embeddedprojects/gnublin-schematics/README.md

gnublin-schematics
==================

GNUBLIN Schematic and Board Files
