embeddedprojects/gnublin-schematics/Board-RAIL/700926_GNUBLIN_DINRAIL_DATENBLATT.pdf

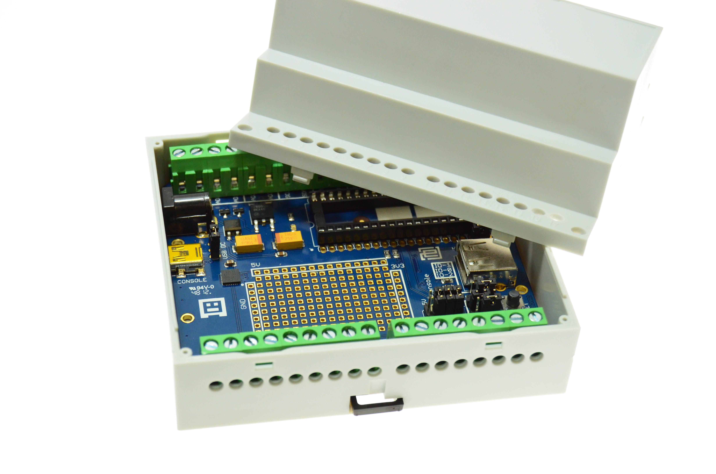
[picture p9: figure]

Software
- keine

## GNUBLIN – DIN RAIL (Hutschienensystem)

Eigenschaften

- Basis für GNUBLIN-DIP
- Hutschienenmontage möglich
- sämtliche Leitungen vom GNUBLIN-DIP herausgeführt
- Optional Stromversorgung per Steckernetzteil (Integrierter 5V Regler)

Technische Details
- 15 x GPIO, 4 x ADW, RESET, UART, PWM, SPI, I2C, 5V, 3V3, GND auf Schraubklemmen
- 1 x LED
- 1 x Power-LED
- Externe 7-12V Stromversorgung über Hohlbuchse möglich
- USB-OTG (Host oder Device)
1/2 | Version: 100 Stand: | 25.07.12

Holzbachstraße 4, D-86152 Augsburg Tel +49 (0) 821 279599-0
Fax +49 (0) 821 279599-20
shop.embedded-projects.net

# embedded projects GmbH

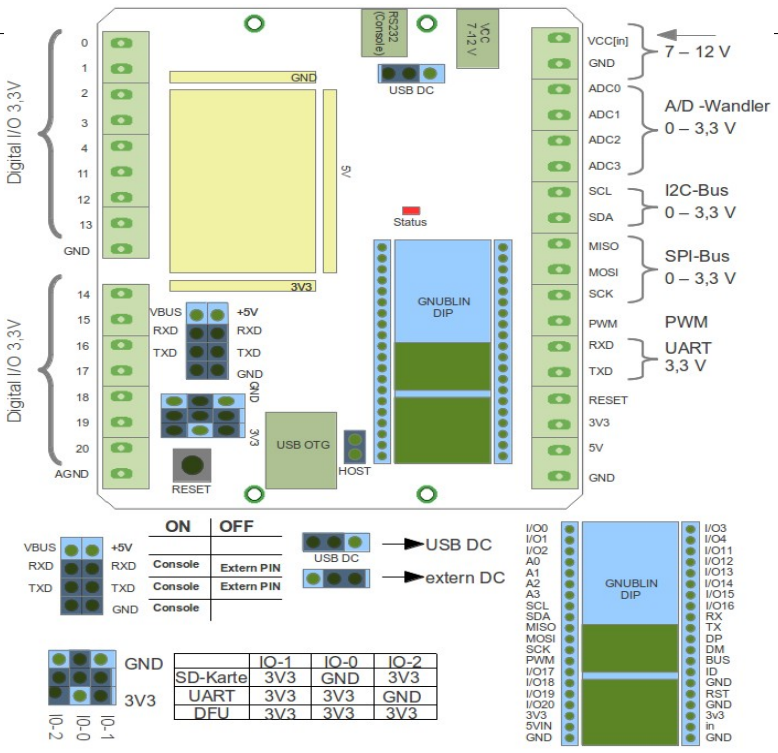
[picture p10: figure]

2/2 | Version: 100 Stand: | 25.07.12

Holzbachstraße 4, D-86152 Augsburg Tel +49 (0) 821 279599-0
Fax +49 (0) 821 279599-20
shop.embedded-projects.net

Abbildung 1: Übersicht Unterbauboard

Mechanische Daten
- Abmessung Platine 84.00 x 98,50 mm
- Gewicht ca. 50 g
Lieferumfang Artikel Nr. 700xx
- Platine vormontiert und getestet
- Alle Anschlussklemmen
- 1 x Mini-USB-Kabel
Optional Zubehör
- Hutschienengehäuse 6-C und Zubehör wie bei Artikel Nr. 700505

Anfrage / Kontakt
embedded projects GmbH
Holzbachstraße 4
86152 Augsburg

Tel: 0821 / 27 95 99-0
Fax: 0821 / 27 95 99-20
E-Mail: info@embedded-projects.net Internet: http://www.embedded-projects.net

Irrtümer, Verfügbarkeit des beschriebenen Artikels und technische Änderungen/Anpassungen vorbehalten.
