embeddedprojects/gnublin-schematics/Module-Bridge/MODUL_BRIDGE_V100.pdf

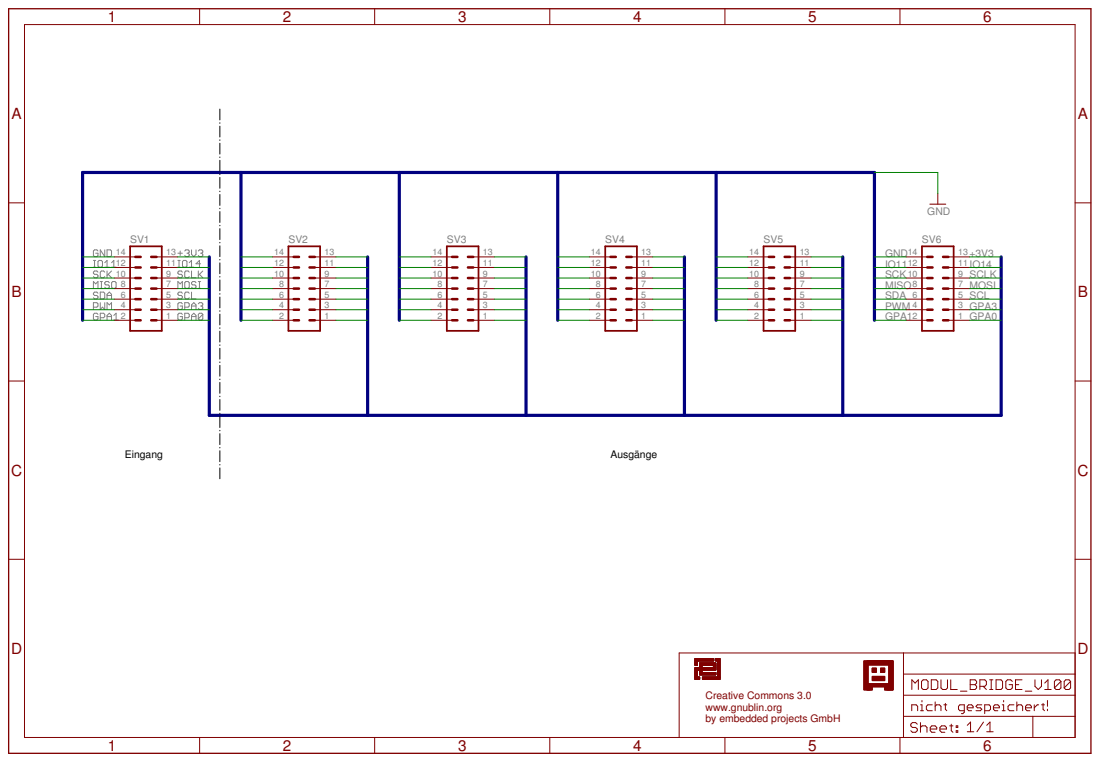
[picture p20: page 1]

IO11 12 | 11
SCK | 9 SCLK

10 MISO 8 | GPA0 7 MOSI

SDA 6 | 5 SCL
PWM 4 | 3 GPA3
GPA1 2 | 1

Creative Commons 3.0 www.gnublin.org
by embedded projects GmbH
