embeddedprojects/gnublin-schematics/Module-Relay/MODUL_RELAIS_8_V101.pdf

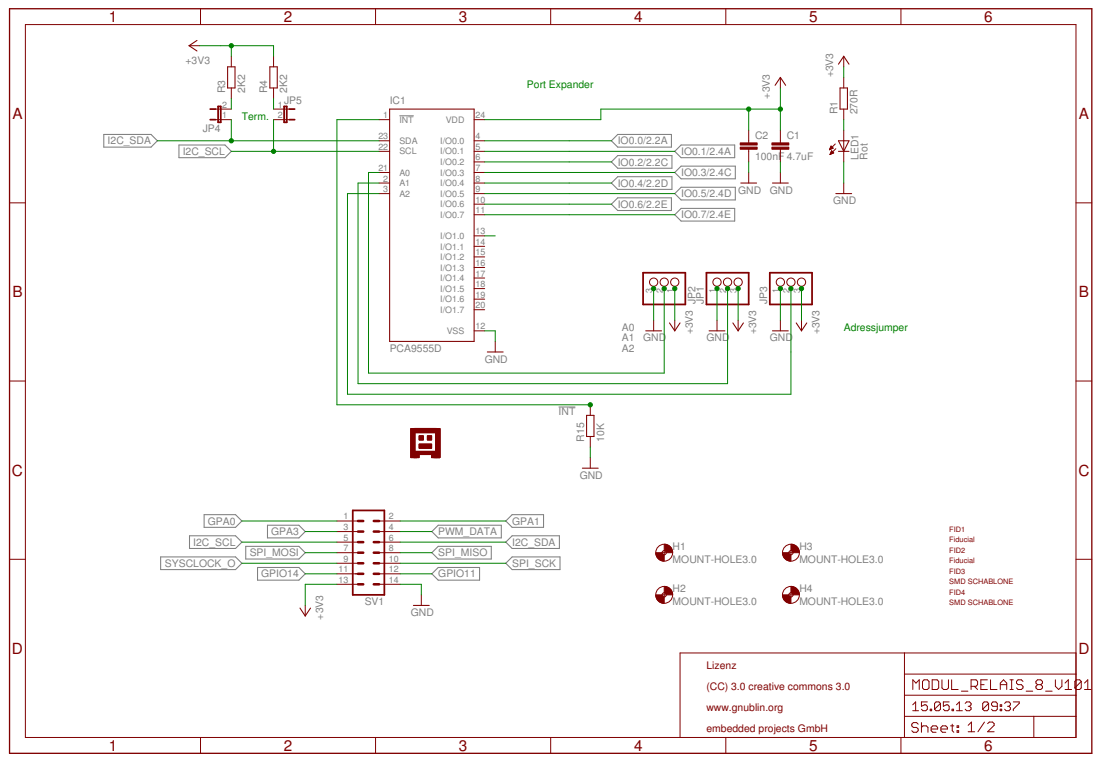
[picture p21: page 1]

Fiducial FID1 Fiducial FID2 SMD SCHABLONE

Lizenz www.gnublin.org
(CC) 3.0 creative commons 3.0

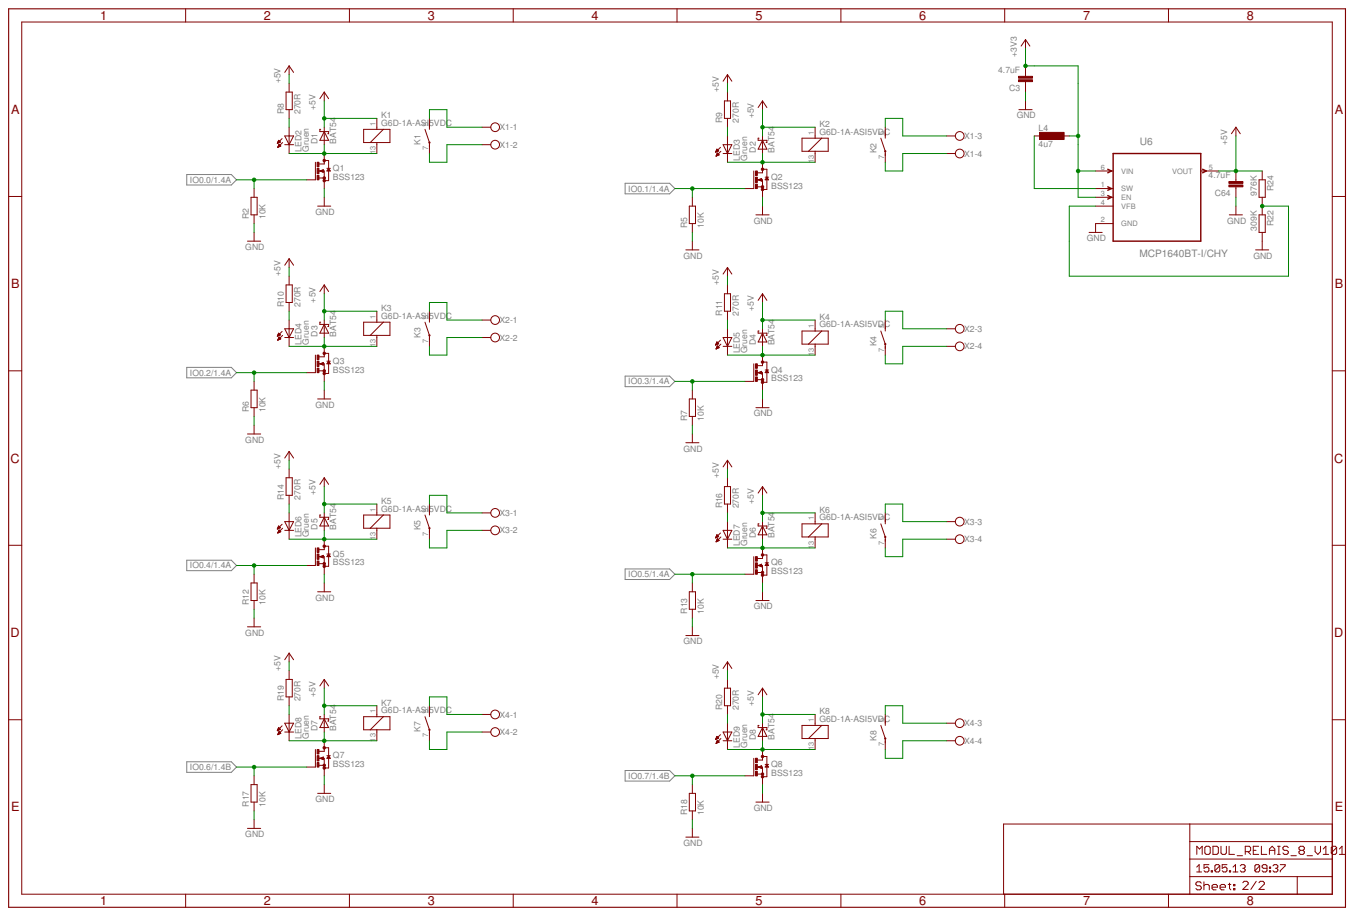
[picture p22: page 2]

BAT54 BSS123 BAT54 BSS123 G6D-1A-ASI5VDC G6D-1A-ASI5VDC 10K 10K Gruen Gruen 270R 270R GND GND GND GND BAT54 BSS123 BAT54 BSS123 G6D-1A-ASI5VDC G6D-1A-ASI5VDC 10K 10K Gruen Gruen 270R 270R GND GND GND GND BAT54 BSS123 BAT54 BSS123 G6D-1A-ASI5VDC G6D-1A-ASI5VDC 10K 10K Gruen Gruen 270R 270R GND GND GND GND BAT54 BSS123 BAT54 BSS123 G6D-1A-ASI5VDC G6D-1A-ASI5VDC 10K 10K Gruen Gruen 270R 270R GND GND GND GND MCP1640BT-I/CHY 4u7 976K 309K GND GND 4.7uFGND GND +3V3 +5V +5V +5V +5V +5V +5V +5V +5V +5V +5V +5V +5V +5V +5V +5V +5V +5V 4.7uF D2 Q2 D1 Q1 K1 1 13K1 7 5K2 1 13K2 7 5 R2 R5 LED2 LED3 R8 R9 X1-1 X1-2 X1-3 X1-4 D4 Q4 D3 Q3 K3 1 13K3 7 5K4 1 13K4 7 5 R6 R7 LED4 LED5 R10 R11 X2-1 X2-2 X2-3 X2-4 D6 Q6 D5 Q5 K5 1 13K5 7 5K6 1 13K6 7 5 R12 R13 LED6 LED7 R14 R16 X3-1 X3-2 X3-3 X3-4 D8 Q8 D7 Q7 K7 1 13K7 7 5K8 1 13K8 7 5 R17 R18 LED8 LED9 R19 R20 X4-1 X4-2 X4-3 X4-4 U6 VIN 6 SW 1 EN 3 VFB 4 GND 2 VOUT 5 L4 R24 R22 C64 C3 IO0.6/1.4B IO0.7/1.4B IO0.0/1.4A IO0.1/1.4A IO0.2/1.4A IO0.3/1.4A IO0.4/1.4A IO0.5/1.4A ABCDE 1 2 3 4 5 6 7 8 ABCDE 1 2 3 4 5 6 7 8
