embeddedprojects/gnublin-schematics/Module_RAIL_INPUT_24V/MODUL_RAIL_IN_V100.pdf

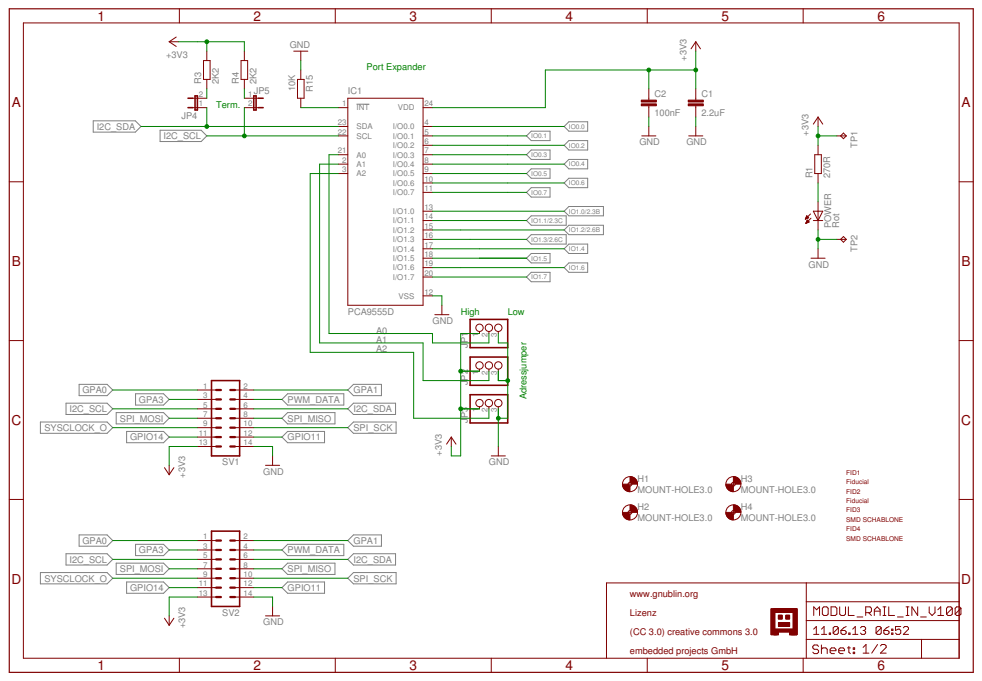
[picture p23: page 1]

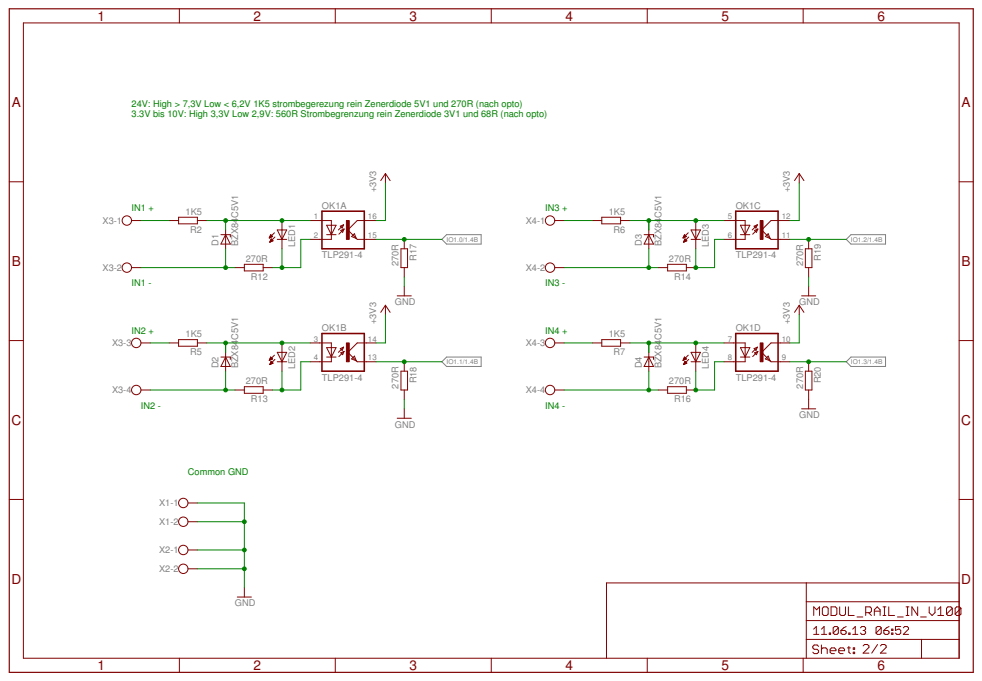
[picture p24: page 2]

24V: High > 7,3V Low < 6,2V 1K5 strombegerezung rein Zenerdiode 5V1 und 270R (nach opto)
3.3V bis 10V: High 3,3V Low 2,9V: 560R Strombegrenzung rein Zenerdiode 3V1 und 68R (nach opto)
