embeddedprojects/gnublin-schematics/Module-Display_2x16/700899_GNUBLIN_DISPLAY_SCHEMATIC_V100.pdf

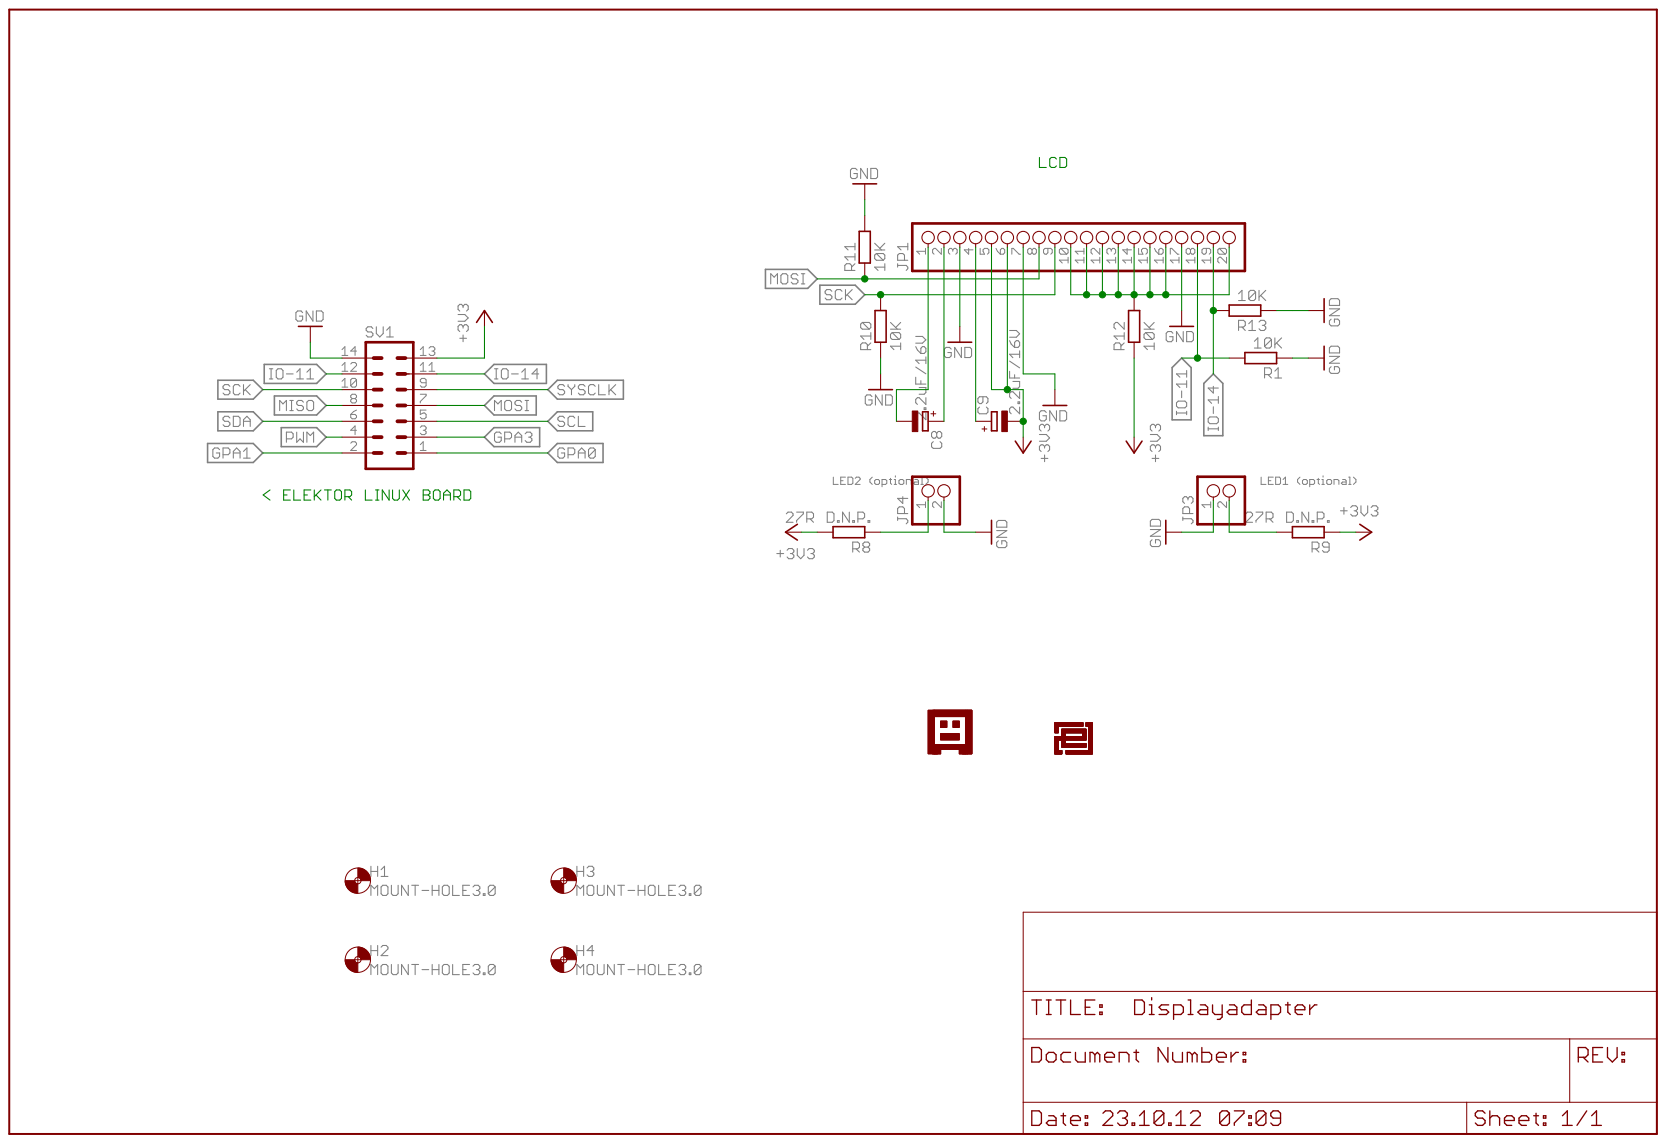
[picture p25: page 1]
