embeddedprojects/gnublin-schematics/Module-Step/MODUL_STEP_V100.pdf

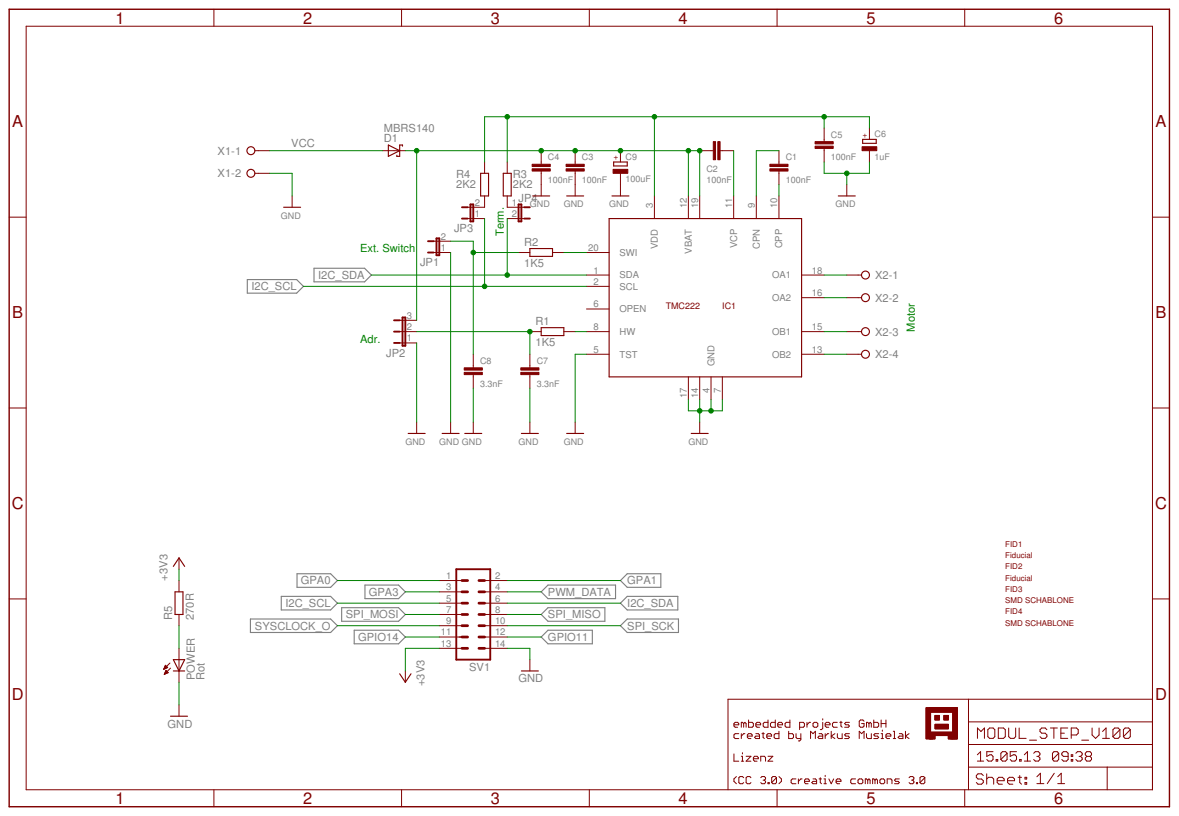
[picture p26: page 1]

Fiducial FID1 Fiducial FID2 SMD SCHABLONE
