embeddedprojects/gnublin-schematics/Board-Easy-DIP/GNUBLIN-DIP-EASY_V100.pdf

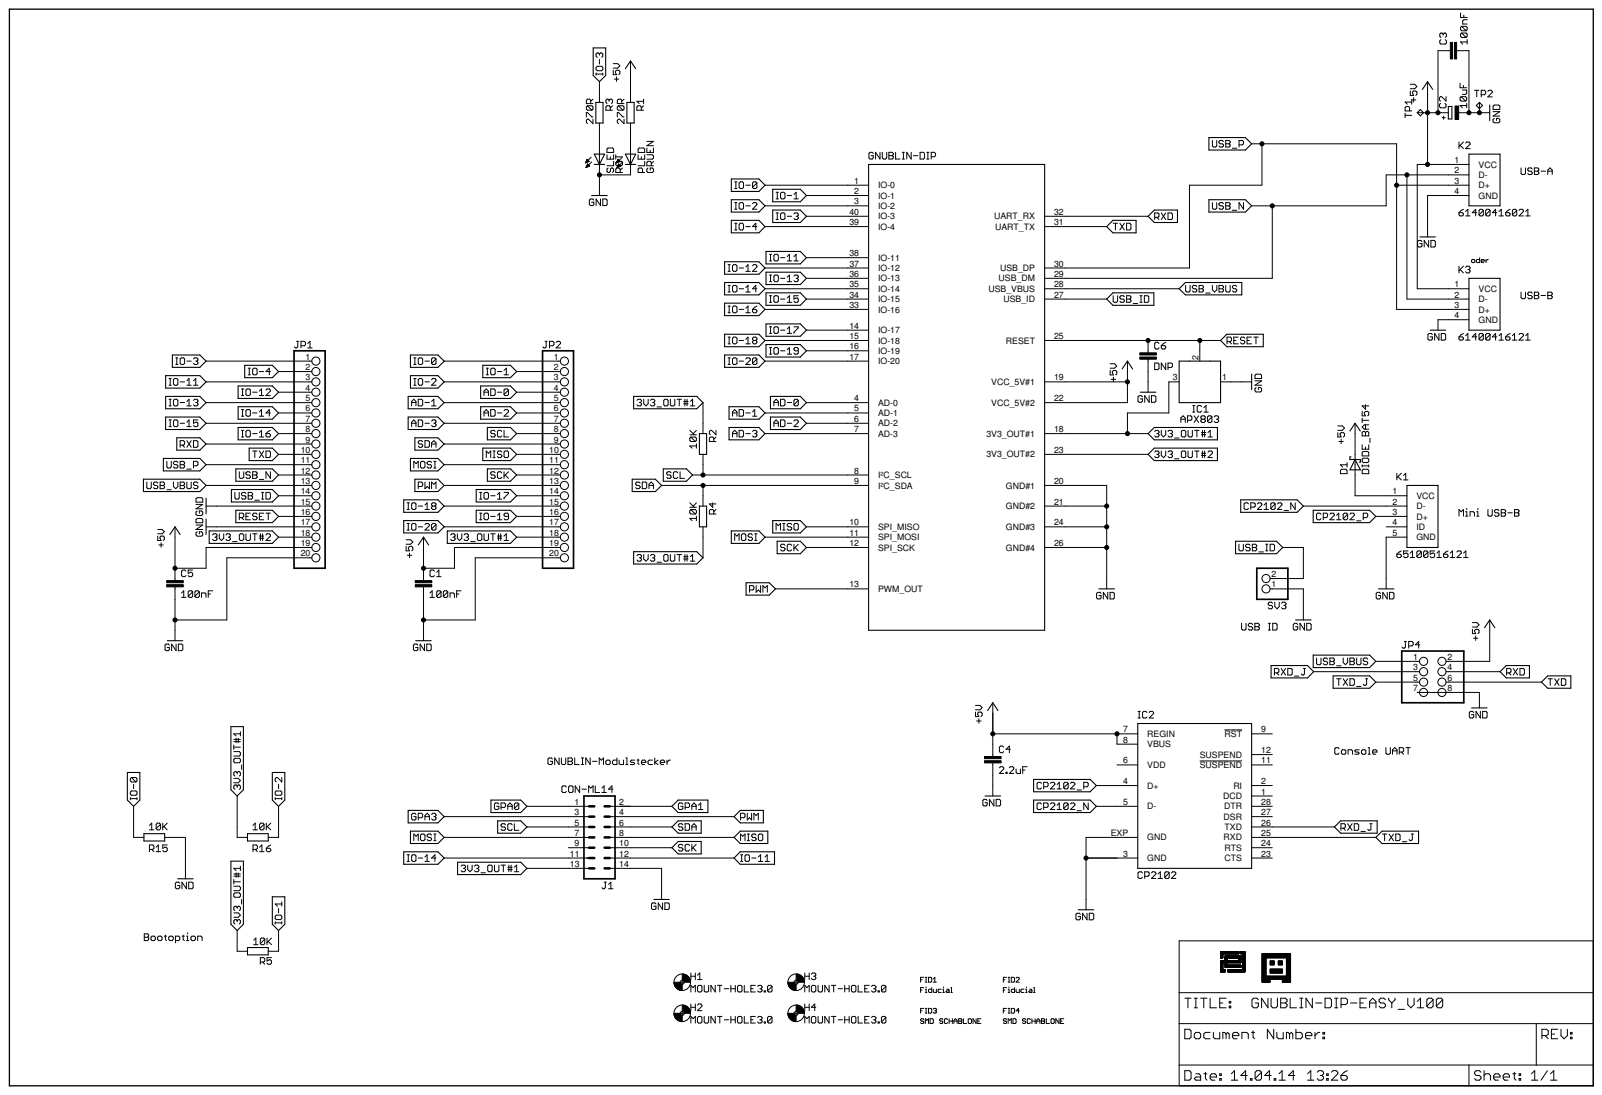
[picture p27: page 1]
