embeddedprojects/gnublin-schematics/DIN-Rail-In/DIN-Rail-In_V103.pdf

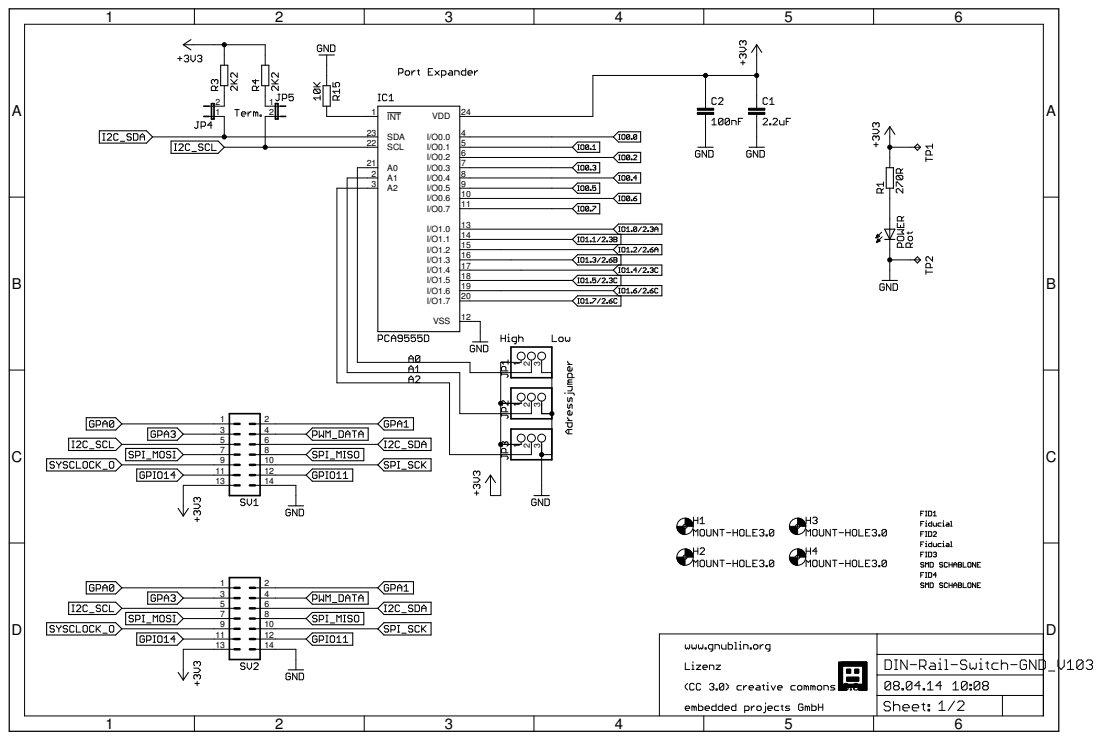
[picture p28: page 1]

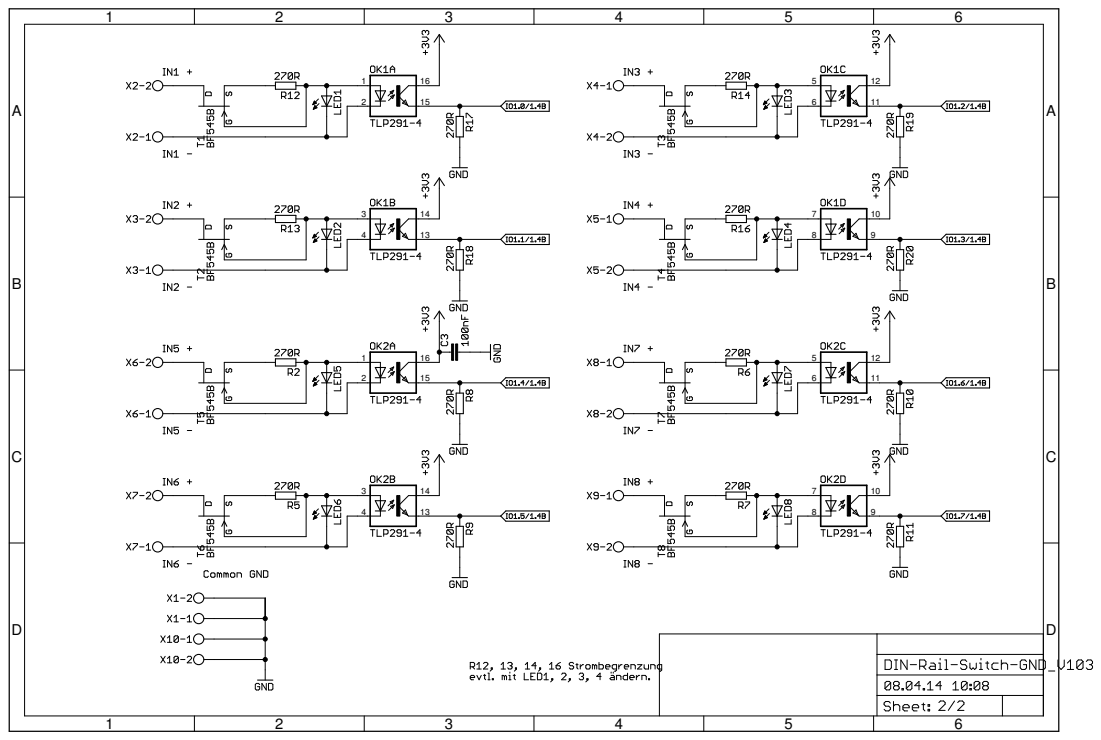
[picture p29: page 2]
