embeddedprojects/gnublin-schematics/Board-DEFAULT/700641_GNUBLIN_ABMESSUNGEN.pdf

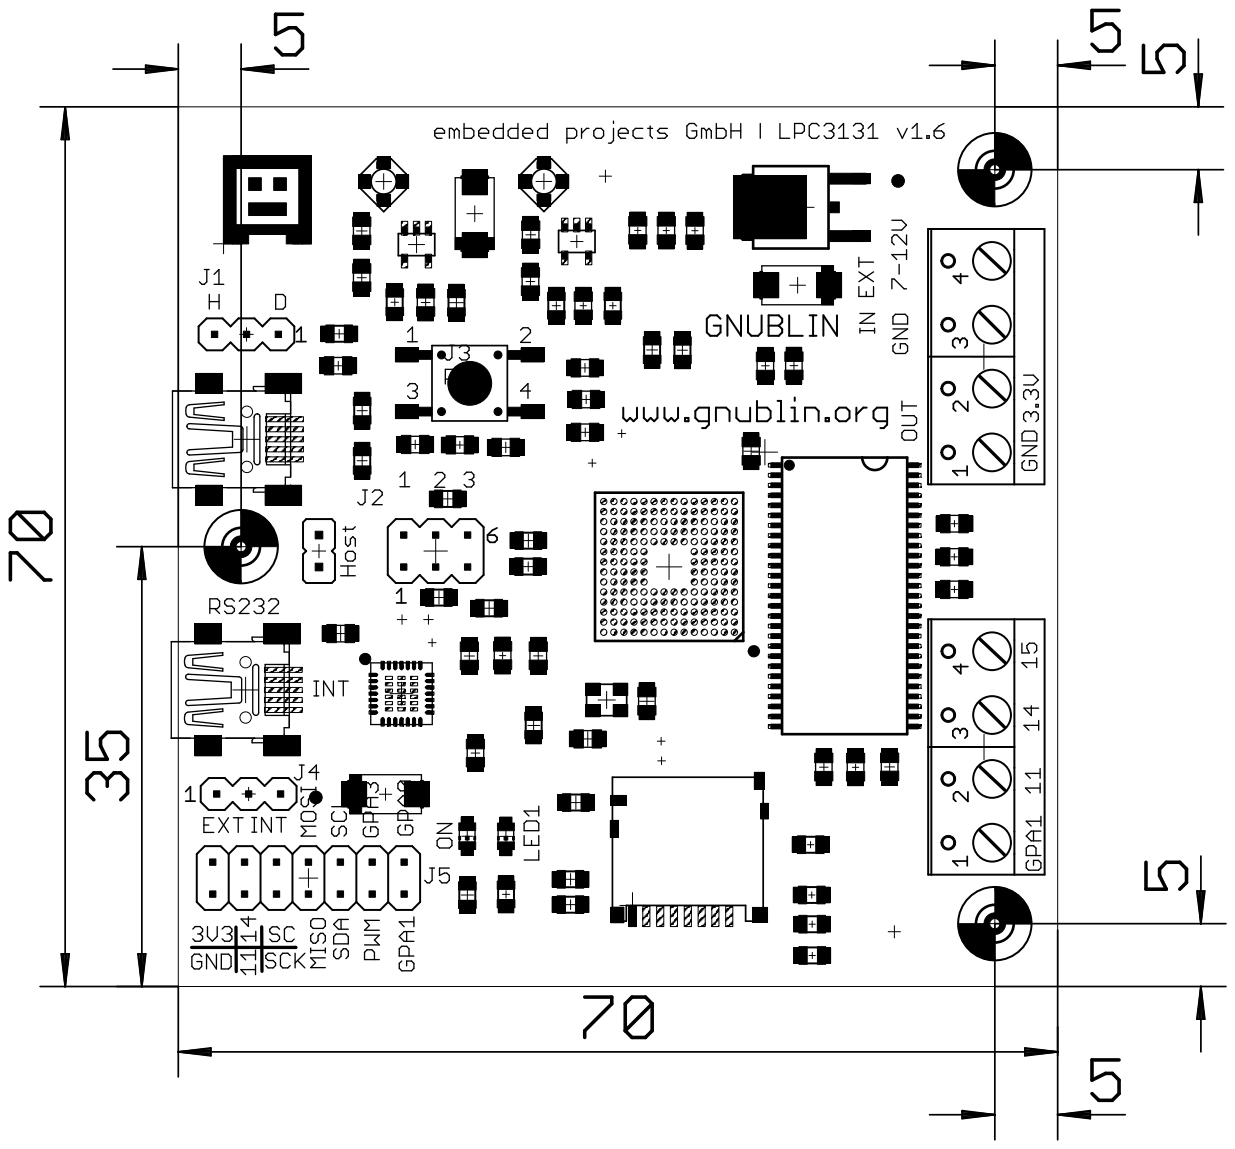
[picture p30: page 1]
