embeddedprojects/gnublin-schematics/Board-DEFAULT/700641_GNUBLIN_SCHALTPLAN.pdf

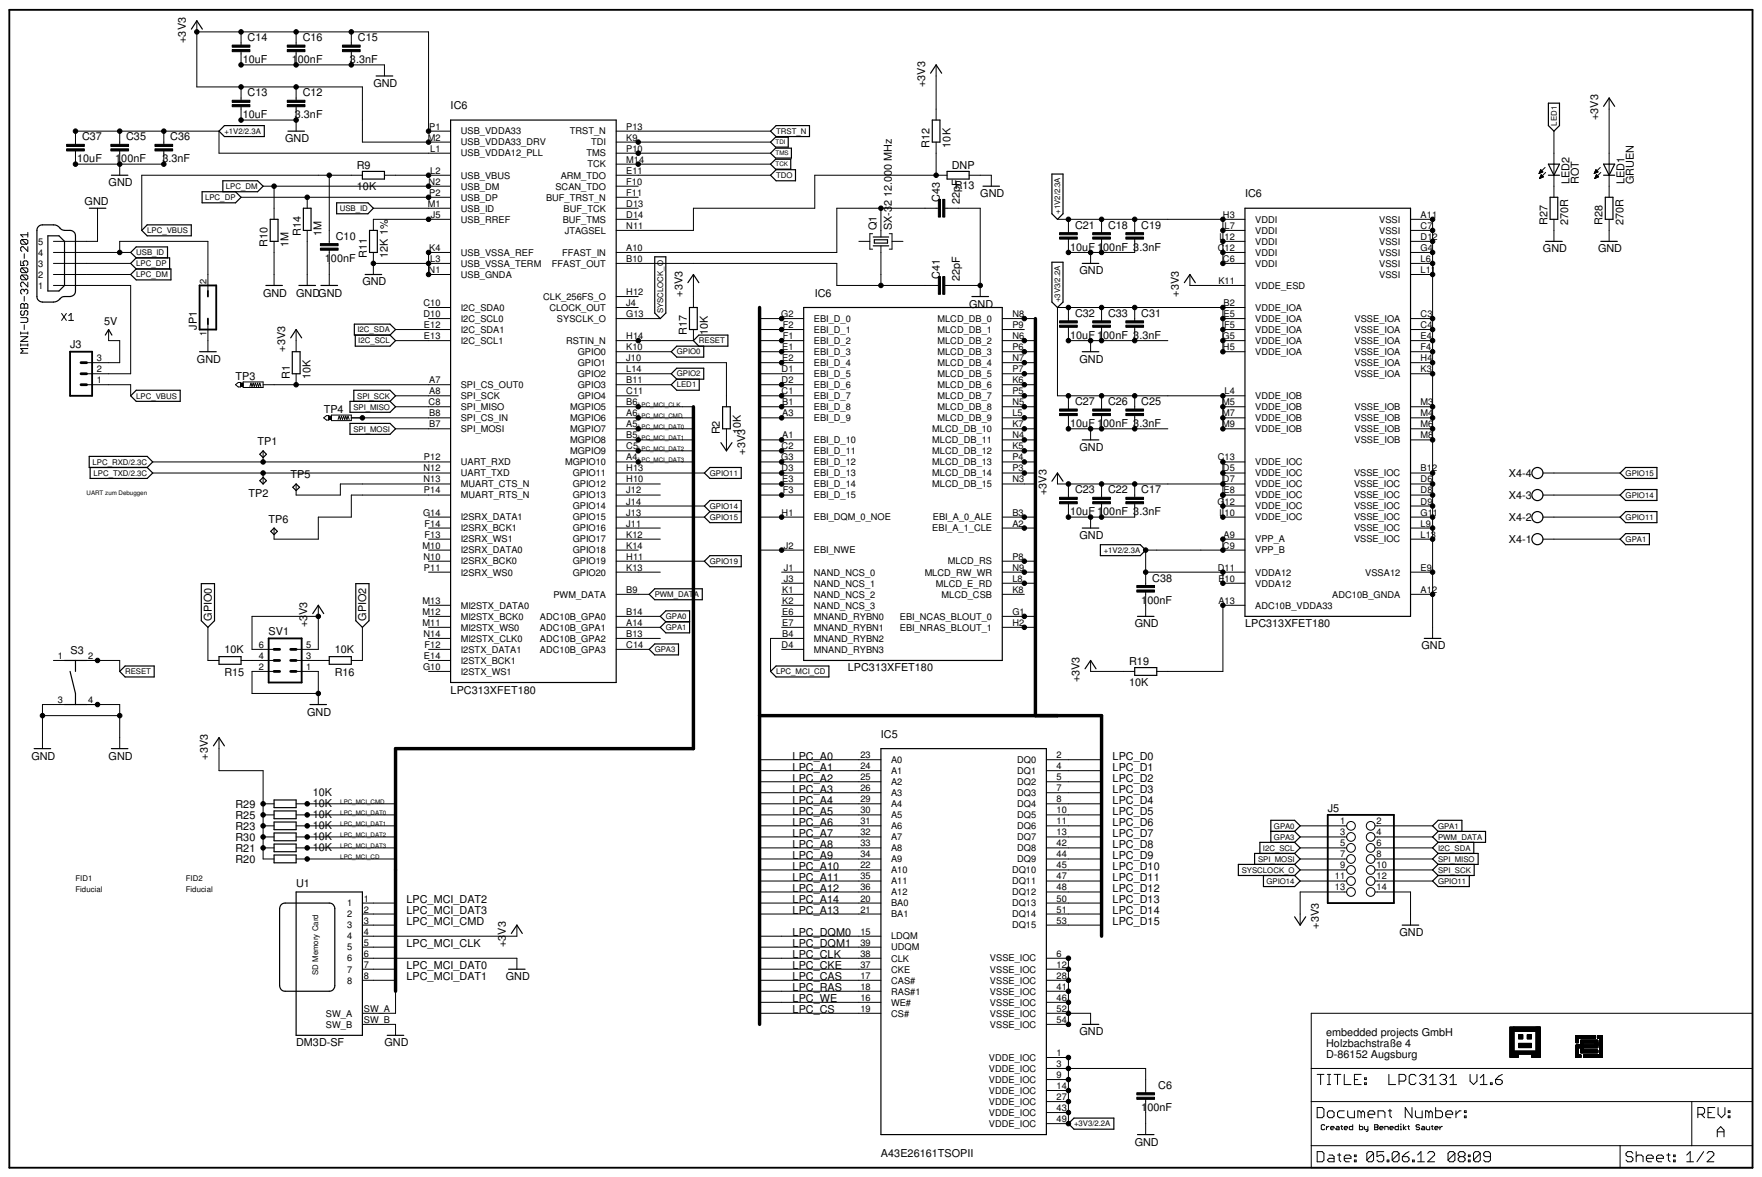
[picture p31: page 1]

SPI_MISO | L14 GPIO3 B11 GPIO4 C11 GPIO11 H13 GPIO12 H10 GPIO13 LPC_MCI_CMD

I2STX_DATA1 F12 | GPA3

SW_A | LPC_RAS | 41 VSSE_IOC

LPC_WE 16 | 46 VSSE_IOC
LPC_CS 19 | 52 VSSE_IOC

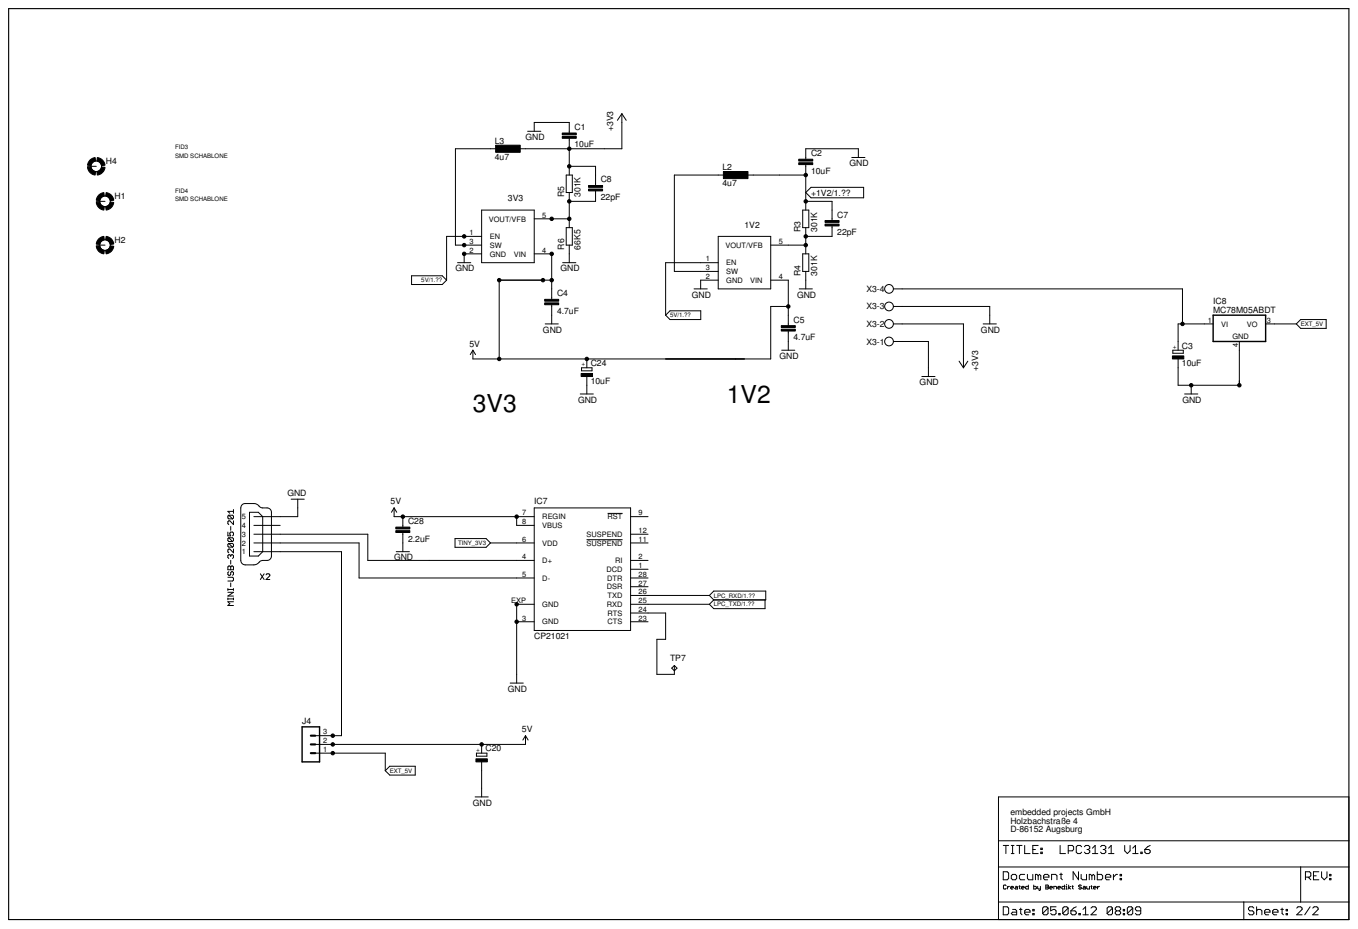
[picture p32: page 2]
