embeddedprojects/gnublin-schematics/Board-DIP/700725_GNUBLIN_DIP_Schaltplan.pdf

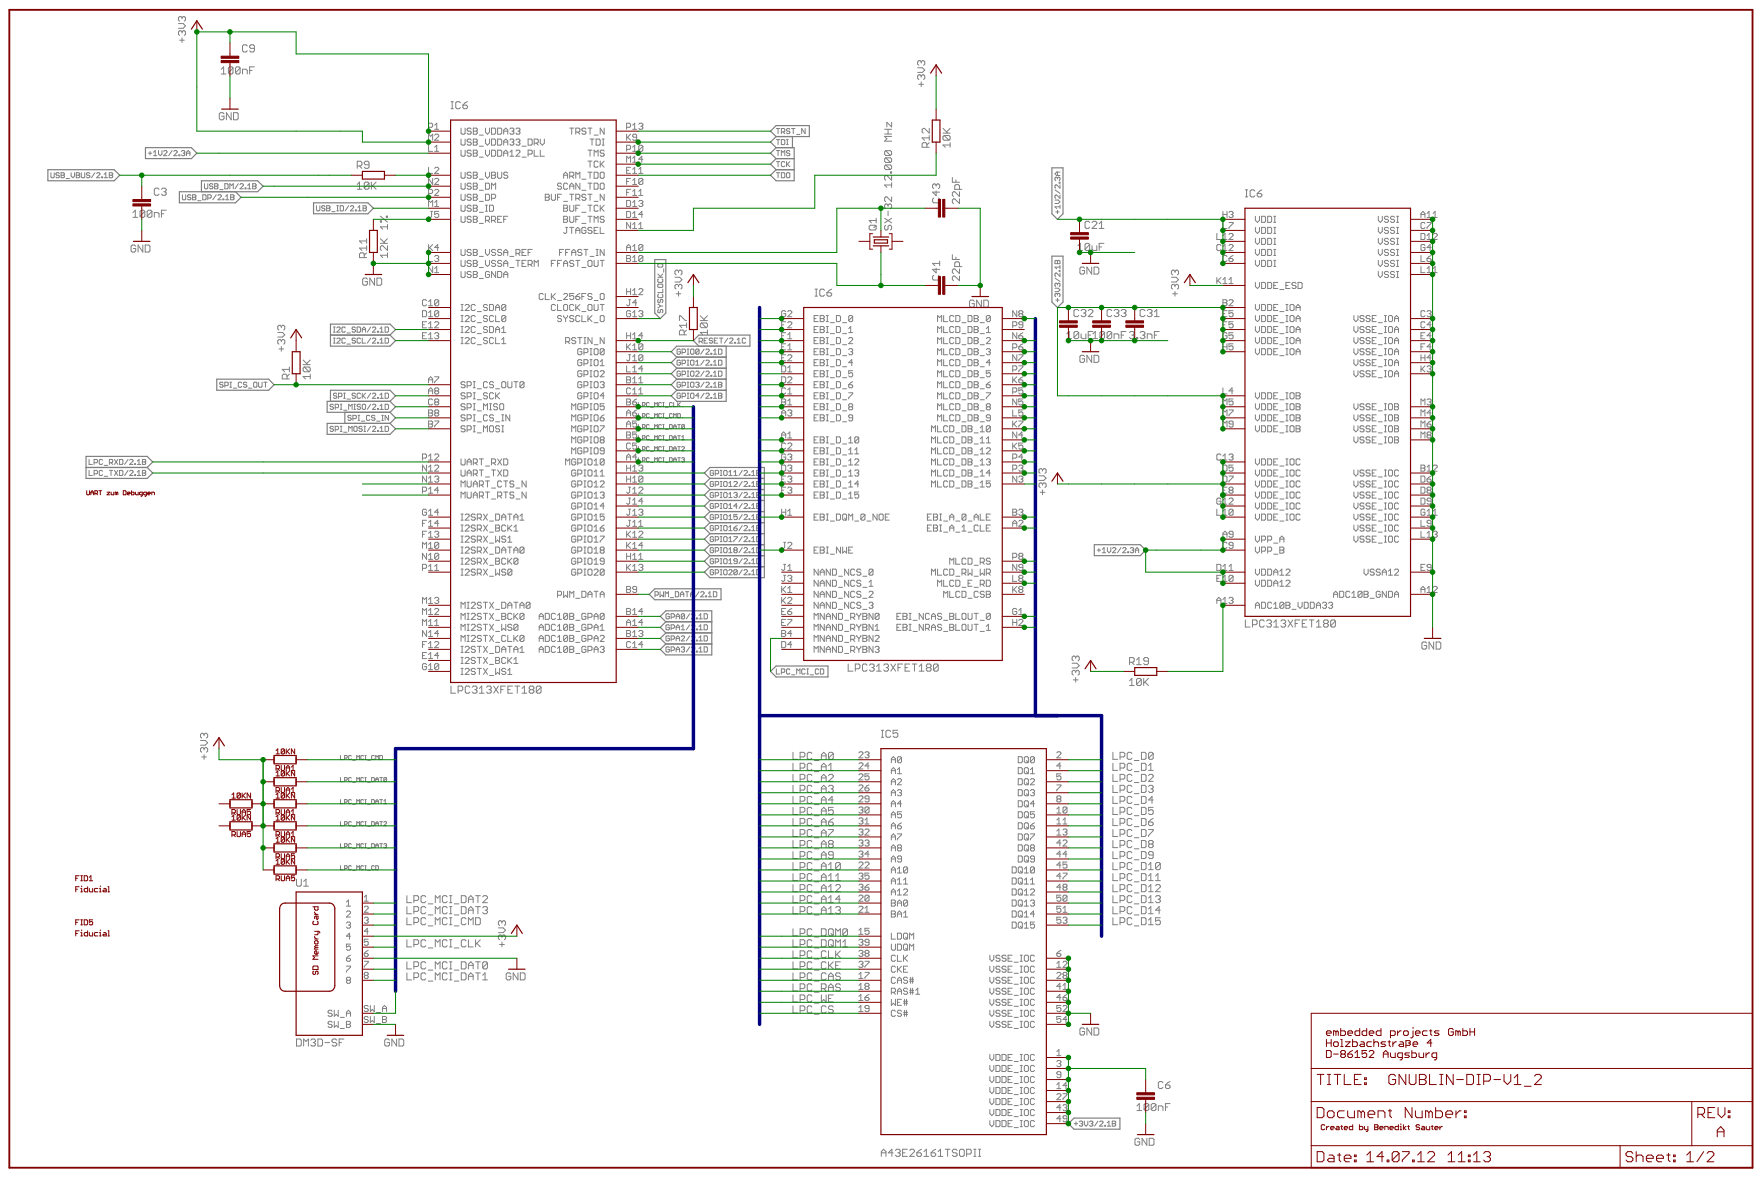
[picture p35: page 1]

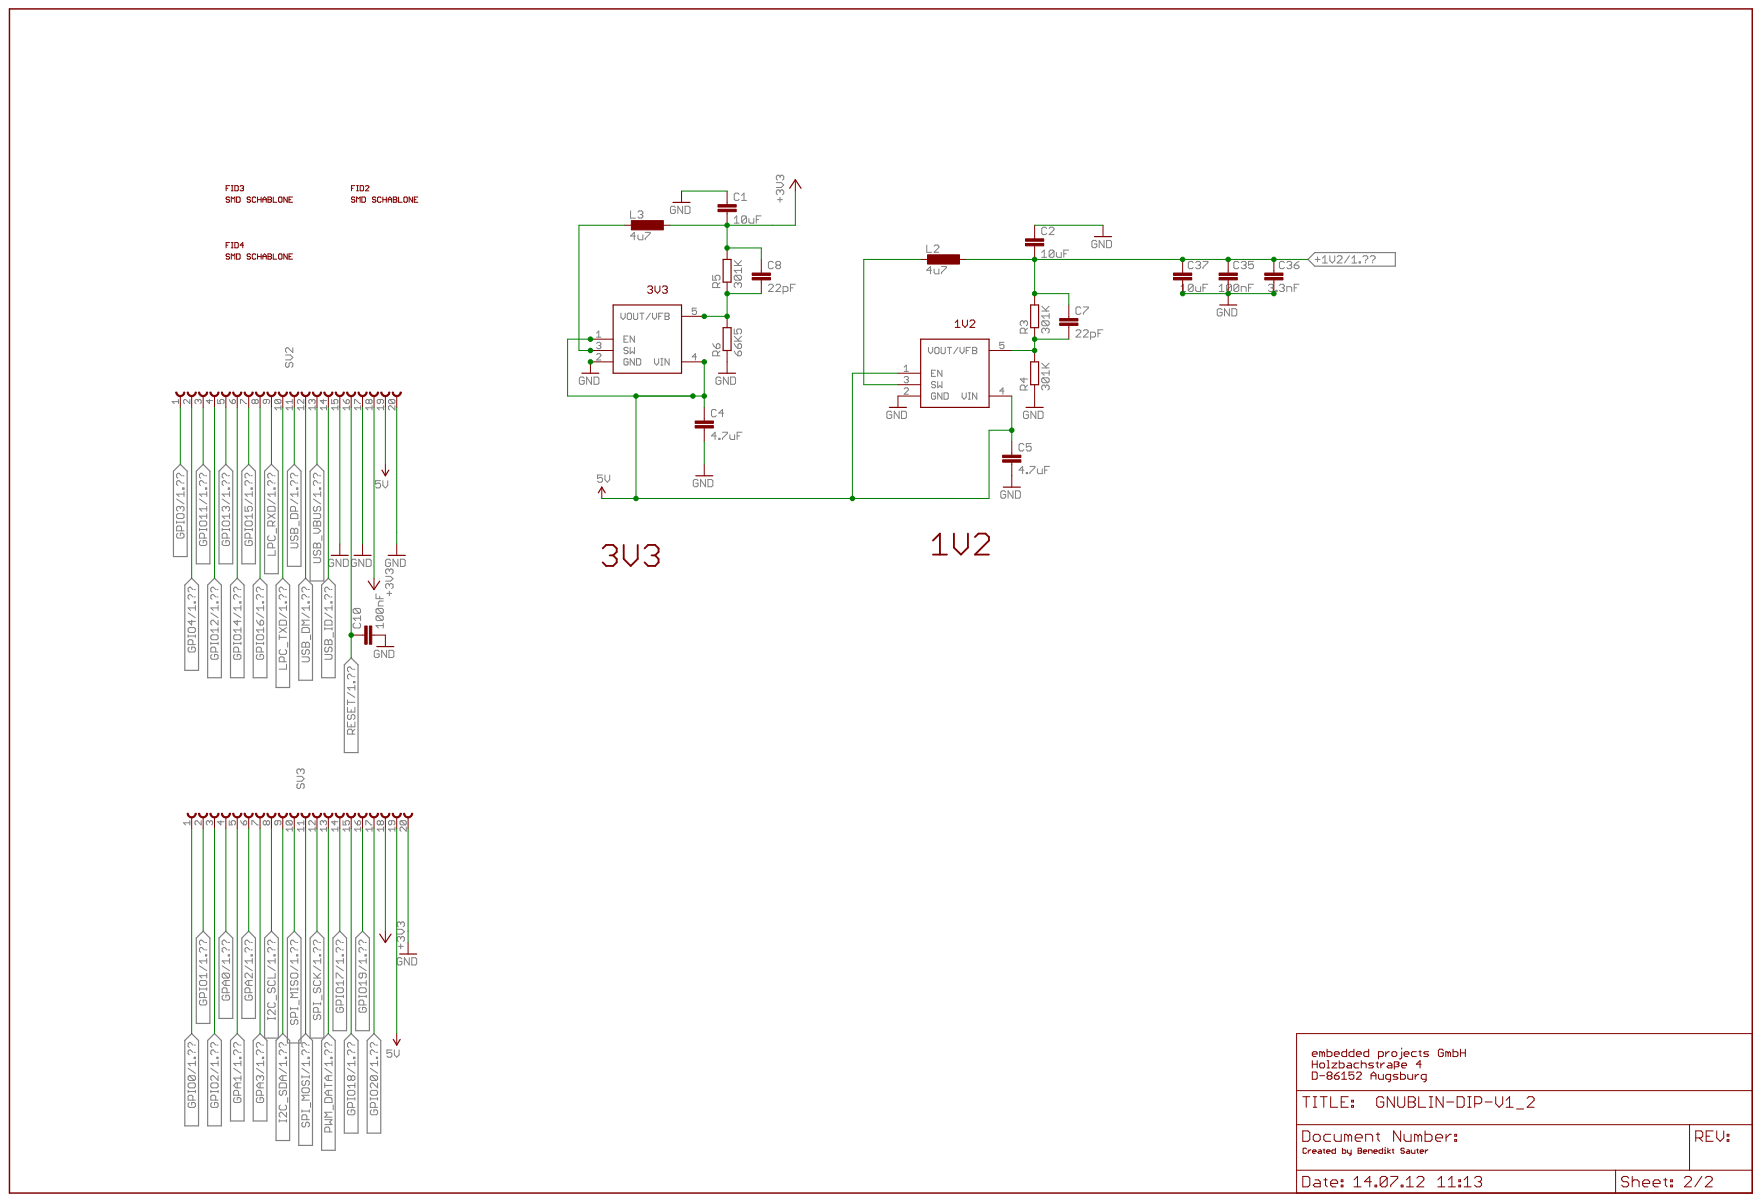
[picture p36: page 2]
