embeddedprojects/gnublin-schematics/Board-Elektor/ElektorLinuxBoard_V3.01.pdf

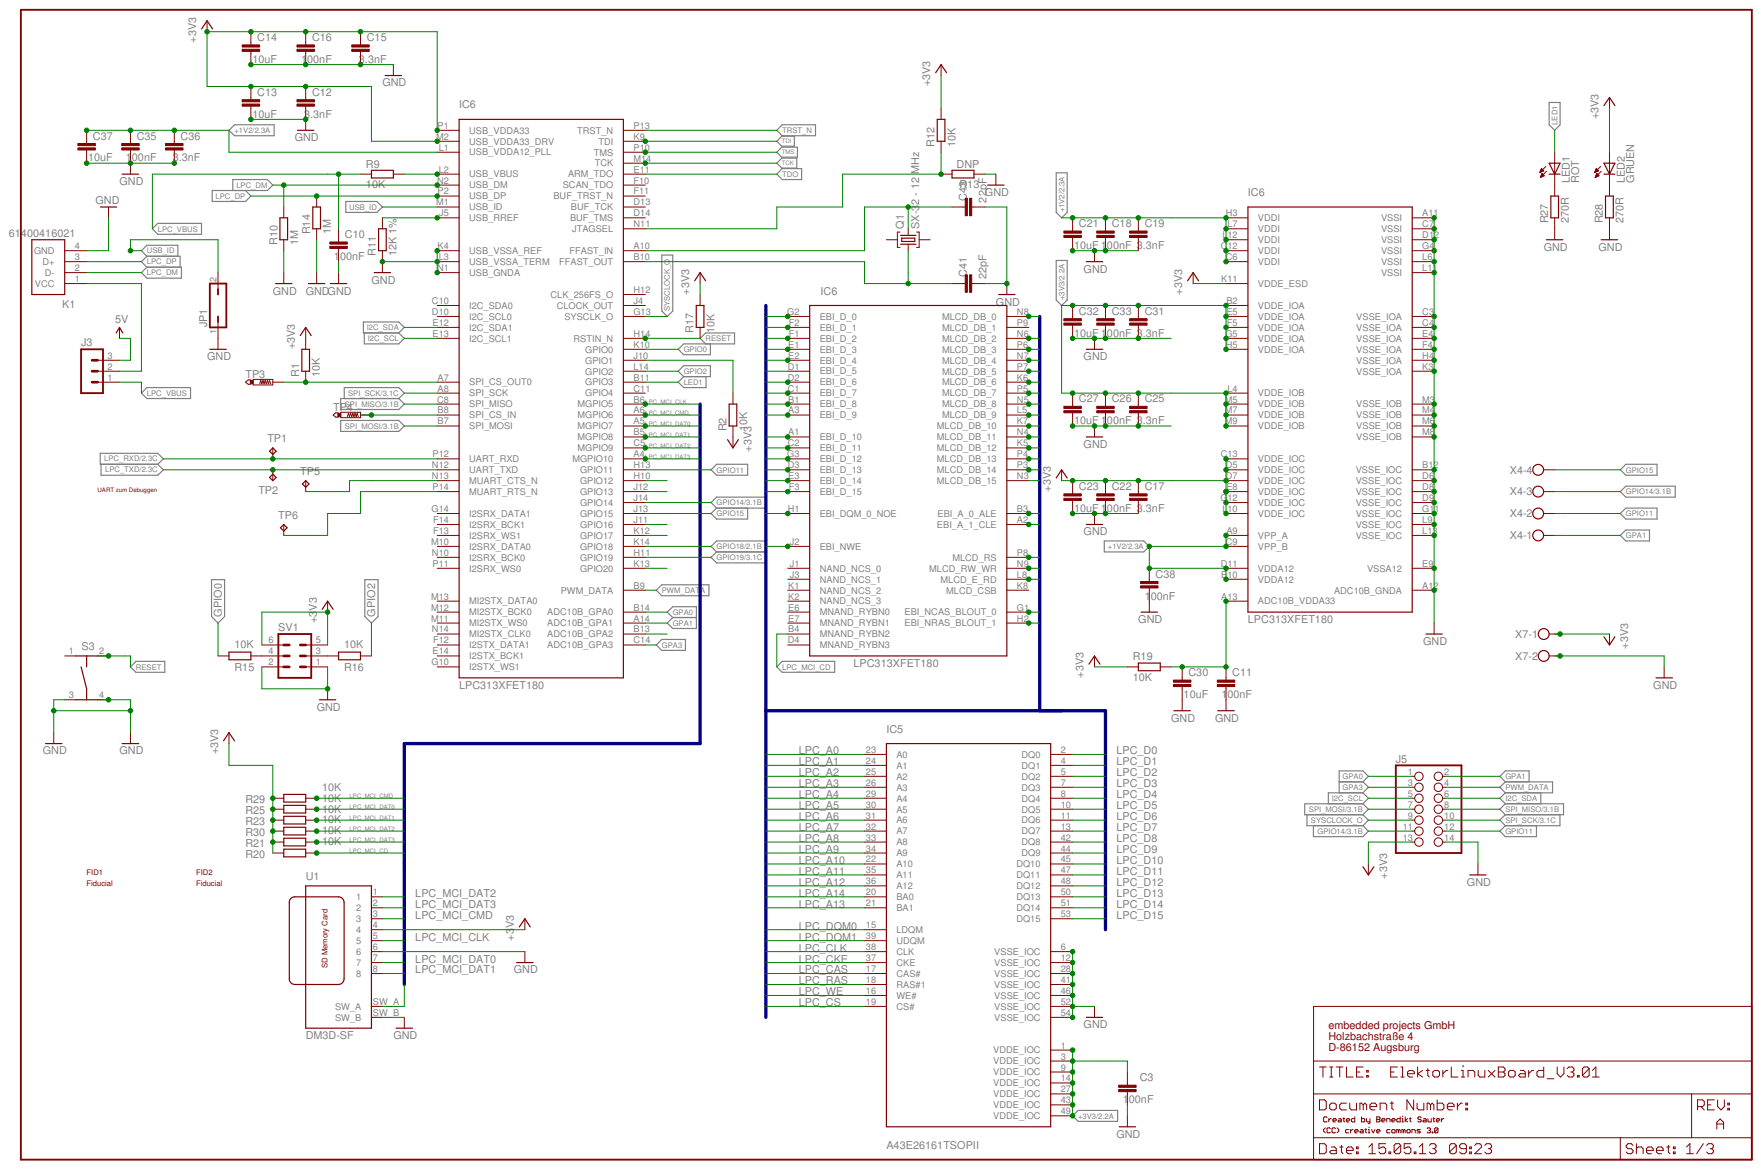
[picture p37: page 1]

I2STX_DATA1 F12 | GPA3

SW_A | LPC_RAS | 41 VSSE_IOC

LPC_WE 16 | 46 VSSE_IOC
LPC_CS 19 | 52 VSSE_IOC

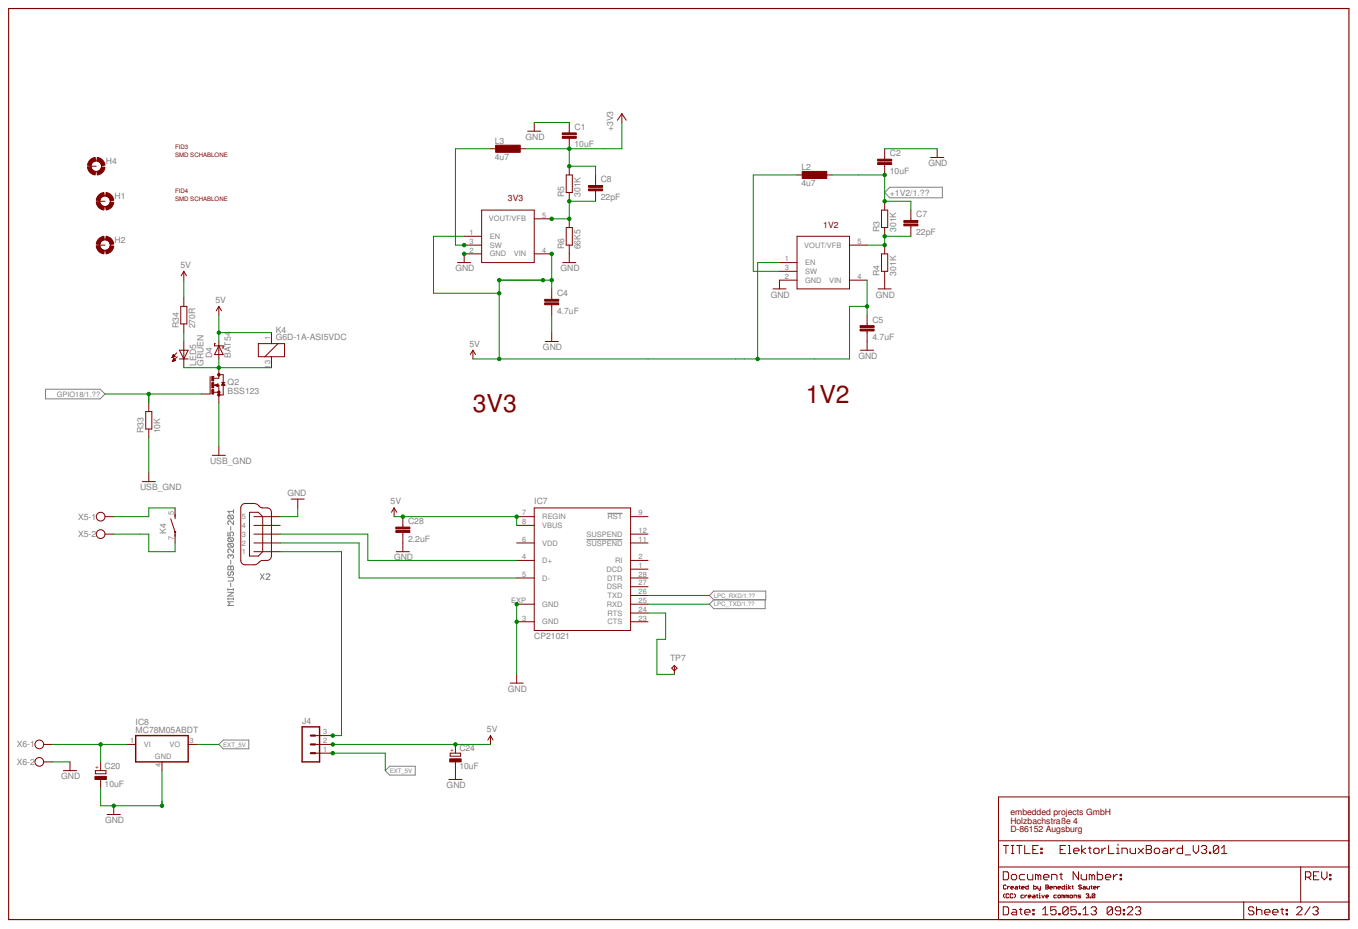
[picture p38: page 2]

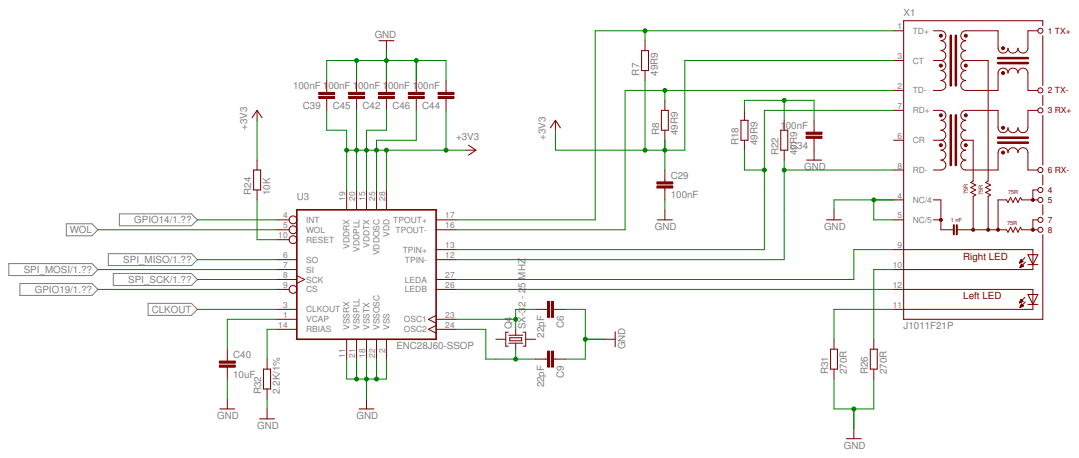
[picture p39: page 3]
