embeddedprojects/gnublin-schematics/Board-LAN/GNUBLIN_LAN_V2.3.pdf

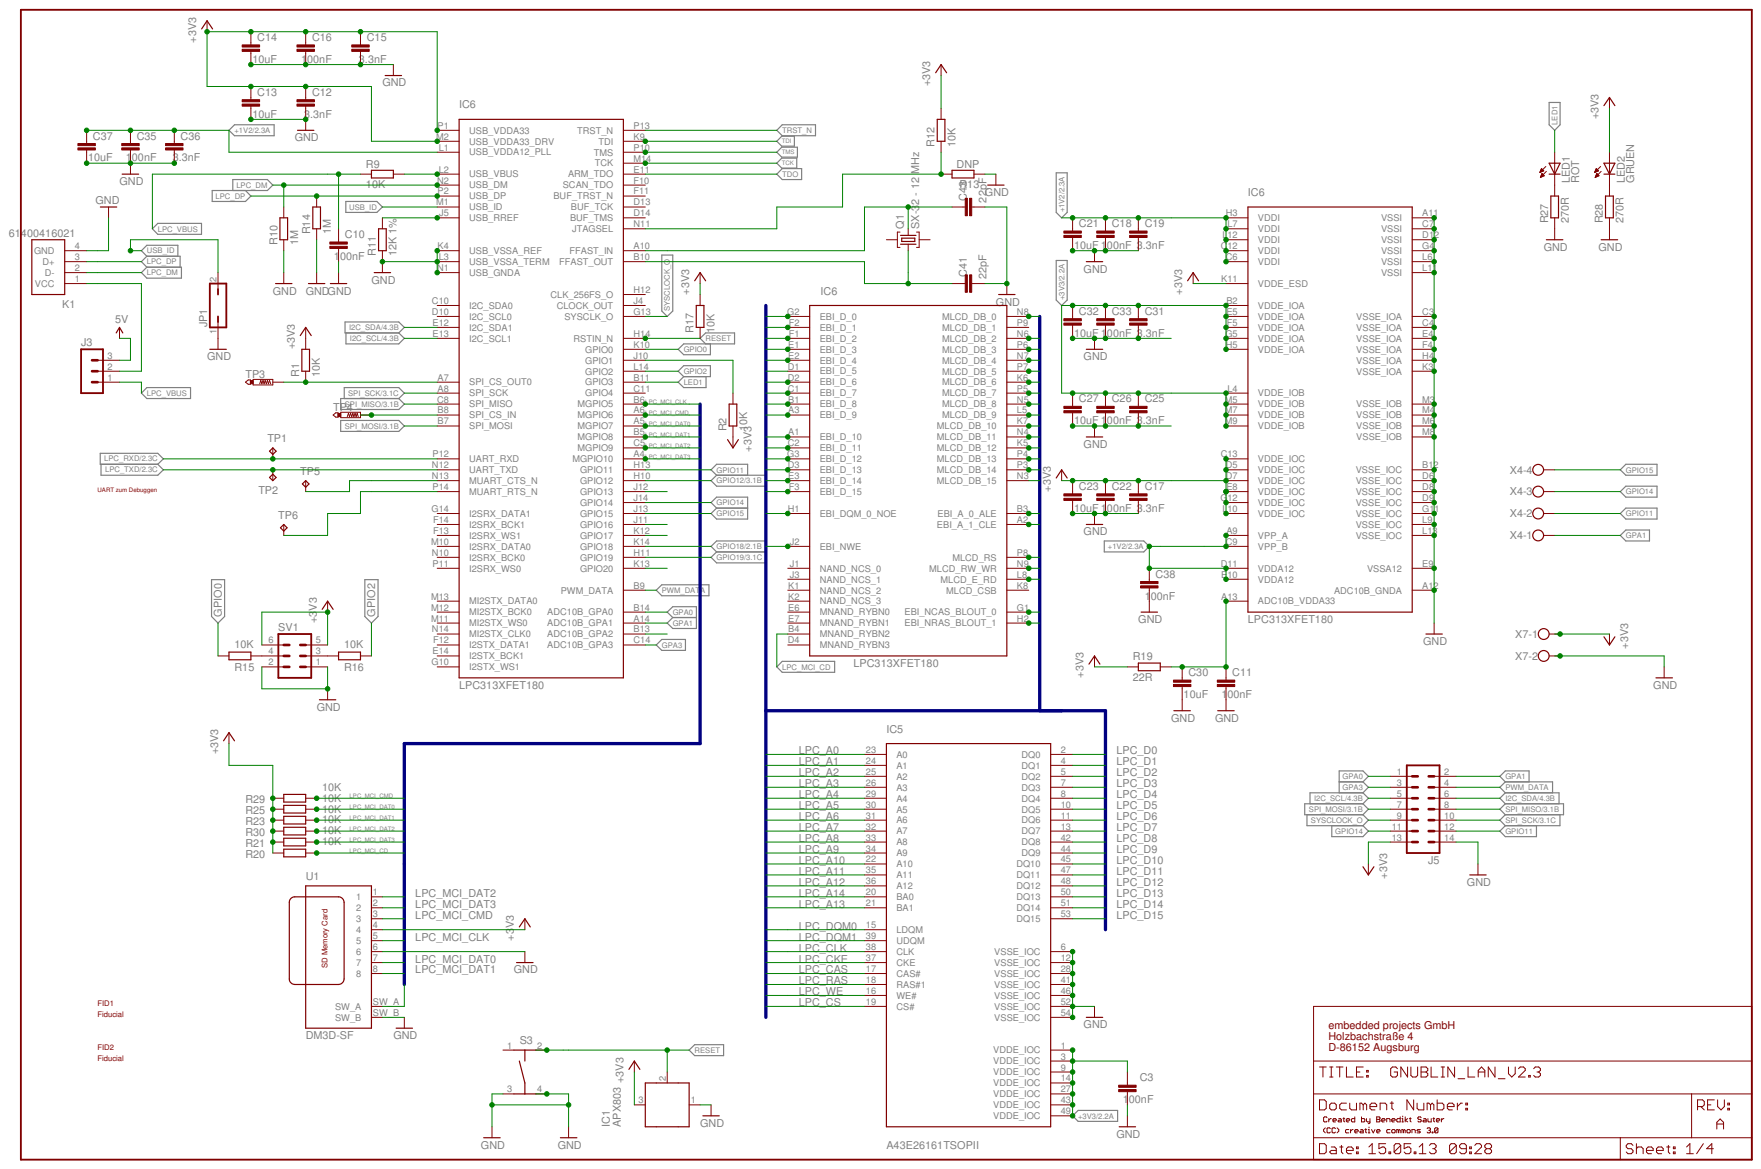
[picture p40: page 1]

I2STX_DATA1 F12 | GPA3

SW_A | LPC_RAS | 41 VSSE_IOC

LPC_WE 16 | 46 VSSE_IOC
LPC_CS 19 | 52 VSSE_IOC

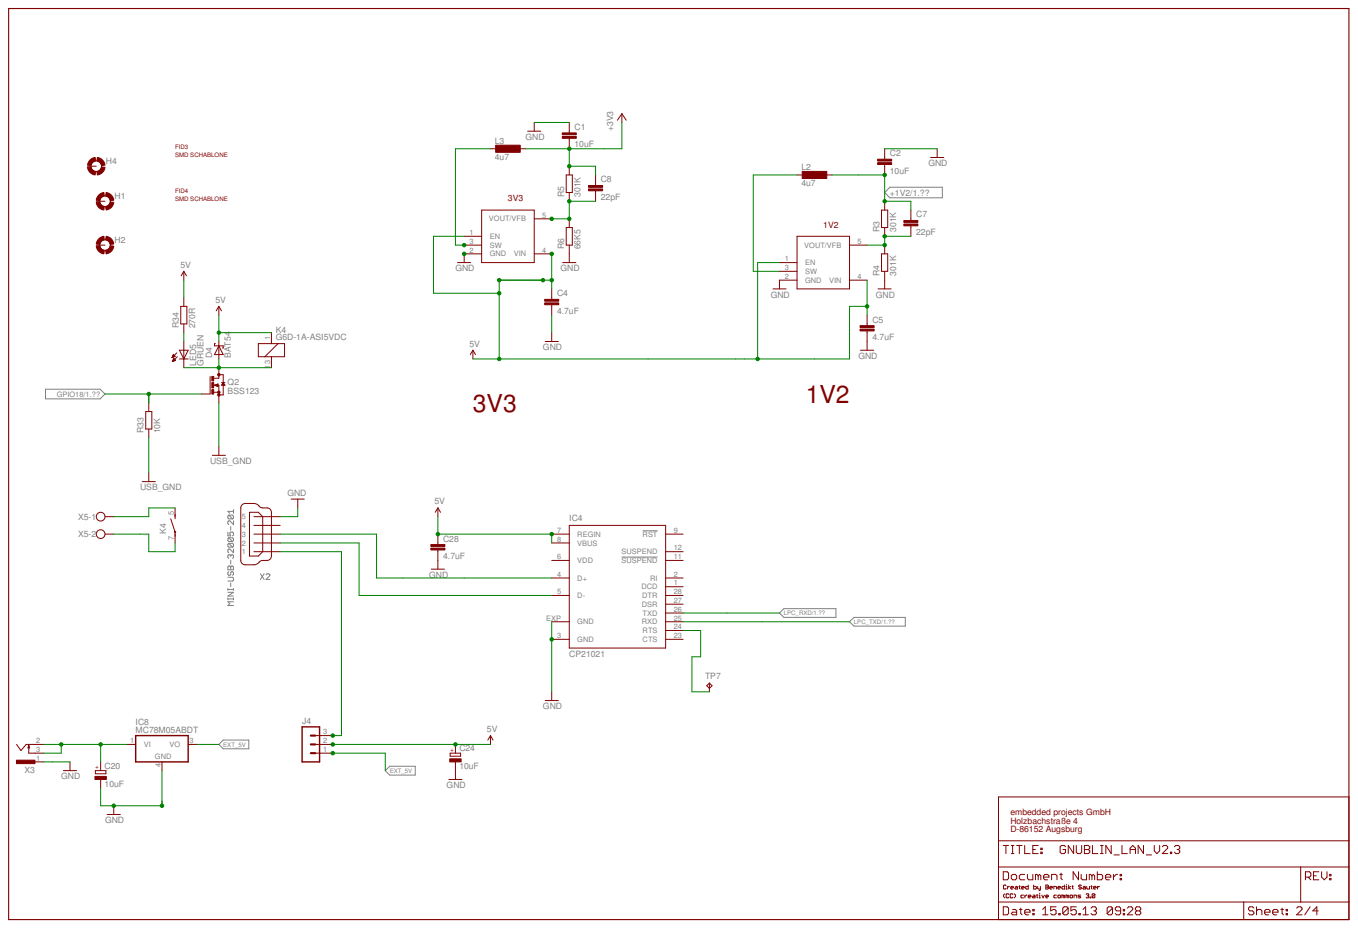
[picture p41: page 2]

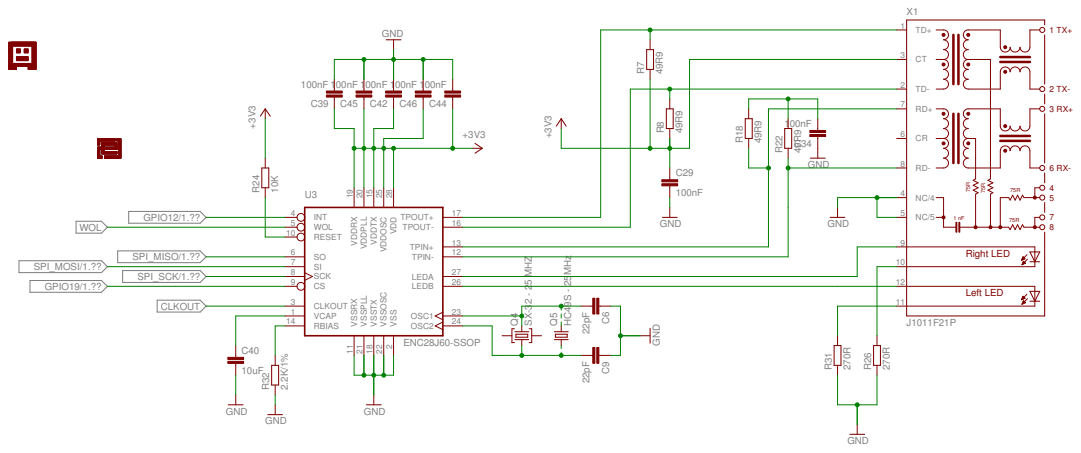
[picture p42: page 3]

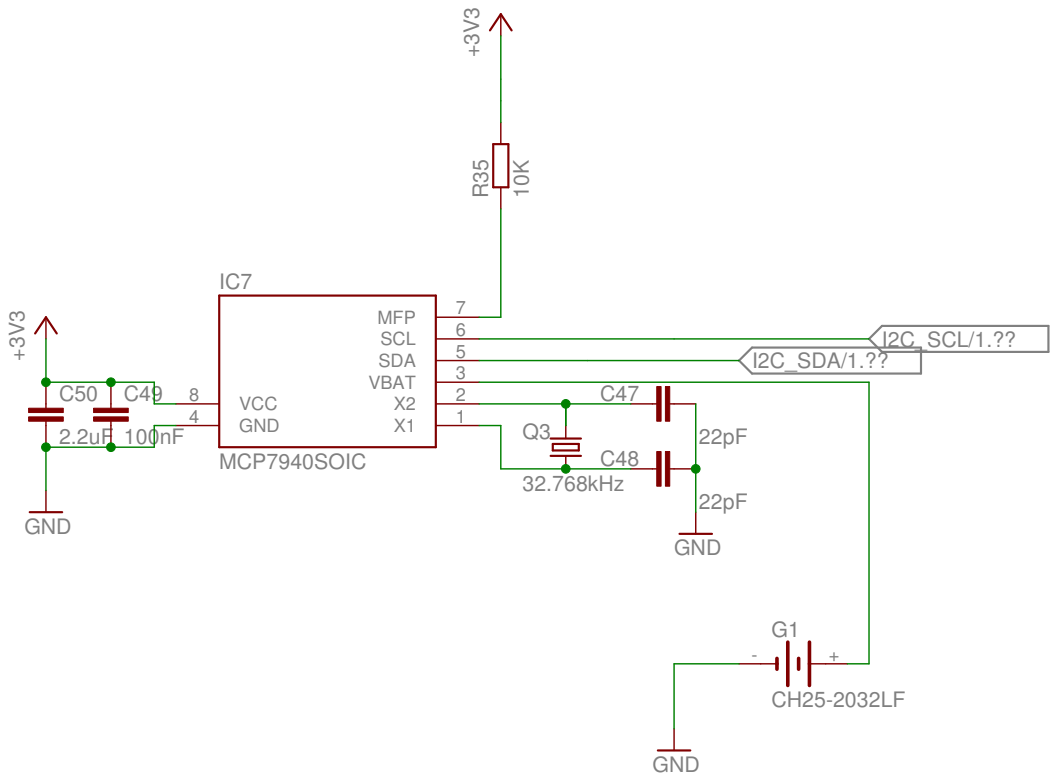
[picture p43: page 4]
