embeddedprojects/gnublin-schematics/Board-RAIL/700926_GNUBLIN_DINRAIL_Schaltplan.pdf

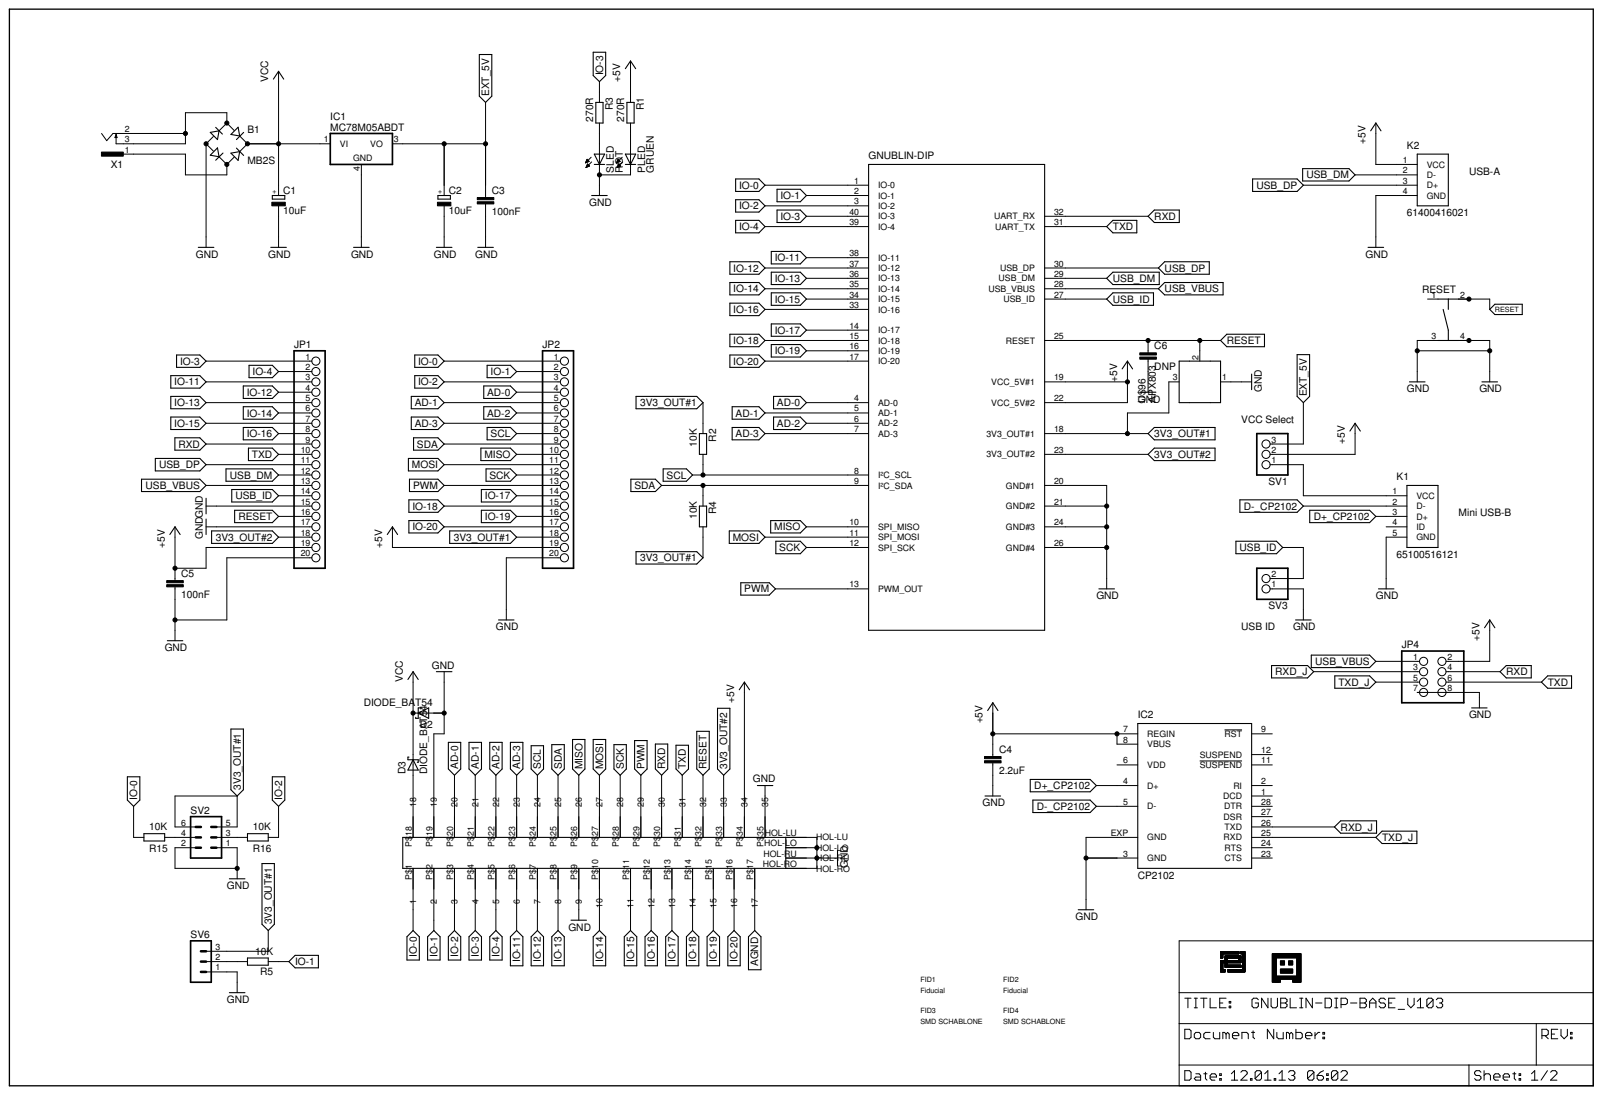
[picture p44: page 1]

IO-13 36 35 | 29 USB_VBUS
34 IO-15 33 | USB_ID

USB_VBUS | 1 2
