embeddedprojects/gnublin-schematics/Module-ADC/MODUL_ADC_V101.pdf

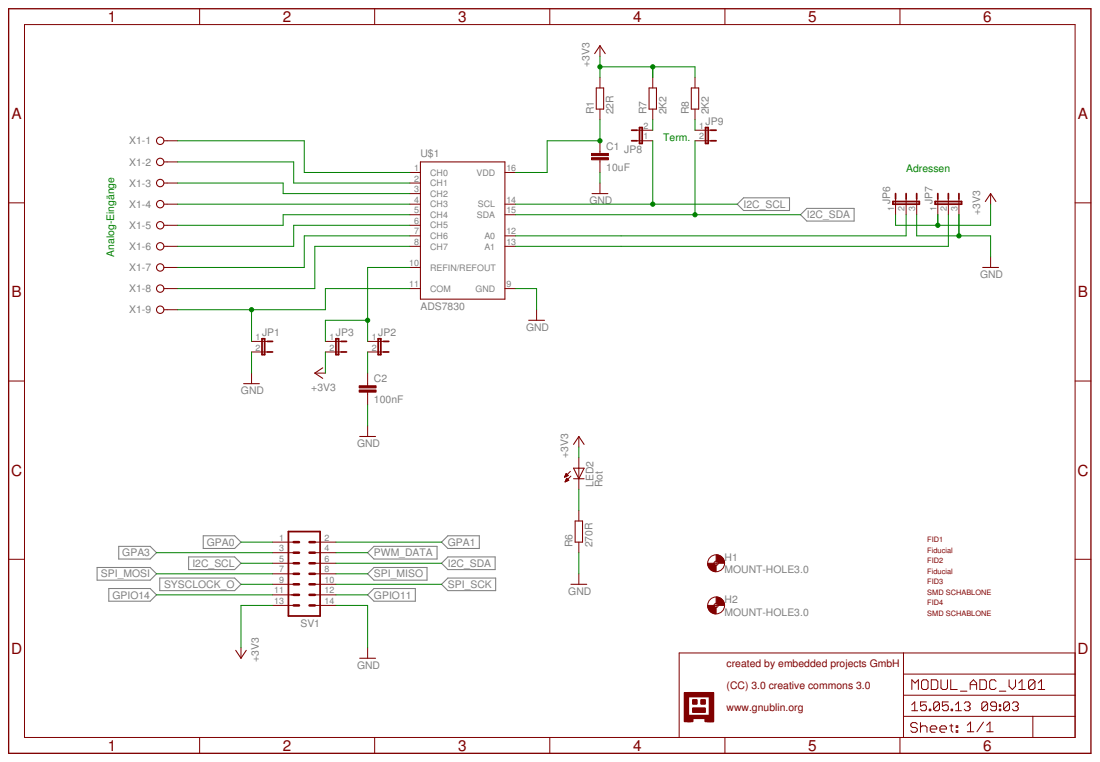
[picture p45: page 1]

Fiducial FID1 Fiducial FID2 SMD SCHABLONE

created by embedded projects GmbH
(CC) 3.0 creative commons 3.0 www.gnublin.org
