embeddedprojects/gnublin-schematics/Module-CAN/MODUL_CAN_V100.pdf

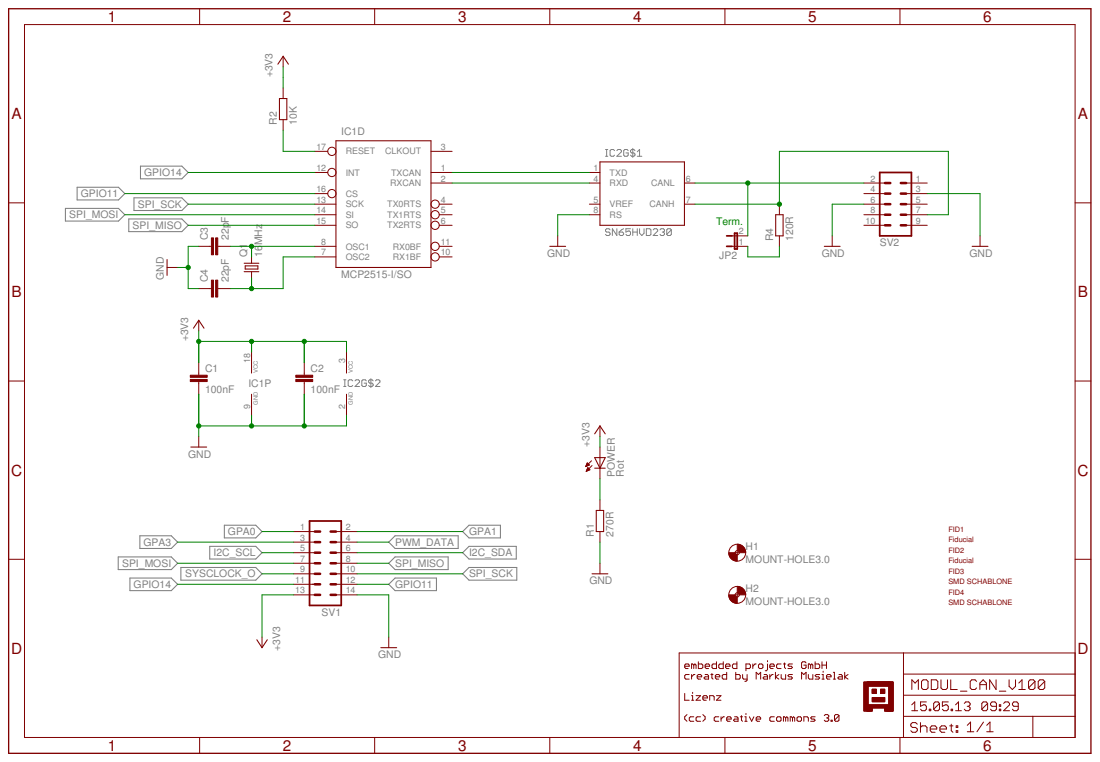
[picture p46: page 1]

Fiducial FID1 Fiducial FID2 SMD SCHABLONE
