embeddedprojects/gnublin-schematics/Module-Extension/Module-Extension_V101.pdf

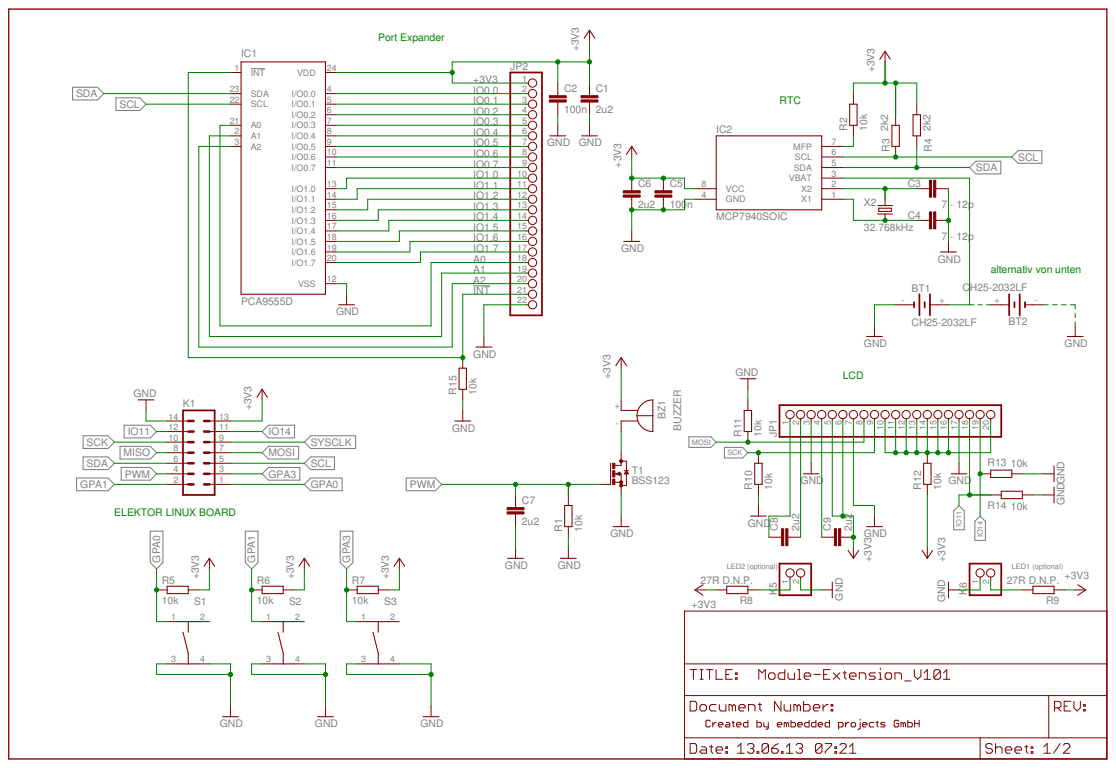
[picture p47: page 1]
