embeddedprojects/gnublin-schematics/Module-GnuBo/MODUL_GNU-BO_BRIDGE_V101.pdf

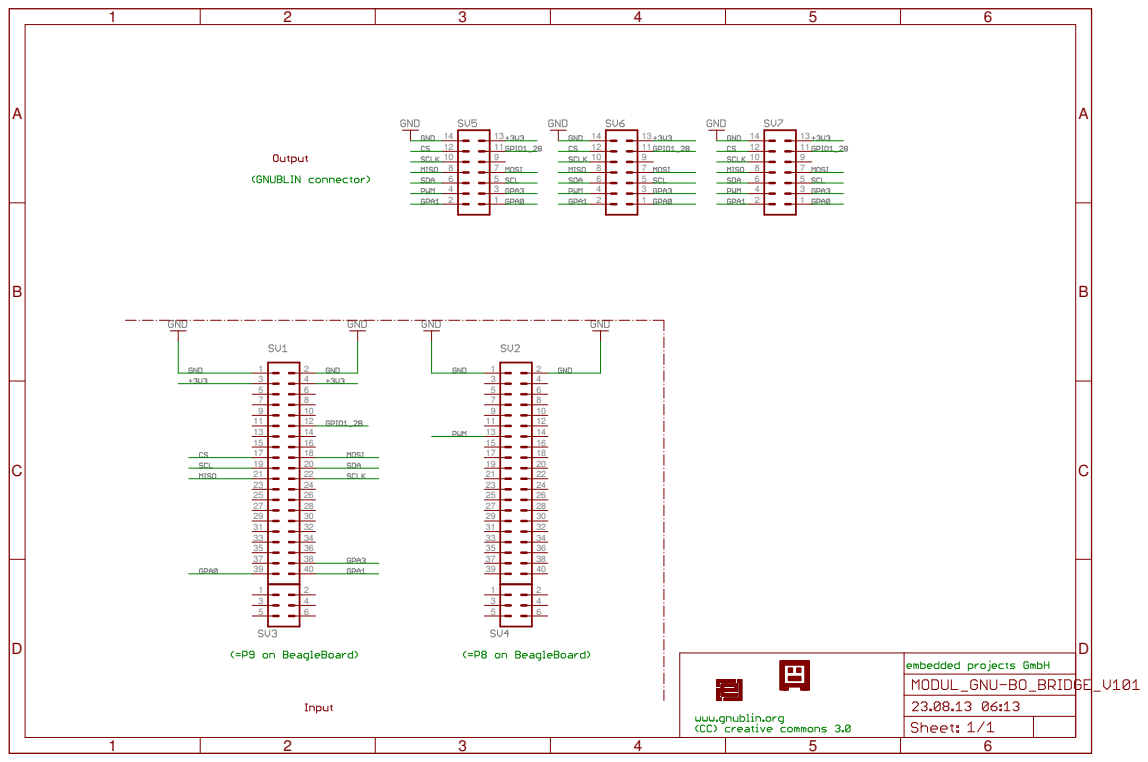
[picture p48: page 1]
