embeddedprojects/gnublin-schematics/Module-GnuPi/MODUL_GNU-PI_BRIDGE_V100.pdf

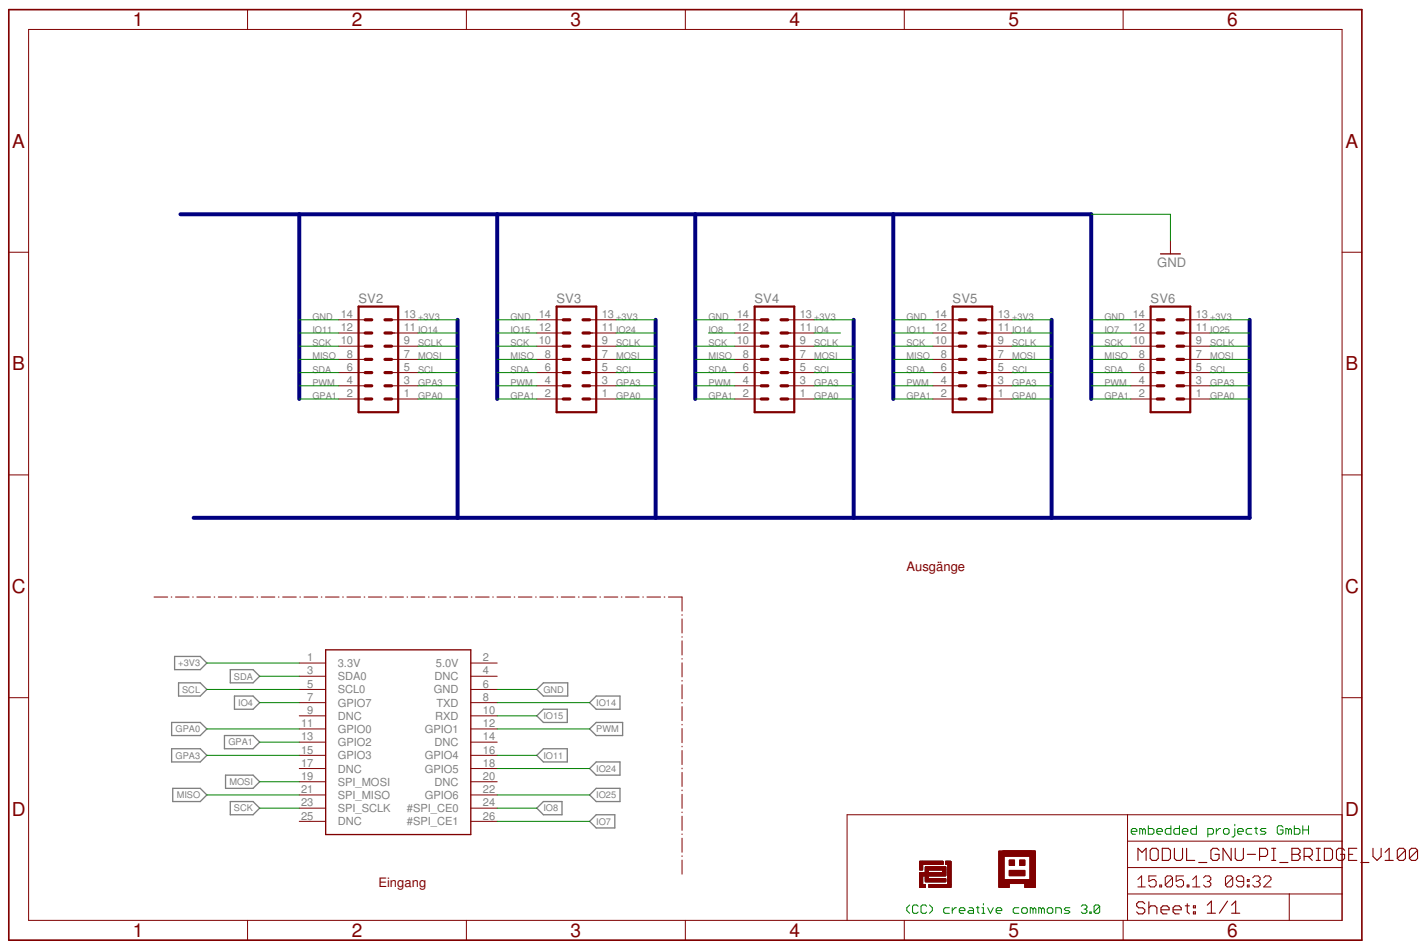
[picture p49: page 1]
