embeddedprojects/gnublin-schematics/Module-GnuPi/MODUL_GNU-PI_BRIDGE_V1001.pdf

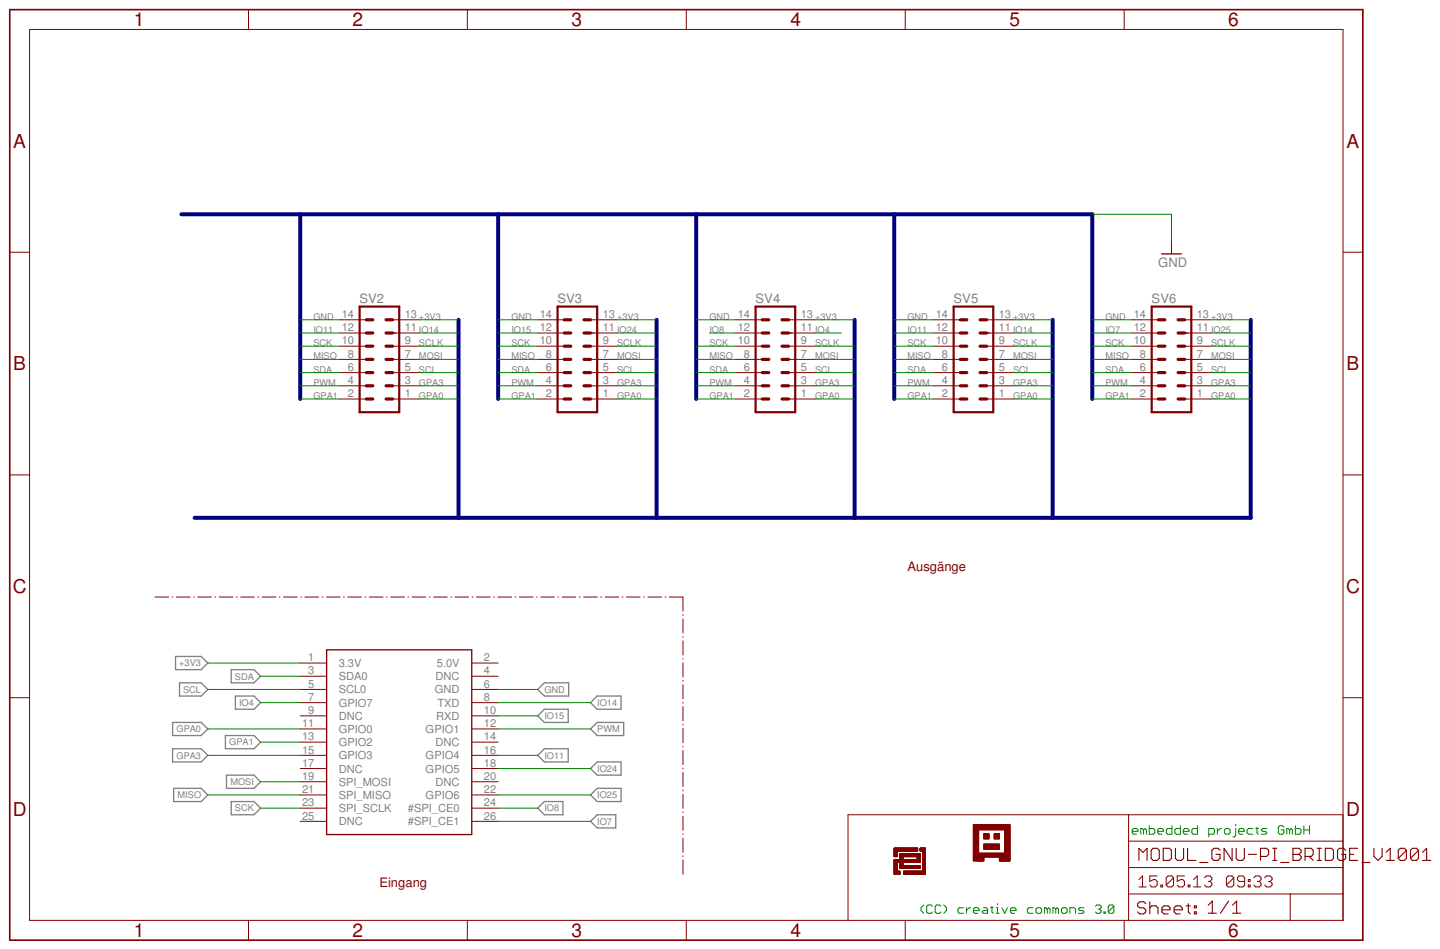
[picture p50: page 1]
