embeddedprojects/gnublin-schematics/Module-IOExpander/MODUL_PORTEXP_V101.pdf

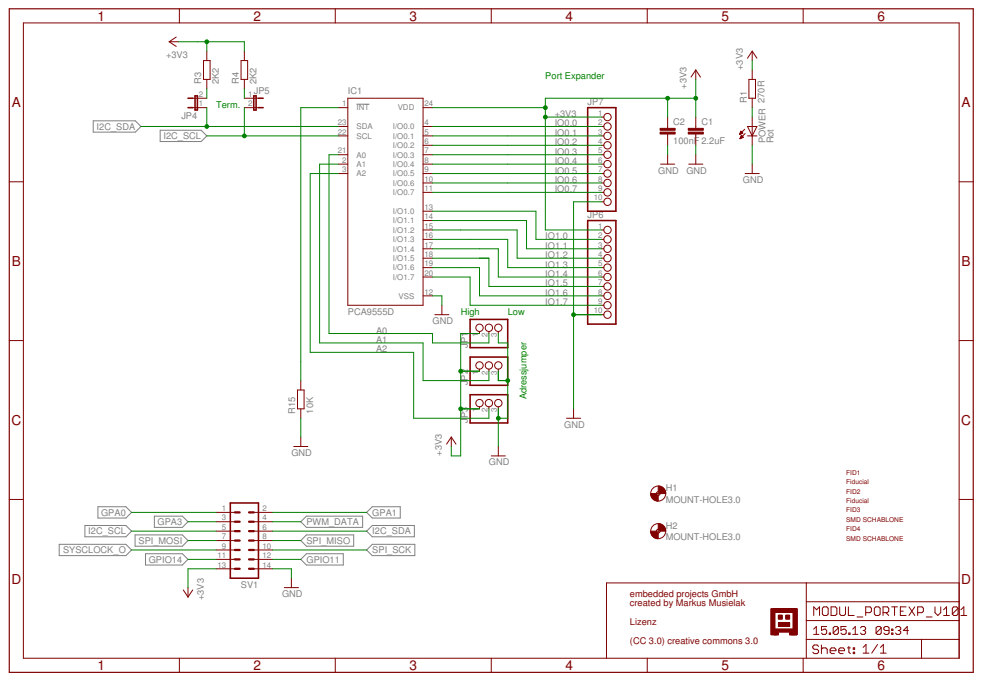
[picture p51: page 1]
