embeddedprojects/gnublin-schematics/Module-LAN/MODUL_LAN_V102.pdf

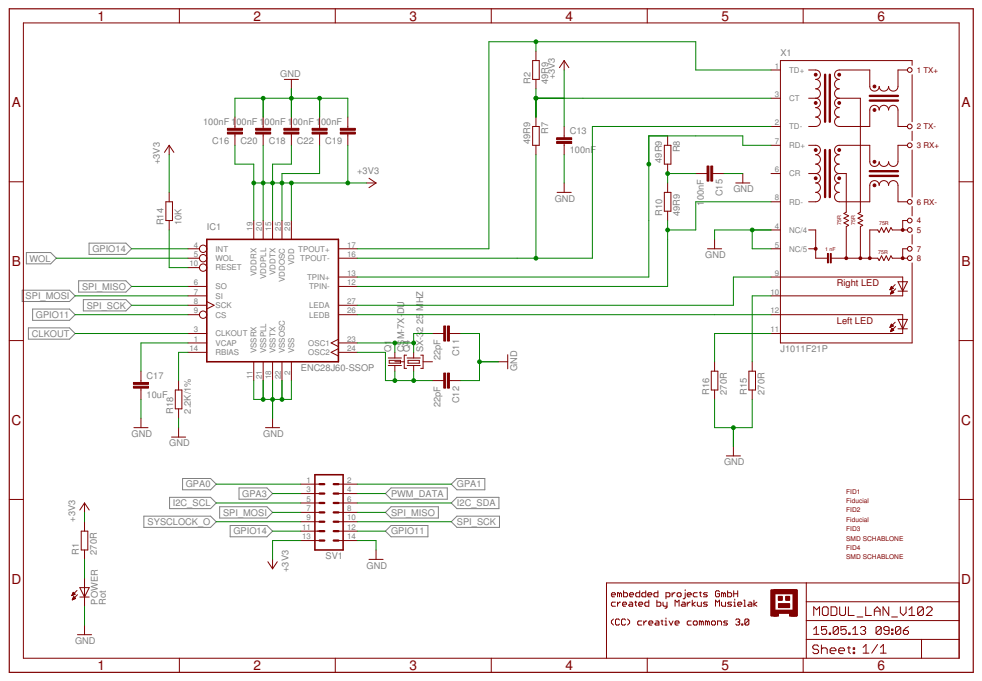
[picture p52: page 1]
