embeddedprojects/gnublin-schematics/Module-LCD/MODUL_LCD_V100.pdf

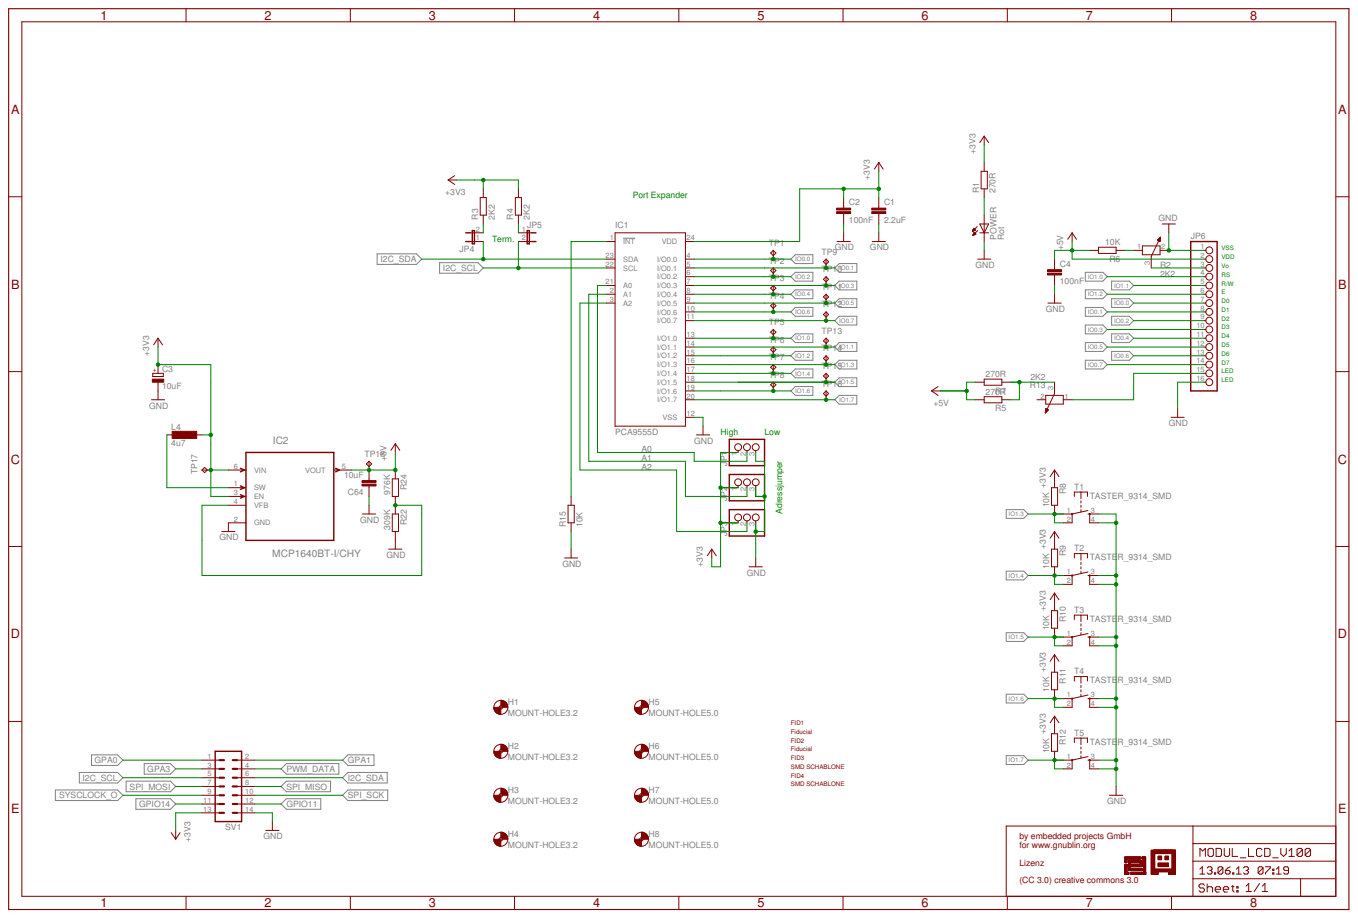
[picture p53: page 1]
