embeddedprojects/gnublin-schematics/Module-LM75/MODUL_TEMPERATURE_V100.pdf

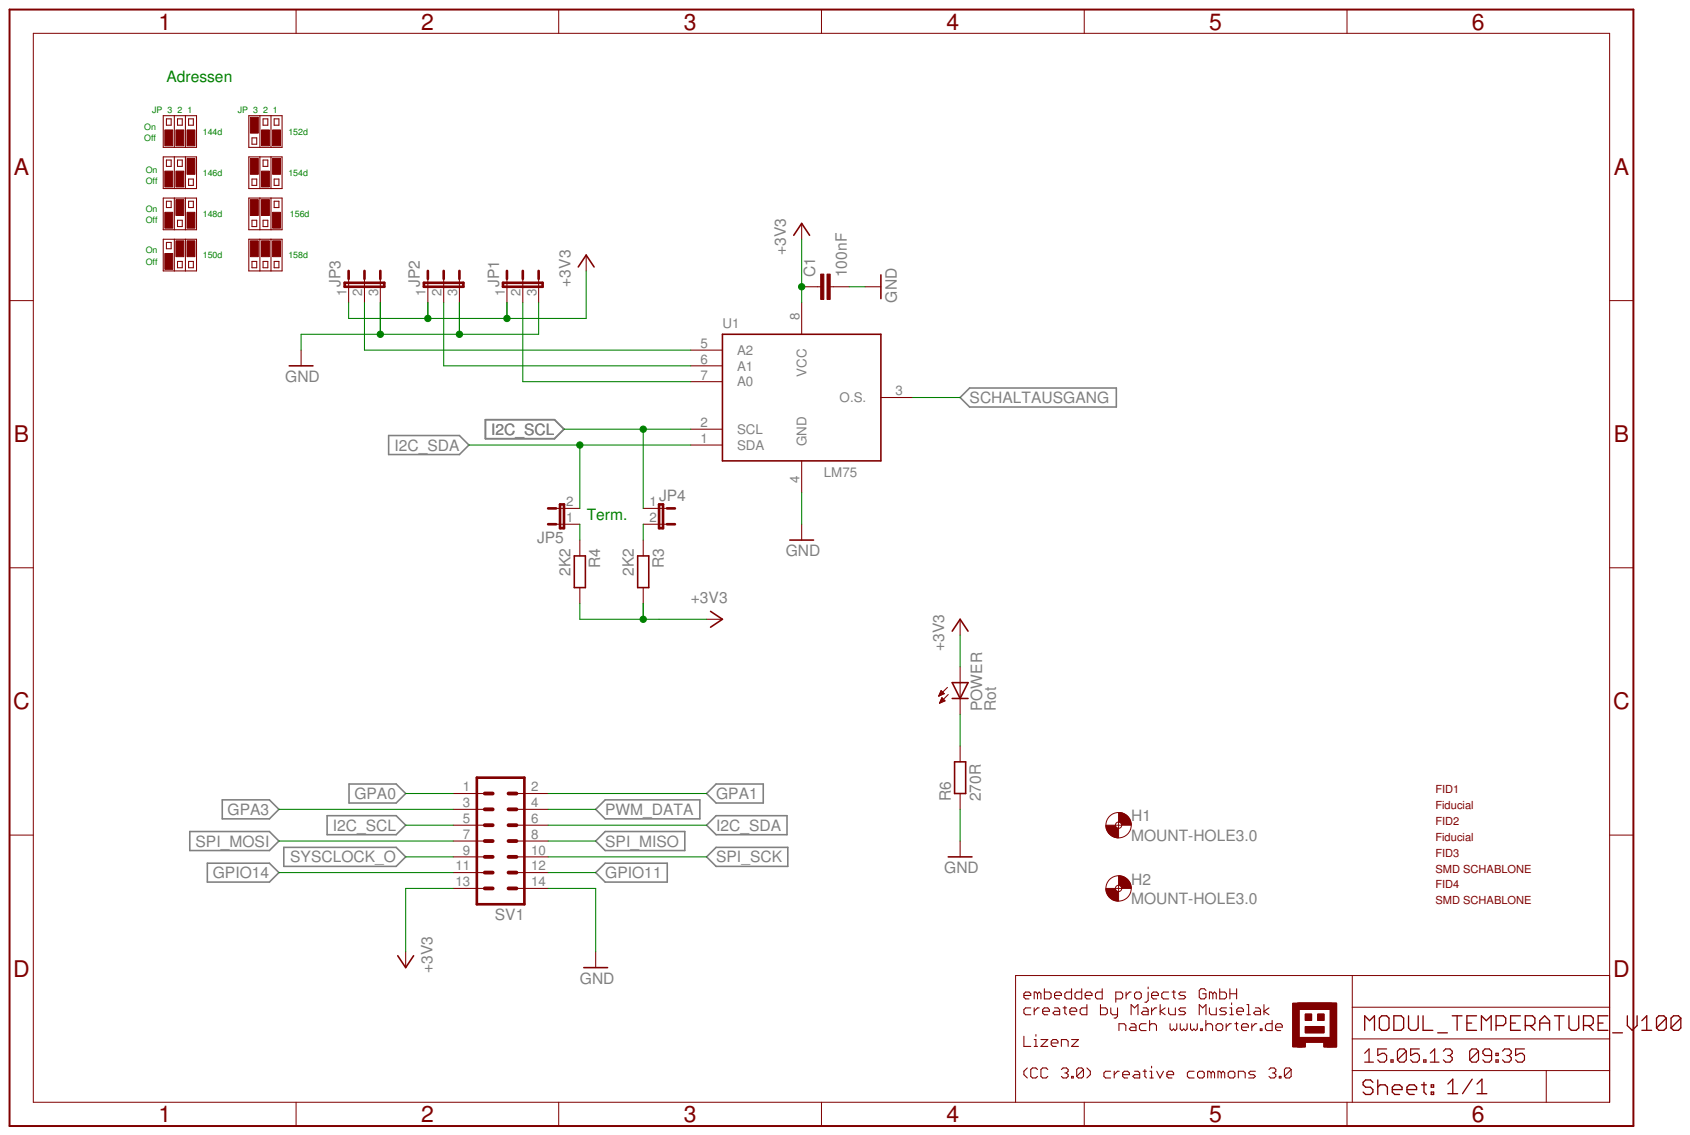
[picture p54: page 1]

Off Off

Fiducial FID1 Fiducial FID2 SMD SCHABLONE
