embeddedprojects/gnublin-schematics/Module-RTC/GNUBLIN_MODULE-RTC.pdf

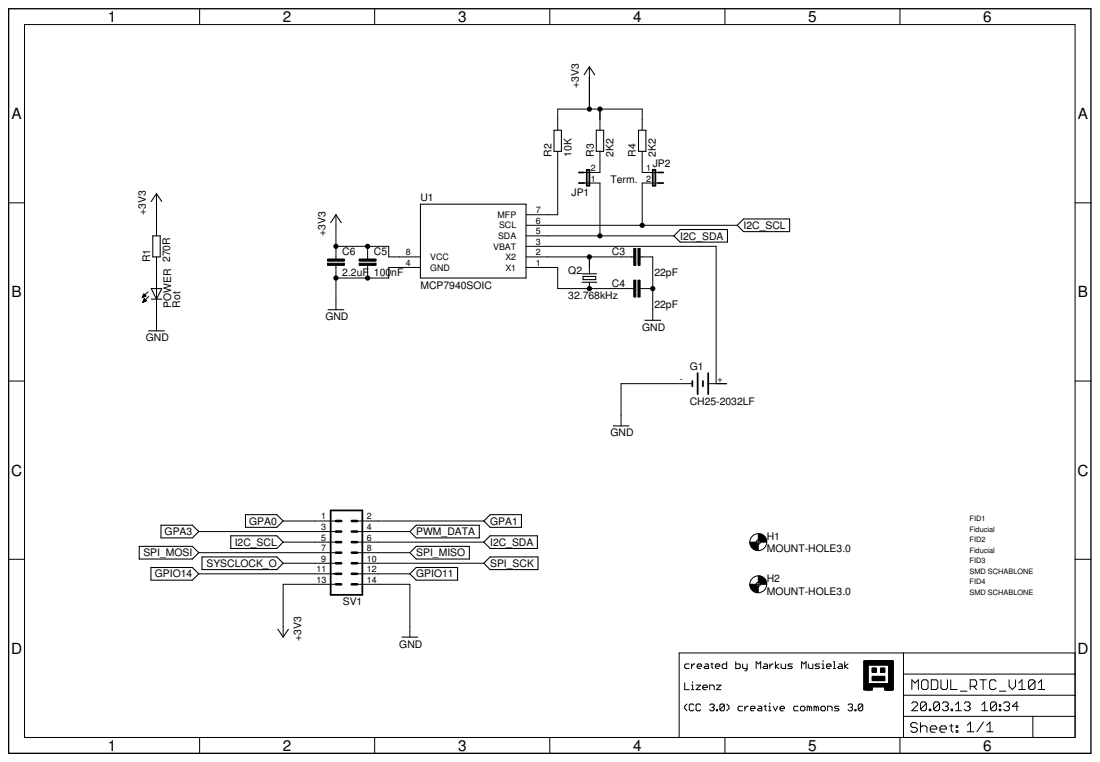
[picture p55: page 1]

Fiducial FID1 Fiducial FID2 SMD SCHABLONE
