embeddedprojects/gnublin-schematics/Module-RS232/MODUL_RS232_V101.pdf

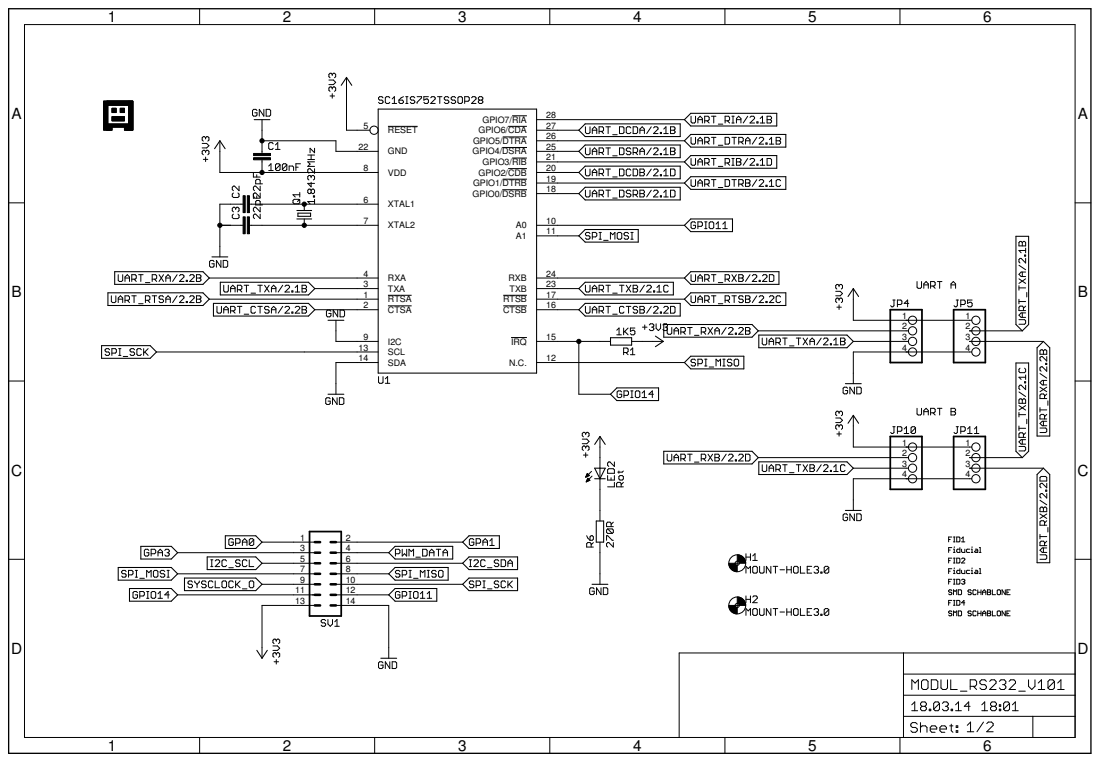
[picture p56: page 1]

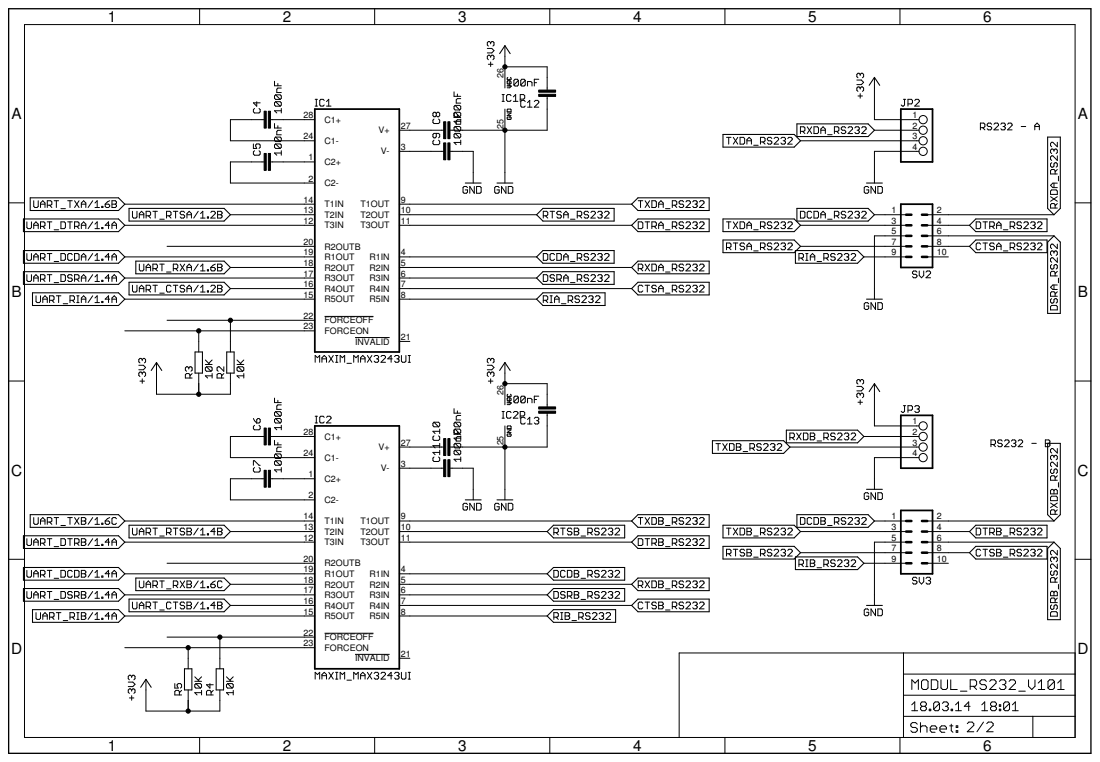
[picture p57: page 2]
