embeddedprojects/gnublin-schematics/Board-Easy-DIP/GNUBLIN-DIP-EASY_V100.brd

## EAGLE design Board-Easy-DIP/GNUBLIN-DIP-EASY_V100.brd (2014-04-14)

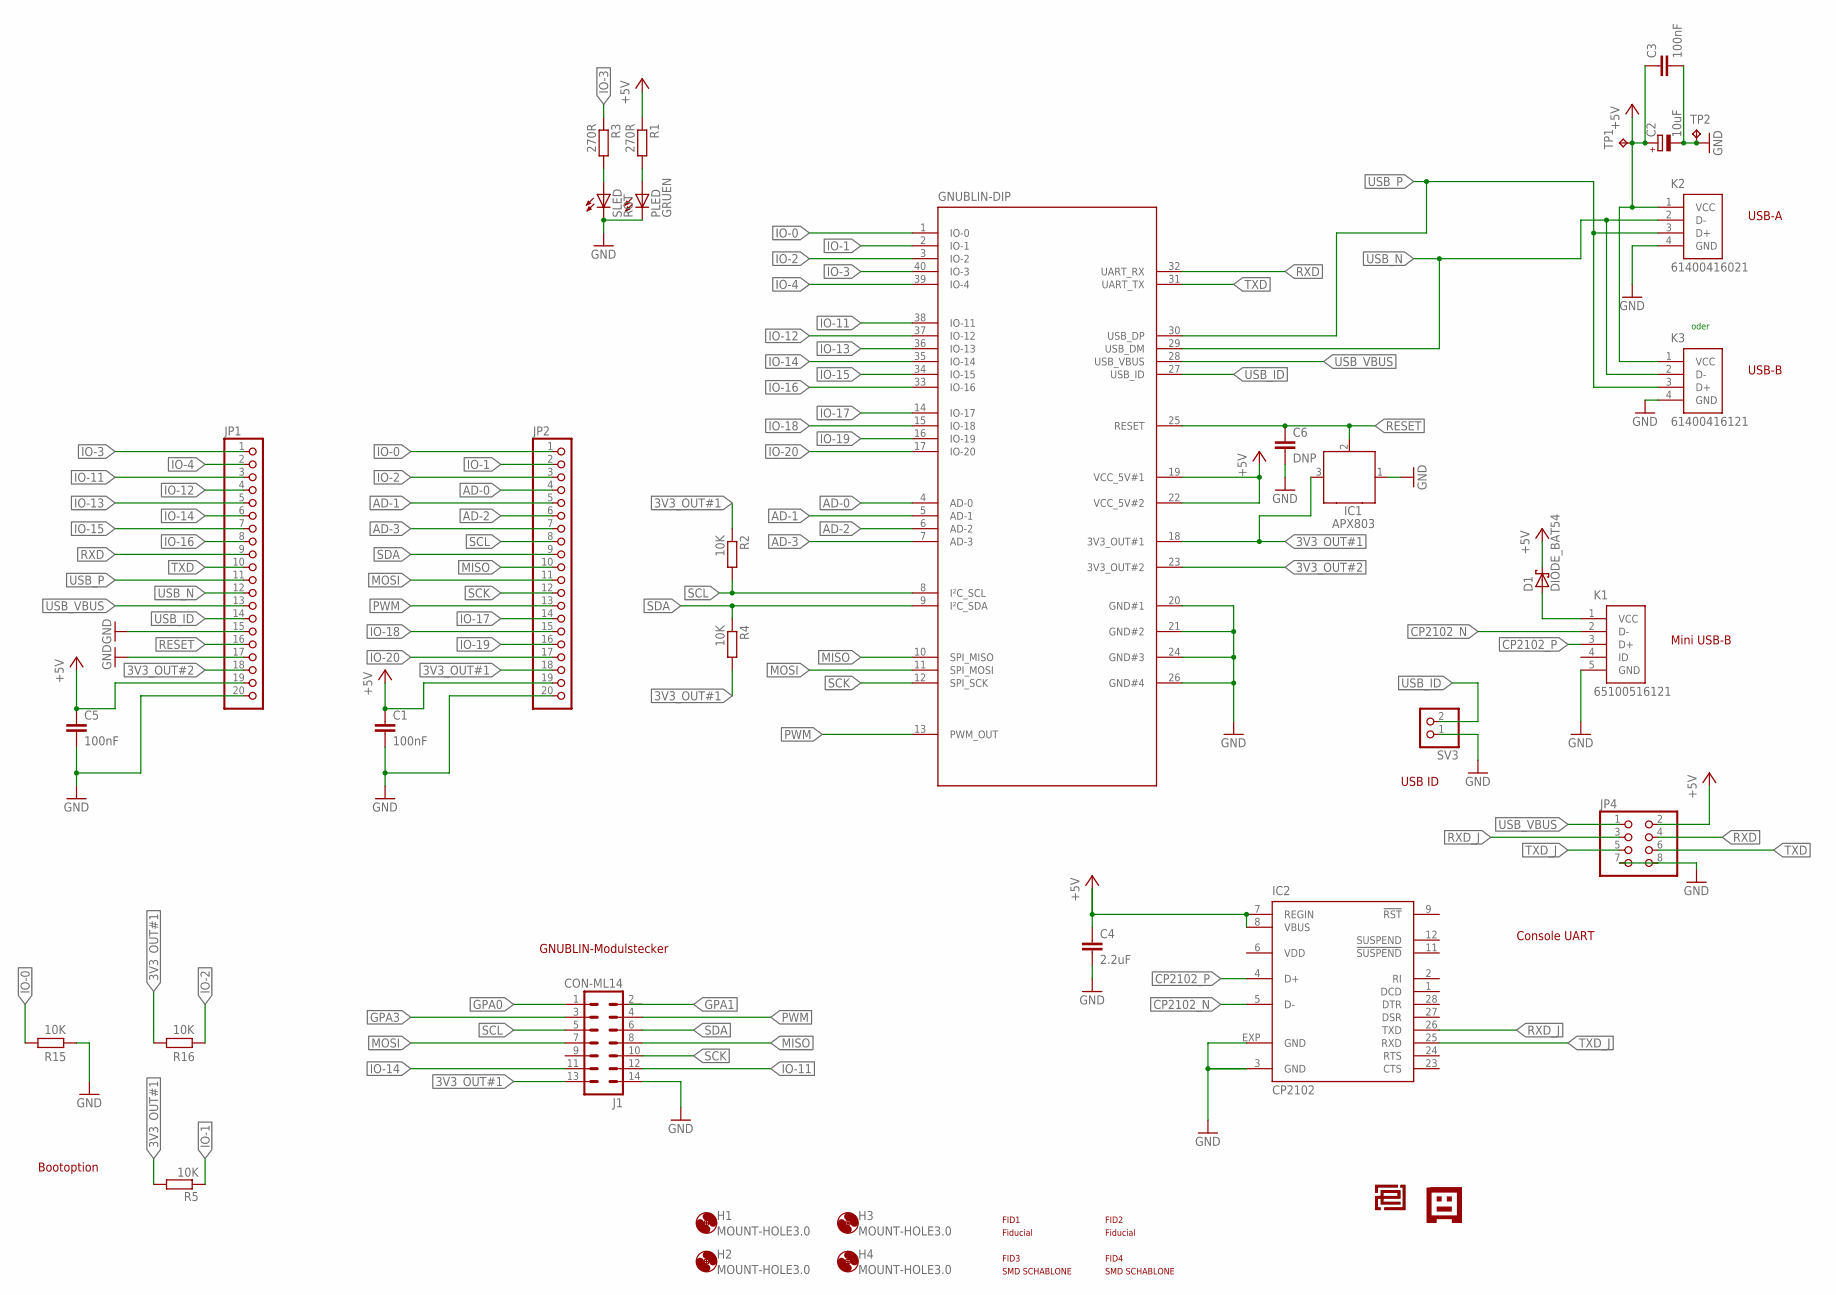
[picture p58: schematic GNUBLIN-DIP-EASY_V100.sch]

Parts:
C1, C3, C5: 100nF; C0805
C2: 10uF; D/7343-31R
C4: 2.2uF; C0805
C6: DNP; C0805
D1: DIODE_BAT54; SOT-23
FID1, FID2, FID3, FID4: PASSERMARKEN_FIDUCIAL
H1, H2, H3, H4: MOUNT-HOLE3.0; 3,0
IC1: APX803; SOT23
IC2: CP2102; MLP28
J1: CON-ML14; ML-14
JP1, JP2: PINHD-1X20; 1X20
JP4: PINHD-2X4; 2X04
K1: 65100516121
K2: 61400416021
K3: 61400416121
PLED: GRUEN; CHIPLED_0805
R1, R3: 270R; R0805
R2, R4, R5, R15, R16: 10K; R0805
SLED: ROT; CHIPLED_0805
SV3: PINHD-1X2; 1X02
TP1, TP2: TPB1,27; B1,27
U4: GNUBLIN-DIP; DIL40
U$1: GNUBLIN-LOGODRUCK; GNUBLINSIEBDRUCK
U$2: EPLOGOSIEB; EPLOGOSIEBDRUCK

Connections:
3V3_OUT#1: IC1.3 (VCC), J1.13, JP2.18, R2.1, R4.2, R5.2, R16.1, U4.18 (3V3_OUT#1)
3V3_OUT#2: JP1.18, U4.23 (3V3_OUT#2)
+5V: C1.1, C2.+, C3.1, C4.1, C5.1, D1.3 (C), IC2.7 (REGIN), IC2.8 (VBUS), JP1.19, JP2.19, JP4.2, K2.1 (VCC), K3.1 (VCC), R1.1, TP1.TP, U4.19 (VCC_5V#1), U4.22 (VCC_5V#2)
AD-0: JP2.4, U4.4 (AD-0)
AD-1: JP2.5, U4.5 (AD-1)
AD-2: JP2.6, U4.6 (AD-2)
AD-3: JP2.7, U4.7 (AD-3)
CP2102_N: IC2.5 (D-), K1.2 (D-)
CP2102_P: IC2.4 (D+), K1.3 (D+)
GND: C1.2, C2.-, C3.2, C4.2, C5.2, C6.2, IC1.1 (GND), IC2.3 (GND), IC2.EXP (GND), J1.14, JP1.15, JP1.17, JP1.20, JP2.20, JP4.7, JP4.8, K1.5 (GND), K2.4 (GND), K3.4 (GND), PLED.C, R15.2, SLED.C, SV3.1, TP2.TP, U4.20 (GND#1), U4.21 (GND#2), U4.24 (GND#3), U4.26 (GND#4)
GPA0: J1.1
GPA3: J1.3
IO-0: JP2.1, R15.1, U4.1 (IO-0)
IO-1: JP2.2, R5.1, U4.2 (IO-1)
IO-2: JP2.3, R16.2, U4.3 (IO-2)
IO-3: JP1.1, R3.1, U4.40 (IO-3)
IO-4: JP1.2, U4.39 (IO-4)
IO-11: J1.12, JP1.3, U4.38 (IO-11)
IO-12: JP1.4, U4.37 (IO-12)
IO-13: JP1.5, U4.36 (IO-13)
IO-14: J1.11, JP1.6, U4.35 (IO-14)
IO-15: JP1.7, U4.34 (IO-15)
IO-16: JP1.8, U4.33 (IO-16)
IO-17: JP2.14, U4.14 (IO-17)
IO-18: JP2.15, U4.15 (IO-18)
IO-19: JP2.16, U4.16 (IO-19)
IO-20: JP2.17, U4.17 (IO-20)
MISO: J1.8, JP2.10, U4.10 (SPI_MISO)
MOSI: J1.7, JP2.11, U4.11 (SPI_MOSI)
unnamed: R3.2, SLED.A
unnamed: D1.1 (A), K1.1 (VCC)
unnamed: PLED.A, R1.2
PWM: J1.4, JP2.13, U4.13 (PWM_OUT)
RESET: C6.1, IC1.2 (!RESET), JP1.16, U4.25 (RESET)
RXD: JP1.9, JP4.4, U4.32 (UART_RX)
RXD_J: IC2.26 (TXD), JP4.3
SCK: J1.10, JP2.12, U4.12 (SPI_SCK)
SCL: J1.5, JP2.8, R2.2, U4.8 (I²C_SCL)
SDA: J1.6, JP2.9, R4.1, U4.9 (I²C_SDA)
TXD: JP1.10, JP4.6, U4.31 (UART_TX)
TXD_J: IC2.25 (RXD), JP4.5
USB_ID: JP1.14, SV3.2, U4.27 (USB_ID)
USB_N: JP1.12, K2.2 (D-), K3.2 (D-), U4.29 (USB_DM)
USB_P: JP1.11, K2.3 (D+), K3.3 (D+), U4.30 (USB_DP)
USB_VBUS: JP1.13, JP4.1, U4.28 (USB_VBUS)
VDD: IC2.6 (VDD)

Notes on the sheet:
USB ID
Mini USB-B
USB-A
Bootoption
GNUBLIN-Modulstecker
Console UART
oder
USB-B

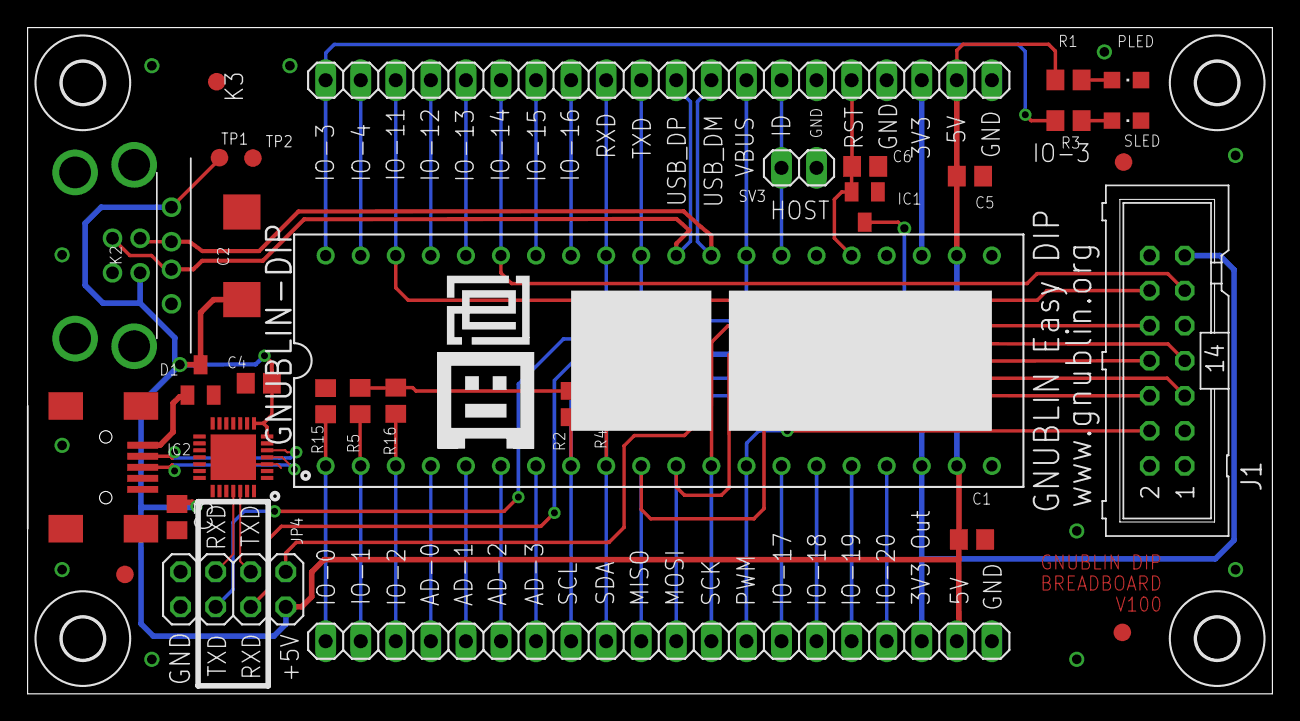
[picture p59: board GNUBLIN-DIP-EASY_V100.brd from above]

Board: 2 copper layers, 90.2 x 48.3 mm, 39 parts (0 on the bottom side), 43 nets.
