embeddedprojects/gnublin-schematics/DIN-Rail-In/DIN-Rail-In_V103.brd

## EAGLE design DIN-Rail-In/DIN-Rail-In_V103.brd (2014-04-08)

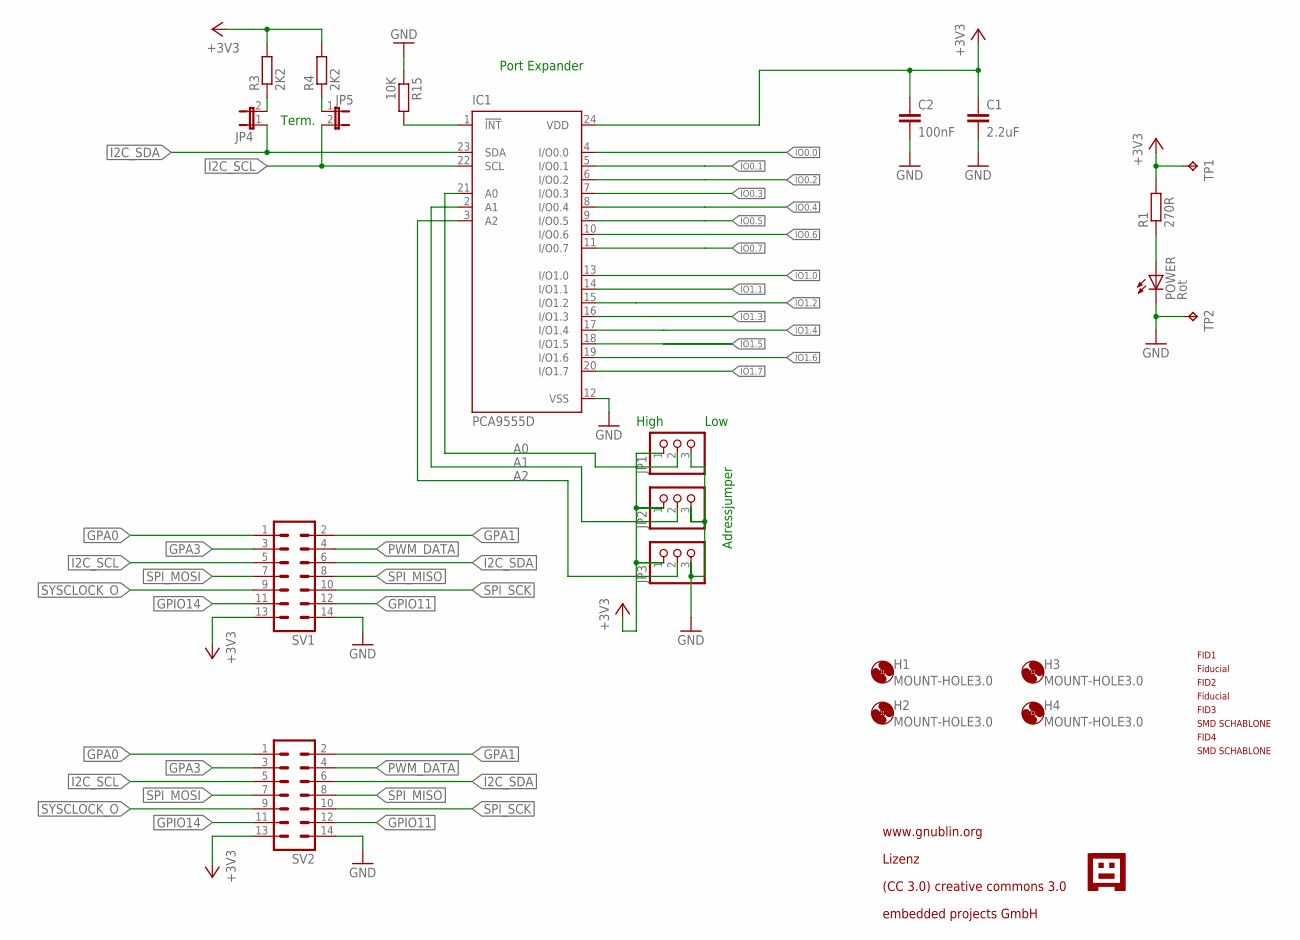
[picture p60: schematic DIN-Rail-In_V103.sch, sheet 1]

Parts:
C1: 2.2uF; C0805
C2: 100nF; C0805
FID1, FID2, FID3, FID4: PASSERMARKEN_FIDUCIAL
H1, H2, H3, H4: MOUNT-HOLE3.0; 3,0
IC1: PCA9555D; SO24
JP1, JP2, JP3: PINHD-1X3; 1X03
JP4, JP5: JP1E; JP1
POWER: Rot; CHIP-LED0805
R1: 270R; R0805
R3, R4: 2K2; R0805
R15: 10K; R0805
SV1, SV2: ML14
TP1, TP2: TPB1,27; B1,27
U$2: GNUBLINLOGOSIEB; GNUSIEBDRUCK

Connections:
!INT: IC1.1 (!INT), R15.2
+3V3: C1.1, C2.1, IC1.24 (VDD), JP1.1, JP2.1, JP3.1, R1.2, R3.2, R4.2, SV1.13, SV2.13, TP1.TP; also elsewhere on the board
A0: IC1.21 (A0), JP1.2
A1: IC1.2 (A1), JP2.2
A2: IC1.3 (A2), JP3.2
GND: C1.2, C2.2, IC1.12 (VSS), JP1.3, JP2.3, JP3.3, POWER.C, R15.1, SV1.14, SV2.14, TP2.TP; also elsewhere on the board
GPA0: SV1.1, SV2.1
GPA1: SV1.2, SV2.2
GPA3: SV1.3, SV2.3
GPIO11: SV1.12, SV2.12
GPIO14: SV1.11, SV2.11
I2C_SCL: IC1.22 (SCL), JP5.2, SV1.5, SV2.5
I2C_SDA: IC1.23 (SDA), JP4.1, SV1.6, SV2.6
IO0.0: IC1.4 (I/O0.0)
IO0.1: IC1.5 (I/O0.1)
IO0.2: IC1.6 (I/O0.2)
IO0.3: IC1.7 (I/O0.3)
IO0.4: IC1.8 (I/O0.4)
IO0.5: IC1.9 (I/O0.5)
IO0.6: IC1.10 (I/O0.6)
IO0.7: IC1.11 (I/O0.7)
IO1.0: IC1.13 (I/O1.0); also elsewhere on the board
IO1.1: IC1.14 (I/O1.1); also elsewhere on the board
IO1.2: IC1.15 (I/O1.2); also elsewhere on the board
IO1.3: IC1.16 (I/O1.3); also elsewhere on the board
IO1.4: IC1.17 (I/O1.4); also elsewhere on the board
IO1.5: IC1.18 (I/O1.5); also elsewhere on the board
IO1.6: IC1.19 (I/O1.6); also elsewhere on the board
IO1.7: IC1.20 (I/O1.7); also elsewhere on the board
unnamed: JP4.2, R3.1
unnamed: POWER.A, R1.1
unnamed: JP5.1, R4.1
PWM_DATA: SV1.4, SV2.4
SPI_MISO: SV1.8, SV2.8
SPI_MOSI: SV1.7, SV2.7
SPI_SCK: SV1.10, SV2.10
SYSCLOCK_O: SV1.9, SV2.9

Notes on the sheet:
Port Expander
Adressjumper
Term.
High
Low
www.gnublin.org
Lizenz
(CC 3.0) creative commons 3.0
embedded projects GmbH

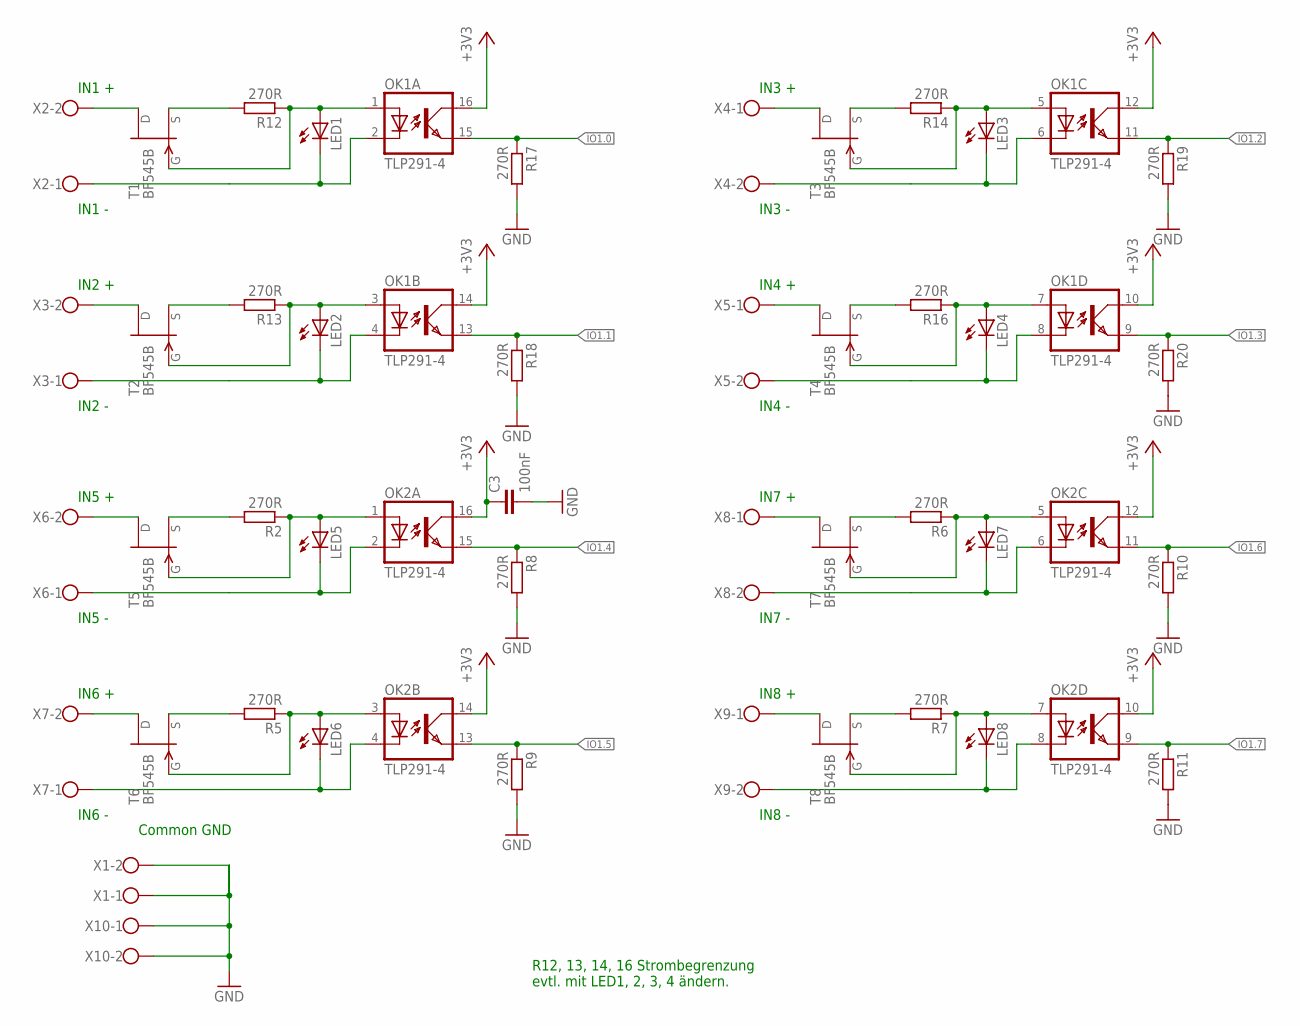
[picture p61: schematic DIN-Rail-In_V103.sch, sheet 2]

Parts:
C3: 100nF; C0805
LED1, LED2, LED3, LED4, LED5, LED6, LED7, LED8: LEDCHIPLED_0805; CHIPLED_0805
OK1, OK2: TLP291-4; MINI-FLAT-16
R2, R5, R6, R7, R8, R9, R10, R11, R12, R13, R14, R16, R17, R18, R19, R20: 270R; R0805
T1, T2, T3, T4, T5, T6, T7, T8: BF545B; SOT-23
X1, X2, X3, X4, X5, X6, X7, X8, X9, X10: W237-02P; W237-132

Connections:
+3V3: C3.1, OK1.10 (COL), OK1.12 (COL), OK1.14 (COL), OK1.16 (COL), OK2.10 (COL), OK2.12 (COL), OK2.14 (COL), OK2.16 (COL); also elsewhere on the board
GND: C3.2, R8.2, R9.2, R10.2, R11.2, R17.2, R18.2, R19.2, R20.2, X1.1, X1.2, X10.1, X10.2; also elsewhere on the board
IO1.0: OK1.15 (EMIT), R17.1; also elsewhere on the board
IO1.1: OK1.13 (EMIT), R18.1; also elsewhere on the board
IO1.2: OK1.11 (EMIT), R19.1; also elsewhere on the board
IO1.3: OK1.9 (EMIT), R20.1; also elsewhere on the board
IO1.4: OK2.15 (EMIT), R8.1; also elsewhere on the board
IO1.5: OK2.13 (EMIT), R9.1; also elsewhere on the board
IO1.6: OK2.11 (EMIT), R10.1; also elsewhere on the board
IO1.7: OK2.9 (EMIT), R11.1; also elsewhere on the board
unnamed: T1.2 (D), X2.2
unnamed: LED1.A, OK1.1 (A), R12.1, T1.3 (G)
unnamed: T5.2 (D), X6.2
unnamed: T2.2 (D), X3.2
unnamed: LED2.A, OK1.3 (A), R13.1, T2.3 (G)
unnamed: LED5.A, OK2.1 (A), R2.1, T5.3 (G)
unnamed: LED1.C, OK1.2 (C), X2.1
unnamed: T3.2 (D), X4.1
unnamed: LED3.A, OK1.5 (A), R14.1, T3.3 (G)
unnamed: T4.2 (D), X5.1
unnamed: LED4.A, OK1.7 (A), R16.1, T4.3 (G)
unnamed: T6.2 (D), X7.2
unnamed: LED2.C, OK1.4 (C), X3.1
unnamed: LED6.A, OK2.3 (A), R5.1, T6.3 (G)
unnamed: LED3.C, OK1.6 (C), X4.2
unnamed: LED4.C, OK1.8 (C), X5.2
unnamed: R12.2, T1.1 (S)
unnamed: T7.2 (D), X8.1
unnamed: R13.2, T2.1 (S)
unnamed: LED7.A, OK2.5 (A), R6.1, T7.3 (G)
unnamed: R14.2, T3.1 (S)
unnamed: T8.2 (D), X9.1
unnamed: R16.2, T4.1 (S)
unnamed: LED8.A, OK2.7 (A), R7.1, T8.3 (G)
unnamed: LED5.C, OK2.2 (C), X6.1
unnamed: LED6.C, OK2.4 (C), X7.1
unnamed: LED7.C, OK2.6 (C), X8.2
unnamed: LED8.C, OK2.8 (C), X9.2
unnamed: R2.2, T5.1 (S)
unnamed: R5.2, T6.1 (S)
unnamed: R6.2, T7.1 (S)
unnamed: R7.2, T8.1 (S)

Notes on the sheet:
IN1 +
IN1 -
IN2 +
IN2 -
IN3 +
IN3 -
IN4 +
IN4 -
Common GND
R12, 13, 14, 16 Strombegrenzung evtl. mit LED1, 2, 3, 4 ändern.
IN5 +
IN5 -
IN6 +
IN6 -
IN7 +
IN7 -
IN8 +
IN8 -

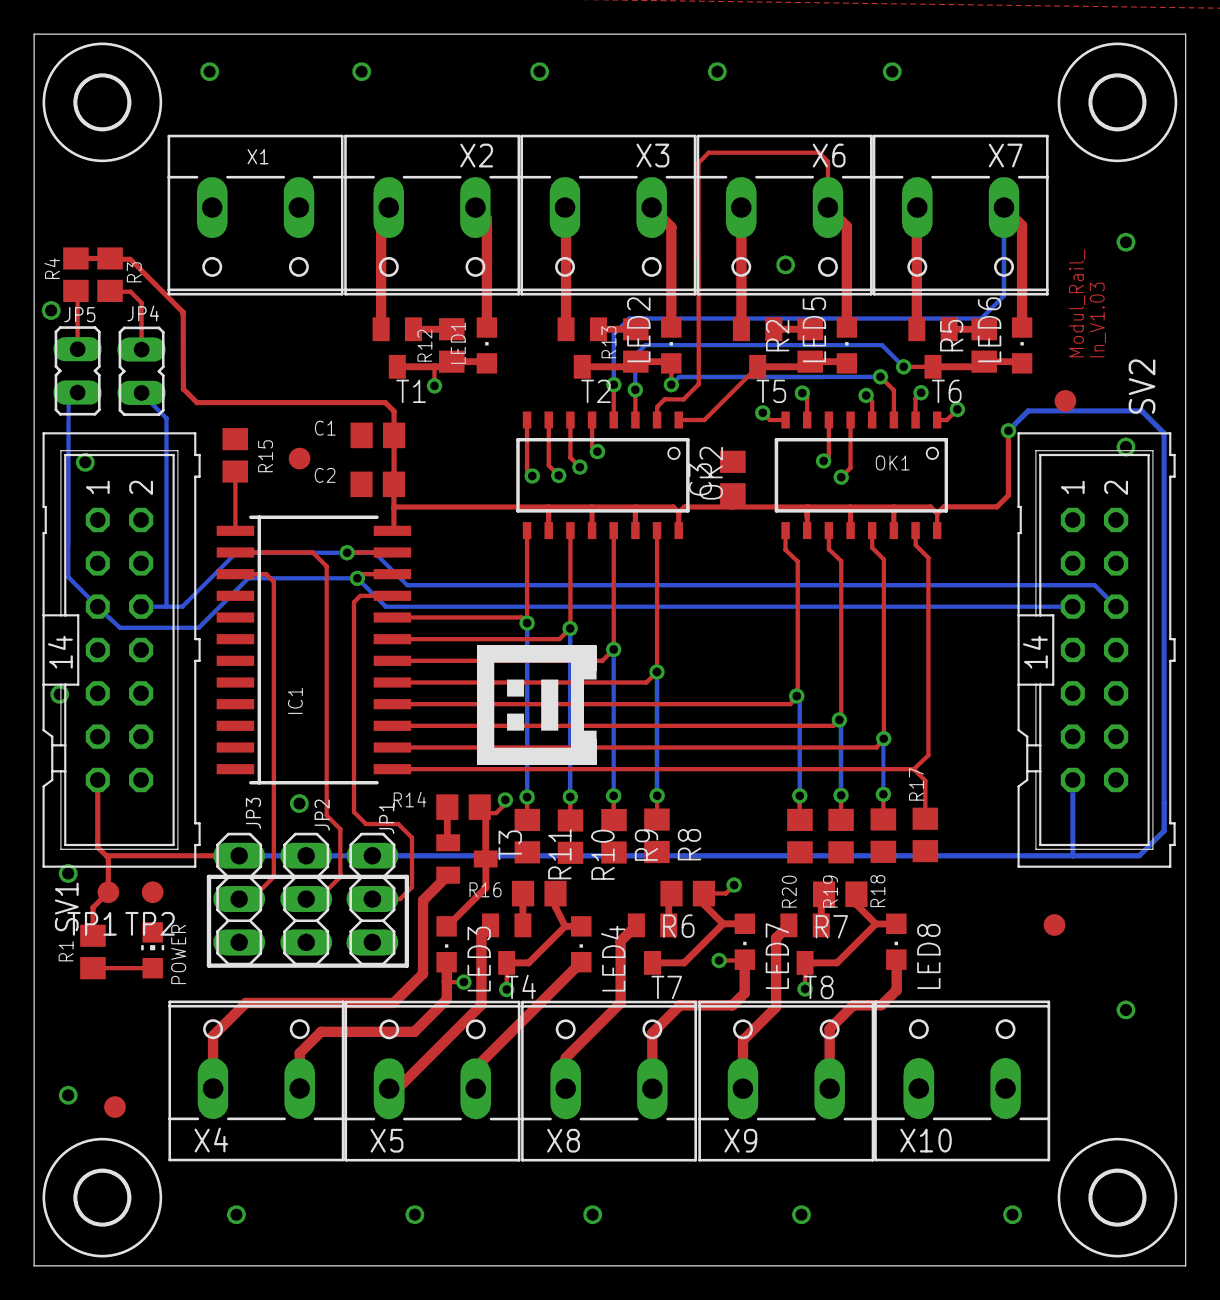
[picture p62: board DIN-Rail-In_V103.brd from above]

Board: 4 copper layers, 67.5 x 72.2 mm, 71 parts (0 on the bottom side), 61 nets.
