embeddedprojects/gnublin-schematics/Module-GnuBo/MODUL_GNU-BO_BRIDGE_V101.brd

## EAGLE design Module-GnuBo/MODUL_GNU-BO_BRIDGE_V101.brd (2014-03-18)

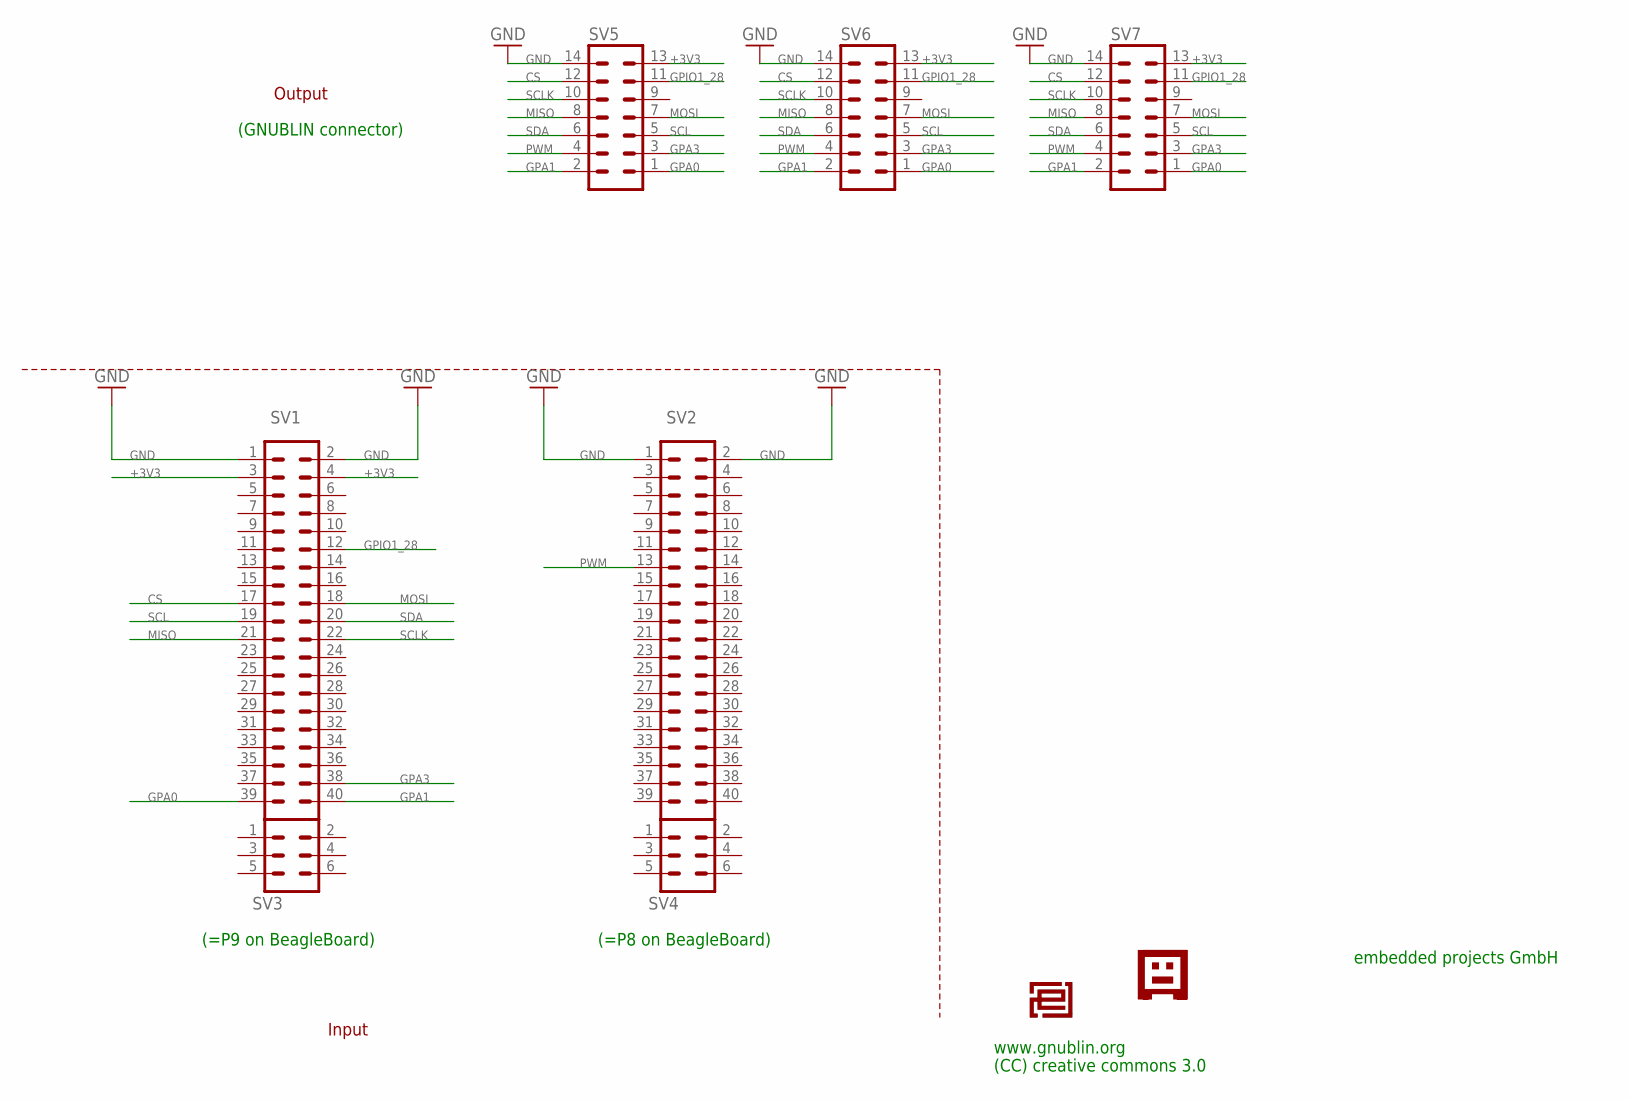
[picture p63: schematic MODUL_GNU-BO_BRIDGE_V101.sch]

Parts:
SV1, SV2: MA20-2
SV3, SV4: MA03-2
SV5, SV6, SV7: ML14
U$2: EPLOGOSIEB; EPLOGOSIEBDRUCK
U$3: GNUBLINLOGOSIEB; GNUSIEBDRUCK

Connections:
+3V3: SV1.3, SV1.4, SV5.13, SV6.13, SV7.13
CS: SV1.17, SV5.12, SV6.12, SV7.12
GND: SV1.1, SV1.2, SV2.1, SV2.2, SV5.14, SV6.14, SV7.14
GPA0: SV1.39, SV5.1, SV6.1, SV7.1
GPA1: SV1.40, SV5.2, SV6.2, SV7.2
GPA3: SV1.38, SV5.3, SV6.3, SV7.3
GPIO1_28: SV1.12, SV5.11, SV6.11, SV7.11
MISO: SV1.21, SV5.8, SV6.8, SV7.8
MOSI: SV1.18, SV5.7, SV6.7, SV7.7
PWM: SV2.13, SV5.4, SV6.4, SV7.4
SCL: SV1.19, SV5.5, SV6.5, SV7.5
SCLK: SV1.22, SV5.10, SV6.10, SV7.10
SDA: SV1.20, SV5.6, SV6.6, SV7.6

Notes on the sheet:
embedded projects GmbH
Input
Output
(=P9 on BeagleBoard)
(=P8 on BeagleBoard)
(GNUBLIN connector)
(CC) creative commons 3.0
www.gnublin.org

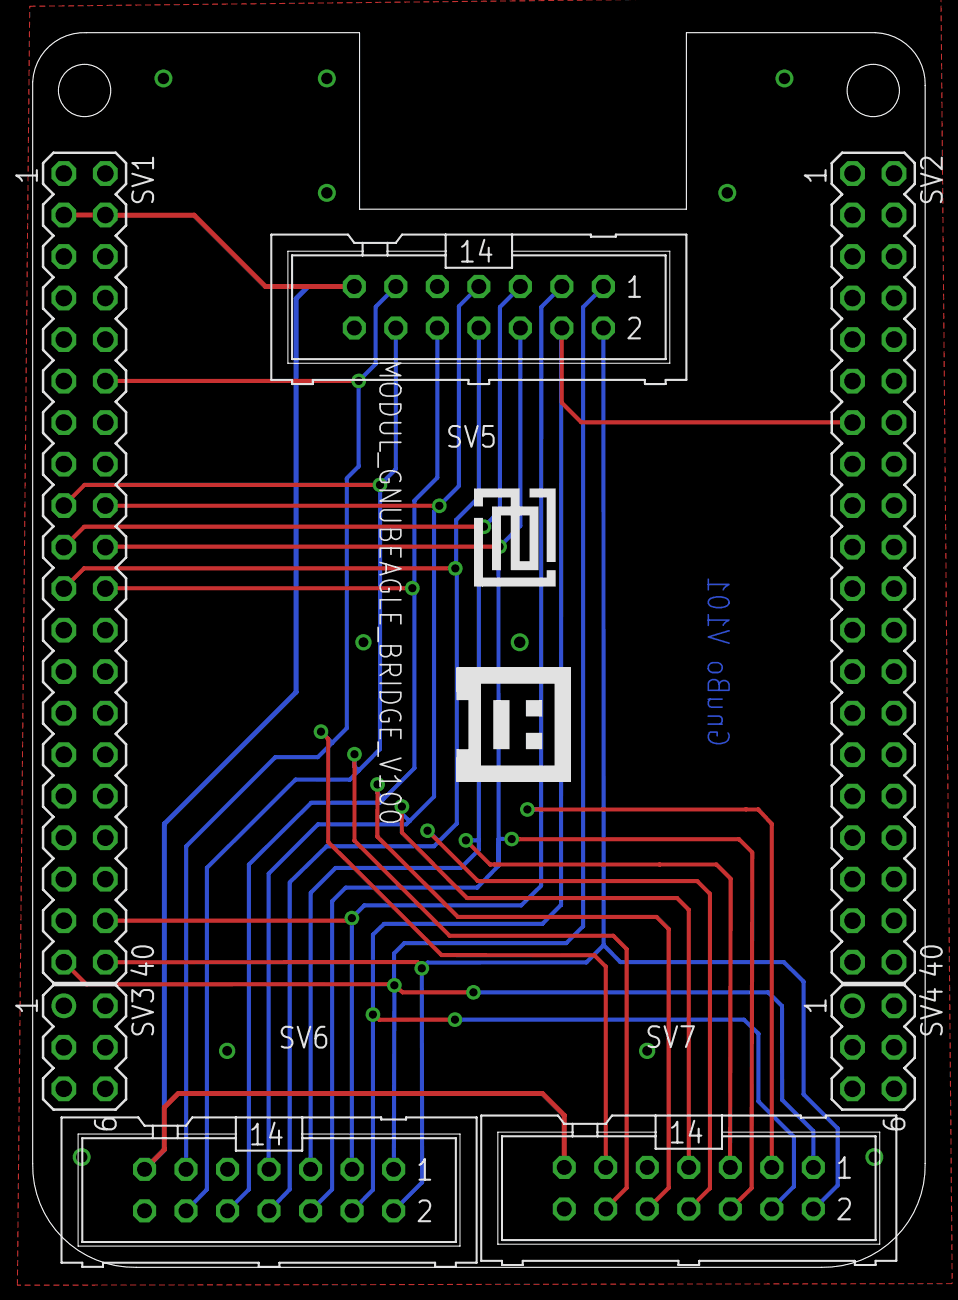
[picture p64: board MODUL_GNU-BO_BRIDGE_V101.brd from above]

Board: 2 copper layers, 54.6 x 75.5 mm, 9 parts (0 on the bottom side), 13 nets.
