embeddedprojects/gnublin-schematics/Module-Extension/Module-Extension_V101.brd

## EAGLE design Module-Extension/Module-Extension_V101.brd (2014-03-18)

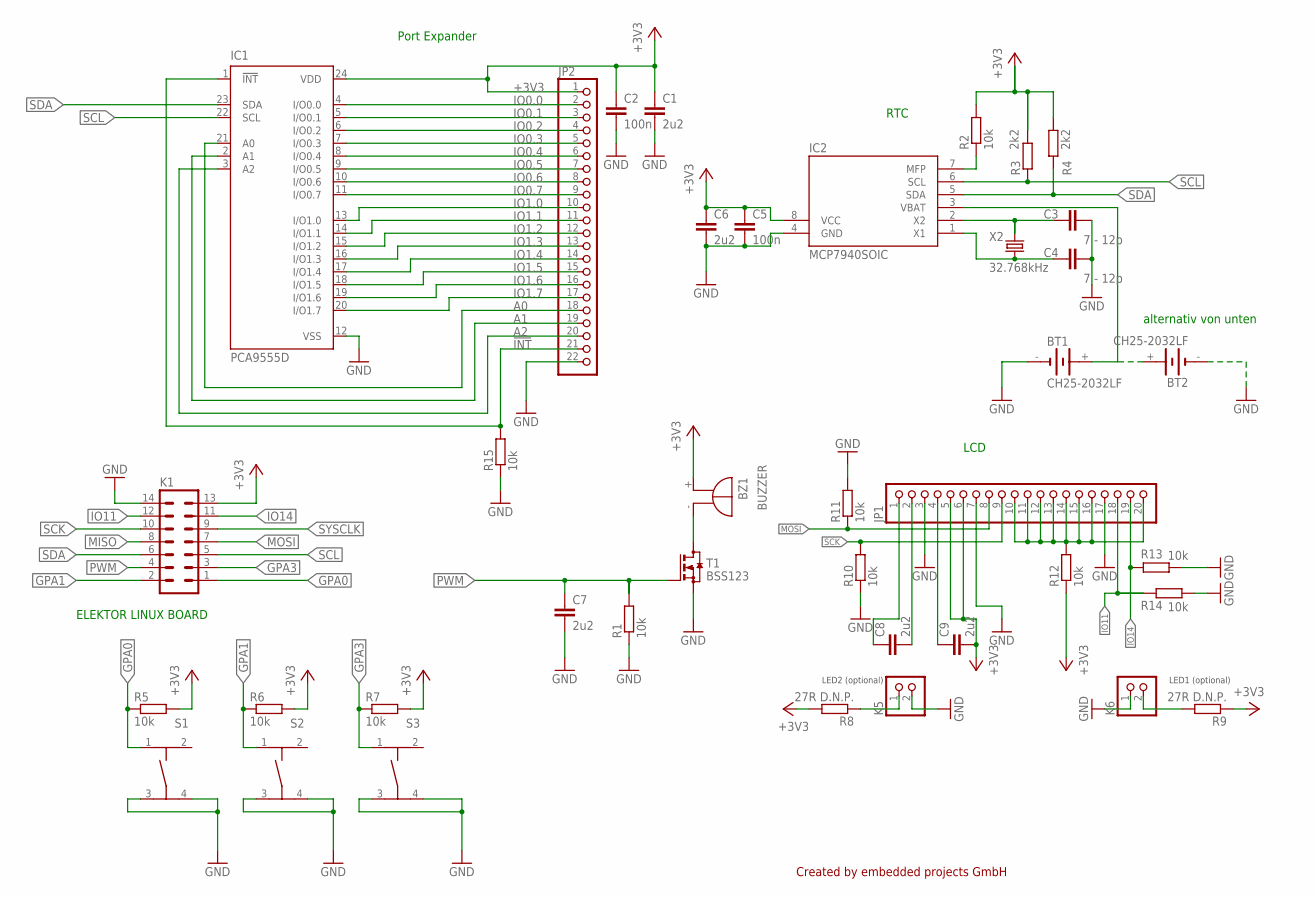
[picture p65: schematic Module-Extension_V101.sch, sheet 1]

Parts:
BT1, BT2: CH25-2032LF; CH25; FARNELL 2064715
BZ1: BUZZER; F/TMB
C1, C6, C7, C8, C9: 2u2; C0805
C2, C5: 100n; C0805
C3, C4: 7 - 12p; C0805
IC1: PCA9555D; SO24
IC2: MCP7940SOIC; SOIC-8
JP1: PINHD-1X20; 1X20
JP2: PINHD-1X22; 1X22
K1: ML14
K5, K6: PINHD-1X2; 1X02
R1, R2, R5, R6, R7, R10, R11, R12, R13, R14, R15: 10k; R0805
R3, R4: 2k2; R0805
R8, R9: 27R D.N.P.; R0805
S1, S2, S3: ERGAENZUNG_TASTER-9314_SMD
T1: BSS123; SOT23
X2: 32.768kHz; TC26H

Connections:
!INT: IC1.1 (!INT), JP2.21, R15.2
+3V3: BZ1.+, C1.1, C2.1, C5.1, C6.1, C9.2, IC1.24 (VDD), IC2.8 (VCC), JP1.5, JP1.6, JP2.1, K1.13, R2.2, R3.2, R4.2, R5.2, R6.2, R7.2, R8.2, R9.1, R12.1; also elsewhere on the board
A0: IC1.21 (A0), JP2.18
A1: IC1.2 (A1), JP2.19
A2: IC1.3 (A2), JP2.20
GND: BT1.-, BT2.-, C1.2, C2.2, C3.2, C4.2, C5.2, C6.2, C7.2, IC1.12 (VSS), IC2.4 (GND), JP1.3, JP1.7, JP1.17, JP2.22, K1.14, K5.2, K6.1, R1.1, R10.1, R11.2, R13.1, R14.1, R15.1, S1.3, S1.4, S2.3, S2.4, S3.3, S3.4, T1.2 (S); also elsewhere on the board
GPA0: K1.1, R5.1, S1.1
GPA1: K1.2, R6.1, S2.1
GPA3: K1.3, R7.1, S3.1
IO0.0: IC1.4 (I/O0.0), JP2.2
IO0.1: IC1.5 (I/O0.1), JP2.3
IO0.2: IC1.6 (I/O0.2), JP2.4
IO0.3: IC1.7 (I/O0.3), JP2.5
IO0.4: IC1.8 (I/O0.4), JP2.6
IO0.5: IC1.9 (I/O0.5), JP2.7
IO0.6: IC1.10 (I/O0.6), JP2.8
IO0.7: IC1.11 (I/O0.7), JP2.9
IO1.0: IC1.13 (I/O1.0), JP2.10
IO1.1: IC1.14 (I/O1.1), JP2.11
IO1.2: IC1.15 (I/O1.2), JP2.12
IO1.3: IC1.16 (I/O1.3), JP2.13
IO1.4: IC1.17 (I/O1.4), JP2.14
IO1.5: IC1.18 (I/O1.5), JP2.15
IO1.6: IC1.19 (I/O1.6), JP2.16
IO1.7: IC1.20 (I/O1.7), JP2.17
IO11: JP1.18, K1.12, R14.2
IO14: JP1.19, K1.11, R13.2
MISO: K1.8
MOSI: JP1.8, K1.7, R11.1
unnamed: C8.1, JP1.1
unnamed: BZ1.-, T1.3 (D)
unnamed: IC2.7 (MFP), R2.1
unnamed: C3.1, IC2.2 (X2), X2.1
unnamed: C8.2, JP1.2
unnamed: C9.1, JP1.4
unnamed: K5.1, R8.1
unnamed: K6.2, R9.2
unnamed: JP1.10, JP1.11, JP1.12, JP1.13, JP1.14, JP1.15, JP1.16, JP1.20, R12.2
unnamed: C4.1, IC2.1 (X1), X2.2
PWM: C7.1, K1.4, R1.2, T1.1 (G)
SCK: JP1.9, K1.10, R10.2
SCL: IC1.22 (SCL), IC2.6 (SCL), K1.5, R3.1
SDA: IC1.23 (SDA), IC2.5 (SDA), K1.6, R4.1
SYSCLK: K1.9
VBAT: BT1.+, BT2.+, IC2.3 (VBAT)

Notes on the sheet:
LCD
Port Expander
RTC
ELEKTOR LINUX BOARD
LED1 (optional)
LED2 (optional)
Created by embedded projects GmbH
alternativ von unten

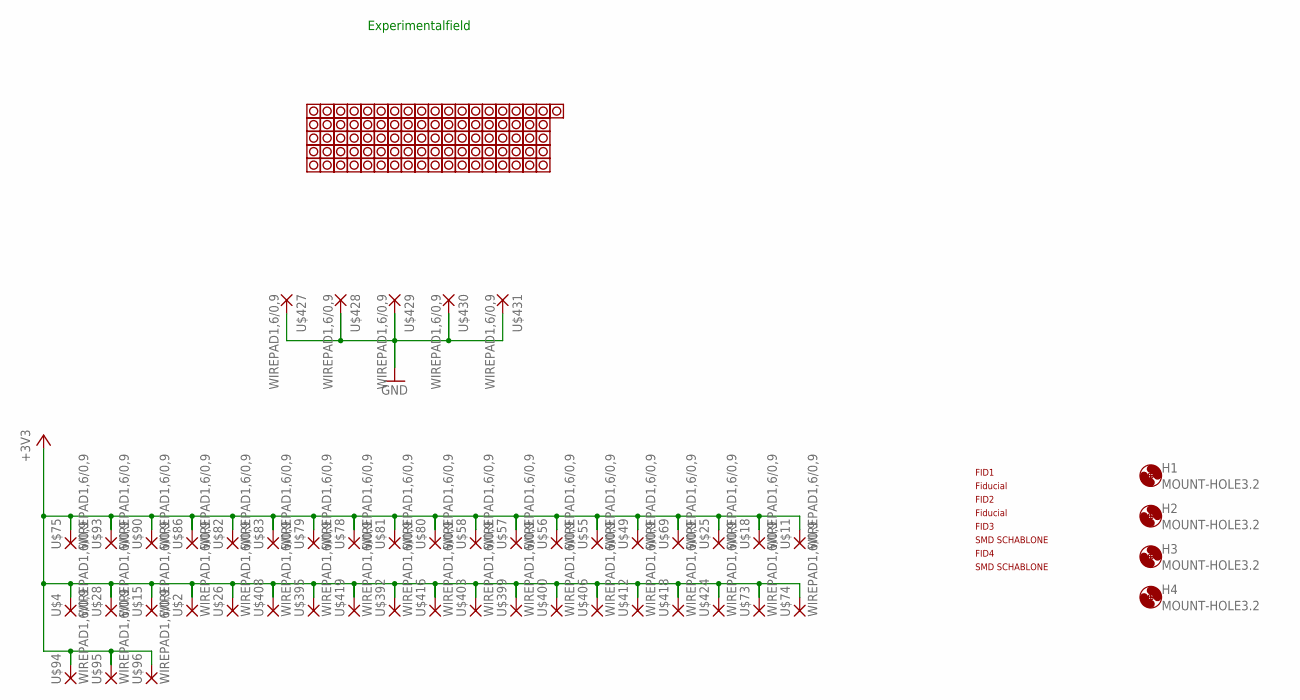
[picture p66: schematic Module-Extension_V101.sch, sheet 2]

Parts:
FID1, FID2, FID3, FID4: PASSERMARKEN_FIDUCIAL
H1, H2, H3, H4: MOUNT-HOLE3.2; 3,2
U$2, U$4, U$11, U$15, U$18, U$25, U$26, U$28, U$49, U$55, U$56, U$57, U$58, U$69, U$73, U$74, U$75, U$78, U$79, U$80, U$81, U$82, U$83, U$86, U$90, U$93, U$94, U$95, U$96, U$392, U$395, U$399, U$400, U$403, U$406, U$408, U$412, U$416, U$418, U$419, U$424, U$427, U$428, U$429, U$430, U$431: WIREPAD1,6/0,9; 1,6/0,9
U$3, U$5, U$6, U$7, U$8, U$9, U$10, U$12, U$13, U$14, U$16, U$17, U$19, U$20, U$21, U$22, U$23, U$24, U$27, U$29, U$30, U$31, U$32, U$33, U$34, U$35, U$36, U$37, U$38, U$39, U$40, U$41, U$42, U$43, U$44, U$45, U$46, U$47, U$48, U$50, U$51, U$52, U$53, U$54, U$59, U$60, U$61, U$62, U$63, U$64, U$65, U$66, U$67, U$68, U$70, U$71, U$72, U$76, U$77, U$84, U$85, U$87, U$88, U$89, U$91, U$92, U$391, U$393, U$394, U$396, U$397, U$398, U$401, U$402, U$404, U$405, U$407, U$409, U$410, U$411, U$413, U$414, U$415, U$417, U$420, U$421, U$422, U$423, U$425, U$426, U$432: VIAS

Connections:
+3V3: U$2.1, U$4.1, U$11.1, U$15.1, U$18.1, U$25.1, U$26.1, U$28.1, U$49.1, U$55.1, U$56.1, U$57.1, U$58.1, U$69.1, U$73.1, U$74.1, U$75.1, U$78.1, U$79.1, U$80.1, U$81.1, U$82.1, U$83.1, U$86.1, U$90.1, U$93.1, U$94.1, U$95.1, U$96.1, U$392.1, U$395.1, U$399.1, U$400.1, U$403.1, U$406.1, U$408.1, U$412.1, U$416.1, U$418.1, U$419.1, U$424.1; also elsewhere on the board
GND: U$427.1, U$428.1, U$429.1, U$430.1, U$431.1; also elsewhere on the board

Notes on the sheet:
Experimentalfield

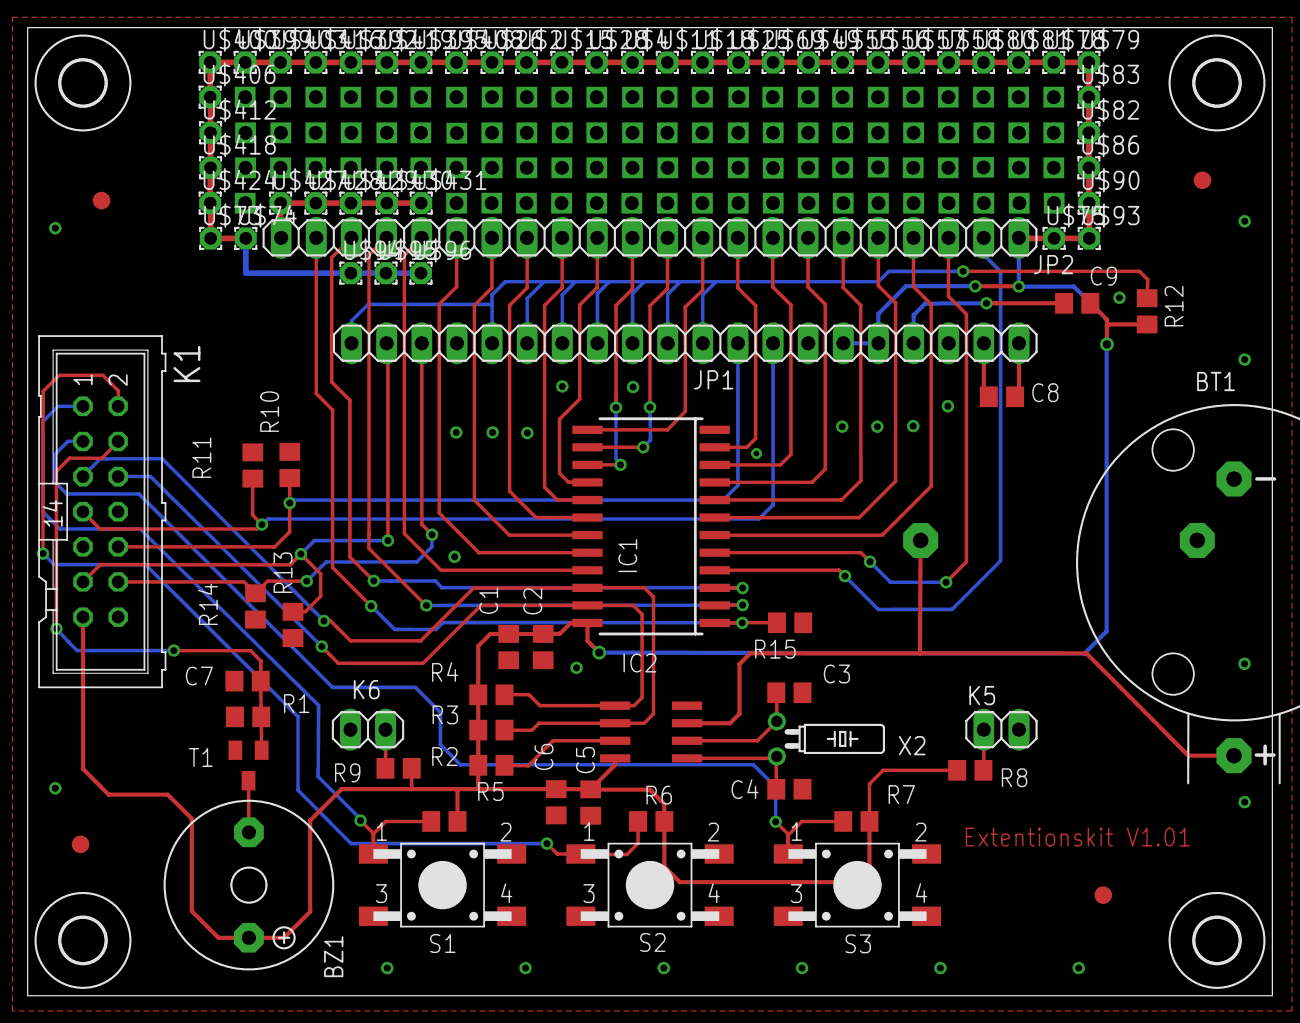
[picture p67: board Module-Extension_V101.brd from above]

Board: 2 copper layers, 90.0 x 70.0 mm, 184 parts (1 on the bottom side), 43 nets.
