embeddedprojects/gnublin-schematics/Module-Bridge/MODUL_BRIDGE_V100.brd

## EAGLE design Module-Bridge/MODUL_BRIDGE_V100.brd (2014-03-18)

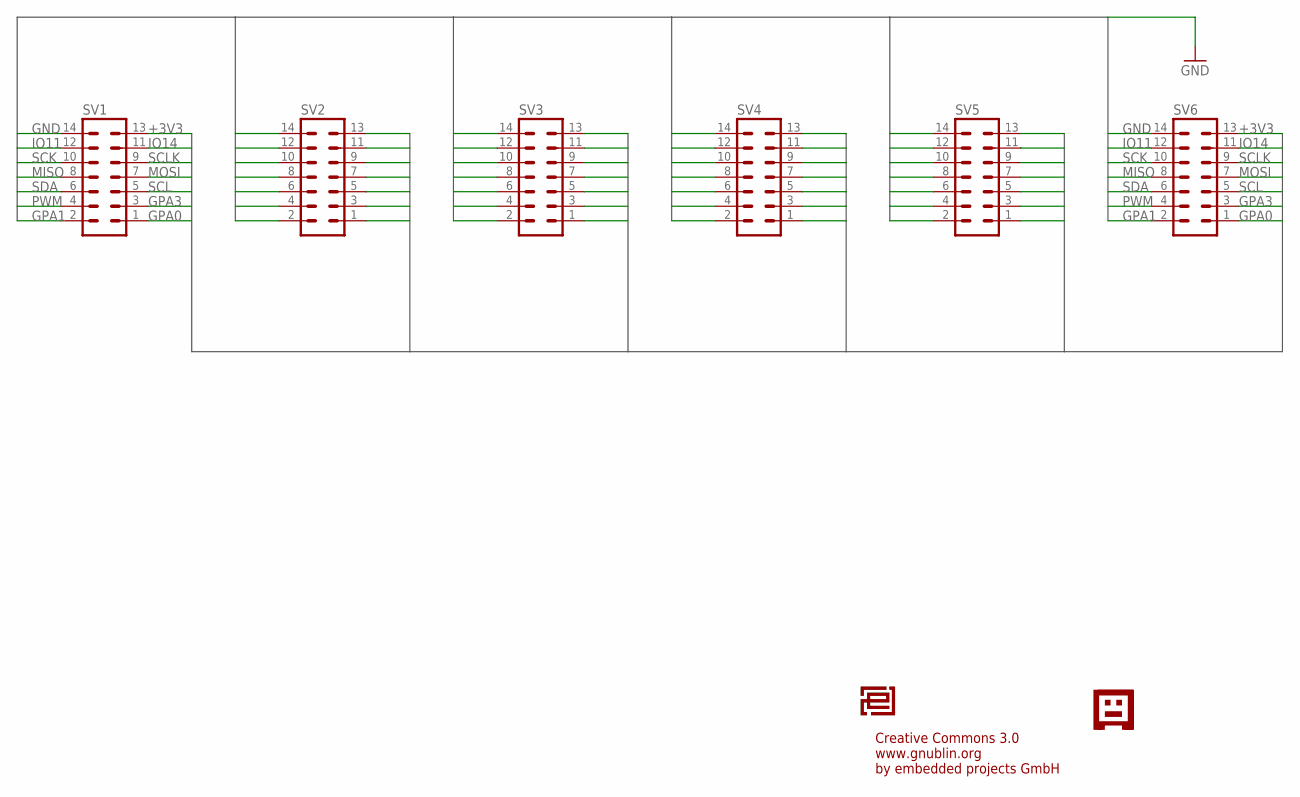
[picture p68: schematic MODUL_BRIDGE_V100.sch]

Parts:
SV1, SV2, SV3, SV4, SV5, SV6: ML14
U$1: EPLOGOSIEB; EPLOGOSIEBDRUCK
U$2: GNUBLINLOGOSIEB; GNUSIEBDRUCK

Connections:
+3V3: SV1.13, SV2.13, SV3.13, SV4.13, SV5.13, SV6.13
GND: SV1.14, SV2.14, SV3.14, SV4.14, SV5.14, SV6.14
GPA0: SV1.1, SV2.1, SV3.1, SV4.1, SV5.1, SV6.1
GPA1: SV1.2, SV2.2, SV3.2, SV4.2, SV5.2, SV6.2
GPA3: SV1.3, SV2.3, SV3.3, SV4.3, SV5.3, SV6.3
IO11: SV1.12, SV2.12, SV3.12, SV4.12, SV5.12, SV6.12
IO14: SV1.11, SV2.11, SV3.11, SV4.11, SV5.11, SV6.11
MISO: SV1.8, SV2.8, SV3.8, SV4.8, SV5.8, SV6.8
MOSI: SV1.7, SV2.7, SV3.7, SV4.7, SV5.7, SV6.7
PWM: SV1.4, SV2.4, SV3.4, SV4.4, SV5.4, SV6.4
SCK: SV1.10, SV2.10, SV3.10, SV4.10, SV5.10, SV6.10
SCL: SV1.5, SV2.5, SV3.5, SV4.5, SV5.5, SV6.5
SCLK: SV1.9, SV2.9, SV3.9, SV4.9, SV5.9, SV6.9
SDA: SV1.6, SV2.6, SV3.6, SV4.6, SV5.6, SV6.6

Notes on the sheet:
Creative Commons 3.0 www.gnublin.org by embedded projects GmbH
