embeddedprojects/gnublin-schematics/Module-Bridge/MODUL_BRIDGE_V100.brd

## EAGLE design Module-Bridge/MODUL_BRIDGE_V100.brd (continued)

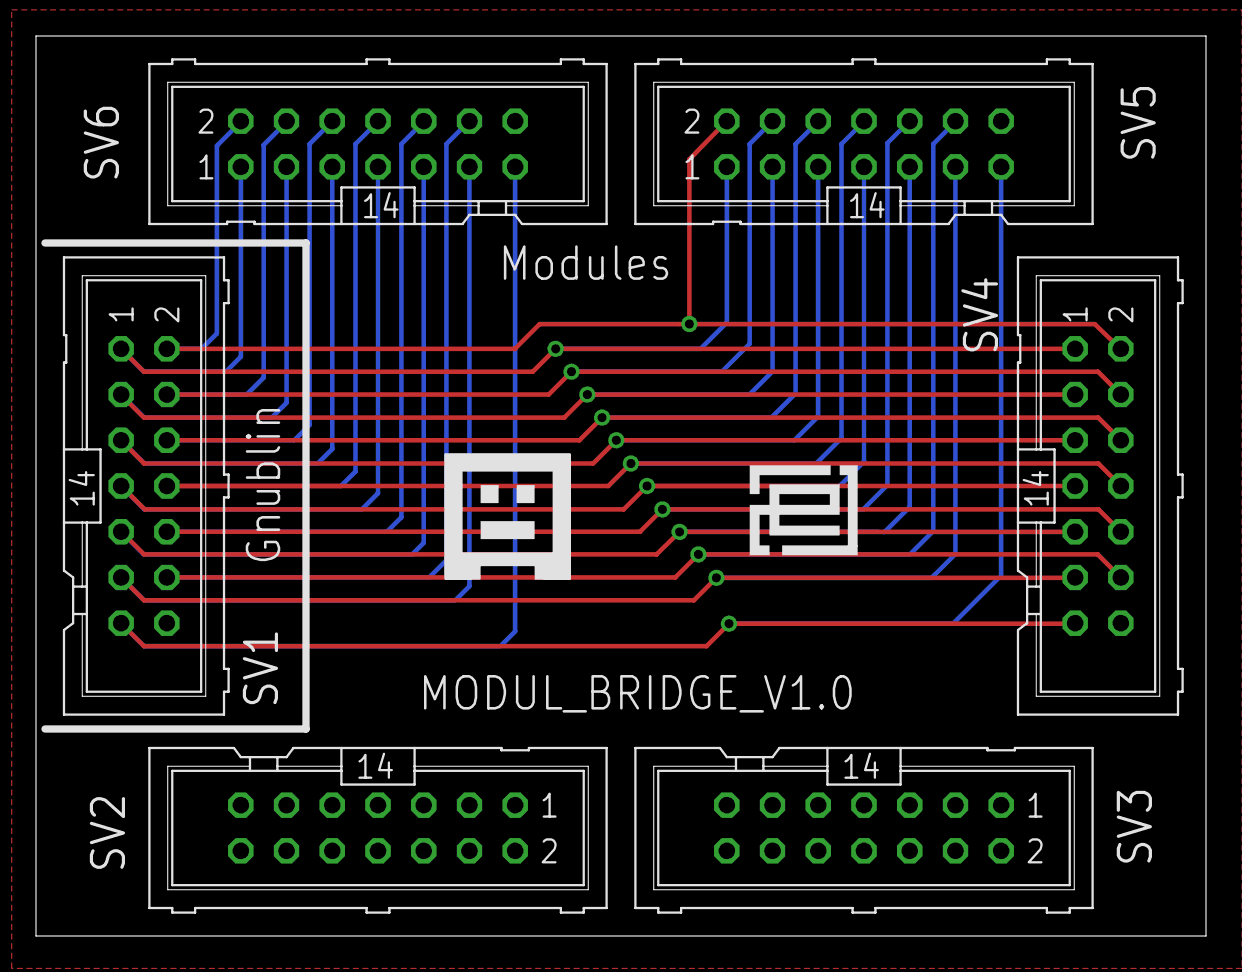
[picture p69: board MODUL_BRIDGE_V100.brd from above]

Board: 4 copper layers, 65.0 x 50.0 mm, 8 parts (0 on the bottom side), 14 nets.
