embeddedprojects/gnublin-schematics/Module-LCD/MODUL_LCD_V100.brd

## EAGLE design Module-LCD/MODUL_LCD_V100.brd (2014-03-18)

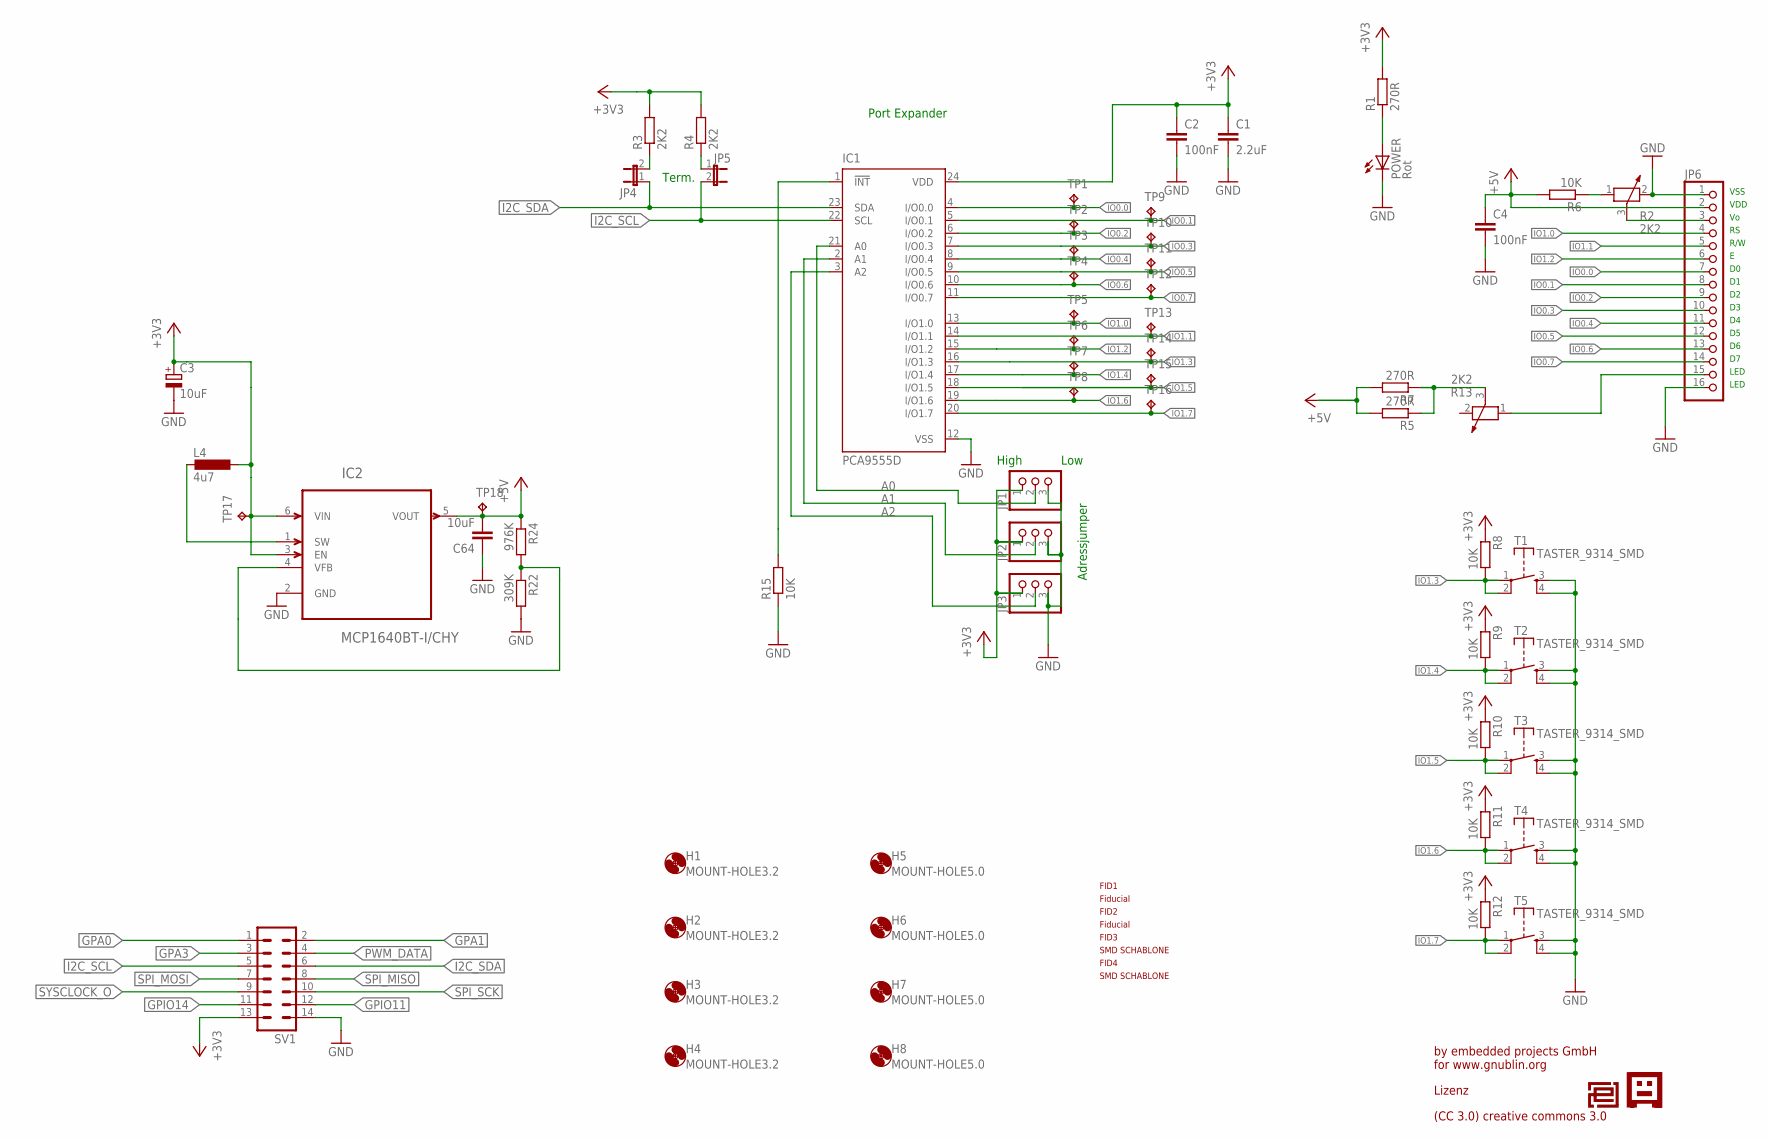
[picture p70: schematic MODUL_LCD_V100.sch]

Parts:
C1: 2.2uF; C0805
C2, C4: 100nF; C0805
C3: 10uF; SMC_D
C64: 10uF; C0805
FID1, FID2, FID3, FID4: PASSERMARKEN_FIDUCIAL
H1, H2, H3, H4: MOUNT-HOLE3.2; 3,2
H5, H6, H7, H8: MOUNT-HOLE5.0; 5,0
IC1: PCA9555D; SO24
IC2: MCP1640BT-I/CHY; SOT95P270X145-6N
JP1, JP2, JP3: PINHD-1X3; 1X03
JP4, JP5: JP1E; JP1
JP6: PINHD-1X16; 1X16
L4: 4u7; PSU3014
POWER: Rot; CHIP-LED0805
R1, R5, R7: 270R; R0805
R2, R13: 2K2; PT-10
R3, R4: 2K2; R0805
R6, R8, R9, R10, R11, R12, R15: 10K; R0805
R22: 309K; R0805
R24: 976K; R0805
SV1: ML14
T1, T2, T3, T4, T5: TASTER_9314_SMD; TASTER-9314_SMD
TP1, TP2, TP3, TP4, TP5, TP6, TP7, TP8, TP9, TP10, TP11, TP12, TP13, TP14, TP15, TP16, TP17, TP18: TPB1,27; B1,27
U$1: EPLOGOSIEB; EPLOGOSIEBDRUCK
U$2: GNUBLINLOGOSIEB; GNUSIEBDRUCK

Connections:
!INT: IC1.1 (!INT), R15.2
+3V3: C1.1, C2.1, C3.+, IC1.24 (VDD), IC2.3 (EN), IC2.6 (VIN), JP1.1, JP2.1, JP3.1, L4.2, R1.2, R3.2, R4.2, R8.1, R9.1, R10.1, R11.1, R12.1, SV1.13, TP17.TP
+5V: C4.1, C64.2, IC2.5 (VOUT), JP6.2, R5.2, R6.2, R7.2, R24.1, TP18.TP
A0: IC1.21 (A0), JP1.2
A1: IC1.2 (A1), JP2.2
A2: IC1.3 (A2), JP3.2
ENABLE_5V: IC2.1 (SW), L4.1
GND: C1.2, C2.2, C3.-, C4.2, C64.1, IC1.12 (VSS), IC2.2 (GND), JP1.3, JP2.3, JP3.3, JP6.1, JP6.16, POWER.C, R2.2, R15.1, R22.2, SV1.14, T1.3 (S), T1.4 (S), T2.3 (S), T2.4 (S), T3.3 (S), T3.4 (S), T4.3 (S), T4.4 (S), T5.3 (S), T5.4 (S)
GPA0: SV1.1
GPA1: SV1.2
GPA3: SV1.3
GPIO11: SV1.12
GPIO14: SV1.11
I2C_SCL: IC1.22 (SCL), JP5.2, SV1.5
I2C_SDA: IC1.23 (SDA), JP4.1, SV1.6
IO0.0: IC1.4 (I/O0.0), JP6.7, TP1.TP
IO0.1: IC1.5 (I/O0.1), JP6.8, TP9.TP
IO0.2: IC1.6 (I/O0.2), JP6.9, TP2.TP
IO0.3: IC1.7 (I/O0.3), JP6.10, TP10.TP
IO0.4: IC1.8 (I/O0.4), JP6.11, TP3.TP
IO0.5: IC1.9 (I/O0.5), JP6.12, TP11.TP
IO0.6: IC1.10 (I/O0.6), JP6.13, TP4.TP
IO0.7: IC1.11 (I/O0.7), JP6.14, TP12.TP
IO1.0: IC1.13 (I/O1.0), JP6.4, TP5.TP
IO1.1: IC1.14 (I/O1.1), JP6.5, TP13.TP
IO1.2: IC1.15 (I/O1.2), JP6.6, TP6.TP
IO1.3: IC1.16 (I/O1.3), R8.2, T1.1, T1.2, TP14.TP
IO1.4: IC1.17 (I/O1.4), R9.2, T2.1, T2.2, TP7.TP
IO1.5: IC1.18 (I/O1.5), R10.2, T3.1, T3.2, TP15.TP
IO1.6: IC1.19 (I/O1.6), R11.2, T4.1, T4.2, TP8.TP
IO1.7: IC1.20 (I/O1.7), R12.2, T5.1, T5.2, TP16.TP
unnamed: JP4.2, R3.1
unnamed: POWER.A, R1.1
unnamed: R2.1, R6.1
unnamed: JP6.15, R13.1
unnamed: JP5.1, R4.1
unnamed: R5.1, R7.1, R13.3
unnamed: IC2.4 (VFB), R22.1, R24.2
PWM_DATA: SV1.4
SPI_MISO: SV1.8
SPI_MOSI: SV1.7
SPI_SCK: SV1.10
SYSCLOCK_O: SV1.9
VO: JP6.3, R2.3

Notes on the sheet:
Port Expander
Adressjumper
Term.
High
Low
by embedded projects GmbH for www.gnublin.org
Lizenz
(CC 3.0) creative commons 3.0
VSS
VDD
R/W
LED

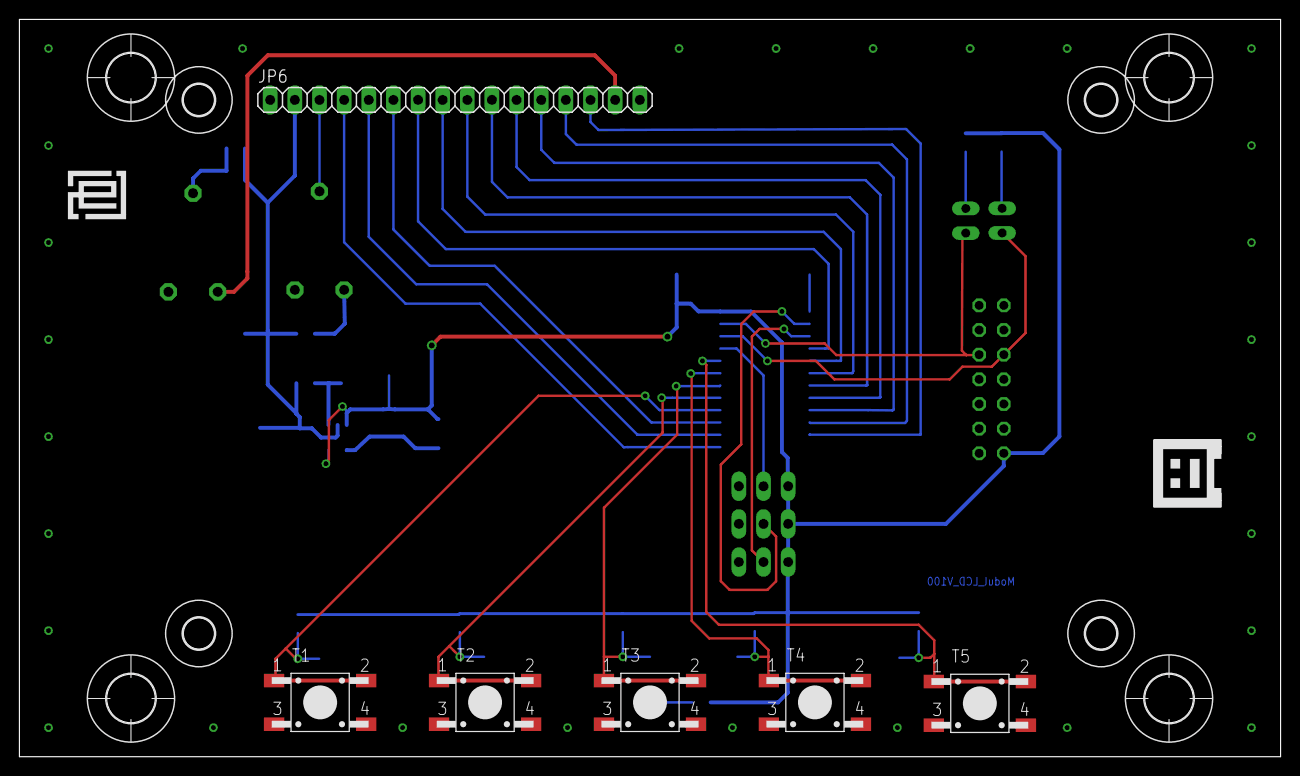
[picture p71: board MODUL_LCD_V100.brd from above]

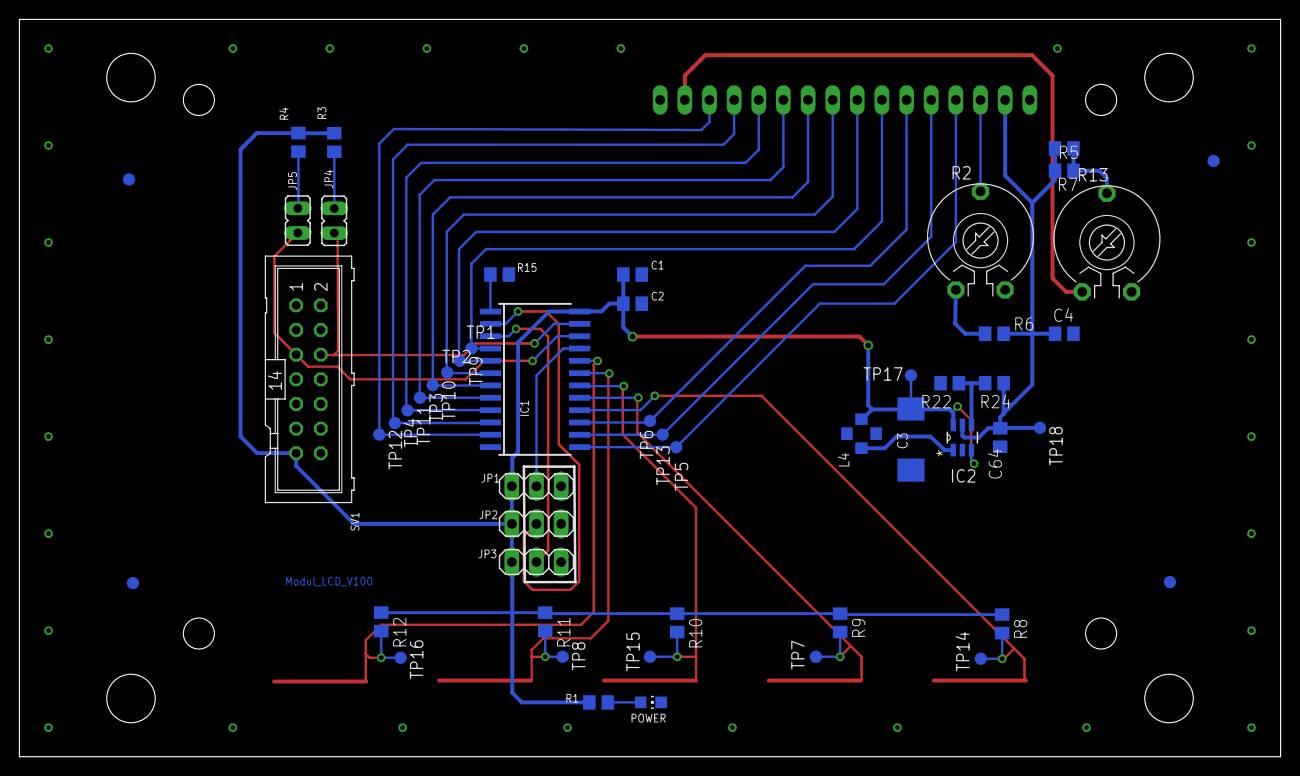
[picture p72: board MODUL_LCD_V100.brd from below]

Board: 2 copper layers, 130.0 x 76.0 mm, 69 parts (53 on the bottom side), 34 nets.
