embeddedprojects/gnublin-schematics/Module-RS232/MODUL_RS232_V101.brd

## EAGLE design Module-RS232/MODUL_RS232_V101.brd (2014-03-18)

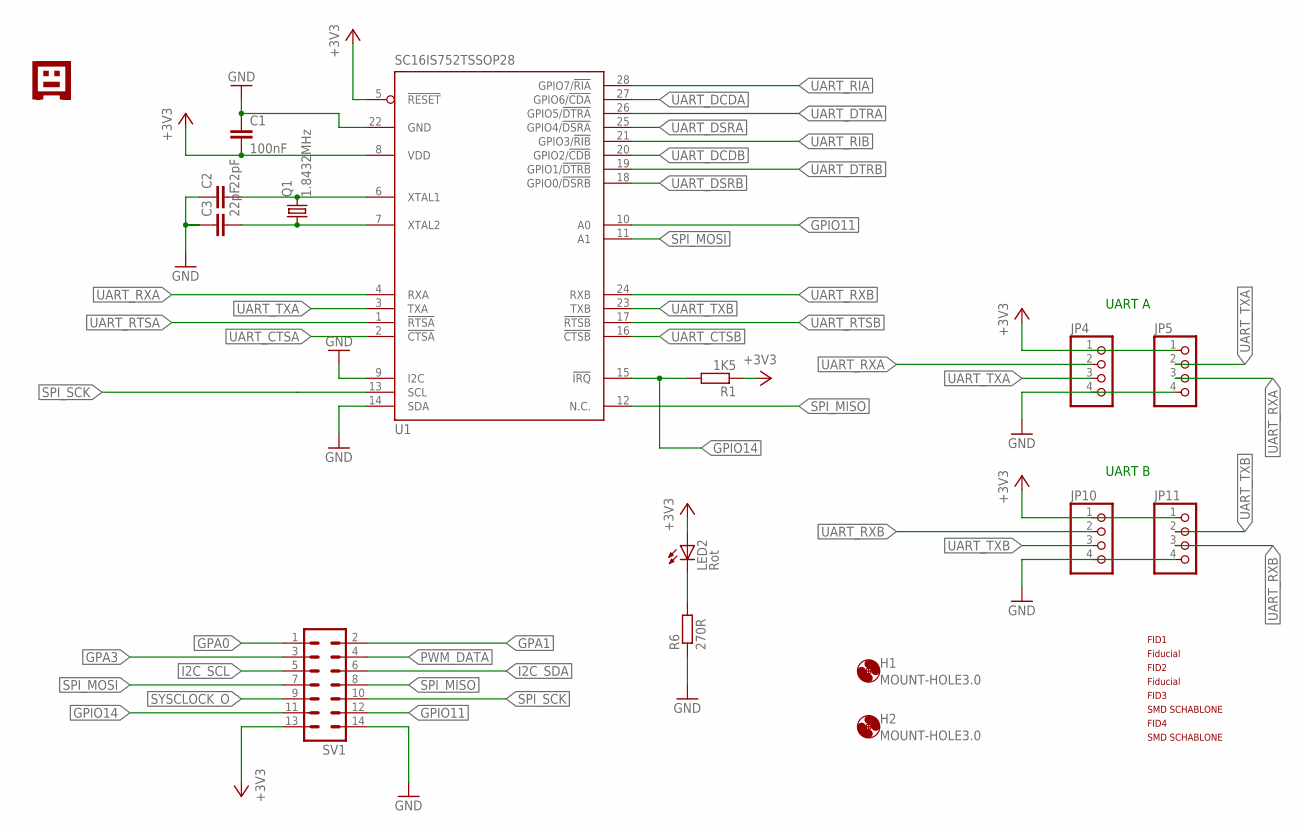
[picture p73: schematic MODUL_RS232_V101.sch, sheet 1]

Parts:
C1: 100nF; C0805
C2, C3: 22pF; C0805
FID1, FID2, FID3, FID4: PASSERMARKEN_FIDUCIAL
H1, H2: MOUNT-HOLE3.0; 3,0
JP4, JP5, JP10, JP11: PINHD-1X4; 1X04
LED2: Rot; CHIP-LED0805
Q1: 1.8432MHz; HC49UP
R1: 1K5; R0805
R6: 270R; R0805
SV1: ML14
U1: SC16IS752TSSOP28; TSSOP28; FARNELL 2101309
U$2: GNUBLINLOGOSIEB; GNUSIEBDRUCK

Connections:
+3V3: C1.2, JP4.1, JP5.1, JP10.1, JP11.1, LED2.A, R1.1, SV1.13, U1.5 (!RESET), U1.8 (VDD); also elsewhere on the board
GND: C1.1, C2.1, C3.1, JP4.4, JP5.4, JP10.4, JP11.4, R6.1, SV1.14, U1.9 (I2C), U1.14 (SDA), U1.22 (GND); also elsewhere on the board
GPA0: SV1.1
GPA1: SV1.2
GPA3: SV1.3
GPIO11: SV1.12, U1.10 (A0)
GPIO14: R1.2, SV1.11, U1.15 (!IRQ)
I2C_SCL: SV1.5
I2C_SDA: SV1.6
unnamed: C2.2, Q1.2, U1.6 (XTAL1)
unnamed: C3.2, Q1.1, U1.7 (XTAL2)
unnamed: LED2.C, R6.2
PWM_DATA: SV1.4
SPI_MISO: SV1.8, U1.12 (N.C.)
SPI_MOSI: SV1.7, U1.11 (A1)
SPI_SCK: SV1.10, U1.13 (SCL)
SYSCLOCK_O: SV1.9
UART_CTSA: U1.2 (!CTSA); also elsewhere on the board
UART_CTSB: U1.16 (!CTSB); also elsewhere on the board
UART_DCDA: U1.27 (GPIO6/!CDA); also elsewhere on the board
UART_DCDB: U1.20 (GPIO2/!CDB); also elsewhere on the board
UART_DSRA: U1.25 (GPIO4/!DSRA); also elsewhere on the board
UART_DSRB: U1.18 (GPIO0/!DSRB); also elsewhere on the board
UART_DTRA: U1.26 (GPIO5/!DTRA); also elsewhere on the board
UART_DTRB: U1.19 (GPIO1/!DTRB); also elsewhere on the board
UART_RIA: U1.28 (GPIO7/!RIA); also elsewhere on the board
UART_RIB: U1.21 (GPIO3/!RIB); also elsewhere on the board
UART_RTSA: U1.1 (!RTSA); also elsewhere on the board
UART_RTSB: U1.17 (!RTSB); also elsewhere on the board
UART_RXA: JP4.2, JP5.3, U1.4 (RXA); also elsewhere on the board
UART_RXB: JP10.2, JP11.3, U1.24 (RXB); also elsewhere on the board
UART_TXA: JP4.3, JP5.2, U1.3 (TXA); also elsewhere on the board
UART_TXB: JP10.3, JP11.2, U1.23 (TXB); also elsewhere on the board

Notes on the sheet:
UART A
UART B

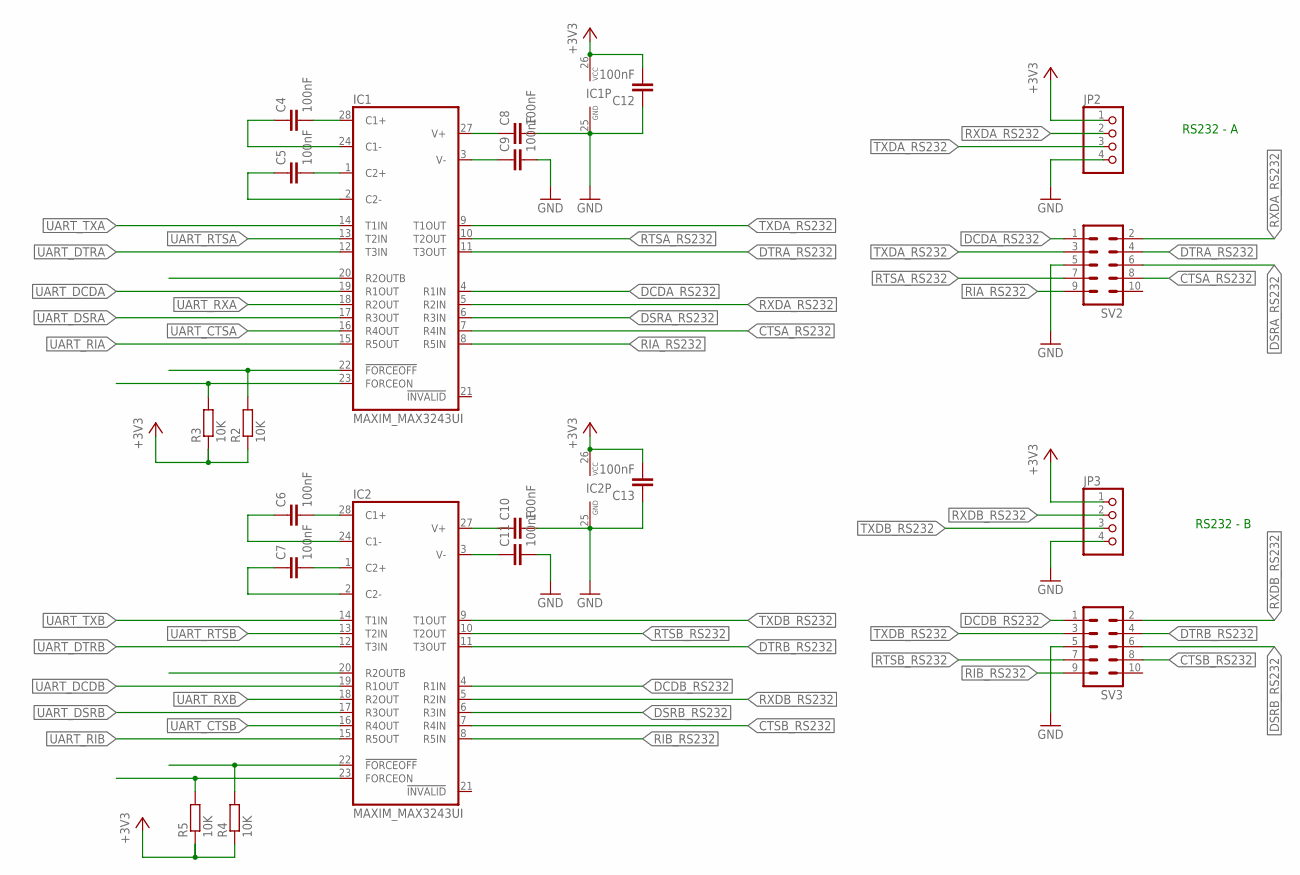
[picture p74: schematic MODUL_RS232_V101.sch, sheet 2]

Parts:
C4, C5, C6, C7, C8, C9, C10, C11, C12, C13: 100nF; C0805
IC1, IC2: MAXIM_MAX3243UI; MAXIM_TSSOP28
JP2, JP3: PINHD-1X4; 1X04
R2, R3, R4, R5: 10K; R0805
SV2, SV3: ML10

Connections:
+3V3: C12.2, C13.2, IC1.26 (VCC), IC2.26 (VCC), JP2.1, JP3.1, R2.1, R3.1, R4.1, R5.1; also elsewhere on the board
CTSA_RS232: IC1.7 (R4IN), SV2.8
CTSB_RS232: IC2.7 (R4IN), SV3.8
DCDA_RS232: IC1.4 (R1IN), SV2.1
DCDB_RS232: IC2.4 (R1IN), SV3.1
DSRA_RS232: IC1.6 (R3IN), SV2.6
DSRB_RS232: IC2.6 (R3IN), SV3.6
DTRA_RS232: IC1.11 (T3OUT), SV2.4
DTRB_RS232: IC2.11 (T3OUT), SV3.4
GND: C8.2, C9.2, C10.2, C11.2, C12.1, C13.1, IC1.25 (GND), IC2.25 (GND), JP2.4, JP3.4, SV2.5, SV3.5; also elsewhere on the board
unnamed: C4.2, IC1.28 (C1+)
unnamed: C5.2, IC1.1 (C2+)
unnamed: C4.1, IC1.24 (C1-)
unnamed: C5.1, IC1.2 (C2-)
unnamed: C6.2, IC2.28 (C1+)
unnamed: C7.2, IC2.1 (C2+)
unnamed: C6.1, IC2.24 (C1-)
unnamed: C7.1, IC2.2 (C2-)
unnamed: C8.1, IC1.27 (V+)
unnamed: C9.1, IC1.3 (V-)
unnamed: C10.1, IC2.27 (V+)
unnamed: C11.1, IC2.3 (V-)
unnamed: IC1.22 (!FORCEOFF), R2.2
unnamed: IC1.23 (FORCEON), R3.2
unnamed: IC2.22 (!FORCEOFF), R4.2
unnamed: IC2.23 (FORCEON), R5.2
RIA_RS232: IC1.8 (R5IN), SV2.9
RIB_RS232: IC2.8 (R5IN), SV3.9
RTSA_RS232: IC1.10 (T2OUT), SV2.7
RTSB_RS232: IC2.10 (T2OUT), SV3.7
RXDA_RS232: IC1.5 (R2IN), JP2.2, SV2.2
RXDB_RS232: IC2.5 (R2IN), JP3.2, SV3.2
TXDA_RS232: IC1.9 (T1OUT), JP2.3, SV2.3
TXDB_RS232: IC2.9 (T1OUT), JP3.3, SV3.3
UART_CTSA: IC1.16 (R4OUT); also elsewhere on the board
UART_CTSB: IC2.16 (R4OUT); also elsewhere on the board
UART_DCDA: IC1.19 (R1OUT); also elsewhere on the board
UART_DCDB: IC2.19 (R1OUT); also elsewhere on the board
UART_DSRA: IC1.17 (R3OUT); also elsewhere on the board
UART_DSRB: IC2.17 (R3OUT); also elsewhere on the board
UART_DTRA: IC1.12 (T3IN); also elsewhere on the board
UART_DTRB: IC2.12 (T3IN); also elsewhere on the board
UART_RIA: IC1.15 (R5OUT); also elsewhere on the board
UART_RIB: IC2.15 (R5OUT); also elsewhere on the board
UART_RTSA: IC1.13 (T2IN); also elsewhere on the board
UART_RTSB: IC2.13 (T2IN); also elsewhere on the board
UART_RXA: IC1.18 (R2OUT); also elsewhere on the board
UART_RXB: IC2.18 (R2OUT); also elsewhere on the board
UART_TXA: IC1.14 (T1IN); also elsewhere on the board
UART_TXB: IC2.14 (T1IN); also elsewhere on the board

Notes on the sheet:
RS232 - A
RS232 - B

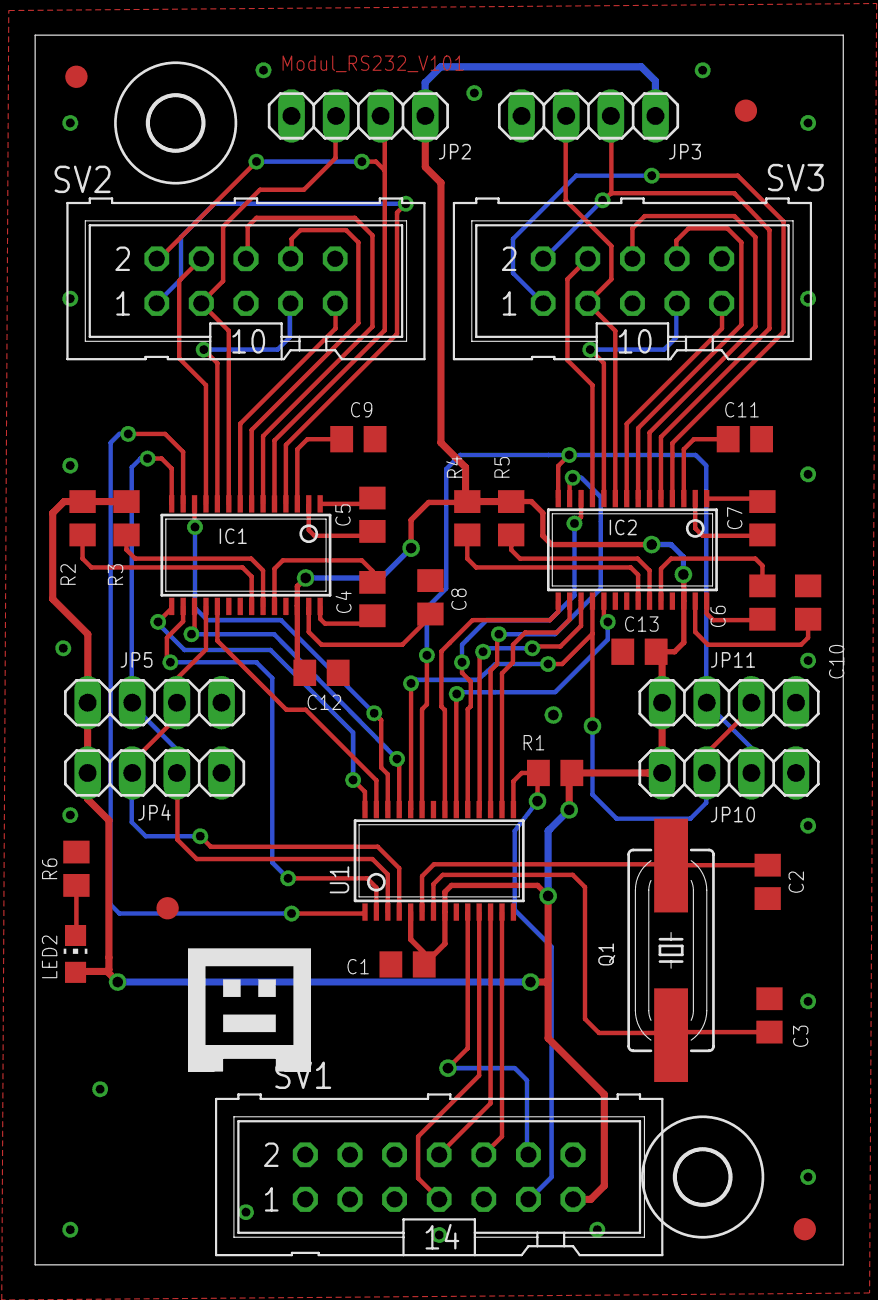
[picture p75: board MODUL_RS232_V101.brd from above]

Board: 2 copper layers, 46.0 x 70.0 mm, 40 parts (0 on the bottom side), 58 nets.
