embeddedprojects/gnublin-schematics/Board-EXTENDED/GNUBLIN_EXTENDED_V1_7.brd

## EAGLE design Board-EXTENDED/GNUBLIN_EXTENDED_V1_7.brd (2013-05-15)

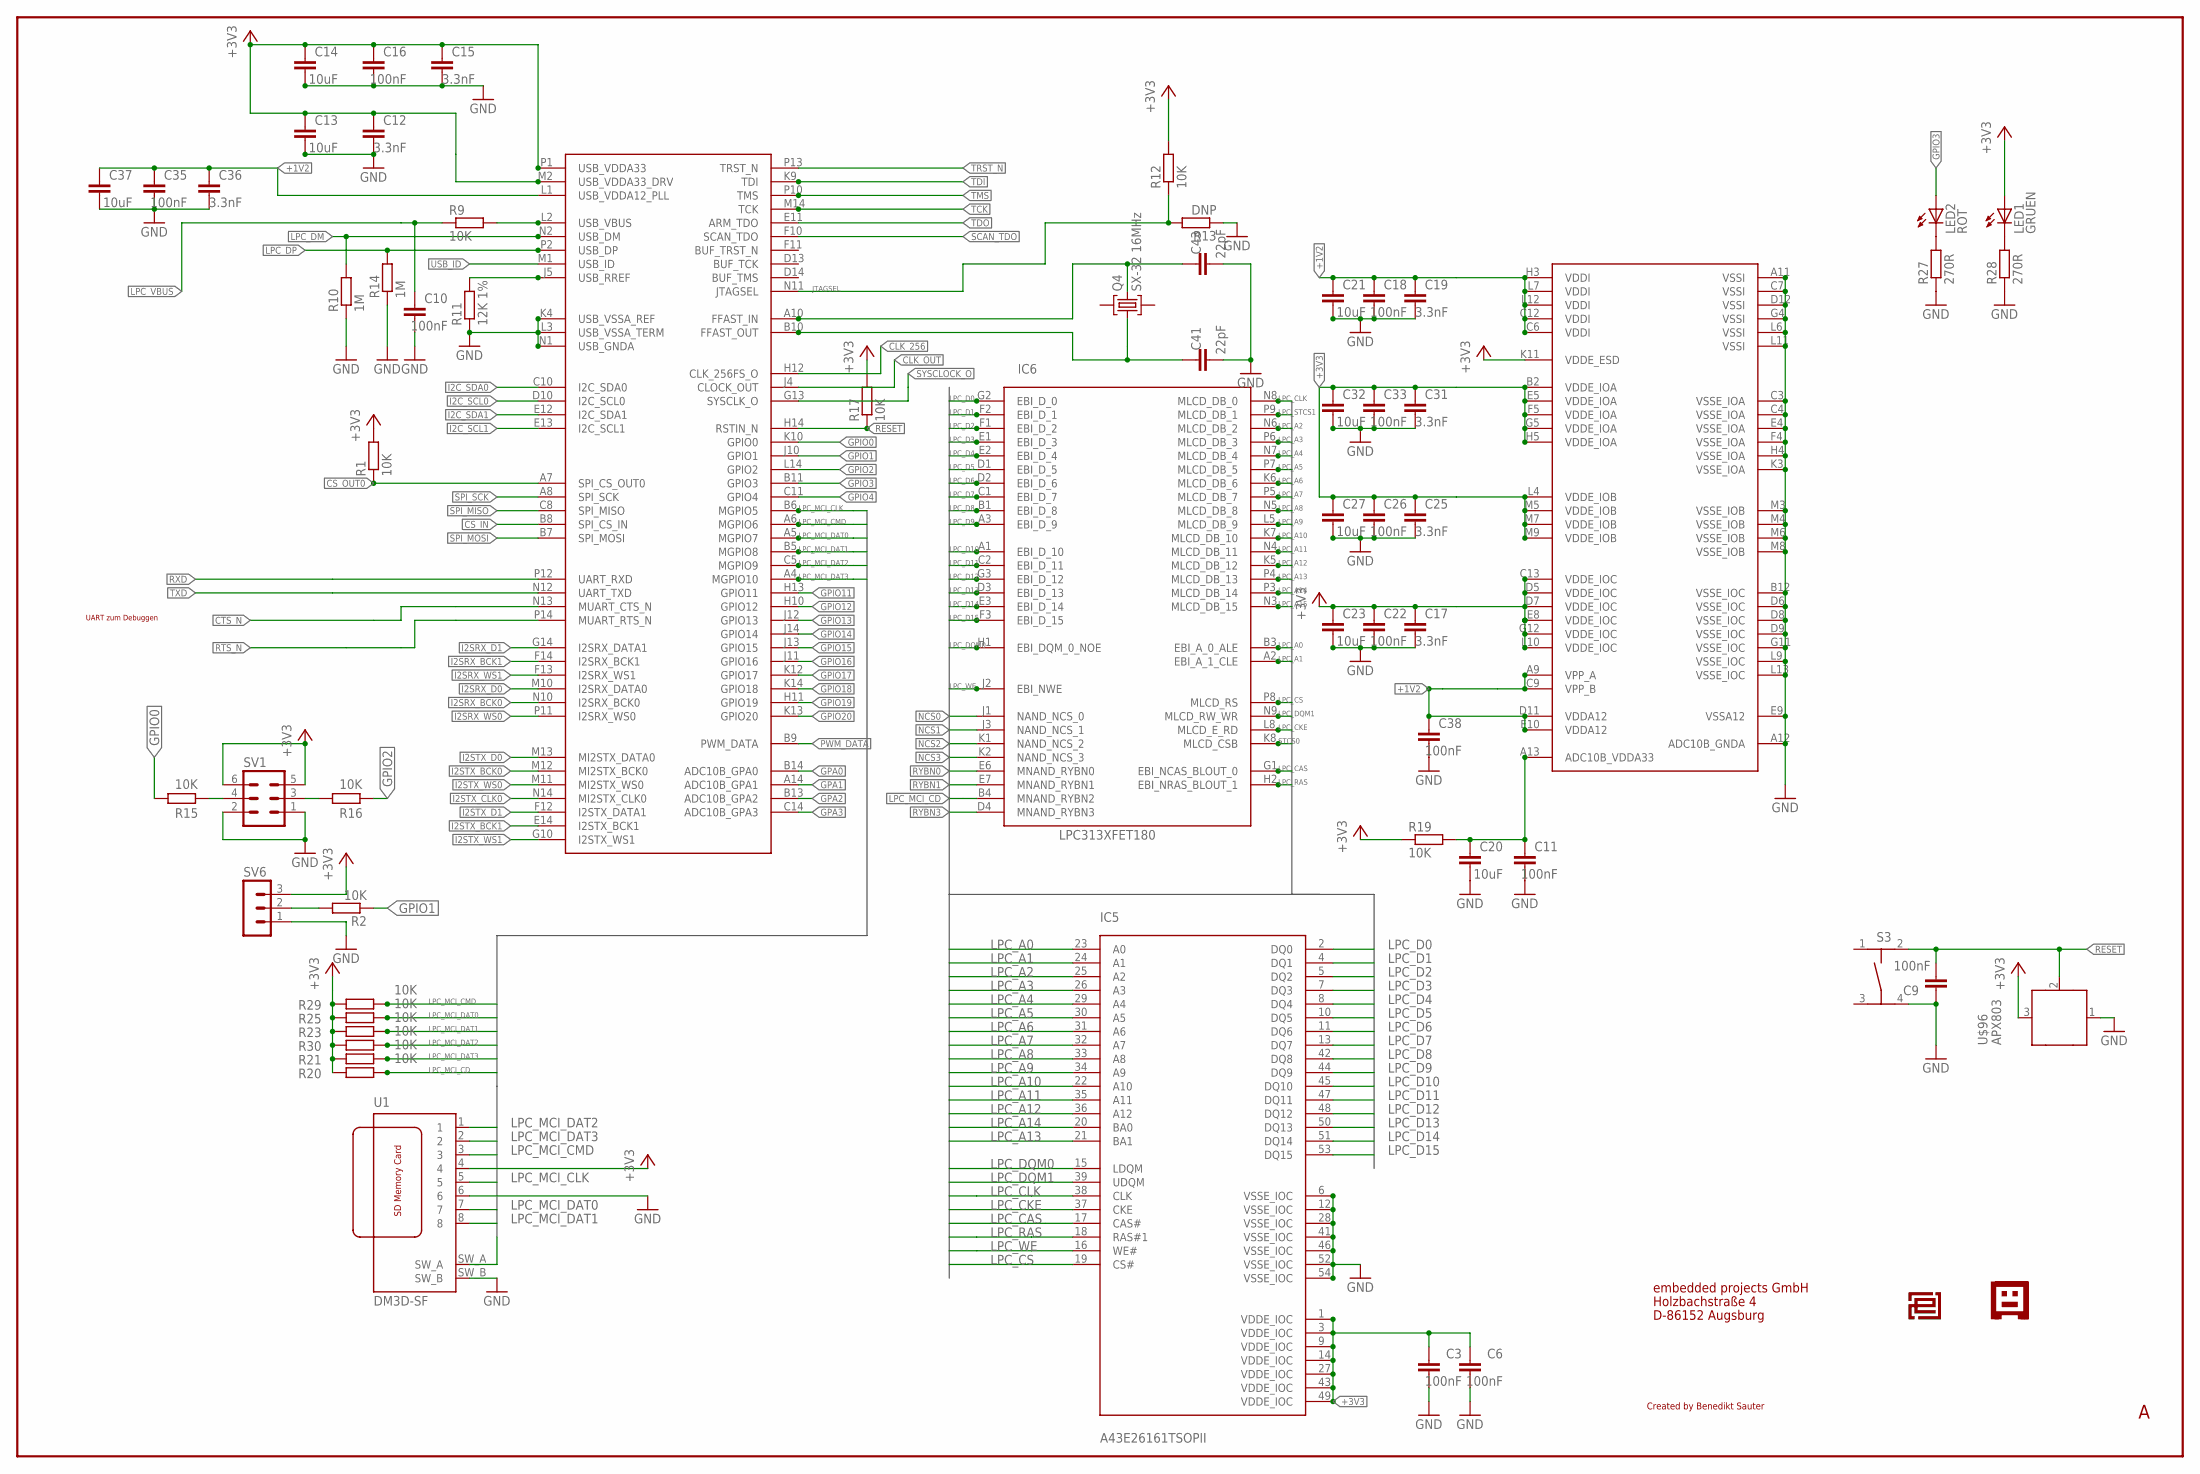
[picture p76: schematic GNUBLIN_EXTENDED_V1_7.sch, sheet 1]

Parts:
C3, C6, C9, C10, C11, C16, C18, C22, C26, C33, C35, C38: 100nF; C0805
C12, C15, C17, C19, C25, C31, C36: 3.3nF; C0805
C13, C14, C20, C21, C23, C27, C32, C37: 10uF; C0805
C41, C43: 22pF; C0805
IC5: A43E26161TSOPII; TSOPII
IC6: LPC313XFET180; TFBGA180
LED1: GRUEN; CHIP-LED0805
LED2: ROT; CHIP-LED0805
Q4: SX-32 16MHz; SX-32; FARNELL 1712841
R1, R2, R9, R12, R15, R16, R17, R19, R20, R21, R23, R25, R29, R30: 10K; R0805
R10, R14: 1M; R0805
R11: 12K 1%; R0805
R13: DNP; R0805
R27, R28: 270R; R0805
S3: TASTER-9314_SMD
SV1: MA03-2
SV6: MA03-1
U1: DM3D-SF
U$1: EPLOGOSIEB; EPLOGOSIEBDRUCK
U$2: GNUBLINLOGOSIEB; GNUSIEBDRUCK
U$96: APX803; SOT23

Connections:
+1V2: C18.2, C19.2, C21.2, C35.2, C36.2, C37.2, C38.2, IC6.A9 (VPP_A), IC6.C6 (VDDI), IC6.C9 (VPP_B), IC6.C12 (VDDI), IC6.D11 (VDDA12), IC6.E10 (VDDA12), IC6.H3 (VDDI), IC6.L1 (USB_VDDA12_PLL), IC6.L7 (VDDI), IC6.L12 (VDDI); also elsewhere on the board
+3V3: C3.2, C6.2, C12.2, C13.2, C14.2, C15.2, C16.2, C17.2, C22.2, C23.2, C25.2, C26.2, C27.2, C31.2, C32.2, C33.2, IC5.1 (VDDE_IOC), IC5.3 (VDDE_IOC), IC5.9 (VDDE_IOC), IC5.14 (VDDE_IOC), IC5.27 (VDDE_IOC), IC5.43 (VDDE_IOC), IC5.49 (VDDE_IOC), IC6.B2 (VDDE_IOA), IC6.C13 (VDDE_IOC), IC6.D5 (VDDE_IOC), IC6.D7 (VDDE_IOC), IC6.E5 (VDDE_IOA), IC6.E8 (VDDE_IOC), IC6.F5 (VDDE_IOA), IC6.G5 (VDDE_IOA), IC6.G12 (VDDE_IOC), IC6.H5 (VDDE_IOA), IC6.K11 (VDDE_ESD), IC6.L4 (VDDE_IOB), IC6.L10 (VDDE_IOC), IC6.M2 (USB_VDDA33_DRV), IC6.M5 (VDDE_IOB), IC6.M7 (VDDE_IOB), IC6.M9 (VDDE_IOB), IC6.P1 (USB_VDDA33), LED1.A, R1.2, R12.2, R17.2, R19.1, R20.1, R21.1, R23.1, R25.1, R29.1, R30.1, SV1.5, SV1.6, SV6.3, U1.4, U$96.3 (VCC); also elsewhere on the board
CLK_256: IC6.H12 (CLK_256FS_O); also elsewhere on the board
CLK_OUT: IC6.J4 (CLOCK_OUT); also elsewhere on the board
CS_IN: IC6.B8 (SPI_CS_IN); also elsewhere on the board
CS_OUT0: IC6.A7 (SPI_CS_OUT0), R1.1; also elsewhere on the board
CTS_N: IC6.N13 (MUART_CTS_N); also elsewhere on the board
GND: C3.1, C6.1, C9.2, C10.1, C11.1, C12.1, C13.1, C14.1, C15.1, C16.1, C17.1, C18.1, C19.1, C20.1, C21.1, C22.1, C23.1, C25.1, C26.1, C27.1, C31.1, C32.1, C33.1, C35.1, C36.1, C37.1, C38.1, C41.1, C43.1, IC5.6 (VSSE_IOC), IC5.12 (VSSE_IOC), IC5.28 (VSSE_IOC), IC5.41 (VSSE_IOC), IC5.46 (VSSE_IOC), IC5.52 (VSSE_IOC), IC5.54 (VSSE_IOC), IC6.A11 (VSSI), IC6.A12 (ADC10B_GNDA), IC6.B12 (VSSE_IOC), IC6.C3 (VSSE_IOA), IC6.C4 (VSSE_IOA), IC6.C7 (VSSI), IC6.D6 (VSSE_IOC), IC6.D8 (VSSE_IOC), IC6.D9 (VSSE_IOC), IC6.D12 (VSSI), IC6.E4 (VSSE_IOA), IC6.E9 (VSSA12), IC6.F4 (VSSE_IOA), IC6.G4 (VSSI), IC6.G11 (VSSE_IOC), IC6.H4 (VSSE_IOA), IC6.K3 (VSSE_IOA), IC6.K4 (USB_VSSA_REF), IC6.L3 (USB_VSSA_TERM), IC6.L6 (VSSI), IC6.L9 (VSSE_IOC), IC6.L11 (VSSI), IC6.L13 (VSSE_IOC), IC6.M3 (VSSE_IOB), IC6.M4 (VSSE_IOB), IC6.M6 (VSSE_IOB), IC6.M8 (VSSE_IOB), IC6.N1 (USB_GNDA), R10.1, R11.1, R13.1, R14.1, R27.1, R28.1, S3.4, SV1.1, SV1.2, SV6.1, U1.6, U1.SW_B, U$96.1 (GND); also elsewhere on the board
GPA0: IC6.B14 (ADC10B_GPA0); also elsewhere on the board
GPA1: IC6.A14 (ADC10B_GPA1); also elsewhere on the board
GPA2: IC6.B13 (ADC10B_GPA2); also elsewhere on the board
GPA3: IC6.C14 (ADC10B_GPA3); also elsewhere on the board
GPIO0: IC6.K10 (GPIO0), R15.1; also elsewhere on the board
GPIO1: IC6.J10 (GPIO1), R2.1; also elsewhere on the board
GPIO2: IC6.L14 (GPIO2), R16.2; also elsewhere on the board
GPIO3: IC6.B11 (GPIO3), LED2.A; also elsewhere on the board
GPIO4: IC6.C11 (GPIO4); also elsewhere on the board
GPIO11: IC6.H13 (GPIO11); also elsewhere on the board
GPIO12: IC6.H10 (GPIO12); also elsewhere on the board
GPIO13: IC6.J12 (GPIO13); also elsewhere on the board
GPIO14: IC6.J14 (GPIO14); also elsewhere on the board
GPIO15: IC6.J13 (GPIO15); also elsewhere on the board
GPIO16: IC6.J11 (GPIO16); also elsewhere on the board
GPIO17: IC6.K12 (GPIO17); also elsewhere on the board
GPIO18: IC6.K14 (GPIO18); also elsewhere on the board
GPIO19: IC6.H11 (GPIO19); also elsewhere on the board
GPIO20: IC6.K13 (GPIO20); also elsewhere on the board
I2C_SCL0: IC6.D10 (I2C_SCL0); also elsewhere on the board
I2C_SCL1: IC6.E13 (I2C_SCL1); also elsewhere on the board
I2C_SDA0: IC6.C10 (I2C_SDA0); also elsewhere on the board
I2C_SDA1: IC6.E12 (I2C_SDA1); also elsewhere on the board
I2SRX_BCK0: IC6.N10 (I2SRX_BCK0); also elsewhere on the board
I2SRX_BCK1: IC6.F14 (I2SRX_BCK1); also elsewhere on the board
I2SRX_D0: IC6.M10 (I2SRX_DATA0); also elsewhere on the board
I2SRX_D1: IC6.G14 (I2SRX_DATA1); also elsewhere on the board
I2SRX_WS0: IC6.P11 (I2SRX_WS0); also elsewhere on the board
I2SRX_WS1: IC6.F13 (I2SRX_WS1); also elsewhere on the board
I2STX_BCK0: IC6.M12 (MI2STX_BCK0); also elsewhere on the board
I2STX_BCK1: IC6.E14 (I2STX_BCK1); also elsewhere on the board
I2STX_CLK0: IC6.N14 (MI2STX_CLK0); also elsewhere on the board
I2STX_D0: IC6.M13 (MI2STX_DATA0); also elsewhere on the board
I2STX_D1: IC6.F12 (I2STX_DATA1); also elsewhere on the board
I2STX_WS0: IC6.M11 (MI2STX_WS0); also elsewhere on the board
I2STX_WS1: IC6.G10 (I2STX_WS1); also elsewhere on the board
IO0: R15.2, SV1.4
IO2: R16.1, SV1.3
JTAGSEL: IC6.N11 (JTAGSEL), R12.1, R13.2
LPC_A0: IC5.23 (A0), IC6.B3 (EBI_A_0_ALE); also elsewhere on the board
LPC_A1: IC5.24 (A1), IC6.A2 (EBI_A_1_CLE); also elsewhere on the board
LPC_A2: IC5.25 (A2), IC6.N6 (MLCD_DB_2); also elsewhere on the board
LPC_A3: IC5.26 (A3), IC6.P6 (MLCD_DB_3); also elsewhere on the board
LPC_A4: IC5.29 (A4), IC6.N7 (MLCD_DB_4); also elsewhere on the board
LPC_A5: IC5.30 (A5), IC6.P7 (MLCD_DB_5); also elsewhere on the board
LPC_A6: IC5.31 (A6), IC6.K6 (MLCD_DB_6); also elsewhere on the board
LPC_A7: IC5.32 (A7), IC6.P5 (MLCD_DB_7); also elsewhere on the board
LPC_A8: IC5.33 (A8), IC6.N5 (MLCD_DB_8); also elsewhere on the board
LPC_A9: IC5.34 (A9), IC6.L5 (MLCD_DB_9); also elsewhere on the board
LPC_A10: IC5.22 (A10), IC6.K7 (MLCD_DB_10); also elsewhere on the board
LPC_A11: IC5.35 (A11), IC6.N4 (MLCD_DB_11); also elsewhere on the board
LPC_A12: IC5.36 (A12), IC6.K5 (MLCD_DB_12); also elsewhere on the board
LPC_A13: IC5.21 (BA1), IC6.P4 (MLCD_DB_13); also elsewhere on the board
LPC_A14: IC5.20 (BA0), IC6.P3 (MLCD_DB_14); also elsewhere on the board
LPC_A15: IC6.N3 (MLCD_DB_15); also elsewhere on the board
LPC_CAS: IC5.17 (CAS#), IC6.G1 (EBI_NCAS_BLOUT_0)
LPC_CKE: IC5.37 (CKE), IC6.L8 (MLCD_E_RD); also elsewhere on the board
LPC_CLK: IC5.38 (CLK), IC6.N8 (MLCD_DB_0)
LPC_CS: IC5.19 (CS#), IC6.P8 (MLCD_RS); also elsewhere on the board
LPC_D0: IC5.2 (DQ0), IC6.G2 (EBI_D_0); also elsewhere on the board
LPC_D1: IC5.4 (DQ1), IC6.F2 (EBI_D_1); also elsewhere on the board
LPC_D2: IC5.5 (DQ2), IC6.F1 (EBI_D_2); also elsewhere on the board
LPC_D3: IC5.7 (DQ3), IC6.E1 (EBI_D_3); also elsewhere on the board
LPC_D4: IC5.8 (DQ4), IC6.E2 (EBI_D_4); also elsewhere on the board
LPC_D5: IC5.10 (DQ5), IC6.D1 (EBI_D_5); also elsewhere on the board
LPC_D6: IC5.11 (DQ6), IC6.D2 (EBI_D_6); also elsewhere on the board
LPC_D7: IC5.13 (DQ7), IC6.C1 (EBI_D_7); also elsewhere on the board
LPC_D8: IC5.42 (DQ8), IC6.B1 (EBI_D_8); also elsewhere on the board
LPC_D9: IC5.44 (DQ9), IC6.A3 (EBI_D_9); also elsewhere on the board
LPC_D10: IC5.45 (DQ10), IC6.A1 (EBI_D_10); also elsewhere on the board
LPC_D11: IC5.47 (DQ11), IC6.C2 (EBI_D_11); also elsewhere on the board
LPC_D12: IC5.48 (DQ12), IC6.G3 (EBI_D_12); also elsewhere on the board
LPC_D13: IC5.50 (DQ13), IC6.D3 (EBI_D_13); also elsewhere on the board
LPC_D14: IC5.51 (DQ14), IC6.E3 (EBI_D_14); also elsewhere on the board
LPC_D15: IC5.53 (DQ15), IC6.F3 (EBI_D_15); also elsewhere on the board
LPC_DM: IC6.N2 (USB_DM), R10.2; also elsewhere on the board
LPC_DP: IC6.P2 (USB_DP), R14.2; also elsewhere on the board
LPC_DQM0: IC5.15 (LDQM), IC6.H1 (EBI_DQM_0_NOE); also elsewhere on the board
LPC_DQM1: IC5.39 (UDQM), IC6.N9 (MLCD_RW_WR); also elsewhere on the board
LPC_MCI_CD: IC6.B4 (MNAND_RYBN2), R20.2, U1.SW_A; also elsewhere on the board
LPC_MCI_CLK: IC6.B6 (MGPIO5), U1.5; also elsewhere on the board
LPC_MCI_CMD: IC6.A6 (MGPIO6), R29.2, U1.3; also elsewhere on the board
LPC_MCI_DAT0: IC6.A5 (MGPIO7), R25.2, U1.7; also elsewhere on the board
LPC_MCI_DAT1: IC6.B5 (MGPIO8), R23.2, U1.8; also elsewhere on the board
LPC_MCI_DAT2: IC6.C5 (MGPIO9), R30.2, U1.1; also elsewhere on the board
LPC_MCI_DAT3: IC6.A4 (MGPIO10), R21.2, U1.2; also elsewhere on the board
LPC_RAS: IC5.18 (RAS#1), IC6.H2 (EBI_NRAS_BLOUT_1)
LPC_STCS1: IC6.P9 (MLCD_DB_1)
LPC_VBUS: C10.2, R9.1; also elsewhere on the board
LPC_WE: IC5.16 (WE#), IC6.J2 (EBI_NWE); also elsewhere on the board
unnamed: LED2.C, R27.2
unnamed: R2.2, SV6.2
unnamed: LED1.C, R28.2
unnamed: C11.2, C20.2, IC6.A13 (ADC10B_VDDA33), R19.2
unnamed: IC6.J5 (USB_RREF), R11.2
unnamed: IC6.L2 (USB_VBUS), R9.2
NCS0: IC6.J1 (NAND_NCS_0); also elsewhere on the board
NCS1: IC6.J3 (NAND_NCS_1); also elsewhere on the board
NCS2: IC6.K1 (NAND_NCS_2); also elsewhere on the board
NCS3: IC6.K2 (NAND_NCS_3); also elsewhere on the board
PWM_DATA: IC6.B9 (PWM_DATA); also elsewhere on the board
RESET: C9.1, IC6.H14 (RSTIN_N), R17.1, S3.2, U$96.2 (!RESET)
RTS_N: IC6.P14 (MUART_RTS_N); also elsewhere on the board
RXD: IC6.P12 (UART_RXD); also elsewhere on the board
RYBN0: IC6.E6 (MNAND_RYBN0); also elsewhere on the board
RYBN1: IC6.E7 (MNAND_RYBN1); also elsewhere on the board
RYBN3: IC6.D4 (MNAND_RYBN3); also elsewhere on the board
SCAN_TDO: IC6.F10 (SCAN_TDO); also elsewhere on the board
SPI_MISO: IC6.C8 (SPI_MISO); also elsewhere on the board
SPI_MOSI: IC6.B7 (SPI_MOSI); also elsewhere on the board
SPI_SCK: IC6.A8 (SPI_SCK); also elsewhere on the board
STCS0: IC6.K8 (MLCD_CSB); also elsewhere on the board
SYSCLOCK_O: IC6.G13 (SYSCLK_O); also elsewhere on the board
TCK: IC6.M14 (TCK); also elsewhere on the board
TDI: IC6.K9 (TDI); also elsewhere on the board
TDO: IC6.E11 (ARM_TDO); also elsewhere on the board
TMS: IC6.P10 (TMS); also elsewhere on the board
TRST_N: IC6.P13 (TRST_N); also elsewhere on the board
TXD: IC6.N12 (UART_TXD); also elsewhere on the board
USB_ID: IC6.M1 (USB_ID); also elsewhere on the board
XTAL1: C43.2, IC6.A10 (FFAST_IN), Q4.3 (2)
XTAL2: C41.2, IC6.B10 (FFAST_OUT), Q4.1

Notes on the sheet:
embedded projects GmbH
Holzbachstraße 4
D-86152 Augsburg
Created by Benedikt Sauter
UART zum Debuggen
