embeddedprojects/gnublin-schematics/Board-EXTENDED/GNUBLIN_EXTENDED_V1_7.brd

## EAGLE design Board-EXTENDED/GNUBLIN_EXTENDED_V1_7.brd (continued)

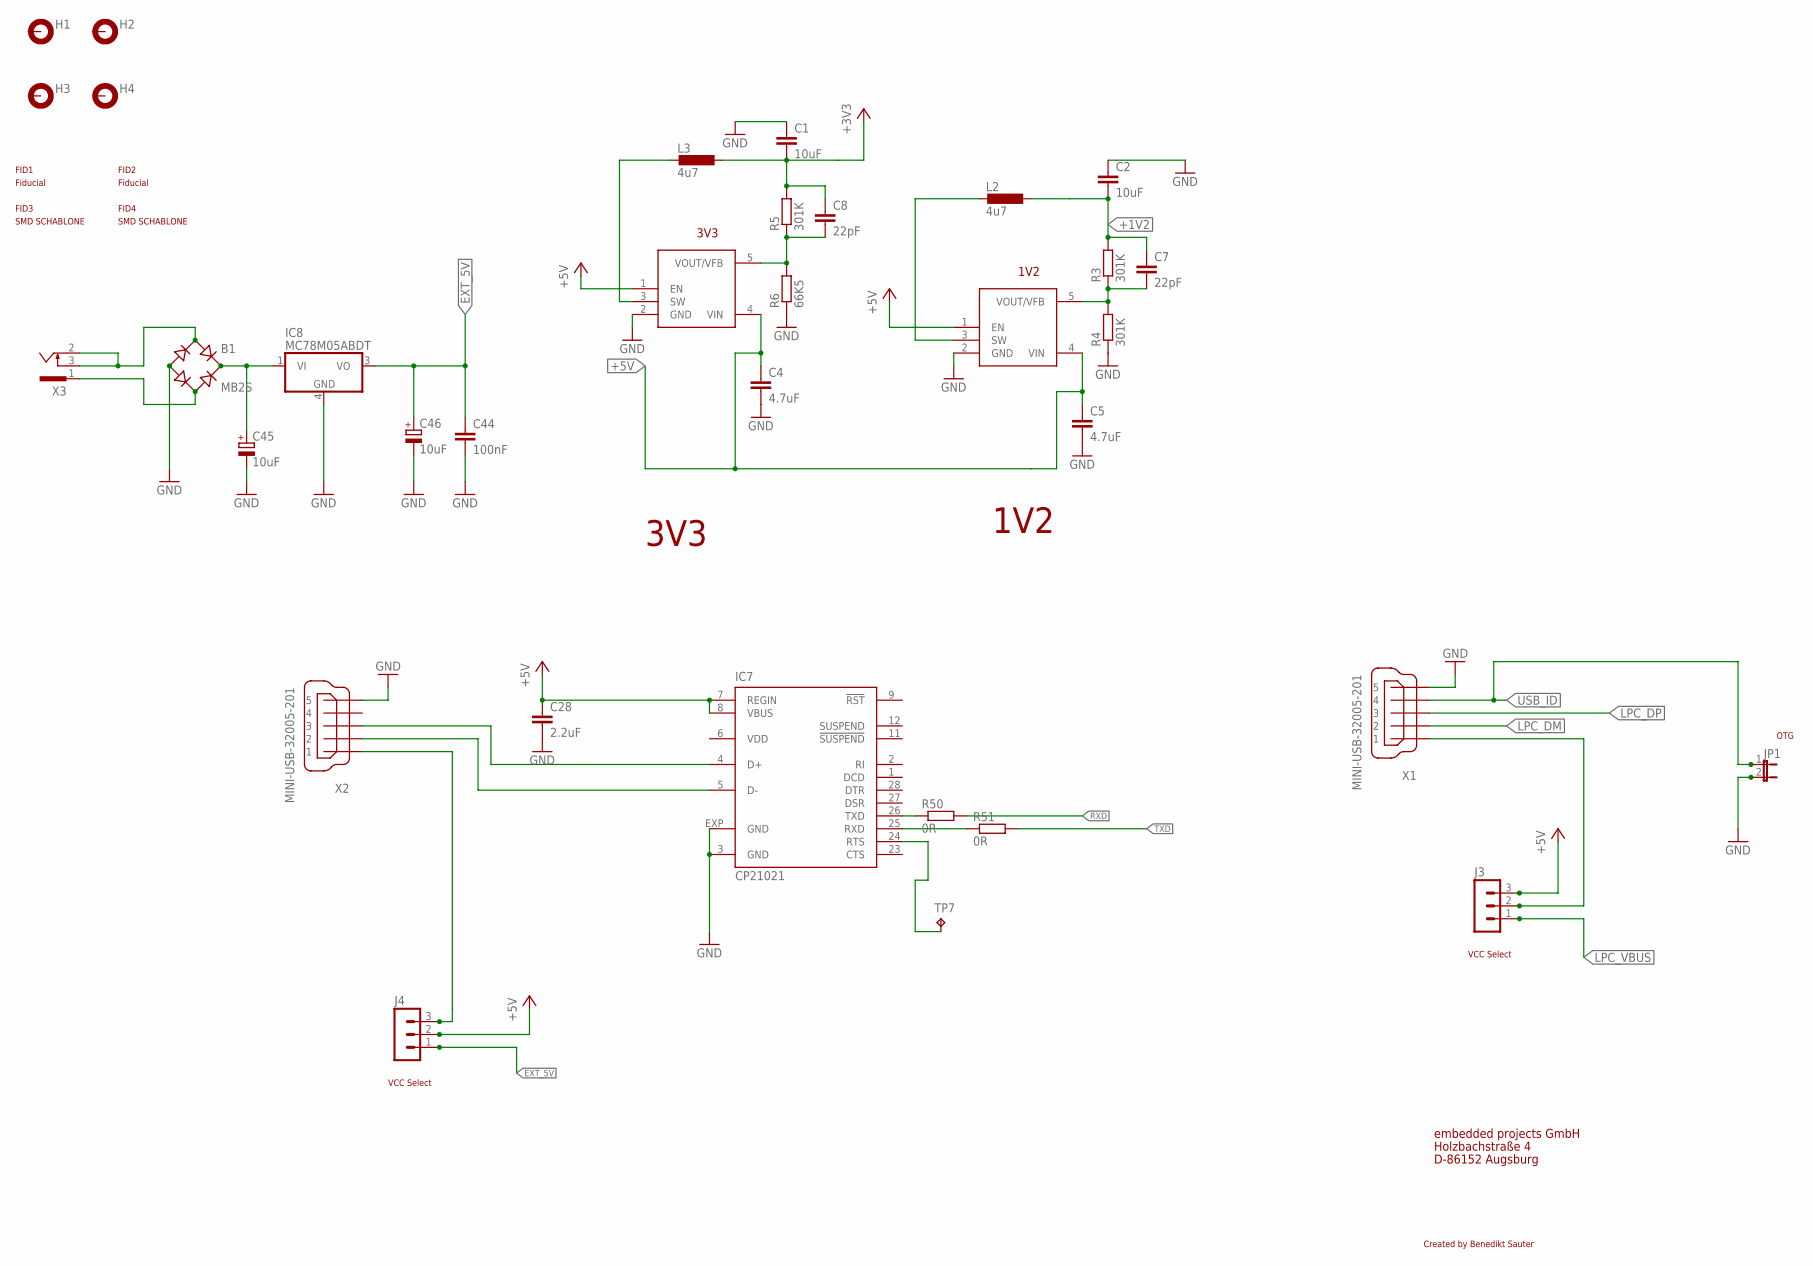
[picture p77: schematic GNUBLIN_EXTENDED_V1_7.sch, sheet 2]

Parts:
B1: MB2S; SOIC-4
C1, C2: 10uF; C0805
C4, C5: 4.7uF; C0805
C7, C8: 22pF; C0805
C28: 2.2uF; C0805
C44: 100nF; C0805
C45, C46: 10uF; D/7343-31R
FID1, FID2, FID3, FID4: PASSERMARKEN_FIDUCIAL
H1, H2, H3, H4: MOUNT-PAD-ROUND2.8; 2,8-PAD
IC2, IC3: AS1324; TSOT23
IC7: CP21021; MLP28
IC8: MC78M05ABDT; DPACK_3
J3, J4: MA03-1
JP1: JP1E; JP1
L2, L3: 4u7; PSU3014
R3, R4, R5: 301K; R0805
R6: 66K5; R0805
R50, R51: 0R; R0805
TP7: TPTP08R; TP08R
X1, X2: MINI-USB-32005-201; 32005-201
X3: 733980-62

Connections:
5V_USB: J4.3, X2.1
+1V2: C2.2, C7.1, L2.2, R3.2; also elsewhere on the board
+3V3: C1.2, C8.1, L3.2, R5.2; also elsewhere on the board
+5V: C4.1, C5.1, C28.1, IC2.1 (EN), IC2.4 (VIN), IC3.1 (EN), IC3.4 (VIN), IC7.7 (REGIN), IC7.8 (VBUS), J3.3, J4.2; also elsewhere on the board
EXT_5V: C44.1, C46.+, IC8.3 (VO), J4.1
GND: B1.-, C1.1, C2.1, C4.2, C5.2, C28.2, C44.2, C45.-, C46.-, IC2.2 (GND), IC3.2 (GND), IC7.3 (GND), IC7.EXP (GND), IC8.4 (GND), JP1.2, R4.1, R6.1, X1.5, X2.5; also elsewhere on the board
LPC_DM: X1.2; also elsewhere on the board
LPC_DP: X1.3; also elsewhere on the board
LPC_VBUS: J3.1; also elsewhere on the board
unnamed: IC7.26 (TXD), R50.1
unnamed: J3.2, X1.1
unnamed: IC7.4 (D+), X2.3
unnamed: IC7.5 (D-), X2.2
unnamed: IC2.3 (SW), L2.1
unnamed: IC7.25 (RXD), R51.1
unnamed: IC7.24 (RTS), TP7.TP
unnamed: C7.2, IC2.5 (VOUT/VFB), R3.1, R4.2
unnamed: B1.+, C45.+, IC8.1 (VI)
unnamed: B1.~2 (AC2), X3.1
unnamed: B1.~1 (AC1), X3.2, X3.3
unnamed: IC3.3 (SW), L3.1
unnamed: C8.2, IC3.5 (VOUT/VFB), R5.1, R6.2
RXD: R50.2; also elsewhere on the board
TXD: R51.2; also elsewhere on the board
USB_ID: JP1.1, X1.4; also elsewhere on the board
VDD: IC7.6 (VDD)

Notes on the sheet:
Created by Benedikt Sauter
3V3
1V2
embedded projects GmbH
Holzbachstraße 4
D-86152 Augsburg
VCC Select
OTG

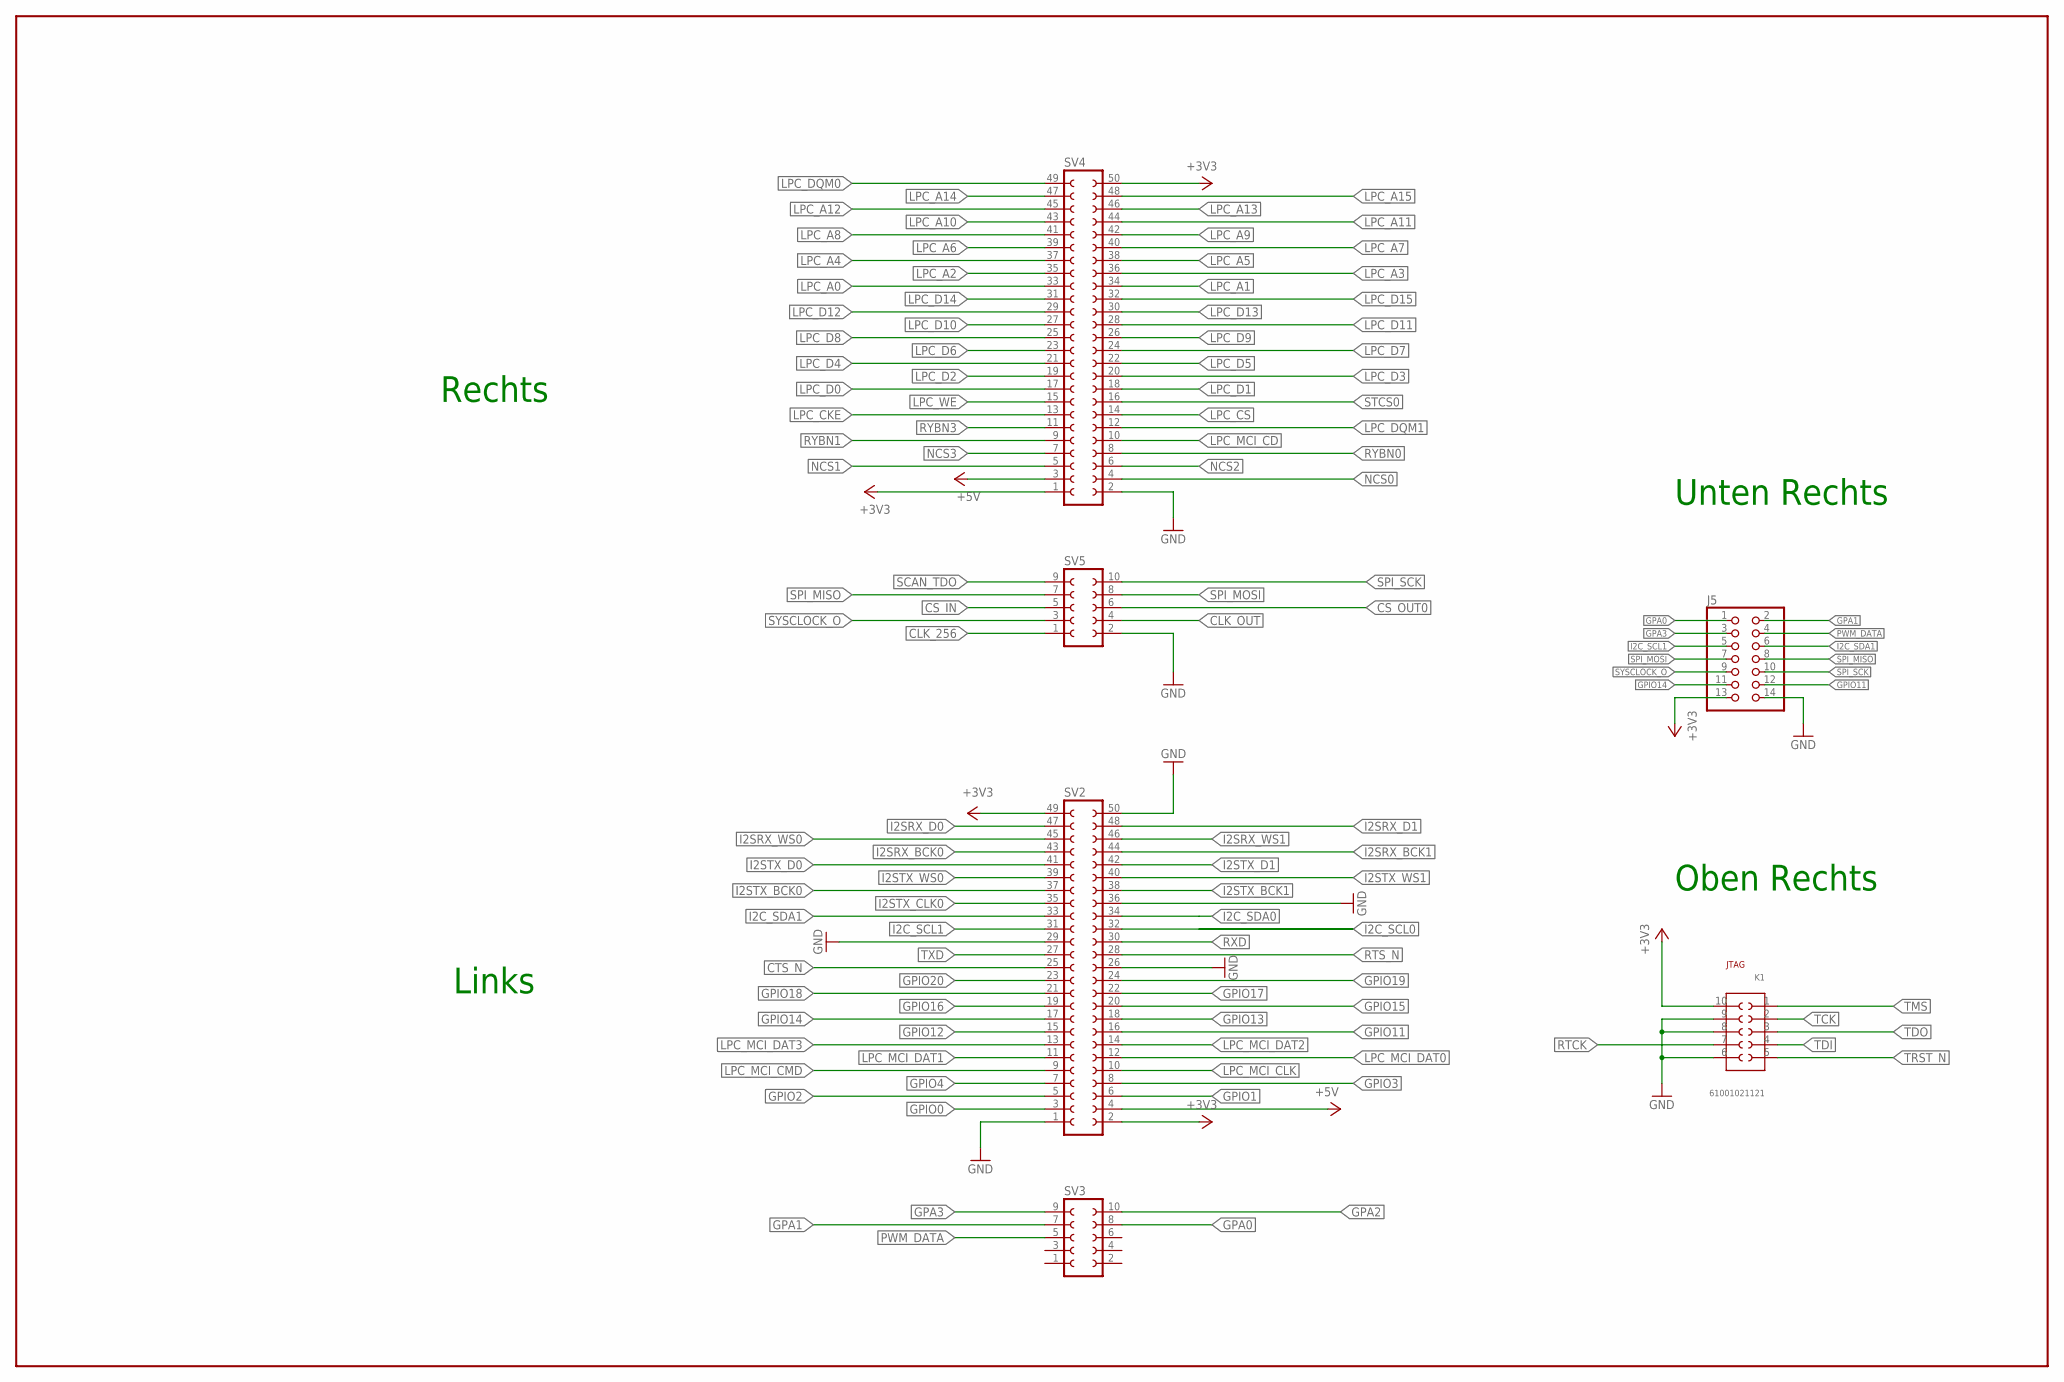
[picture p78: schematic GNUBLIN_EXTENDED_V1_7.sch, sheet 3]

Parts:
J5: PINHD-2X7; 2X07
K1: 61001021121
SV2, SV4: FE25-2
SV3, SV5: FE05-2

Connections:
+3V3: J5.13, K1.10, SV2.2, SV2.49, SV4.1, SV4.50; also elsewhere on the board
+5V: SV2.4, SV4.3; also elsewhere on the board
CLK_256: SV5.1; also elsewhere on the board
CLK_OUT: SV5.4; also elsewhere on the board
CS_IN: SV5.5; also elsewhere on the board
CS_OUT0: SV5.6; also elsewhere on the board
CTS_N: SV2.25; also elsewhere on the board
GND: J5.14, K1.6, K1.8, K1.9, SV2.1, SV2.26, SV2.29, SV2.36, SV2.50, SV4.2, SV5.2; also elsewhere on the board
GPA0: J5.1, SV3.8; also elsewhere on the board
GPA1: J5.2, SV3.7; also elsewhere on the board
GPA2: SV3.10; also elsewhere on the board
GPA3: J5.3, SV3.9; also elsewhere on the board
GPIO0: SV2.3; also elsewhere on the board
GPIO1: SV2.6; also elsewhere on the board
GPIO2: SV2.5; also elsewhere on the board
GPIO3: SV2.8; also elsewhere on the board
GPIO4: SV2.7; also elsewhere on the board
GPIO11: J5.12, SV2.16; also elsewhere on the board
GPIO12: SV2.15; also elsewhere on the board
GPIO13: SV2.18; also elsewhere on the board
GPIO14: J5.11, SV2.17; also elsewhere on the board
GPIO15: SV2.20; also elsewhere on the board
GPIO16: SV2.19; also elsewhere on the board
GPIO17: SV2.22; also elsewhere on the board
GPIO18: SV2.21; also elsewhere on the board
GPIO19: SV2.24; also elsewhere on the board
GPIO20: SV2.23; also elsewhere on the board
I2C_SCL0: SV2.32; also elsewhere on the board
I2C_SCL1: J5.5, SV2.31; also elsewhere on the board
I2C_SDA0: SV2.34; also elsewhere on the board
I2C_SDA1: J5.6, SV2.33; also elsewhere on the board
I2SRX_BCK0: SV2.43; also elsewhere on the board
I2SRX_BCK1: SV2.44; also elsewhere on the board
I2SRX_D0: SV2.47; also elsewhere on the board
I2SRX_D1: SV2.48; also elsewhere on the board
I2SRX_WS0: SV2.45; also elsewhere on the board
I2SRX_WS1: SV2.46; also elsewhere on the board
I2STX_BCK0: SV2.37; also elsewhere on the board
I2STX_BCK1: SV2.38; also elsewhere on the board
I2STX_CLK0: SV2.35; also elsewhere on the board
I2STX_D0: SV2.41; also elsewhere on the board
I2STX_D1: SV2.42; also elsewhere on the board
I2STX_WS0: SV2.39; also elsewhere on the board
I2STX_WS1: SV2.40; also elsewhere on the board
LPC_A0: SV4.33; also elsewhere on the board
LPC_A1: SV4.34; also elsewhere on the board
LPC_A2: SV4.35; also elsewhere on the board
LPC_A3: SV4.36; also elsewhere on the board
LPC_A4: SV4.37; also elsewhere on the board
LPC_A5: SV4.38; also elsewhere on the board
LPC_A6: SV4.39; also elsewhere on the board
LPC_A7: SV4.40; also elsewhere on the board
LPC_A8: SV4.41; also elsewhere on the board
LPC_A9: SV4.42; also elsewhere on the board
LPC_A10: SV4.43; also elsewhere on the board
LPC_A11: SV4.44; also elsewhere on the board
LPC_A12: SV4.45; also elsewhere on the board
LPC_A13: SV4.46; also elsewhere on the board
LPC_A14: SV4.47; also elsewhere on the board
LPC_A15: SV4.48; also elsewhere on the board
LPC_CKE: SV4.13; also elsewhere on the board
LPC_CS: SV4.14; also elsewhere on the board
LPC_D0: SV4.17; also elsewhere on the board
LPC_D1: SV4.18; also elsewhere on the board
LPC_D2: SV4.19; also elsewhere on the board
LPC_D3: SV4.20; also elsewhere on the board
LPC_D4: SV4.21; also elsewhere on the board
LPC_D5: SV4.22; also elsewhere on the board
LPC_D6: SV4.23; also elsewhere on the board
LPC_D7: SV4.24; also elsewhere on the board
LPC_D8: SV4.25; also elsewhere on the board
LPC_D9: SV4.26; also elsewhere on the board
LPC_D10: SV4.27; also elsewhere on the board
LPC_D11: SV4.28; also elsewhere on the board
LPC_D12: SV4.29; also elsewhere on the board
LPC_D13: SV4.30; also elsewhere on the board
LPC_D14: SV4.31; also elsewhere on the board
LPC_D15: SV4.32; also elsewhere on the board
LPC_DQM0: SV4.49; also elsewhere on the board
LPC_DQM1: SV4.12; also elsewhere on the board
LPC_MCI_CD: SV4.10; also elsewhere on the board
LPC_MCI_CLK: SV2.10; also elsewhere on the board
LPC_MCI_CMD: SV2.9; also elsewhere on the board
LPC_MCI_DAT0: SV2.12; also elsewhere on the board
LPC_MCI_DAT1: SV2.11; also elsewhere on the board
LPC_MCI_DAT2: SV2.14; also elsewhere on the board
LPC_MCI_DAT3: SV2.13; also elsewhere on the board
LPC_WE: SV4.15; also elsewhere on the board
NCS0: SV4.4; also elsewhere on the board
NCS1: SV4.5; also elsewhere on the board
NCS2: SV4.6; also elsewhere on the board
NCS3: SV4.7; also elsewhere on the board
PWM_DATA: J5.4, SV3.5; also elsewhere on the board
RTCK: K1.7
RTS_N: SV2.28; also elsewhere on the board
RXD: SV2.30; also elsewhere on the board
RYBN0: SV4.8; also elsewhere on the board
RYBN1: SV4.9; also elsewhere on the board
RYBN3: SV4.11; also elsewhere on the board
SCAN_TDO: SV5.9; also elsewhere on the board
SPI_MISO: J5.8, SV5.7; also elsewhere on the board
SPI_MOSI: J5.7, SV5.8; also elsewhere on the board
SPI_SCK: J5.10, SV5.10; also elsewhere on the board
STCS0: SV4.16; also elsewhere on the board
SYSCLOCK_O: J5.9, SV5.3; also elsewhere on the board
TCK: K1.2; also elsewhere on the board
TDI: K1.4; also elsewhere on the board
TDO: K1.3; also elsewhere on the board
TMS: K1.1; also elsewhere on the board
TRST_N: K1.5; also elsewhere on the board
TXD: SV2.27; also elsewhere on the board

Notes on the sheet:
Links
Rechts
Unten Rechts
Oben Rechts
JTAG

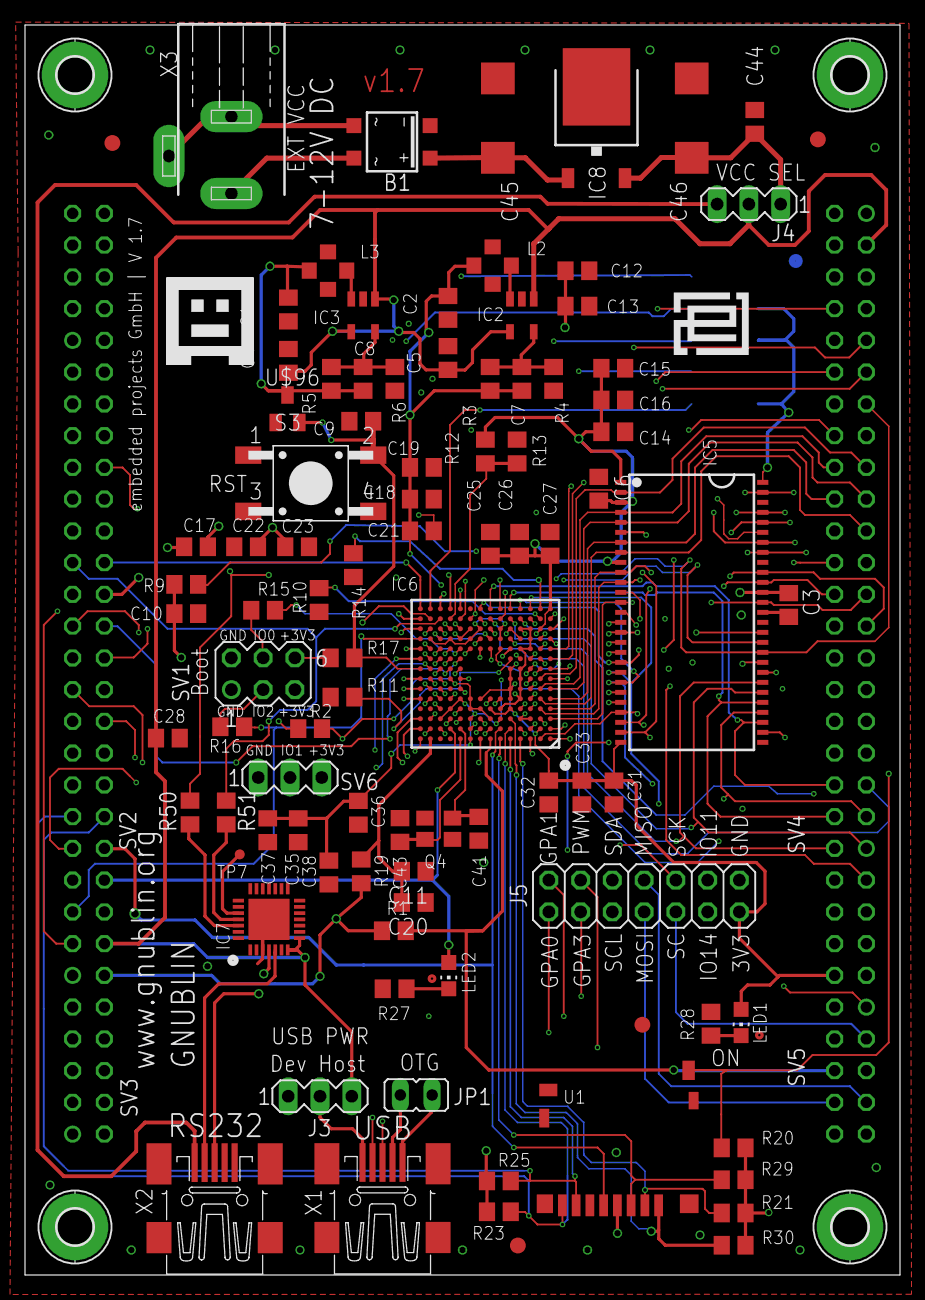
[picture p79: board GNUBLIN_EXTENDED_V1_7.brd from above]

Board: 6 copper layers, 70.0 x 100.0 mm, 105 parts (1 on the bottom side), 145 nets.
