embeddedprojects/gnublin-schematics/Board-LAN/GNUBLIN_LAN_V2.3.brd

## EAGLE design Board-LAN/GNUBLIN_LAN_V2.3.brd (2013-05-15)

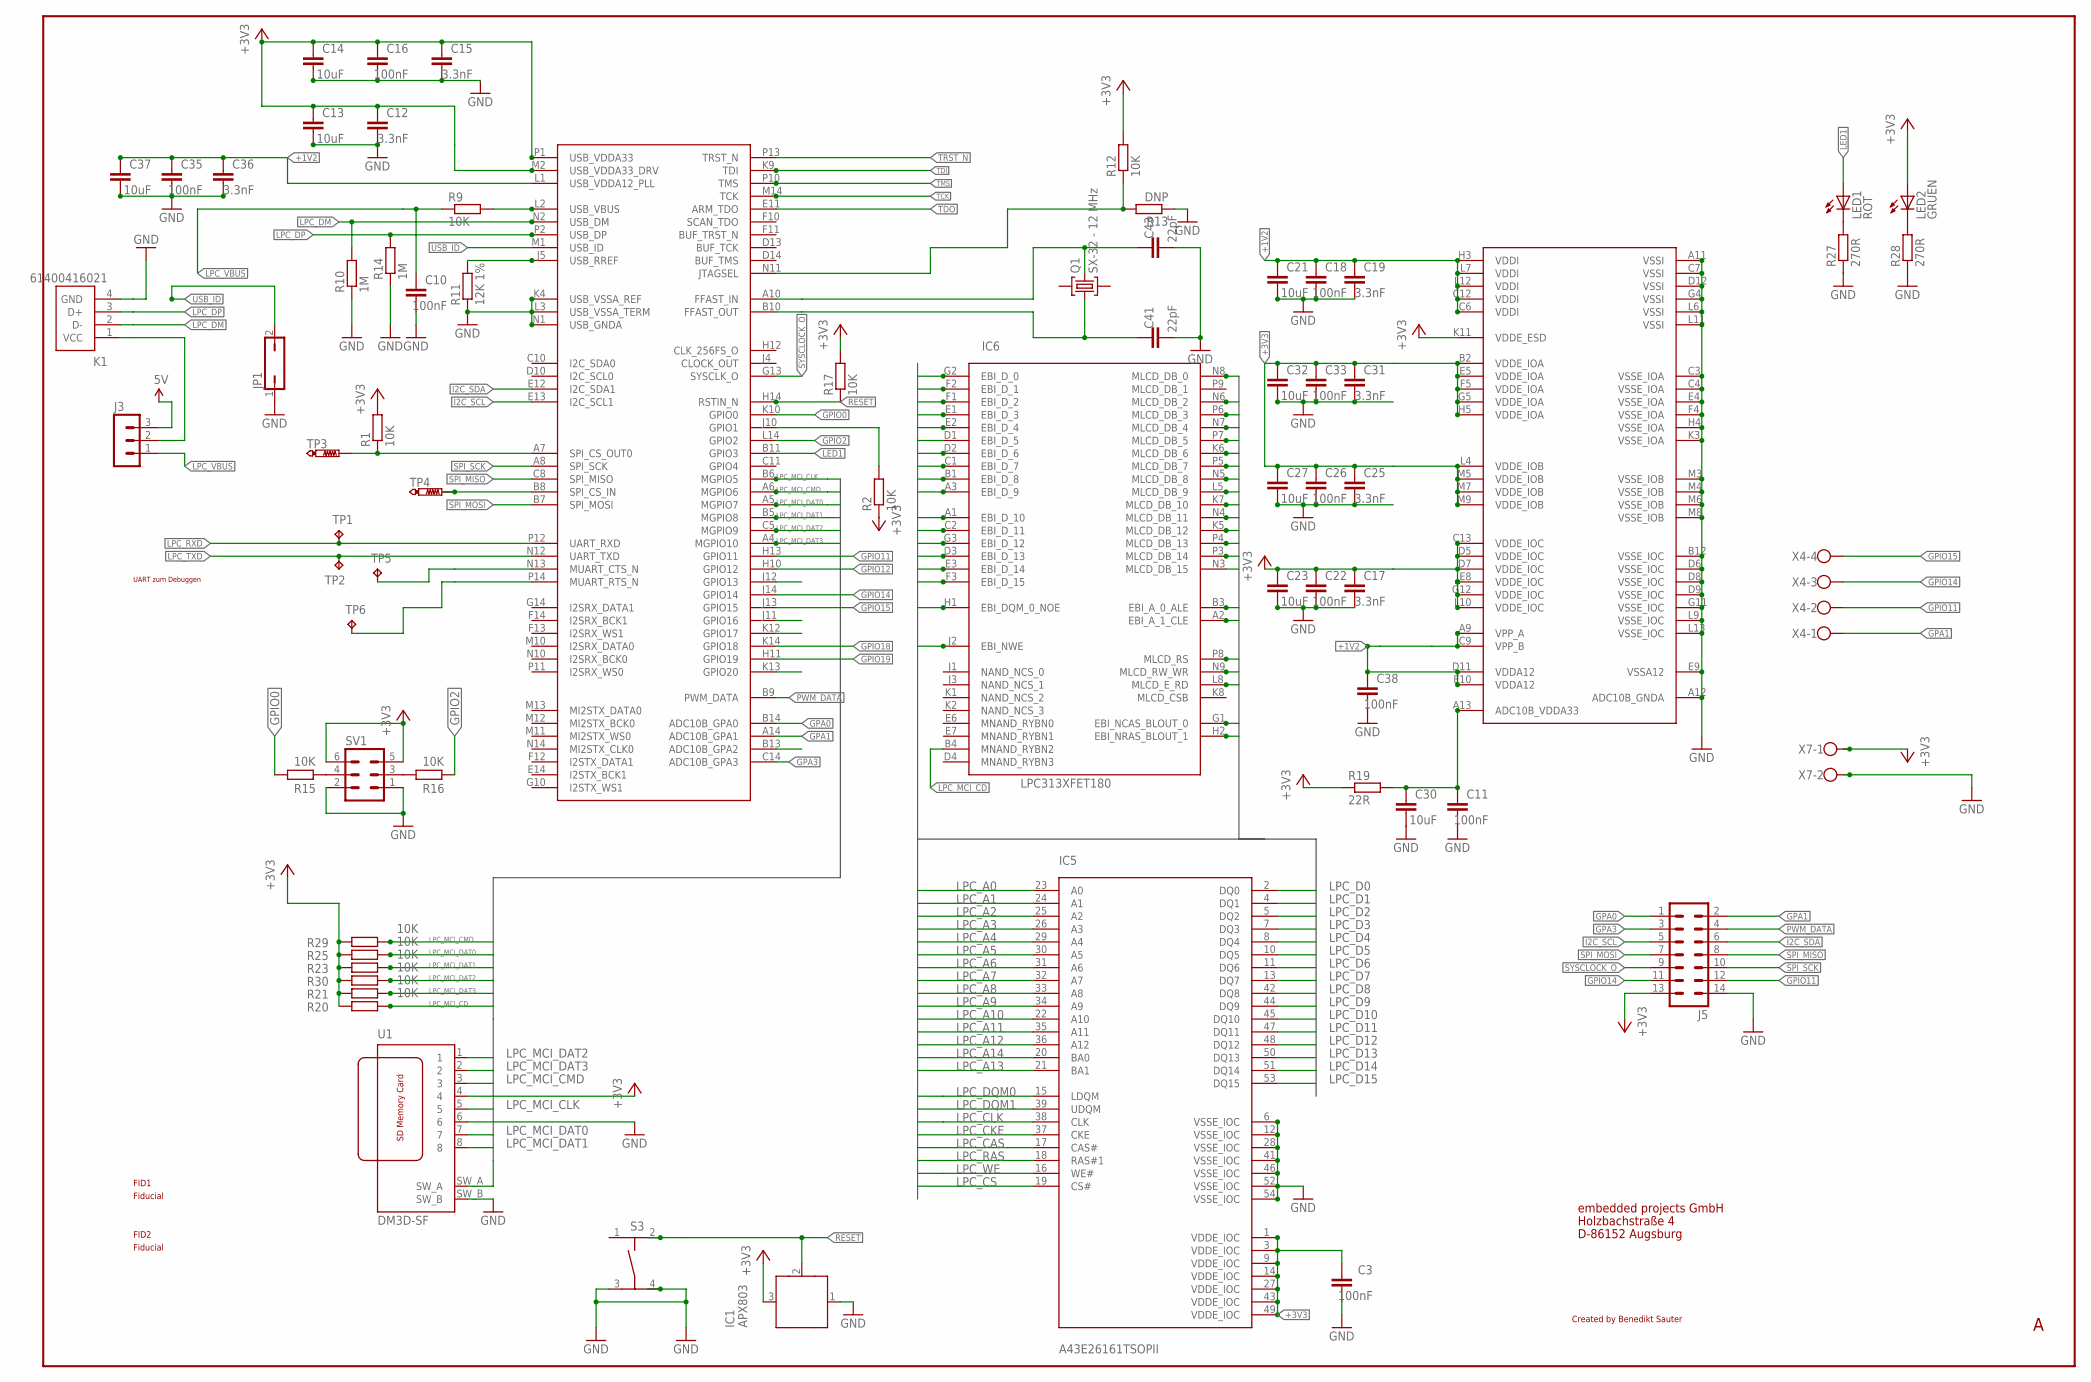
[picture p80: schematic GNUBLIN_LAN_V2.3.sch, sheet 1]

Parts:
C3, C10, C11, C16, C18, C22, C26, C33, C35, C38: 100nF; C0805
C12, C15, C17, C19, C25, C31, C36: 3.3nF; C0805
C13, C14, C21, C23, C27, C30, C32, C37: 10uF; C0805
C41, C43: 22pF; C0805
FID1, FID2: PASSERMARKEN_FIDUCIAL
IC1: APX803; SOT23
IC5: A43E26161TSOPII; TSOPII
IC6: LPC313XFET180; TFBGA180
J3: MA03-1
J5: ML14
JP1: JP1Q; JP1
K1: 61400416021
LED1: ROT; CHIP-LED0805
LED2: GRUEN; CHIP-LED0805
Q1: SX-32 - 12 MHz; SX-32; FARNELL 1712841
R1, R2, R9, R12, R15, R16, R17, R20, R21, R23, R25, R29, R30: 10K; R0805
R10, R14: 1M; R0805
R11: 12K 1%; R0805
R13: DNP; R0805
R19: 22R; R0805
R27, R28: 270R; R0805
S3: TASTER-9314_SMD
SV1: MA03-2
TP1, TP2: TPTP15R; TP15R
TP3, TP4: PTR1TP08R; TP08R
TP5, TP6: TPTP08R; TP08R
U1: DM3D-SF
X4: W237-04P; W237-4P
X7: W237-02P; W237-132

Connections:
5V: J3.3; also elsewhere on the board
+1V2: C18.2, C19.2, C21.2, C35.2, C36.2, C37.2, C38.2, IC6.A9 (VPP_A), IC6.C6 (VDDI), IC6.C9 (VPP_B), IC6.C12 (VDDI), IC6.D11 (VDDA12), IC6.E10 (VDDA12), IC6.H3 (VDDI), IC6.L1 (USB_VDDA12_PLL), IC6.L7 (VDDI), IC6.L12 (VDDI); also elsewhere on the board
+3V3: C3.2, C12.2, C13.2, C14.2, C15.2, C16.2, C17.2, C22.2, C23.2, C25.2, C26.2, C27.2, C31.2, C32.2, C33.2, IC1.3 (VCC), IC5.1 (VDDE_IOC), IC5.3 (VDDE_IOC), IC5.9 (VDDE_IOC), IC5.14 (VDDE_IOC), IC5.27 (VDDE_IOC), IC5.43 (VDDE_IOC), IC5.49 (VDDE_IOC), IC6.B2 (VDDE_IOA), IC6.C13 (VDDE_IOC), IC6.D5 (VDDE_IOC), IC6.D7 (VDDE_IOC), IC6.E5 (VDDE_IOA), IC6.E8 (VDDE_IOC), IC6.F5 (VDDE_IOA), IC6.G5 (VDDE_IOA), IC6.G12 (VDDE_IOC), IC6.H5 (VDDE_IOA), IC6.K11 (VDDE_ESD), IC6.L4 (VDDE_IOB), IC6.L10 (VDDE_IOC), IC6.M2 (USB_VDDA33_DRV), IC6.M5 (VDDE_IOB), IC6.M7 (VDDE_IOB), IC6.M9 (VDDE_IOB), IC6.P1 (USB_VDDA33), J5.13, LED2.A, R1.2, R2.1, R12.2, R17.2, R19.1, R20.1, R21.1, R23.1, R25.1, R29.1, R30.1, SV1.5, SV1.6, U1.4, X7.1; also elsewhere on the board
GND: C3.1, C10.1, C11.1, C12.1, C13.1, C14.1, C15.1, C16.1, C17.1, C18.1, C19.1, C21.1, C22.1, C23.1, C25.1, C26.1, C27.1, C30.1, C31.1, C32.1, C33.1, C35.1, C36.1, C37.1, C38.1, C41.1, C43.1, IC1.1 (GND), IC5.6 (VSSE_IOC), IC5.12 (VSSE_IOC), IC5.28 (VSSE_IOC), IC5.41 (VSSE_IOC), IC5.46 (VSSE_IOC), IC5.52 (VSSE_IOC), IC5.54 (VSSE_IOC), IC6.A11 (VSSI), IC6.A12 (ADC10B_GNDA), IC6.B12 (VSSE_IOC), IC6.C3 (VSSE_IOA), IC6.C4 (VSSE_IOA), IC6.C7 (VSSI), IC6.D6 (VSSE_IOC), IC6.D8 (VSSE_IOC), IC6.D9 (VSSE_IOC), IC6.D12 (VSSI), IC6.E4 (VSSE_IOA), IC6.E9 (VSSA12), IC6.F4 (VSSE_IOA), IC6.G4 (VSSI), IC6.G11 (VSSE_IOC), IC6.H4 (VSSE_IOA), IC6.K3 (VSSE_IOA), IC6.K4 (USB_VSSA_REF), IC6.L3 (USB_VSSA_TERM), IC6.L6 (VSSI), IC6.L9 (VSSE_IOC), IC6.L11 (VSSI), IC6.L13 (VSSE_IOC), IC6.M3 (VSSE_IOB), IC6.M4 (VSSE_IOB), IC6.M6 (VSSE_IOB), IC6.M8 (VSSE_IOB), IC6.N1 (USB_GNDA), J5.14, JP1.1, K1.4 (GND), R10.1, R11.1, R13.1, R14.1, R27.1, R28.1, S3.3, S3.4, SV1.1, SV1.2, U1.6, U1.SW_B, X7.2; also elsewhere on the board
GPA0: IC6.B14 (ADC10B_GPA0), J5.1
GPA1: IC6.A14 (ADC10B_GPA1), J5.2, X4.1
GPA3: IC6.C14 (ADC10B_GPA3), J5.3
GPIO0: IC6.K10 (GPIO0), R15.1
GPIO2: IC6.L14 (GPIO2), R16.2
GPIO11: IC6.H13 (GPIO11), J5.12, X4.2
GPIO12: IC6.H10 (GPIO12); also elsewhere on the board
GPIO14: IC6.J14 (GPIO14), J5.11, X4.3
GPIO15: IC6.J13 (GPIO15), X4.4
GPIO18: IC6.K14 (GPIO18); also elsewhere on the board
GPIO19: IC6.H11 (GPIO19); also elsewhere on the board
I2C_SCL: IC6.E13 (I2C_SCL1), J5.5; also elsewhere on the board
I2C_SDA: IC6.E12 (I2C_SDA1), J5.6; also elsewhere on the board
LED1: IC6.B11 (GPIO3), LED1.A
LPC_A0: IC5.23 (A0), IC6.B3 (EBI_A_0_ALE)
LPC_A1: IC5.24 (A1), IC6.A2 (EBI_A_1_CLE)
LPC_A2: IC5.25 (A2), IC6.N6 (MLCD_DB_2)
LPC_A3: IC5.26 (A3), IC6.P6 (MLCD_DB_3)
LPC_A4: IC5.29 (A4), IC6.N7 (MLCD_DB_4)
LPC_A5: IC5.30 (A5), IC6.P7 (MLCD_DB_5)
LPC_A6: IC5.31 (A6), IC6.K6 (MLCD_DB_6)
LPC_A7: IC5.32 (A7), IC6.P5 (MLCD_DB_7)
LPC_A8: IC5.33 (A8), IC6.N5 (MLCD_DB_8)
LPC_A9: IC5.34 (A9), IC6.L5 (MLCD_DB_9)
LPC_A10: IC5.22 (A10), IC6.K7 (MLCD_DB_10)
LPC_A11: IC5.35 (A11), IC6.N4 (MLCD_DB_11)
LPC_A12: IC5.36 (A12), IC6.K5 (MLCD_DB_12)
LPC_A13: IC5.21 (BA1), IC6.P4 (MLCD_DB_13)
LPC_A14: IC5.20 (BA0), IC6.P3 (MLCD_DB_14)
LPC_A15: IC6.N3 (MLCD_DB_15)
LPC_CAS: IC5.17 (CAS#), IC6.G1 (EBI_NCAS_BLOUT_0)
LPC_CKE: IC5.37 (CKE), IC6.L8 (MLCD_E_RD)
LPC_CLK: IC5.38 (CLK), IC6.N8 (MLCD_DB_0)
LPC_CS: IC5.19 (CS#), IC6.P8 (MLCD_RS)
LPC_D0: IC5.2 (DQ0), IC6.G2 (EBI_D_0)
LPC_D1: IC5.4 (DQ1), IC6.F2 (EBI_D_1)
LPC_D2: IC5.5 (DQ2), IC6.F1 (EBI_D_2)
LPC_D3: IC5.7 (DQ3), IC6.E1 (EBI_D_3)
LPC_D4: IC5.8 (DQ4), IC6.E2 (EBI_D_4)
LPC_D5: IC5.10 (DQ5), IC6.D1 (EBI_D_5)
LPC_D6: IC5.11 (DQ6), IC6.D2 (EBI_D_6)
LPC_D7: IC5.13 (DQ7), IC6.C1 (EBI_D_7)
LPC_D8: IC5.42 (DQ8), IC6.B1 (EBI_D_8)
LPC_D9: IC5.44 (DQ9), IC6.A3 (EBI_D_9)
LPC_D10: IC5.45 (DQ10), IC6.A1 (EBI_D_10)
LPC_D11: IC5.47 (DQ11), IC6.C2 (EBI_D_11)
LPC_D12: IC5.48 (DQ12), IC6.G3 (EBI_D_12)
LPC_D13: IC5.50 (DQ13), IC6.D3 (EBI_D_13)
LPC_D14: IC5.51 (DQ14), IC6.E3 (EBI_D_14)
LPC_D15: IC5.53 (DQ15), IC6.F3 (EBI_D_15)
LPC_DM: IC6.N2 (USB_DM), K1.2 (D-), R10.2
LPC_DP: IC6.P2 (USB_DP), K1.3 (D+), R14.2
LPC_DQM0: IC5.15 (LDQM), IC6.H1 (EBI_DQM_0_NOE)
LPC_DQM1: IC5.39 (UDQM), IC6.N9 (MLCD_RW_WR)
LPC_MCI_CD: IC6.B4 (MNAND_RYBN2), R20.2, U1.SW_A
LPC_MCI_CLK: IC6.B6 (MGPIO5), U1.5
LPC_MCI_CMD: IC6.A6 (MGPIO6), R29.2, U1.3
LPC_MCI_DAT0: IC6.A5 (MGPIO7), R25.2, U1.7
LPC_MCI_DAT1: IC6.B5 (MGPIO8), R23.2, U1.8
LPC_MCI_DAT2: IC6.C5 (MGPIO9), R30.2, U1.1
LPC_MCI_DAT3: IC6.A4 (MGPIO10), R21.2, U1.2
LPC_RAS: IC5.18 (RAS#1), IC6.H2 (EBI_NRAS_BLOUT_1)
LPC_RXD: IC6.P12 (UART_RXD), TP1.TP; also elsewhere on the board
LPC_TXD: IC6.N12 (UART_TXD), TP2.TP; also elsewhere on the board
LPC_VBUS: C10.2, J3.1, R9.1
LPC_WE: IC5.16 (WE#), IC6.J2 (EBI_NWE)
unnamed: LED1.C, R27.2
unnamed: LED2.C, R28.2
unnamed: IC6.N11 (JTAGSEL), R12.1, R13.2
unnamed: J3.2, K1.1 (VCC)
unnamed: IC6.A7 (SPI_CS_OUT0), R1.1, TP3.TP
unnamed: IC6.B8 (SPI_CS_IN), TP4.TP
unnamed: IC6.J10 (GPIO1), R2.2
unnamed: R15.2, SV1.4
unnamed: R16.1, SV1.3
unnamed: IC6.N13 (MUART_CTS_N), TP5.TP
unnamed: IC6.P14 (MUART_RTS_N), TP6.TP
unnamed: C11.2, C30.2, IC6.A13 (ADC10B_VDDA33), R19.2
unnamed: IC6.J5 (USB_RREF), R11.2
unnamed: IC6.L2 (USB_VBUS), R9.2
PWM_DATA: IC6.B9 (PWM_DATA), J5.4
RESET: IC1.2 (!RESET), IC6.H14 (RSTIN_N), R17.1, S3.2
SPI_MISO: IC6.C8 (SPI_MISO), J5.8; also elsewhere on the board
SPI_MOSI: IC6.B7 (SPI_MOSI), J5.7; also elsewhere on the board
SPI_SCK: IC6.A8 (SPI_SCK), J5.10; also elsewhere on the board
SYSCLOCK_O: IC6.G13 (SYSCLK_O), J5.9
TCK: IC6.M14 (TCK)
TDI: IC6.K9 (TDI)
TDO: IC6.E11 (ARM_TDO)
TMS: IC6.P10 (TMS)
TRST_N: IC6.P13 (TRST_N)
USB_ID: IC6.M1 (USB_ID), JP1.2
XTAL1: C43.2, IC6.A10 (FFAST_IN), Q1.3 (2)
XTAL2: C41.2, IC6.B10 (FFAST_OUT), Q1.1

Notes on the sheet:
embedded projects GmbH
Holzbachstraße 4
D-86152 Augsburg
Created by Benedikt Sauter
UART zum Debuggen

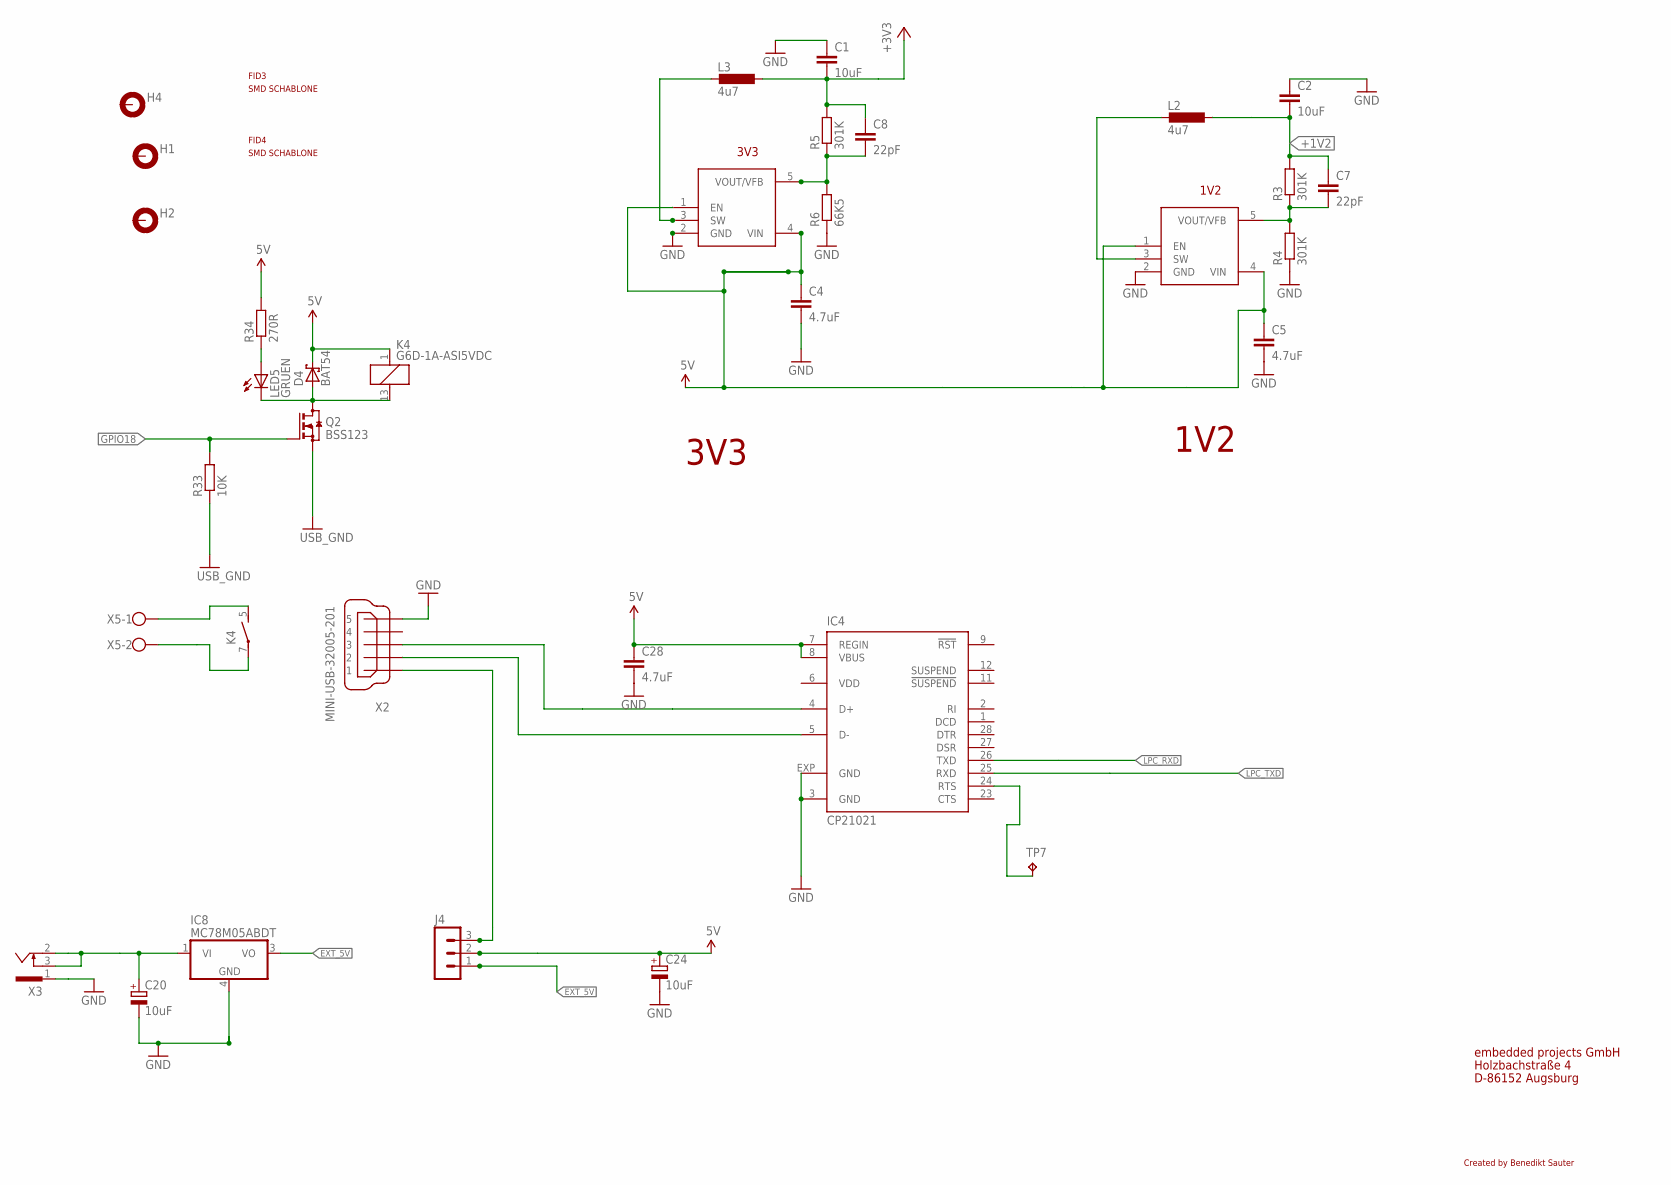
[picture p81: schematic GNUBLIN_LAN_V2.3.sch, sheet 2]

Parts:
C1, C2: 10uF; C0805
C4, C5, C28: 4.7uF; C0805
C7, C8: 22pF; C0805
C20, C24: 10uF; D/7343-31R
D4: BAT54; DIODE_SOT23
FID3, FID4: PASSERMARKEN_FIDUCIAL
H1, H2, H4: MOUNT-PAD-ROUND3.2; 3,2-PAD
IC2, IC3: AS1324; TSOT23
IC4: CP21021; MLP28
IC8: MC78M05ABDT; DPACK_3
J4: MA03-1
K4: G6D-1A-ASI5VDC; RELAY_G6D
L2, L3: 4u7; PSU3014
LED5: GRUEN; CHIP-LED0805
Q2: BSS123; TRANSISTOR-SMALL-SIGNAL_SOT23
R3, R4, R5: 301K; R0805
R6: 66K5; R0805
R33: 10K; R0805
R34: 270R; R0805
TP7: TPTP08R; TP08R
X2: MINI-USB-32005-201; 32005-201
X3: 733980-62
X5: W237-02P; W237-132

Connections:
5V: C4.1, C5.1, C24.+, C28.1, D4.3 (C), IC2.1 (EN), IC2.4 (VIN), IC3.1 (EN), IC3.4 (VIN), IC4.7 (REGIN), IC4.8 (VBUS), J4.2, K4.1, R34.2; also elsewhere on the board
+1V2: C2.2, C7.1, L2.2, R3.2; also elsewhere on the board
+3V3: C1.2, C8.1, L3.2, R5.2; also elsewhere on the board
D+: IC4.4 (D+), X2.3
D-: IC4.5 (D-), X2.2
EXT_5V: IC8.3 (VO), J4.1
GND: C1.1, C2.1, C4.2, C5.2, C20.-, C24.-, C28.2, IC2.2 (GND), IC3.2 (GND), IC4.3 (GND), IC4.EXP (GND), IC8.4 (GND), Q2.2 (S), R4.1, R6.1, R33.1, X2.5, X3.1; also elsewhere on the board
GPIO18: Q2.1 (G), R33.2; also elsewhere on the board
LPC_RXD: IC4.26 (TXD); also elsewhere on the board
LPC_TXD: IC4.25 (RXD); also elsewhere on the board
unnamed: IC2.3 (SW), L2.1
unnamed: J4.3, X2.1
unnamed: IC4.24 (RTS), TP7.TP
unnamed: D4.1 (A), K4.13 (2), LED5.C, Q2.3 (D)
unnamed: C7.2, IC2.5 (VOUT/VFB), R3.1, R4.2
unnamed: LED5.A, R34.1
unnamed: K4.5 (S), X5.1
unnamed: IC3.3 (SW), L3.1
unnamed: C20.+, IC8.1 (VI), X3.2, X3.3
unnamed: C8.2, IC3.5 (VOUT/VFB), R5.1, R6.2
RIGHT: K4.7, X5.2
VDD: IC4.6 (VDD)

Notes on the sheet:
Created by Benedikt Sauter
3V3
1V2
embedded projects GmbH
Holzbachstraße 4
D-86152 Augsburg

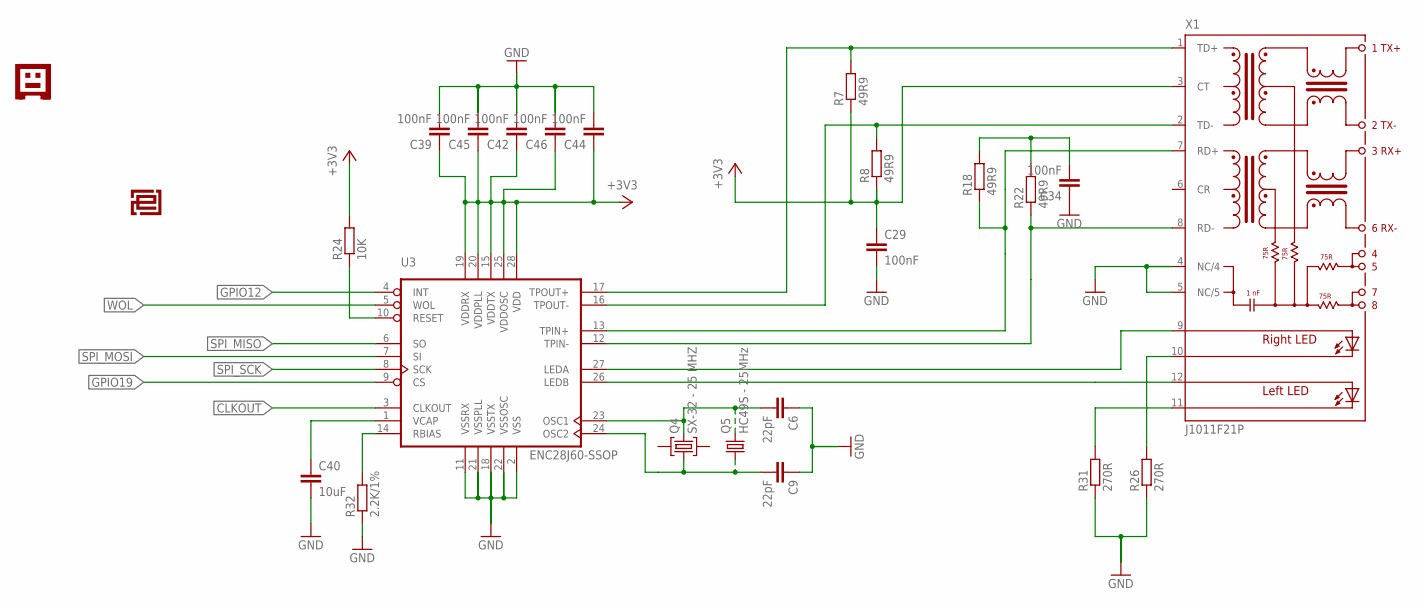
[picture p82: schematic GNUBLIN_LAN_V2.3.sch, sheet 3]

Parts:
C6, C9: 22pF; C0805
C29, C34, C39, C42, C44, C45, C46: 100nF; C0805
C40: 10uF; C0805
Q4: SX-32 - 25 MHZ; SX-32; FARNELL 1712841
Q5: HC49S - 25MHz; HC49/S
R7, R8, R18, R22: 49R9; R0805
R24: 10K; R0805
R26, R31: 270R; R0805
R32: 2.2K/1%; R0805
U3: ENC28J60-SSOP; SSOP28; FARNELL 1084620
U$3: EPLOGOSIEB; EPLOGOSIEBDRUCK
U$7: GNUBLINLOGOSIEB; GNUSIEBDRUCK
X1: J1011F21P; J1

Connections:
+3V3: C29.1, C39.1, C42.1, C44.1, C45.1, C46.1, R7.1, R8.1, R24.2, U3.15 (VDDTX), U3.19 (VDDRX), U3.20 (VDDPLL), U3.25 (VDDOSC), U3.28 (VDD), X1.3 (CT); also elsewhere on the board
CLKOUT: U3.3 (CLKOUT)
GND: C6.1, C9.1, C29.2, C34.1, C39.2, C40.2, C42.2, C44.2, C45.2, C46.2, R26.1, R31.1, R32.1, U3.2 (VSS), U3.11 (VSSRX), U3.18 (VSSTX), U3.21 (VSSPLL), U3.22 (VSSOSC), X1.4 (NC/4), X1.5 (NC/5); also elsewhere on the board
GPIO12: U3.4 (INT); also elsewhere on the board
GPIO19: U3.9 (CS); also elsewhere on the board
LINKACT: R26.2, X1.10 (C-R)
unnamed: C34.2, R18.2, R22.2
unnamed: R24.1, U3.10 (RESET)
unnamed: C40.1, U3.1 (VCAP)
unnamed: U3.27 (LEDA), X1.9 (A-R)
unnamed: R32.2, U3.14 (RBIAS)
unnamed: U3.26 (LEDB), X1.12 (AL)
RX+: R18.1, U3.13 (TPIN+), X1.7 (RD+)
RX-: R22.1, U3.12 (TPIN-), X1.8 (RD-)
SPEED: R31.2, X1.11 (C-L)
SPI_MISO: U3.6 (SO); also elsewhere on the board
SPI_MOSI: U3.7 (SI); also elsewhere on the board
SPI_SCK: U3.8 (SCK); also elsewhere on the board
TX+: R7.2, U3.17 (TPOUT+), X1.1 (TD+)
TX-: R8.2, U3.16 (TPOUT-), X1.2 (TD-)
WOL: U3.5 (WOL)
XT1: C9.2, Q4.1, Q5.1, U3.24 (OSC2)
XT2: C6.2, Q4.3 (2), Q5.2, U3.23 (OSC1)
