embeddedprojects/gnublin-schematics/Board-LAN/GNUBLIN_LAN_V2.3.brd

## EAGLE design Board-LAN/GNUBLIN_LAN_V2.3.brd (continued)

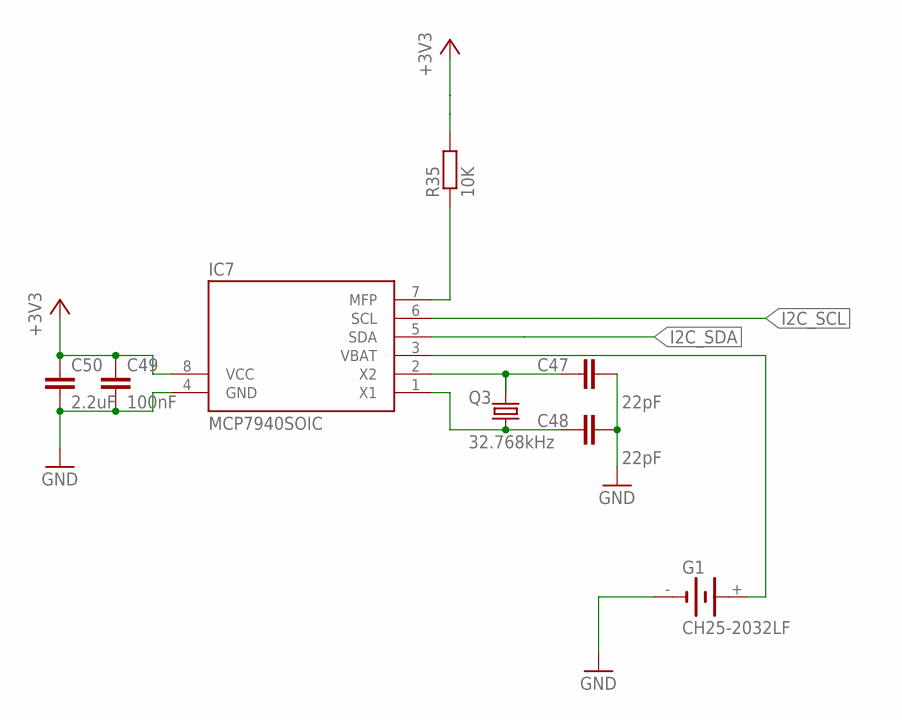
[picture p83: schematic GNUBLIN_LAN_V2.3.sch, sheet 4]

Parts:
C47, C48: 22pF; C0805
C49: 100nF; C0805
C50: 2.2uF; C0805
G1: CH25-2032LF; CH25
IC7: MCP7940SOIC; SOIC-8; FARNELL 2098890
Q3: 32.768kHz; TC26H
R35: 10K; R0805

Connections:
+3V3: C49.1, C50.1, IC7.8 (VCC), R35.2; also elsewhere on the board
GND: C47.2, C48.2, C49.2, C50.2, G1.-, IC7.4 (GND); also elsewhere on the board
I2C_SCL: IC7.6 (SCL); also elsewhere on the board
I2C_SDA: IC7.5 (SDA); also elsewhere on the board
unnamed: IC7.7 (MFP), R35.1
unnamed: C48.1, IC7.1 (X1), Q3.2
unnamed: C47.1, IC7.2 (X2), Q3.1
VBAT: G1.+, IC7.3 (VBAT)

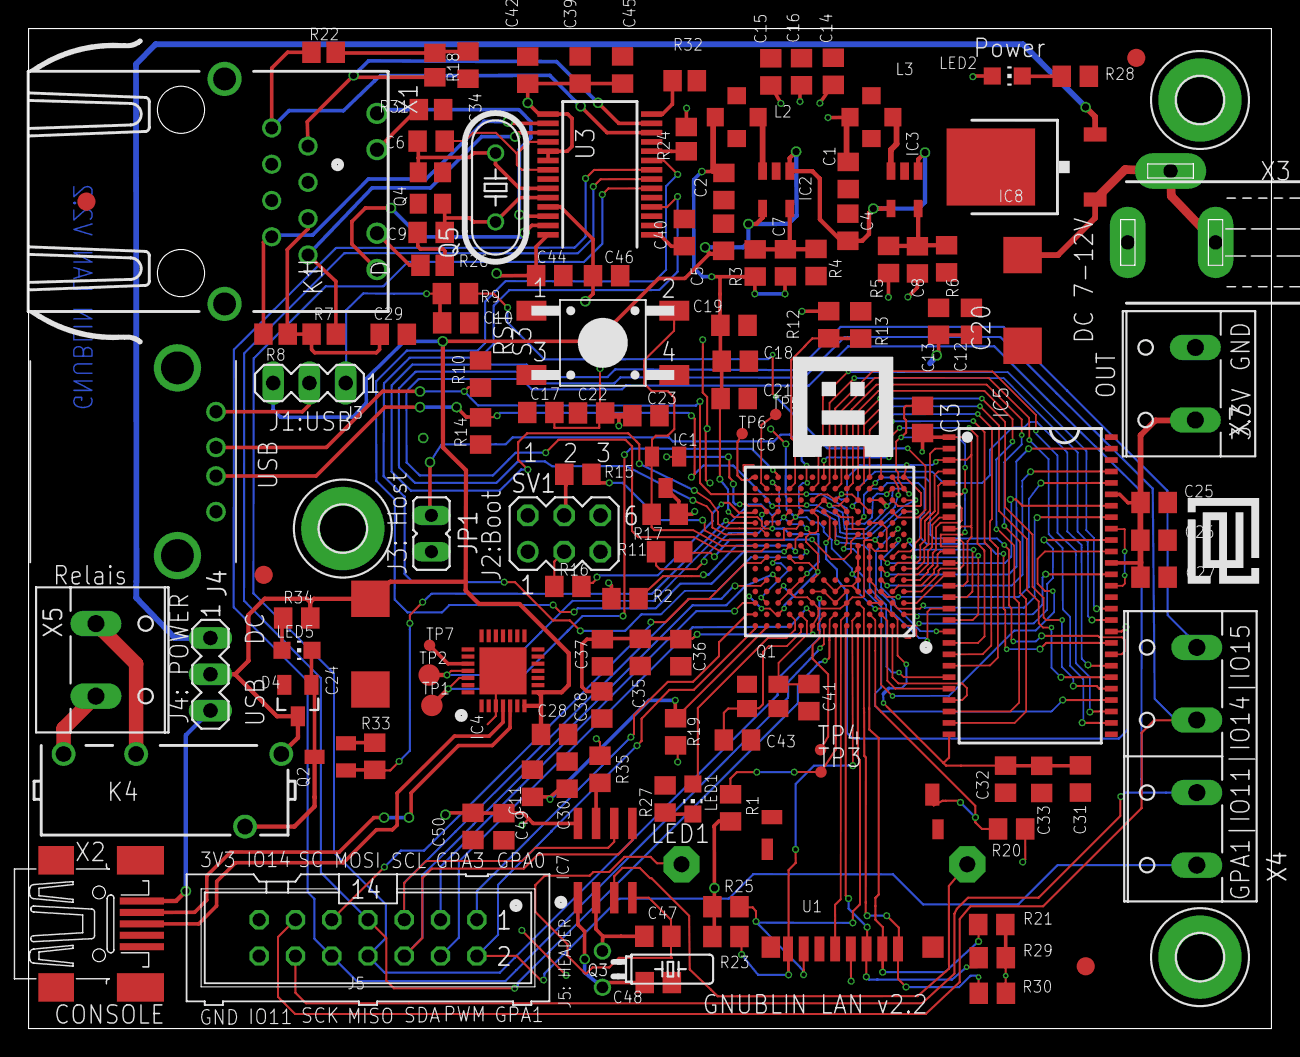
[picture p84: board GNUBLIN_LAN_V2.3.brd from above]

Board: 2 copper layers, 87.0 x 70.0 mm, 137 parts (1 on the bottom side), 124 nets.
