embeddedprojects/gnublin-schematics/Module-GnuPi/MODUL_GNU-PI_BRIDGE_V1001.brd

## EAGLE design Module-GnuPi/MODUL_GNU-PI_BRIDGE_V1001.brd (2013-05-04)

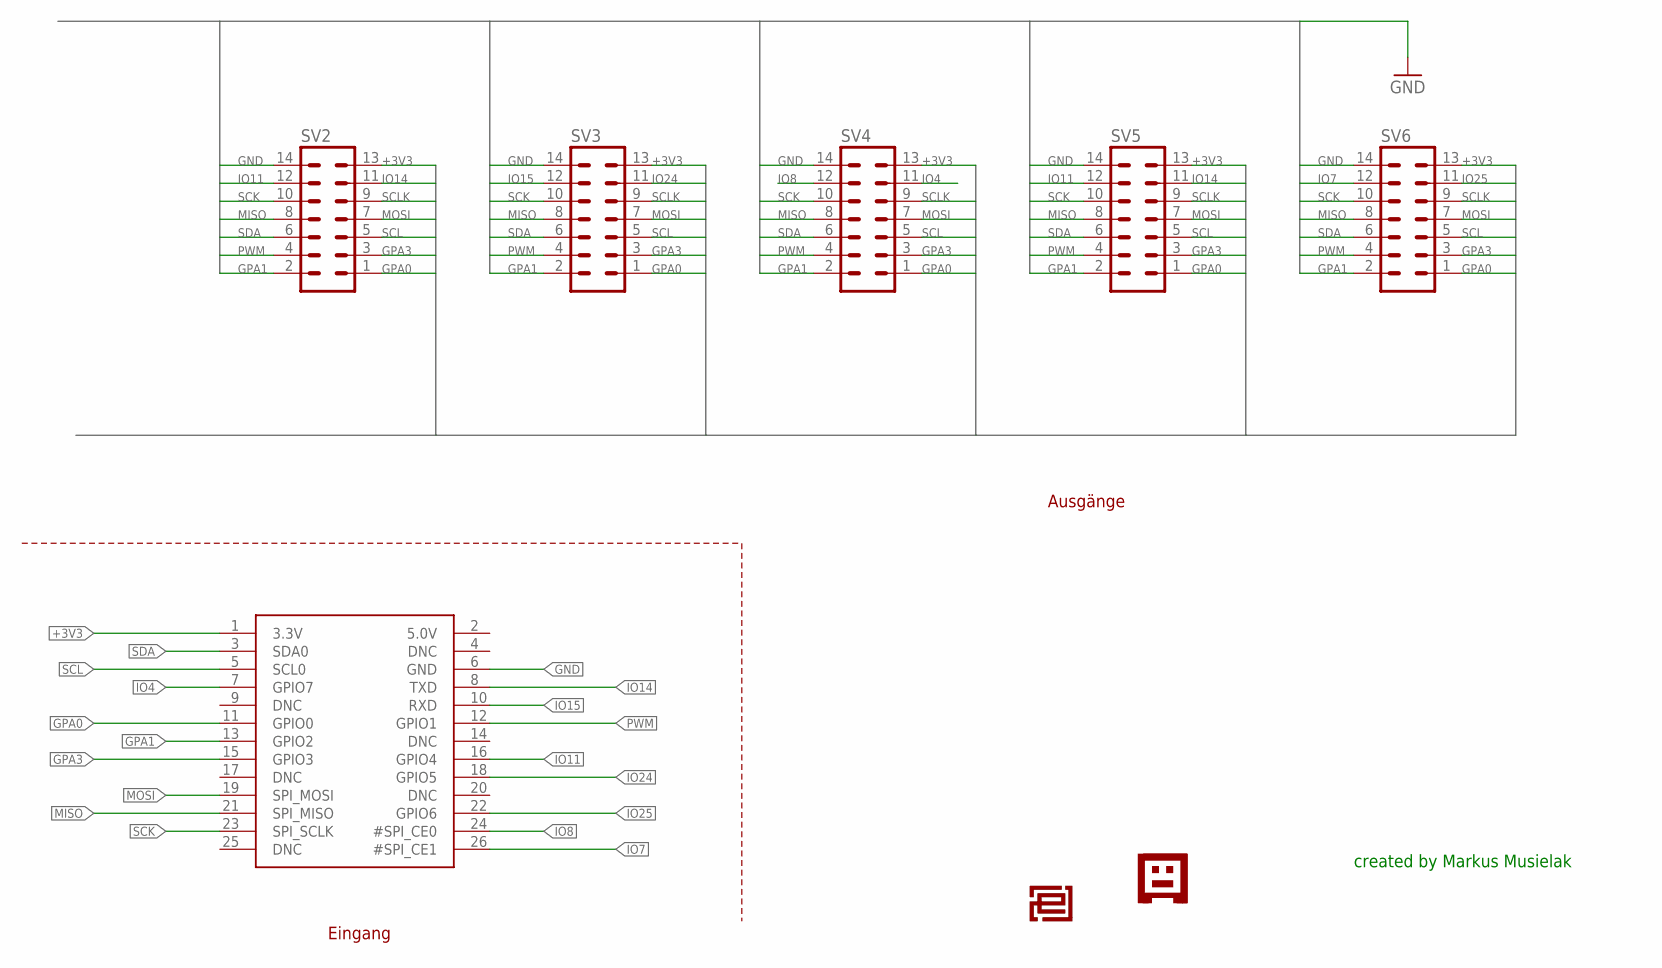
[picture p85: schematic MODUL_GNU-PI_BRIDGE_V1001.sch]

Parts:
SV2, SV3, SV4, SV5, SV6: ML14
U$1: RASPBERRYPI_BB; RASBERRYPI_SHIELD
U$2: EPLOGOSIEB; EPLOGOSIEBDRUCK
U$3: GNUBLINLOGOSIEB; GNUSIEBDRUCK

Connections:
+3V3: SV2.13, SV3.13, SV4.13, SV5.13, SV6.13, U$1.1 (3.3V)
GND: SV2.14, SV3.14, SV4.14, SV5.14, SV6.14, U$1.6 (GND)
GPA0: SV2.1, SV3.1, SV4.1, SV5.1, SV6.1, U$1.11 (GPIO0)
GPA1: SV2.2, SV3.2, SV4.2, SV5.2, SV6.2, U$1.13 (GPIO2)
GPA3: SV2.3, SV3.3, SV4.3, SV5.3, SV6.3, U$1.15 (GPIO3)
IO4: SV4.11, U$1.7 (GPIO7)
IO7: SV6.12, U$1.26 (#SPI_CE1)
IO8: SV4.12, U$1.24 (#SPI_CE0)
IO11: SV2.12, SV5.12, U$1.16 (GPIO4)
IO14: SV2.11, SV5.11, U$1.8 (TXD)
IO15: SV3.12, U$1.10 (RXD)
IO24: SV3.11, U$1.18 (GPIO5)
IO25: SV6.11, U$1.22 (GPIO6)
MISO: SV2.8, SV3.8, SV4.8, SV5.8, SV6.8, U$1.21 (SPI_MISO)
MOSI: SV2.7, SV3.7, SV4.7, SV5.7, SV6.7, U$1.19 (SPI_MOSI)
PWM: SV2.4, SV3.4, SV4.4, SV5.4, SV6.4, U$1.12 (GPIO1)
SCK: SV2.10, SV3.10, SV4.10, SV5.10, SV6.10, U$1.23 (SPI_SCLK)
SCL: SV2.5, SV3.5, SV4.5, SV5.5, SV6.5, U$1.5 (SCL0)
SCLK: SV2.9, SV3.9, SV4.9, SV5.9, SV6.9
SDA: SV2.6, SV3.6, SV4.6, SV5.6, SV6.6, U$1.3 (SDA0)

Notes on the sheet:
created by Markus Musielak
Eingang
Ausgänge

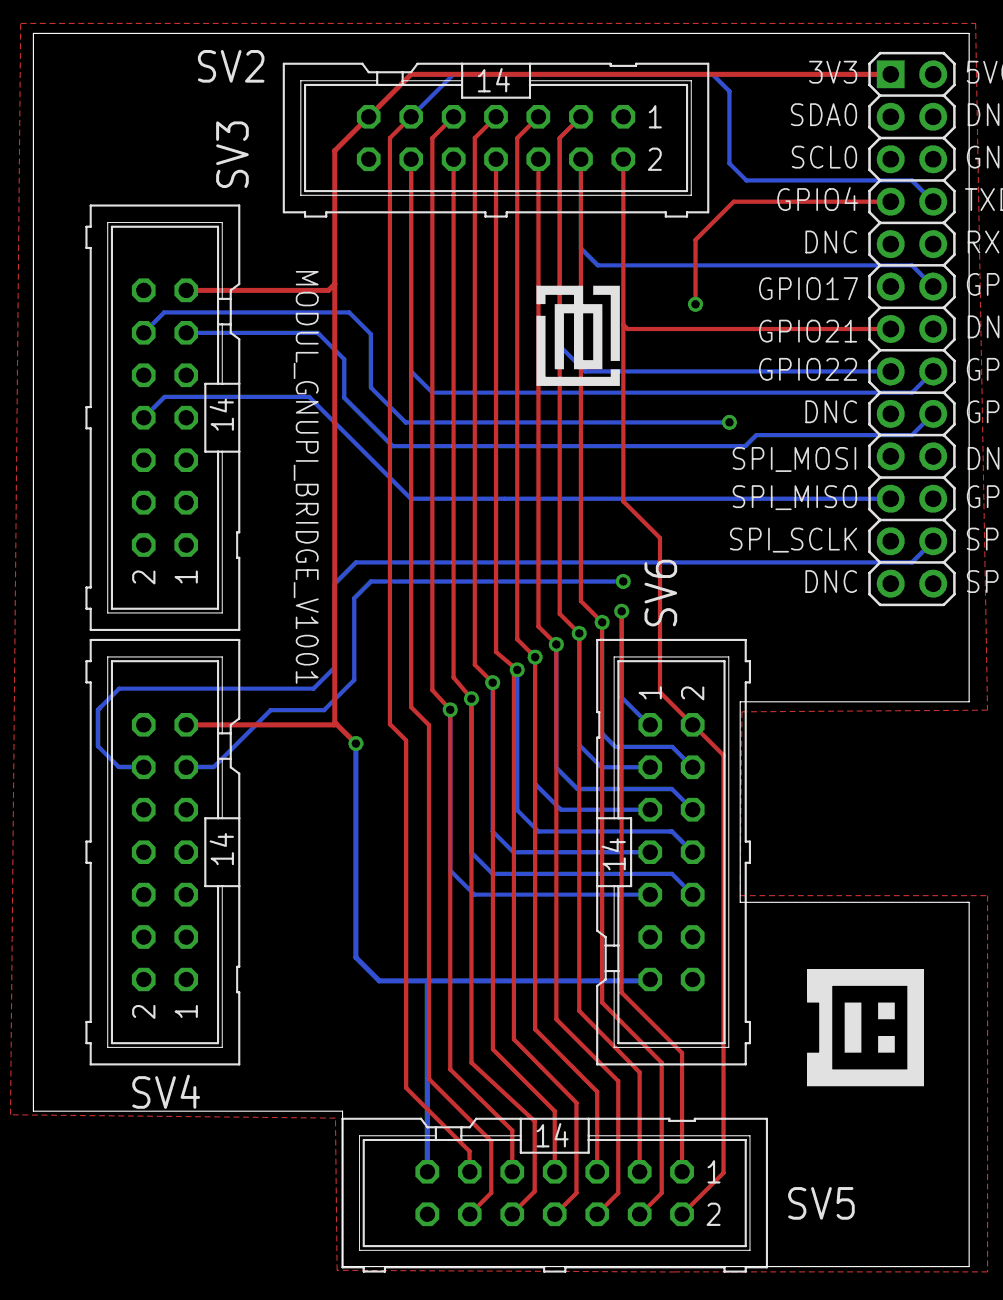
[picture p86: board MODUL_GNU-PI_BRIDGE_V1001.brd from above]

Board: 4 copper layers, 56.0 x 73.8 mm, 8 parts (0 on the bottom side), 20 nets.
