embeddedprojects/gnublin-schematics/Module-CAN/MODUL_CAN_V100.brd

## EAGLE design Module-CAN/MODUL_CAN_V100.brd (2013-05-04)

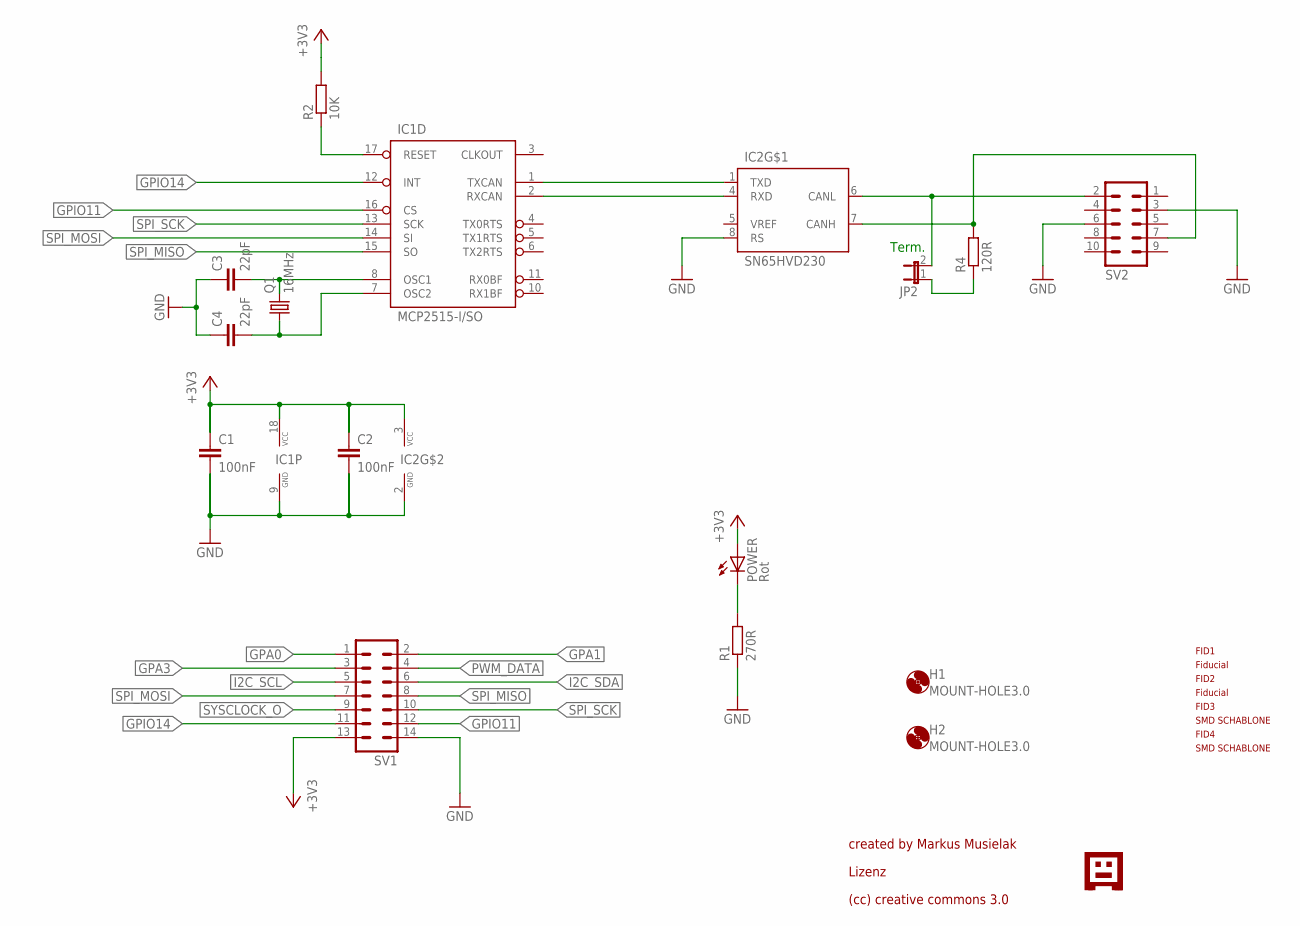
[picture p87: schematic MODUL_CAN_V100.sch]

Parts:
C1, C2: 100nF; C0805
C3, C4: 22pF; C0805
FID1, FID2, FID3, FID4: PASSERMARKEN_FIDUCIAL
H1, H2: MOUNT-HOLE3.0; 3,0
IC1: MCP2515-I/SO; SO-18W; FARNELL 1292239
IC2: SN65HVD230; SO08; FARNELL 1103105
JP2: JP1E; JP1
POWER: Rot; CHIP-LED0805
Q1: 16MHz; HC49UP
R1: 270R; R0805
R2: 10K; R0805
R4: 120R; R0805
SV1: ML14
SV2: ML10
U$2: GNUBLINLOGOSIEB; GNUSIEBDRUCK

Connections:
+3V3: C1.1, C2.1, IC1.18 (VCC), IC2.3 (VCC), POWER.A, R2.2, SV1.13
CANH: IC2.7 (CANH), R4.2, SV2.7
CANL: IC2.6 (CANL), JP2.2, SV2.2
GND: C1.2, C2.2, C3.1, C4.1, IC1.9 (GND), IC2.2 (GND), IC2.8 (RS), R1.1, SV1.14, SV2.3, SV2.6
GPA0: SV1.1
GPA1: SV1.2
GPA3: SV1.3
GPIO11: IC1.16 (CS), SV1.12
GPIO14: IC1.12 (INT), SV1.11
I2C_SCL: SV1.5
I2C_SDA: SV1.6
unnamed: C3.2, IC1.8 (OSC1), Q1.2
unnamed: C4.2, IC1.7 (OSC2), Q1.1
unnamed: IC1.1 (TXCAN), IC2.1 (TXD)
unnamed: IC1.2 (RXCAN), IC2.4 (RXD)
unnamed: IC1.17 (RESET), R2.1
unnamed: POWER.C, R1.2
unnamed: JP2.1, R4.1
PWM_DATA: SV1.4
SPI_MISO: IC1.15 (SO), SV1.8
SPI_MOSI: IC1.14 (SI), SV1.7
SPI_SCK: IC1.13 (SCK), SV1.10
SYSCLOCK_O: SV1.9

Notes on the sheet:
created by Markus Musielak
Term.
Lizenz
(cc) creative commons 3.0

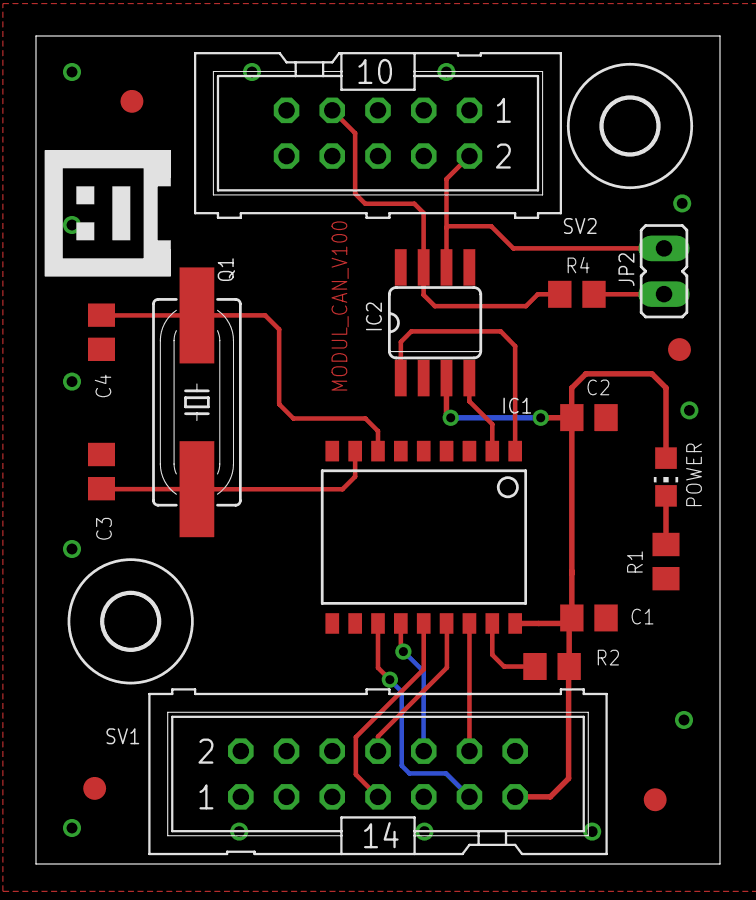
[picture p88: board MODUL_CAN_V100.brd from above]

Board: 2 copper layers, 38.0 x 46.0 mm, 21 parts (0 on the bottom side), 16 nets.
