embeddedprojects/gnublin-schematics/Module-ADC/MODUL_ADC_V101.brd

## EAGLE design Module-ADC/MODUL_ADC_V101.brd (2013-05-04)

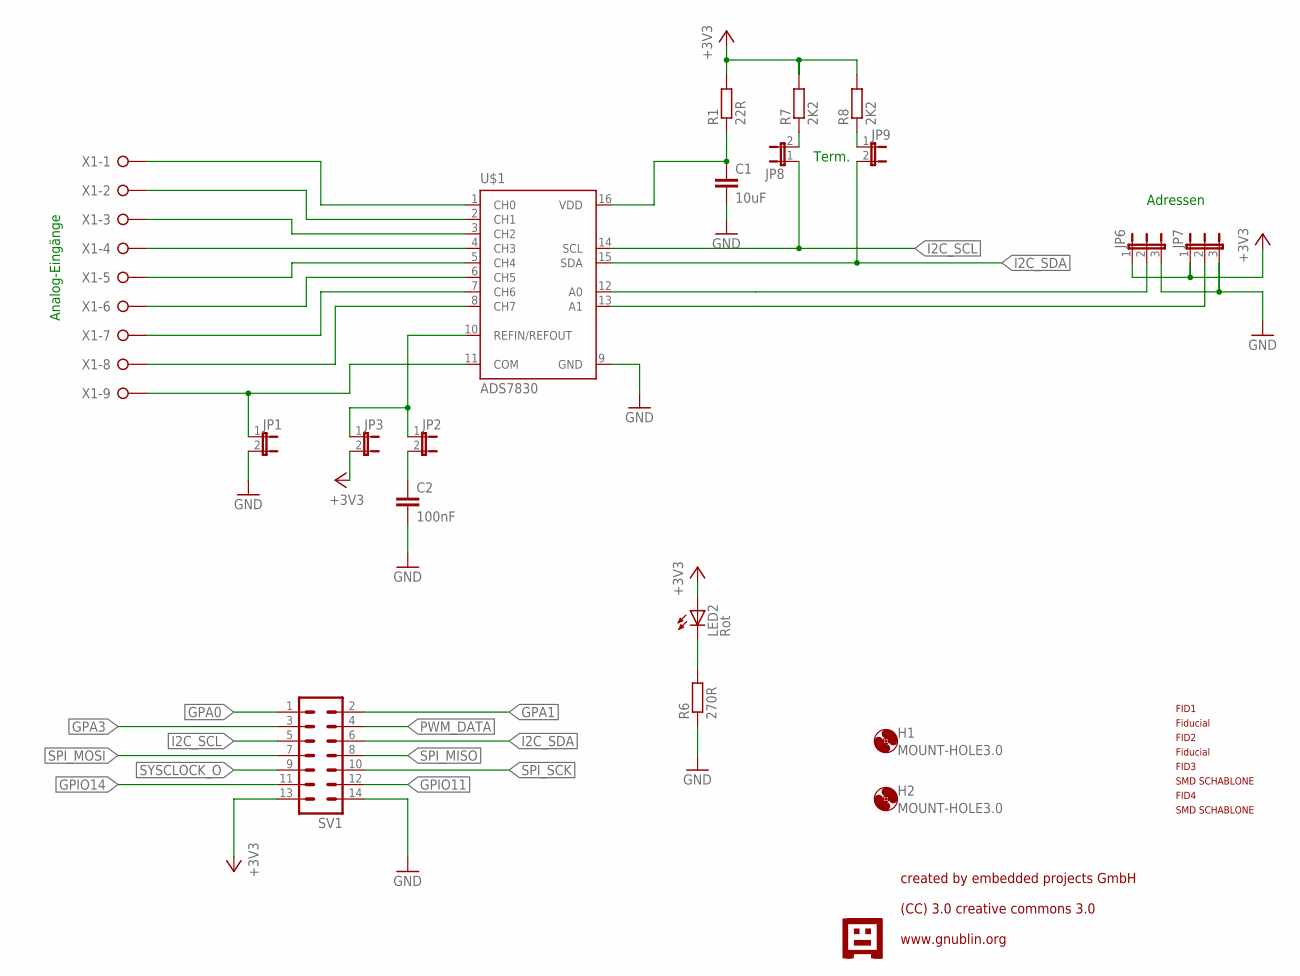
[picture p89: schematic MODUL_ADC_V101.sch]

Parts:
C1: 10uF; C0805
C2: 100nF; C0805
FID1, FID2, FID3, FID4: PASSERMARKEN_FIDUCIAL
H1, H2: MOUNT-HOLE3.0; 3,0
JP1, JP2, JP3, JP8, JP9: JP1E; JP1
JP6, JP7: JP2E; JP2
LED2: Rot; CHIP-LED0805
R1: 22R; R0805
R6: 270R; R0805
R7, R8: 2K2; R0805
SV1: ML14
U$1: ADS7830; TSSOP16; FARNELL 1180129
U$2: GNUBLINLOGOSIEB; GNUSIEBDRUCK
X1: W237-09P; W237-9P

Connections:
+3V3: JP3.2, JP6.1, JP7.1, LED2.A, R1.2, R7.2, R8.2, SV1.13
A0: JP6.2, U$1.12 (A0)
A1: JP7.2, U$1.13 (A1)
GND: C1.2, C2.2, JP1.2, JP6.3, JP7.3, R6.1, SV1.14, U$1.9 (GND)
GPA0: SV1.1
GPA1: SV1.2
GPA3: SV1.3
GPIO11: SV1.12
GPIO14: SV1.11
I2C_SCL: JP8.1, SV1.5, U$1.14 (SCL)
I2C_SDA: JP9.2, SV1.6, U$1.15 (SDA)
unnamed: C1.1, R1.1, U$1.16 (VDD)
unnamed: JP2.1, JP3.1, U$1.10 (REFIN/REFOUT)
unnamed: U$1.1 (CH0), X1.1
unnamed: U$1.2 (CH1), X1.2
unnamed: U$1.3 (CH2), X1.3
unnamed: U$1.4 (CH3), X1.4
unnamed: U$1.5 (CH4), X1.5
unnamed: U$1.6 (CH5), X1.6
unnamed: LED2.C, R6.2
unnamed: U$1.7 (CH6), X1.7
unnamed: U$1.8 (CH7), X1.8
unnamed: JP1.1, U$1.11 (COM), X1.9
unnamed: C2.1, JP2.2
unnamed: JP8.2, R7.1
unnamed: JP9.1, R8.1
PWM_DATA: SV1.4
SPI_MISO: SV1.8
SPI_MOSI: SV1.7
SPI_SCK: SV1.10
SYSCLOCK_O: SV1.9

Notes on the sheet:
Term.
Adressen
Analog-Eingänge
created by embedded projects GmbH (CC) 3.0 creative commons 3.0 www.gnublin.org

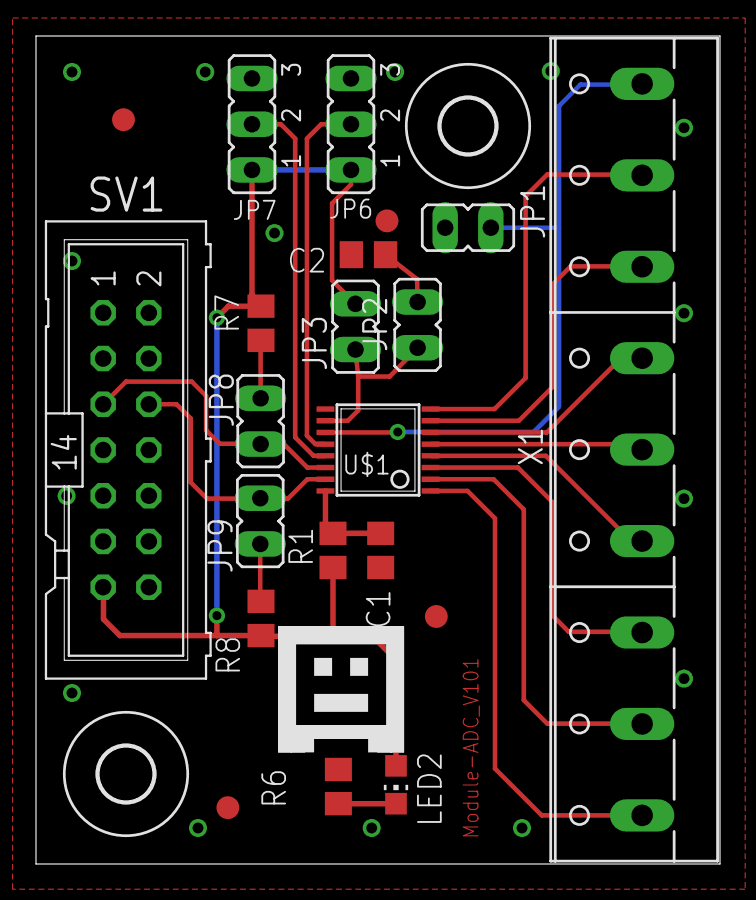
[picture p90: board MODUL_ADC_V101.brd from above]

Board: 2 copper layers, 38.0 x 46.0 mm, 24 parts (0 on the bottom side), 21 nets.
