embeddedprojects/gnublin-schematics/Module-IOExpander/MODUL_PORTEXP_V101.brd

## EAGLE design Module-IOExpander/MODUL_PORTEXP_V101.brd (2013-05-04)

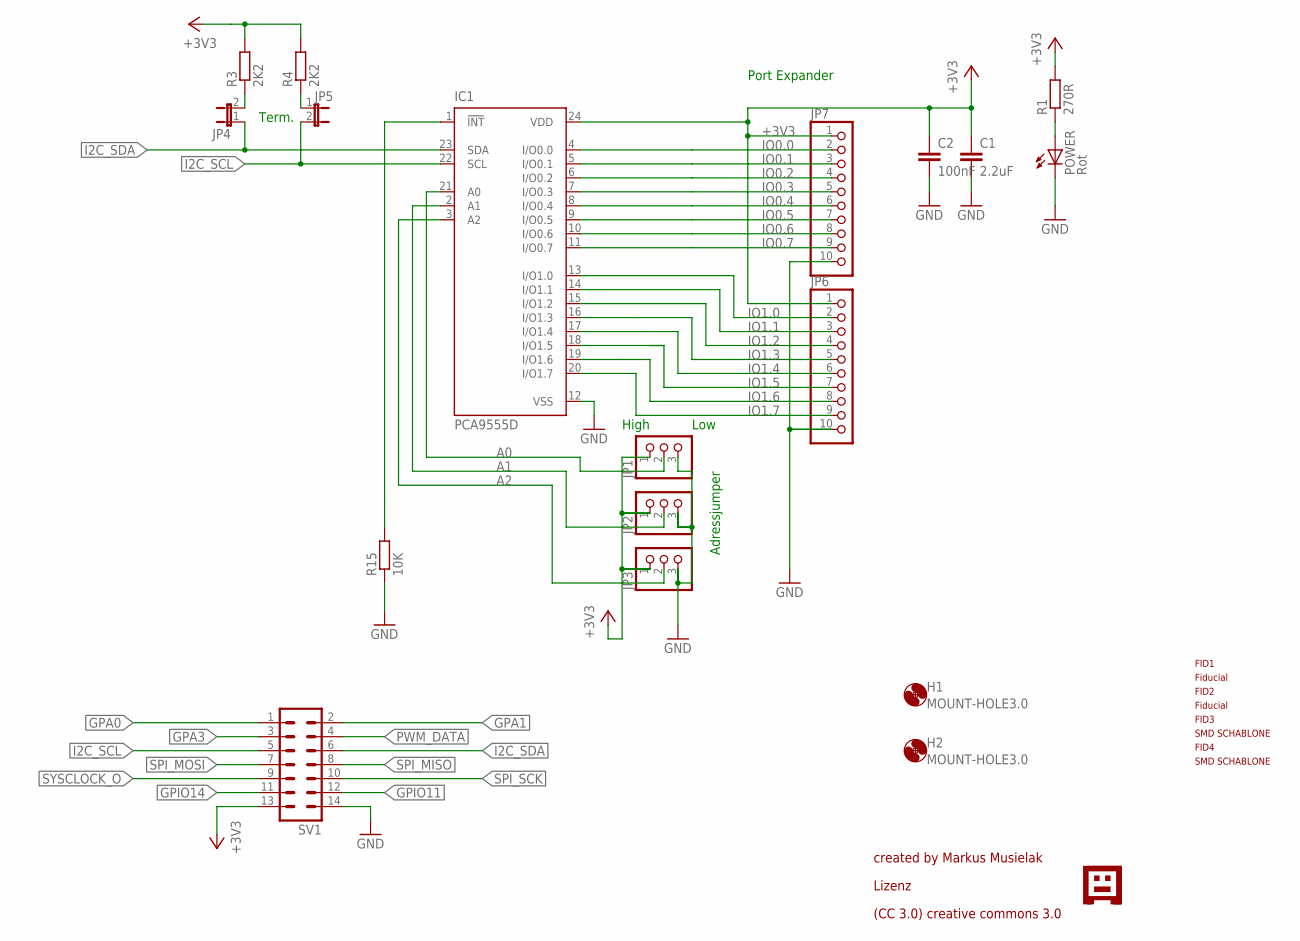
[picture p91: schematic MODUL_PORTEXP_V101.sch]

Parts:
C1: 2.2uF; C0805
C2: 100nF; C0805
FID1, FID2, FID3, FID4: PASSERMARKEN_FIDUCIAL
H1, H2: MOUNT-HOLE3.0; 3,0
IC1: PCA9555D; SO24
JP1, JP2, JP3: PINHD-1X3; 1X03
JP4, JP5: JP1E; JP1
JP6, JP7: PINHD-1X10; 1X10
POWER: Rot; CHIP-LED0805
R1: 270R; R0805
R3, R4: 2K2; R0805
R15: 10K; R0805
SV1: ML14
U$2: GNUBLINLOGOSIEB; GNUSIEBDRUCK

Connections:
!INT: IC1.1 (!INT), R15.2
+3V3: C1.1, C2.1, IC1.24 (VDD), JP1.1, JP2.1, JP3.1, JP6.1, JP7.1, R1.2, R3.2, R4.2, SV1.13
A0: IC1.21 (A0), JP1.2
A1: IC1.2 (A1), JP2.2
A2: IC1.3 (A2), JP3.2
GND: C1.2, C2.2, IC1.12 (VSS), JP1.3, JP2.3, JP3.3, JP6.10, JP7.10, POWER.C, R15.1, SV1.14
GPA0: SV1.1
GPA1: SV1.2
GPA3: SV1.3
GPIO11: SV1.12
GPIO14: SV1.11
I2C_SCL: IC1.22 (SCL), JP5.2, SV1.5
I2C_SDA: IC1.23 (SDA), JP4.1, SV1.6
IO0.0: IC1.4 (I/O0.0), JP7.2
IO0.1: IC1.5 (I/O0.1), JP7.3
IO0.2: IC1.6 (I/O0.2), JP7.4
IO0.3: IC1.7 (I/O0.3), JP7.5
IO0.4: IC1.8 (I/O0.4), JP7.6
IO0.5: IC1.9 (I/O0.5), JP7.7
IO0.6: IC1.10 (I/O0.6), JP7.8
IO0.7: IC1.11 (I/O0.7), JP7.9
IO1.0: IC1.13 (I/O1.0), JP6.2
IO1.1: IC1.14 (I/O1.1), JP6.3
IO1.2: IC1.15 (I/O1.2), JP6.4
IO1.3: IC1.16 (I/O1.3), JP6.5
IO1.4: IC1.17 (I/O1.4), JP6.6
IO1.5: IC1.18 (I/O1.5), JP6.7
IO1.6: IC1.19 (I/O1.6), JP6.8
IO1.7: IC1.20 (I/O1.7), JP6.9
unnamed: JP4.2, R3.1
unnamed: POWER.A, R1.1
unnamed: JP5.1, R4.1
PWM_DATA: SV1.4
SPI_MISO: SV1.8
SPI_MOSI: SV1.7
SPI_SCK: SV1.10
SYSCLOCK_O: SV1.9

Notes on the sheet:
Port Expander
Adressjumper
Term.
High
Low
created by Markus Musielak
Lizenz
(CC 3.0) creative commons 3.0

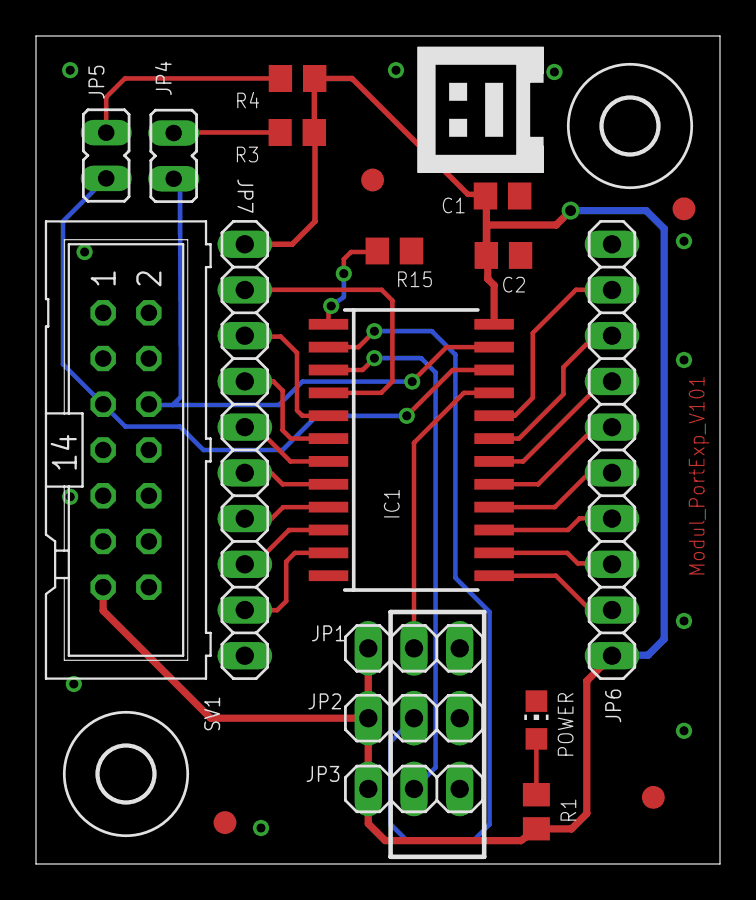
[picture p92: board MODUL_PORTEXP_V101.brd from above]

Board: 2 copper layers, 38.0 x 46.0 mm, 23 parts (0 on the bottom side), 27 nets.
