embeddedprojects/gnublin-schematics/Module-Relay/MODUL_RELAIS_8_V101.brd

## EAGLE design Module-Relay/MODUL_RELAIS_8_V101.brd (2013-05-04)

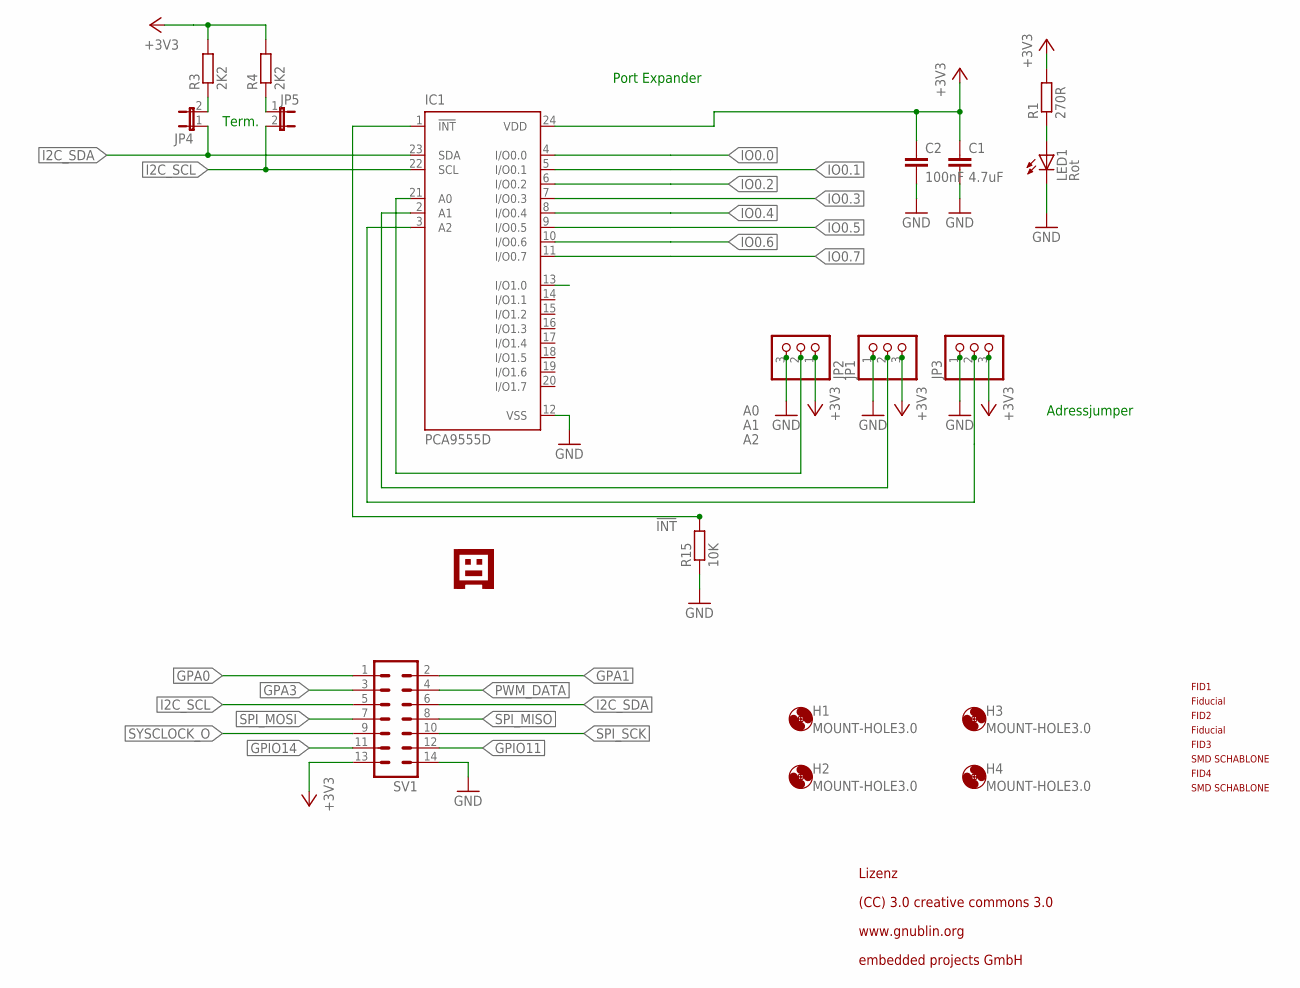
[picture p93: schematic MODUL_RELAIS_8_V101.sch, sheet 1]

Parts:
C1: 4.7uF; C0805
C2: 100nF; C0805
FID1, FID2, FID3, FID4: PASSERMARKEN_FIDUCIAL
H1, H2, H3, H4: MOUNT-HOLE3.0; 3,0
IC1: PCA9555D; SO24
JP1, JP2, JP3: PINHD-1X3; 1X03
JP4, JP5: JP1E; JP1
LED1: Rot; CHIP-LED0805
R1: 270R; R0805
R3, R4: 2K2; R0805
R15: 10K; R0805
SV1: ML14
U$1: GNUBLINLOGOSIEB; GNUSIEBDRUCK

Connections:
!INT: IC1.1 (!INT), R15.2
+3V3: C1.1, C2.1, IC1.24 (VDD), JP1.3, JP2.1, JP3.3, R1.2, R3.2, R4.2, SV1.13; also elsewhere on the board
A0: IC1.21 (A0), JP2.2
A1: IC1.2 (A1), JP1.2
A2: IC1.3 (A2), JP3.2
GND: C1.2, C2.2, IC1.12 (VSS), JP1.1, JP2.3, JP3.1, LED1.C, R15.1, SV1.14; also elsewhere on the board
GPA0: SV1.1
GPA1: SV1.2
GPA3: SV1.3
GPIO11: SV1.12
GPIO14: SV1.11
I2C_SCL: IC1.22 (SCL), JP5.2, SV1.5
I2C_SDA: IC1.23 (SDA), JP4.1, SV1.6
IO0.0: IC1.4 (I/O0.0); also elsewhere on the board
IO0.1: IC1.5 (I/O0.1); also elsewhere on the board
IO0.2: IC1.6 (I/O0.2); also elsewhere on the board
IO0.3: IC1.7 (I/O0.3); also elsewhere on the board
IO0.4: IC1.8 (I/O0.4); also elsewhere on the board
IO0.5: IC1.9 (I/O0.5); also elsewhere on the board
IO0.6: IC1.10 (I/O0.6); also elsewhere on the board
IO0.7: IC1.11 (I/O0.7); also elsewhere on the board
IO1.0: IC1.13 (I/O1.0)
unnamed: JP4.2, R3.1
unnamed: LED1.A, R1.1
unnamed: JP5.1, R4.1
PWM_DATA: SV1.4
SPI_MISO: SV1.8
SPI_MOSI: SV1.7
SPI_SCK: SV1.10
SYSCLOCK_O: SV1.9

Notes on the sheet:
Port Expander
Adressjumper
Term.
(CC) 3.0 creative commons 3.0
Lizenz
www.gnublin.org
embedded projects GmbH

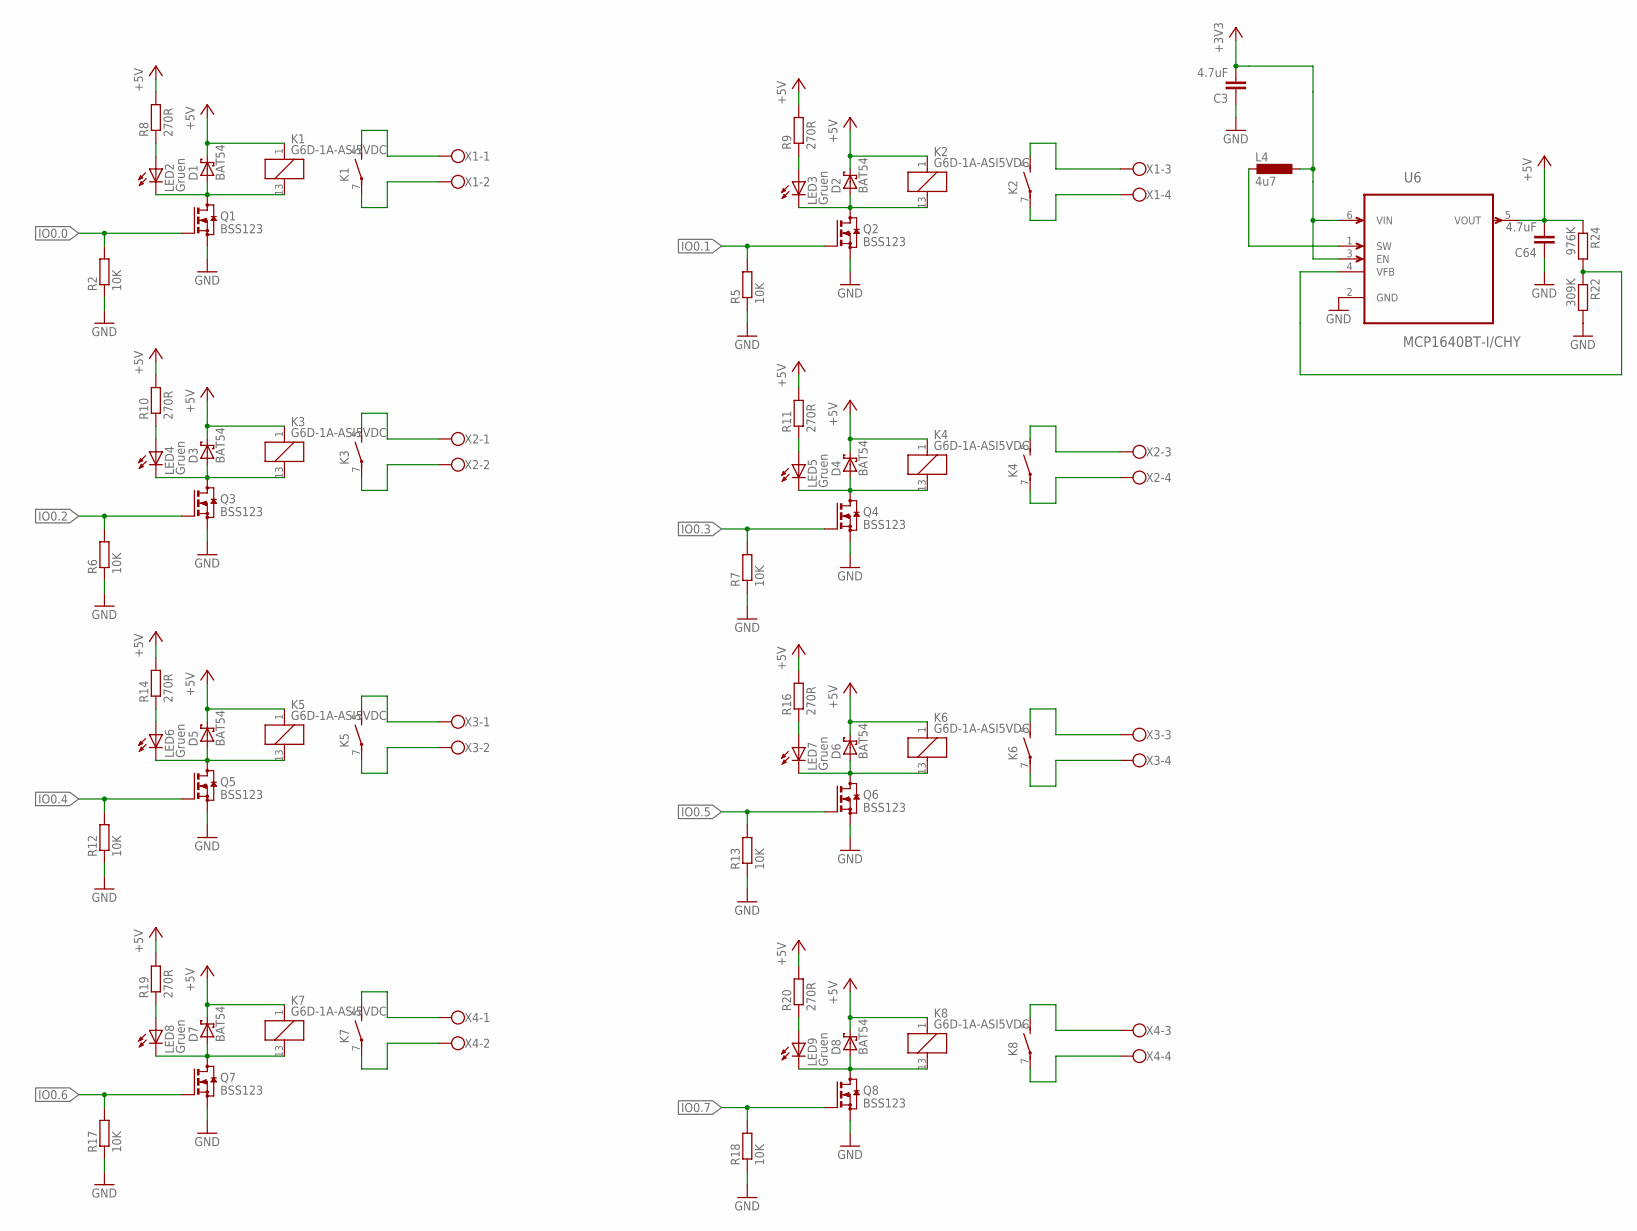
[picture p94: schematic MODUL_RELAIS_8_V101.sch, sheet 2]

Parts:
C3, C64: 4.7uF; C0805
D1, D2, D3, D4, D5, D6, D7, D8: BAT54; DIODE_SOT23
K1, K2, K3, K4, K5, K6, K7, K8: G6D-1A-ASI5VDC; RELAY_G6D
L4: 4u7; PSU3014
LED2, LED3, LED4, LED5, LED6, LED7, LED8, LED9: Gruen; CHIP-LED0805
Q1, Q2, Q3, Q4, Q5, Q6, Q7, Q8: BSS123; TRANSISTOR-SMALL-SIGNAL_SOT23
R2, R5, R6, R7, R12, R13, R17, R18: 10K; R0805
R8, R9, R10, R11, R14, R16, R19, R20: 270R; R0805
R22: 309K; R0805
R24: 976K; R0805
U6: MCP1640BT-I/CHY; SOT95P270X145-6N
X1, X2, X3, X4: W237-04P; W237-4P

Connections:
+3V3: C3.2, L4.2, U6.3 (EN), U6.6 (VIN); also elsewhere on the board
+5V: C64.2, D1.3 (C), D2.3 (C), D3.3 (C), D4.3 (C), D5.3 (C), D6.3 (C), D7.3 (C), D8.3 (C), K1.1, K2.1, K3.1, K4.1, K5.1, K6.1, K7.1, K8.1, R8.2, R9.2, R10.2, R11.2, R14.2, R16.2, R19.2, R20.2, R24.1, U6.5 (VOUT)
ENABLE_5V: L4.1, U6.1 (SW)
GND: C3.1, C64.1, Q1.2 (S), Q2.2 (S), Q3.2 (S), Q4.2 (S), Q5.2 (S), Q6.2 (S), Q7.2 (S), Q8.2 (S), R2.1, R5.1, R6.1, R7.1, R12.1, R13.1, R17.1, R18.1, R22.2, U6.2 (GND); also elsewhere on the board
IO0.0: Q1.1 (G), R2.2; also elsewhere on the board
IO0.1: Q2.1 (G), R5.2; also elsewhere on the board
IO0.2: Q3.1 (G), R6.2; also elsewhere on the board
IO0.3: Q4.1 (G), R7.2; also elsewhere on the board
IO0.4: Q5.1 (G), R12.2; also elsewhere on the board
IO0.5: Q6.1 (G), R13.2; also elsewhere on the board
IO0.6: Q7.1 (G), R17.2; also elsewhere on the board
IO0.7: Q8.1 (G), R18.2; also elsewhere on the board
unnamed: D1.1 (A), K1.13 (2), LED2.C, Q1.3 (D)
unnamed: LED2.A, R8.1
unnamed: D2.1 (A), K2.13 (2), LED3.C, Q2.3 (D)
unnamed: LED3.A, R9.1
unnamed: K1.5 (S), X1.1
unnamed: K1.7, X1.2
unnamed: K2.5 (S), X1.3
unnamed: K2.7, X1.4
unnamed: D3.1 (A), K3.13 (2), LED4.C, Q3.3 (D)
unnamed: D4.1 (A), K4.13 (2), LED5.C, Q4.3 (D)
unnamed: LED4.A, R10.1
unnamed: LED5.A, R11.1
unnamed: K3.5 (S), X2.1
unnamed: K3.7, X2.2
unnamed: K4.5 (S), X2.3
unnamed: K4.7, X2.4
unnamed: D5.1 (A), K5.13 (2), LED6.C, Q5.3 (D)
unnamed: D6.1 (A), K6.13 (2), LED7.C, Q6.3 (D)
unnamed: LED6.A, R14.1
unnamed: LED7.A, R16.1
unnamed: K5.5 (S), X3.1
unnamed: K5.7, X3.2
unnamed: K6.5 (S), X3.3
unnamed: K6.7, X3.4
unnamed: D7.1 (A), K7.13 (2), LED8.C, Q7.3 (D)
unnamed: D8.1 (A), K8.13 (2), LED9.C, Q8.3 (D)
unnamed: LED8.A, R19.1
unnamed: LED9.A, R20.1
unnamed: K7.5 (S), X4.1
unnamed: K7.7, X4.2
unnamed: K8.5 (S), X4.3
unnamed: K8.7, X4.4
unnamed: R22.1, R24.2, U6.4 (VFB)

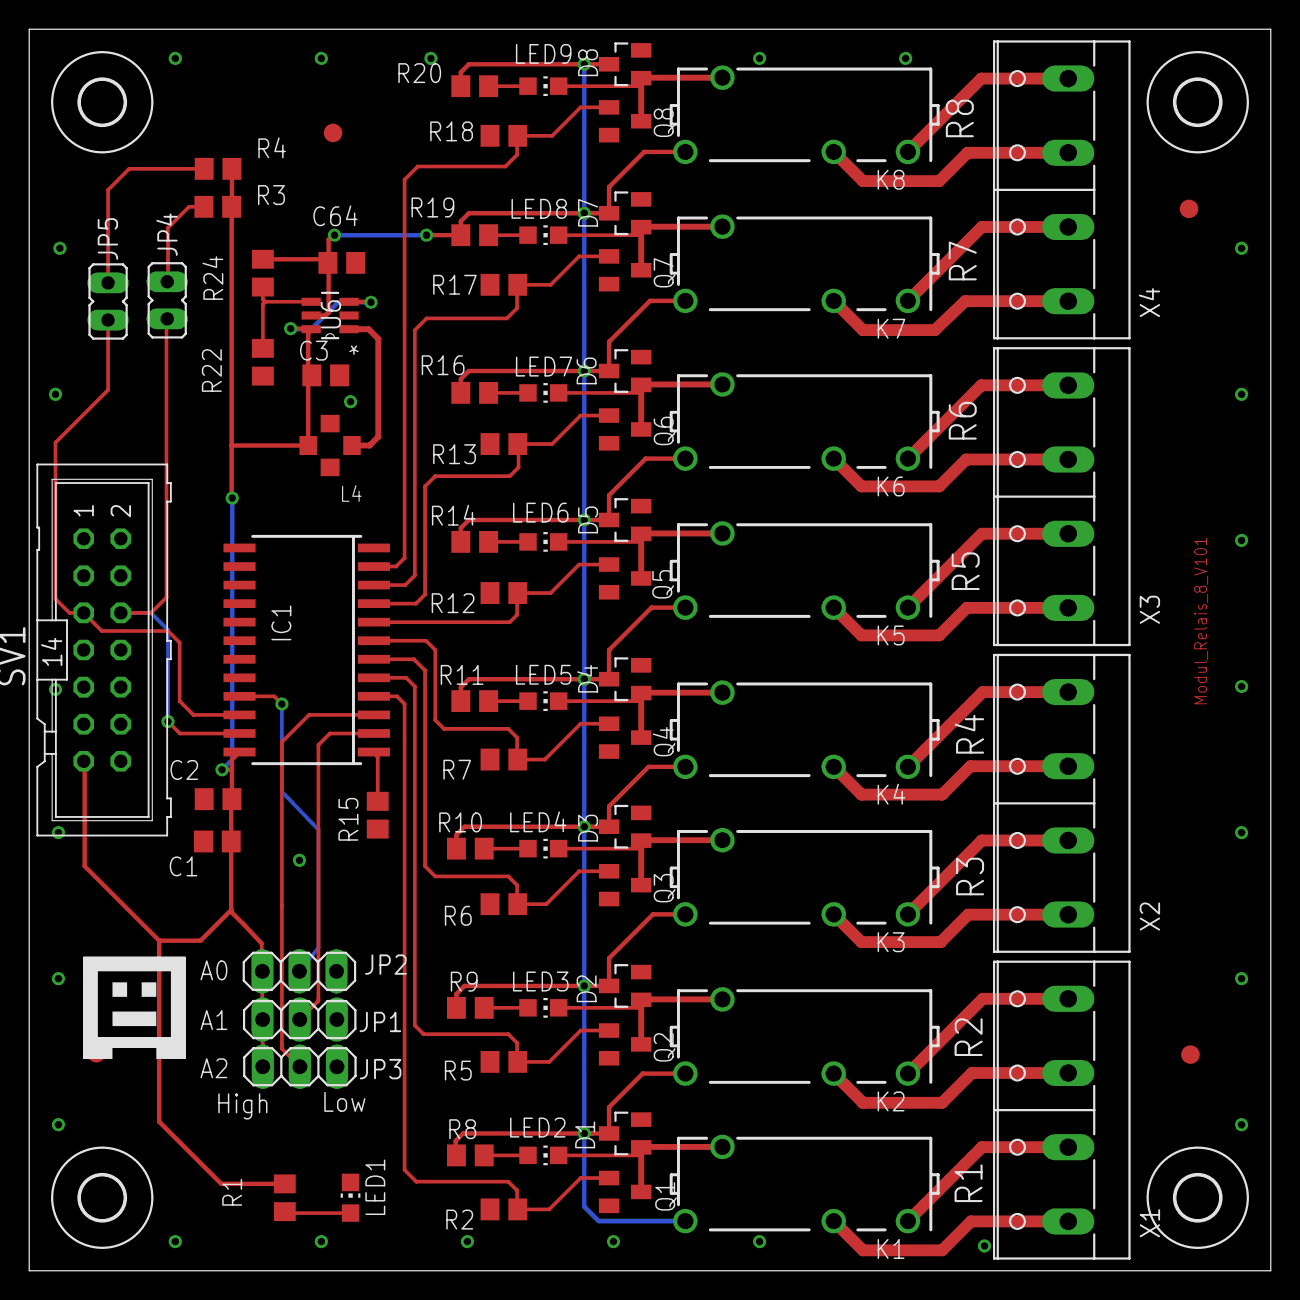
[picture p95: board MODUL_RELAIS_8_V101.brd from above]

Board: 2 copper layers, 85.0 x 85.0 mm, 81 parts (0 on the bottom side), 54 nets.
