embeddedprojects/gnublin-schematics/Module-LM75/MODUL_TEMPERATURE_V100.brd

## EAGLE design Module-LM75/MODUL_TEMPERATURE_V100.brd (2013-05-04)

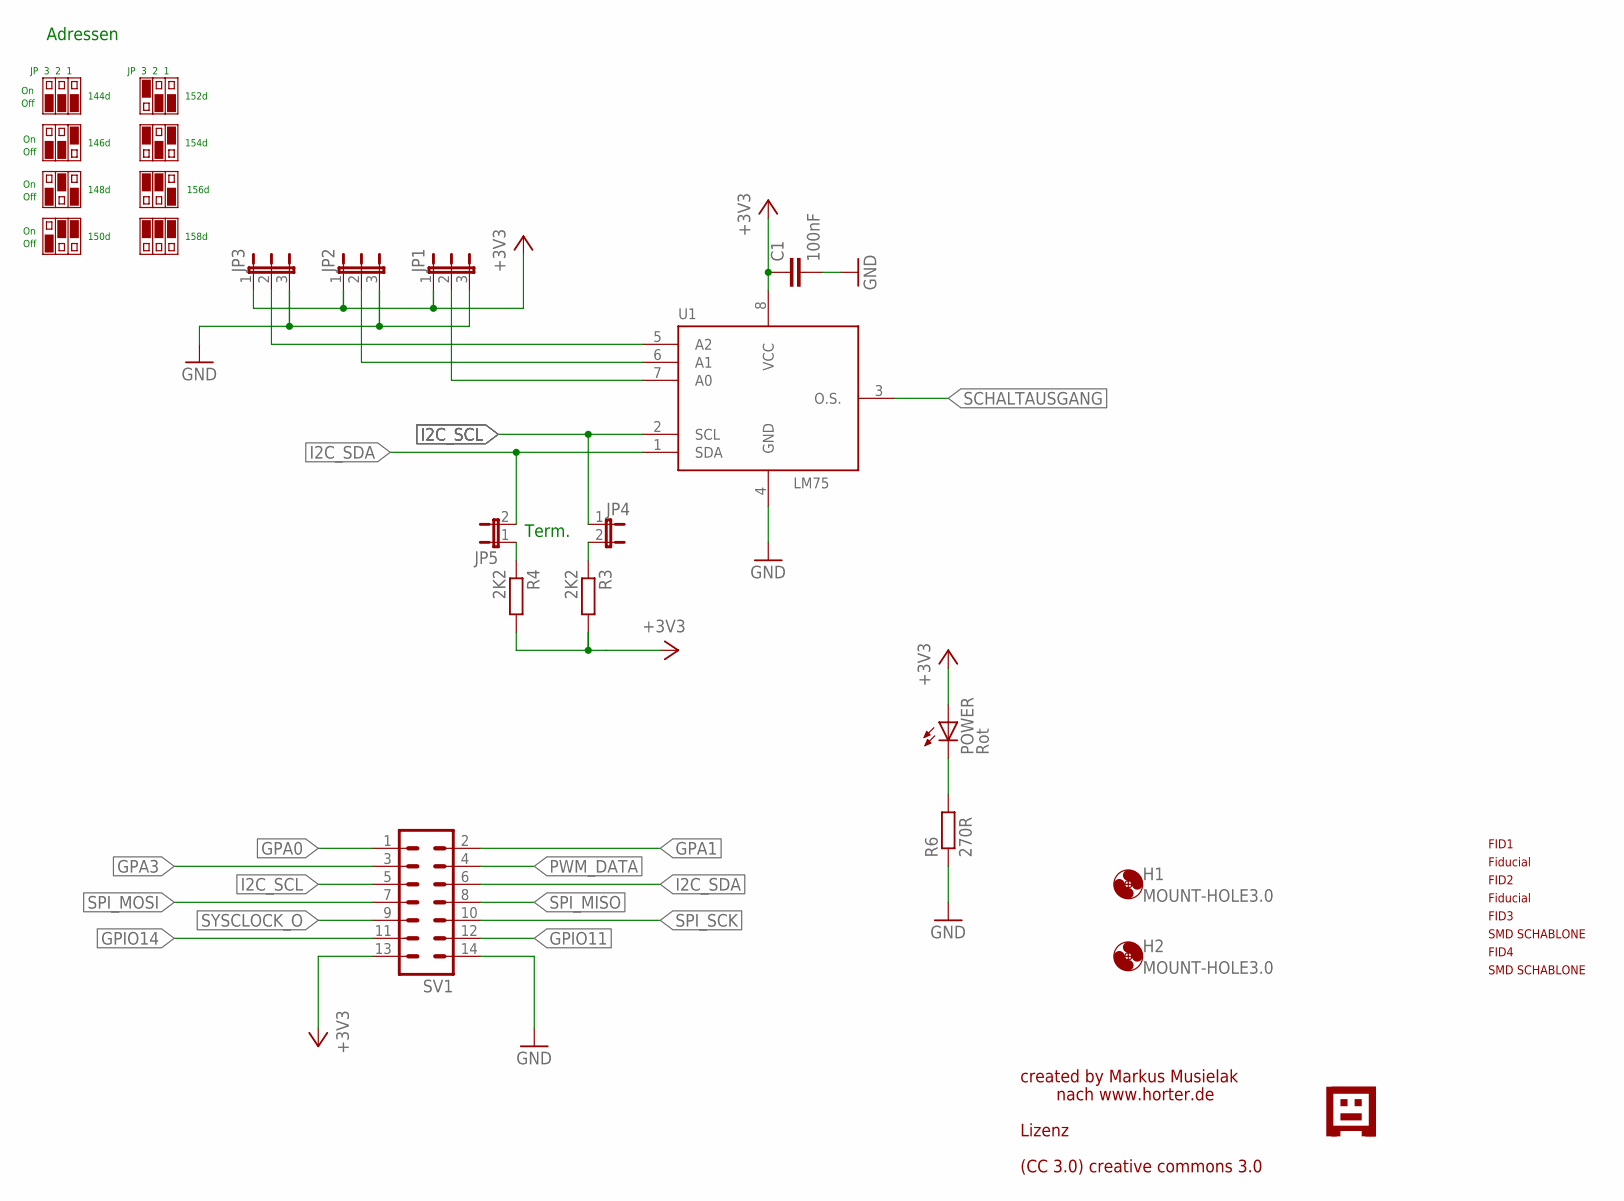
[picture p96: schematic MODUL_TEMPERATURE_V100.sch]

Parts:
C1: 100nF; C0805
FID1, FID2, FID3, FID4: PASSERMARKEN_FIDUCIAL
H1, H2: MOUNT-HOLE3.0; 3,0
JP1, JP2, JP3: JP2E; JP2
JP4, JP5: JP1E; JP1
POWER: Rot; CHIP-LED0805
R3, R4: 2K2; R0805
R6: 270R; R0805
SV1: ML14
U1: LM75; SO-8; FARNELL 1699380
U$1: GNUBLINLOGOSIEB; GNUSIEBDRUCK

Connections:
+3V3: C1.1, JP1.1, JP2.1, JP3.1, POWER.A, R3.2, R4.2, SV1.13, U1.8 (VCC)
GND: C1.2, JP1.3, JP2.3, JP3.3, R6.1, SV1.14, U1.4 (GND)
GPA0: SV1.1
GPA1: SV1.2
GPA3: SV1.3
GPIO11: SV1.12
GPIO14: SV1.11
I2C_SCL: JP4.1, SV1.5, U1.2 (SCL)
I2C_SDA: JP5.2, SV1.6, U1.1 (SDA)
unnamed: JP1.2, U1.7 (A0)
unnamed: JP2.2, U1.6 (A1)
unnamed: JP3.2, U1.5 (A2)
unnamed: JP4.2, R3.1
unnamed: JP5.1, R4.1
unnamed: POWER.C, R6.2
PWM_DATA: SV1.4
SCHALTAUSGANG: U1.3 (O.S.)
SPI_MISO: SV1.8
SPI_MOSI: SV1.7
SPI_SCK: SV1.10
SYSCLOCK_O: SV1.9

Notes on the sheet:
Term.
nach www.horter.de
Adressen
JP 3 2 1
Off
144d
146d
148d
150d
152d
154d
156d
158d
created by Markus Musielak
Lizenz
(CC 3.0) creative commons 3.0

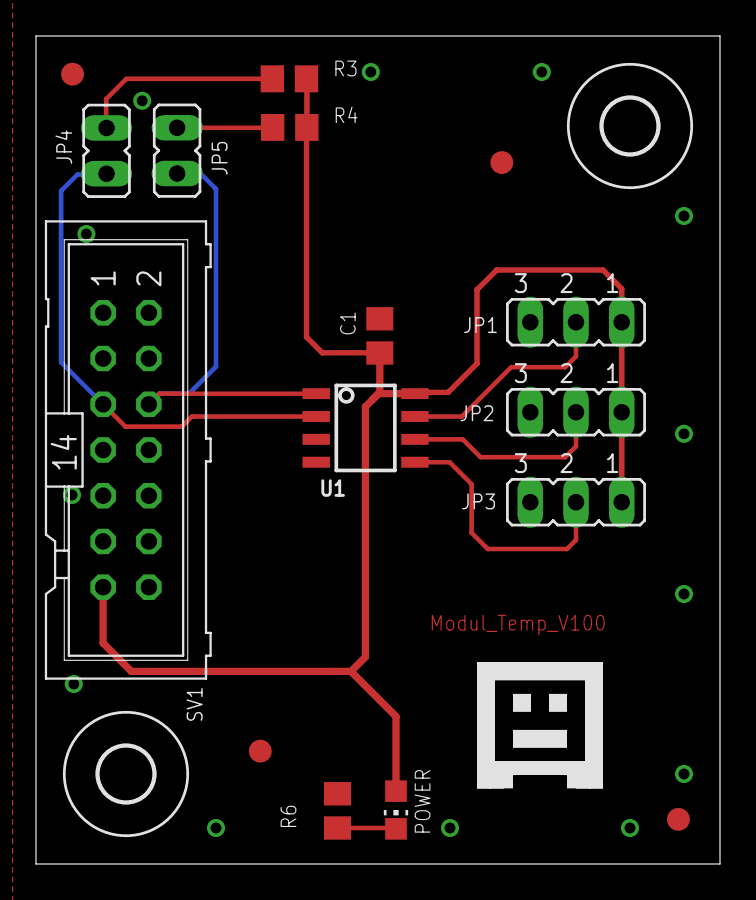
[picture p97: board MODUL_TEMPERATURE_V100.brd from above]

Board: 2 copper layers, 38.0 x 46.0 mm, 19 parts (0 on the bottom side), 10 nets.
