embeddedprojects/gnublin-schematics/Module-Step/MODUL_STEP_V100.brd

## EAGLE design Module-Step/MODUL_STEP_V100.brd (2013-05-04)

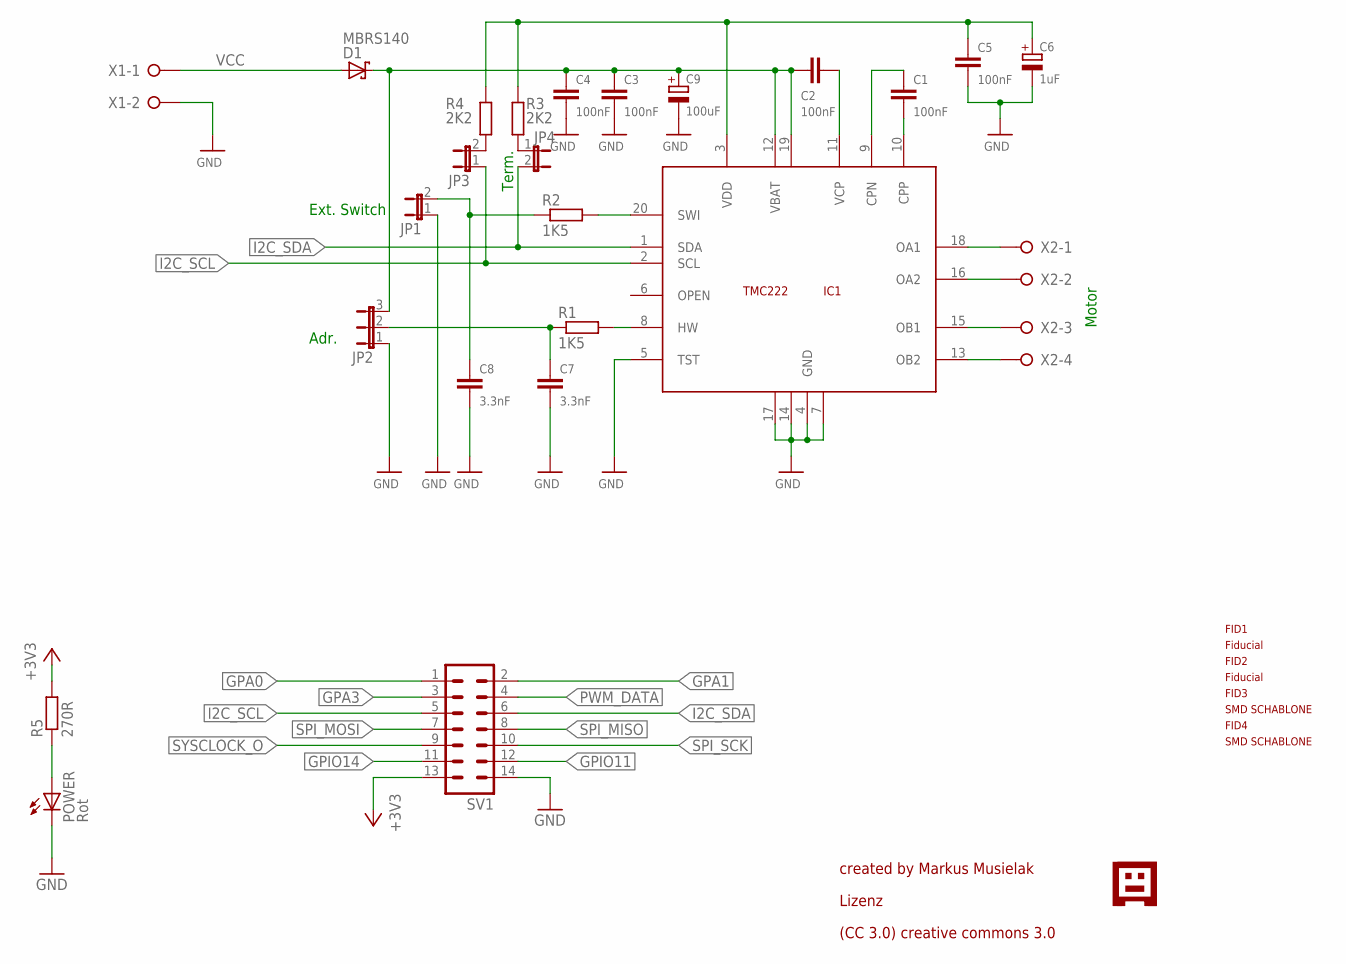
[picture p98: schematic MODUL_STEP_V100.sch]

Parts:
C1, C2, C3, C4, C5: 100nF; C0805
C6: 1uF; B/3528-21R
C7, C8: 3.3nF; C0805
C9: 100uF; E5-10,5
D1: MBRS140; SMB
FID1, FID2, FID3, FID4: PASSERMARKEN_FIDUCIAL
IC1: TMC222; SOIC20; FARNELL 1214195
JP1, JP3, JP4: JP1E; JP1
JP2: JP2E; JP2
POWER: Rot; CHIP-LED0805
R1, R2: 1K5; R0805
R3, R4: 2K2; R0805
R5: 270R; R0805
SV1: ML14
U$1: GNUBLINLOGOSIEB; GNUSIEBDRUCK
X1: W237-02P; W237-132
X2: W237-04P; W237-4P

Connections:
+3V3: R5.2, SV1.13
GND: C3.2, C4.2, C5.2, C6.-, C7.2, C8.2, C9.-, IC1.4 (GND), IC1.5 (TST), IC1.7 (GND2), IC1.14 (GND3), IC1.17 (GND4), JP1.1, JP2.1, POWER.C, SV1.14, X1.2
GPA0: SV1.1
GPA1: SV1.2
GPA3: SV1.3
GPIO11: SV1.12
GPIO14: SV1.11
I2C_SCL: IC1.2 (SCL), JP3.1, SV1.5
I2C_SDA: IC1.1 (SDA), JP4.2, SV1.6
unnamed: POWER.A, R5.1
unnamed: C1.1, IC1.9 (CPN)
unnamed: C1.2, IC1.10 (CPP)
unnamed: C2.2, IC1.11 (VCP)
unnamed: C2.1, C3.1, C4.1, C9.+, D1.C, IC1.12 (VBAT), IC1.19 (VBAT2), JP2.3
unnamed: IC1.8 (HW), R1.2
unnamed: C7.1, JP2.2, R1.1
unnamed: C8.1, JP1.2, R2.1
unnamed: IC1.20 (SWI), R2.2
unnamed: IC1.13 (OB2), X2.4
unnamed: IC1.15 (OB1), X2.3
unnamed: IC1.16 (OA2), X2.2
unnamed: IC1.18 (OA1), X2.1
unnamed: JP3.2, R4.1
unnamed: JP4.1, R3.1
unnamed: C5.1, C6.+, IC1.3 (VDD), R3.2, R4.2
PWM_DATA: SV1.4
SPI_MISO: SV1.8
SPI_MOSI: SV1.7
SPI_SCK: SV1.10
SYSCLOCK_O: SV1.9
VCC: D1.A, X1.1

Notes on the sheet:
created by Markus Musielak
Adr.
Ext. Switch
Term.
Motor
Lizenz
(CC 3.0) creative commons 3.0

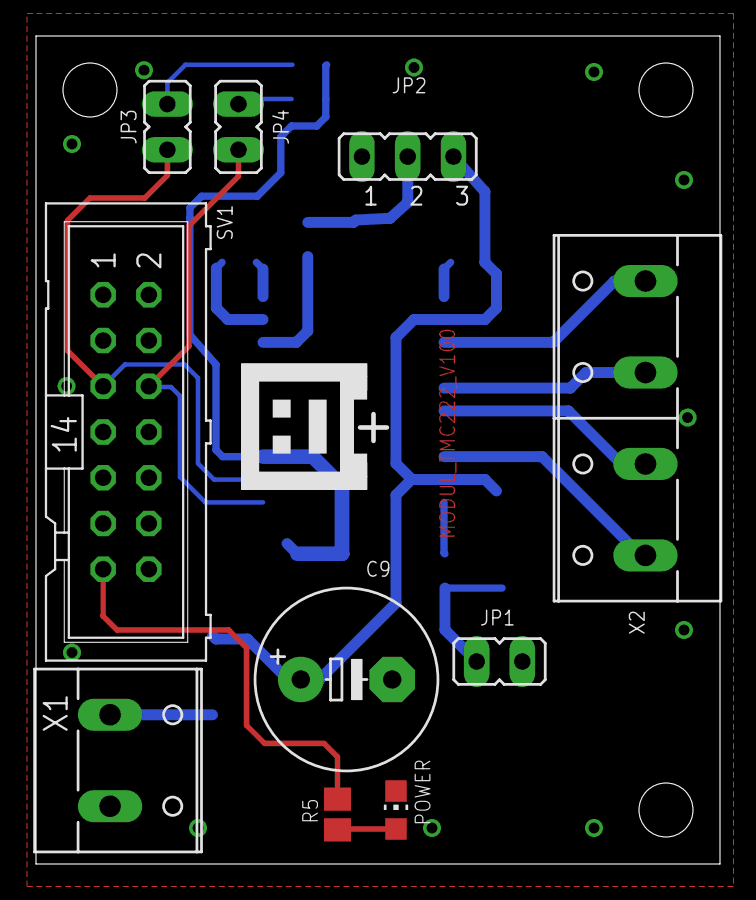
[picture p99: board MODUL_STEP_V100.brd from above]

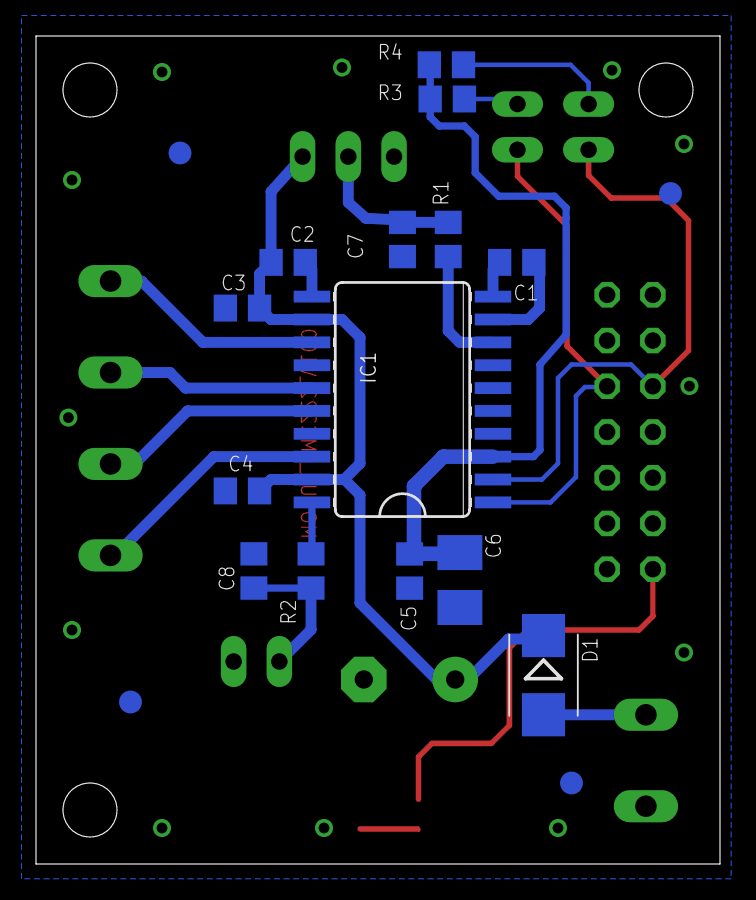
[picture p100: board MODUL_STEP_V100.brd from below]

Board: 2 copper layers, 38.0 x 46.0 mm, 29 parts (18 on the bottom side), 21 nets.
