embeddedprojects/gnublin-schematics/Module-LAN/MODUL_LAN_V102.brd

## EAGLE design Module-LAN/MODUL_LAN_V102.brd (2013-05-04)

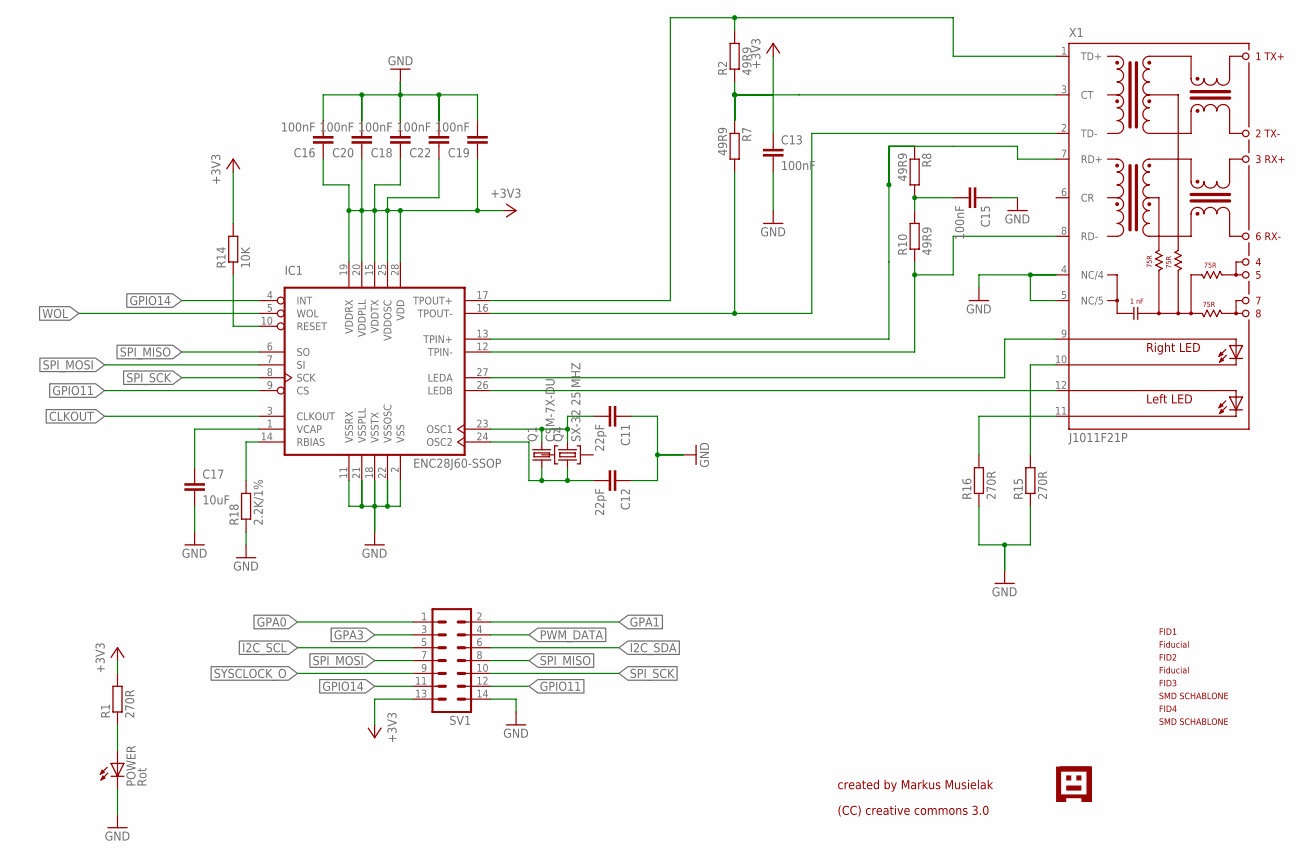
[picture p101: schematic MODUL_LAN_V102.sch]

Parts:
C11, C12: 22pF; C0805
C13, C15, C16, C18, C19, C20, C22: 100nF; C0805
C17: 10uF; C0805
FID1, FID2, FID3, FID4: PASSERMARKEN_FIDUCIAL
IC1: ENC28J60-SSOP; SSOP28; FARNELL 1084620
POWER: Rot; CHIP-LED0805
Q1: CSM-7X-DU
Q4: SX-32 25 MHZ; SX-32; FARNELL 1712841
R1, R15, R16: 270R; R0805
R2, R7, R8, R10: 49R9; R0805
R14: 10K; R0805
R18: 2.2K/1%; R0805
SV1: ML14
U$2: GNUBLINLOGOSIEB; GNUSIEBDRUCK
X1: J1011F21P; J1

Connections:
+3V3: C13.1, C16.1, C18.1, C19.1, C20.1, C22.1, IC1.15 (VDDTX), IC1.19 (VDDRX), IC1.20 (VDDPLL), IC1.25 (VDDOSC), IC1.28 (VDD), R1.2, R2.1, R7.1, R14.2, SV1.13, X1.3 (CT)
CLKOUT: IC1.3 (CLKOUT)
GND: C11.1, C12.1, C13.2, C15.1, C16.2, C17.2, C18.2, C19.2, C20.2, C22.2, IC1.2 (VSS), IC1.11 (VSSRX), IC1.18 (VSSTX), IC1.21 (VSSPLL), IC1.22 (VSSOSC), POWER.C, R15.1, R16.1, R18.1, SV1.14, X1.4 (NC/4), X1.5 (NC/5)
GPA0: SV1.1
GPA1: SV1.2
GPA3: SV1.3
GPIO11: IC1.9 (CS), SV1.12
GPIO14: IC1.4 (INT), SV1.11
I2C_SCL: SV1.5
I2C_SDA: SV1.6
LINKACT: R15.2, X1.10 (C-R)
unnamed: C15.2, R8.2, R10.2
unnamed: POWER.A, R1.1
unnamed: IC1.10 (RESET), R14.1
unnamed: C17.1, IC1.1 (VCAP)
unnamed: IC1.27 (LEDA), X1.9 (A-R)
unnamed: IC1.26 (LEDB), X1.12 (AL)
unnamed: IC1.14 (RBIAS), R18.2
PWM_DATA: SV1.4
RX+: IC1.13 (TPIN+), R8.1, X1.7 (RD+)
RX-: IC1.12 (TPIN-), R10.1, X1.8 (RD-)
SPEED: R16.2, X1.11 (C-L)
SPI_MISO: IC1.6 (SO), SV1.8
SPI_MOSI: IC1.7 (SI), SV1.7
SPI_SCK: IC1.8 (SCK), SV1.10
SYSCLOCK_O: SV1.9
TX+: IC1.17 (TPOUT+), R2.2, X1.1 (TD+)
TX-: IC1.16 (TPOUT-), R7.2, X1.2 (TD-)
WOL: IC1.5 (WOL)
XT1: C12.2, IC1.24 (OSC2), Q1.1, Q4.1
XT2: C11.2, IC1.23 (OSC1), Q1.2, Q4.3 (2)

Notes on the sheet:
created by Markus Musielak
(CC) creative commons 3.0

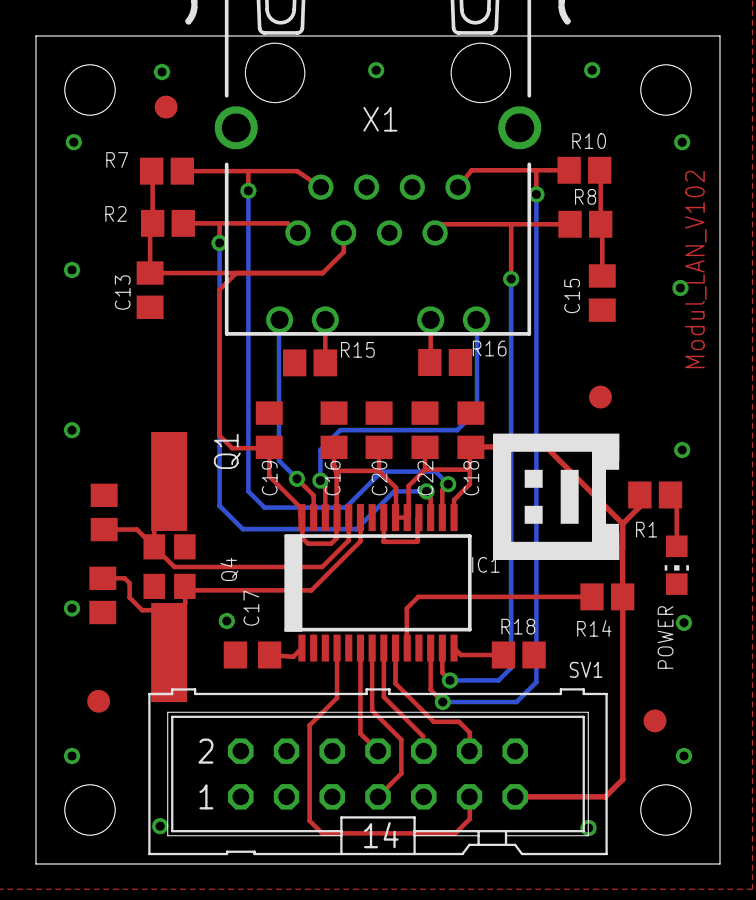
[picture p102: board MODUL_LAN_V102.brd from above]

Board: 2 copper layers, 38.0 x 46.0 mm, 30 parts (0 on the bottom side), 22 nets.
