embeddedprojects/gnublin-schematics/(commit log)

2013-04-24 added MODUL_RASP-PI_BRIDGE_V100
    [MODUL_RASP-PI_BRIDGE_V100.brd, MODUL_RASP-PI_BRIDGE_V100.sch]
2013-05-04 add many boards
    [MODUL_ADC_V101.brd, MODUL_ADC_V101.sch, MODUL_CAN_V100.brd, MODUL_CAN_V100.sch, MODUL_LAN_V102.brd, MODUL_LAN_V102.sch, MODUL_PORTEXP_V101.brd, MODUL_PORTEXP_V101.sch]
2013-05-15 added pdf files
    [ElektorLinuxBoard_V3.01.sch, GNUBLIN_1_6.sch, GNUBLIN_EXTENDED_V1_7.sch, GNUBLIN_LAN_V2.3.sch, MODUL_CAN_V100.sch, MODUL_GNU-PI_BRIDGE_V100.sch, MODUL_GNU-PI_BRIDGE_V1001.sch, MODUL_LAN_V102.sch]
2013-06-11 add Module RAIL INPUT 24V
    [MODUL_RAIL_IN_V100.brd, MODUL_RAIL_IN_V100.sch]
2013-06-11 add Board-DEFAULT files
2013-06-11 add Board-DIP
2013-06-13 add Bridge, Extension, LCD
    [MODUL_BRIDGE_V100.brd, MODUL_BRIDGE_V100.sch, MODUL_LCD_V100.brd, MODUL_LCD_V100.sch, Module-Extension_V101.brd, Module-Extension_V101.sch]
2013-08-23 add GnuBo
    [MODUL_GNU-BO_BRIDGE_V101.brd, MODUL_GNU-BO_BRIDGE_V101.sch]
2014-03-18 add schematic RS232
    [MODUL_RS232_V101.brd, MODUL_RS232_V101.sch]
2014-04-08 Add DIN-Rail In
    [DIN-Rail-In_V103.brd, DIN-Rail-In_V103.sch]
2014-04-14 GNUBLIN DIP EASY
    [GNUBLIN-DIP-EASY_V100.brd, GNUBLIN-DIP-EASY_V100.sch]
